lhr-solar/BPS/Docs/source/Hardware/battery-compartment.rst

Battery compartment
===================

There are 31 modules connected in series, with eight modules a row for three rows and seven modules in the fourth row.

.. note::
    Battery modules are removed if judges determine that the compartment is heavier than regulations allow.
