lhr-solar/BPS/Docs/source/index.rst

.. BPS documentation master file, created by
   sphinx-quickstart on Sat Aug 29 16:24:06 2020.
   You can adapt this file completely to your liking, but it should at least
   contain the root `toctree` directive.

****************************************
Welcome to the BeVolt BPS documentation!
****************************************

.. include:: introduction.rst

.. toctree::
   :hidden:
   :maxdepth: 2
   :caption: Overview

   Overview/useful-software
   Overview/design-requirements
   Overview/design-overview
   Overview/software-overview

.. toctree::
   :hidden:
   :maxdepth: 2
   :caption: Software

   Software/BSP
   Software/Drivers
   Software/RTOS
   Software/Apps
   Software/Tasks

.. toctree::
   :hidden:
   :maxdepth: 2
   :caption: Hardware

   Hardware/Boards
   Hardware/Components
   Hardware/battery-compartment.rst

.. toctree::
   :hidden:
   :maxdepth: 2
   :caption: Simulator

   Simulator/Overview.rst

.. toctree::
   :hidden:
   :maxdepth: 2
   :caption: How To

   How_To/Onboarding
   How_To/coding-style.rst

.. toctree::
   :hidden:
   :maxdepth: 1
   :caption: Terms and Definitions
   
   glossary
   abbreviations
