lhr-solar/BPS/Docs/source/_static/battery-box-xsection.png

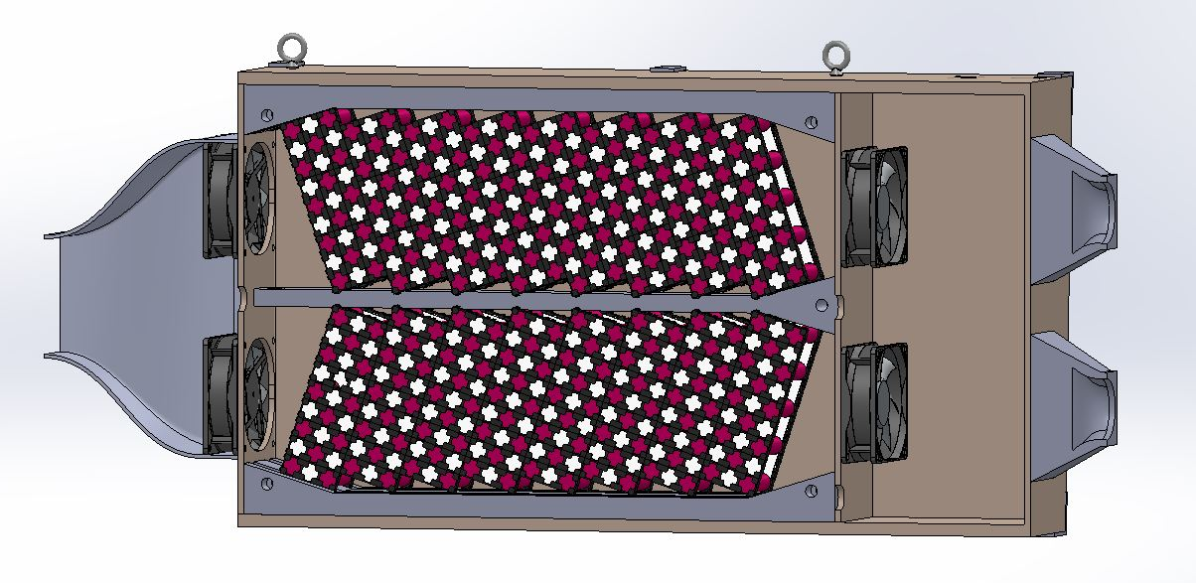
Docs/source/_static/battery-box-xsection.png
