lhr-solar/BPS/(threads)

Thread 47 (2020-05-01):

# ADC

JimothyGreene, 2020-05-01:
Create ADC data that will be read by the BPS to calculate the Current provided by the battery.

Closed 2020-05-01.

Thread 55 (2020-05-01):

SPI Simulation

JimothyGreene, 2020-05-01:
Simulate SPI communication to provide Voltage and Temperature readings that would be provided by the LTC6811s

Closed 2020-07-01.

Thread 57 (2020-05-01):

WDTimer Simulation

JimothyGreene, 2020-05-01:
Simulate the Watchdog Timer that ensures the BPS is running properly without getting stuck

Closed 2020-06-30.

Thread 74 (2020-06-05):

Voltage_GetModulesInDanger not specific in why they're in danger

SijWoo, 2020-06-05:
<del>The Voltage_GetModulesInDanger function only checks for modules whose voltages are either too high or low. There is a possibility where the voltages could be nominal but an open wire on one of the module nodes could have made the BPS trip and if we rely on this function to find the reason why the BPS tripped, then we may not be able to find it easily.

<del>TODO: Make the function check if the reason for the module in danger is an open wire.</del>

**IGNORE THIS!! DID NOT SEE OPEN WIRE CHECK!!**

SijWoo, 2020-06-05:
Also instead of returning the pointer to an array that only holds either SAFE or DANGER as the values, have it so the array holds more specific values. Specifically, if a module is in danger because of an OVERVOLTAGE, then make the index hold OVERVOLTAGE instead of just DANGER. Same goes for any UNDERVOLTAGE or OPENWIRE

Closed 2020-07-02.

Thread 75 (2020-06-05):

Voltage_UpdateMeasurements should copy voltage values instead of referencing c_codes in cell_asic struct

SijWoo, 2020-06-05:
With the way the LTC6811 handles openwire checks, the cells.c_codes[ ] array in the cell_asic will get overwritten and will hold voltage data that are not actually correct. So if we do
```
Voltage_UpdateMeasurements()
if(Voltage_OpenWire()) {
}
if(Voltage_CheckStatus()) {
}
```
The OpenWire function will have overwritten what the Voltage_UpdateMeasurements function has received from the LTC6811. The Voltage_UpdateMeasurements function stores all the voltage data into the minions[ ].cells.c_codes[ ] array. The Voltage_CheckStatus function uses the values in that array whenever checking for anything dangerous. The Voltage_OpenWire function stores Pull-Up and Pull-Down voltage values into minions[ ].cells.c_codes[ ] which may or may not be the actual voltage values of the battery module (Look in ADOW section of LTC6811 datasheet for more info). This could be a problem whenever the BPS trips and we check the voltage values.

**TODO:** In Voltage_UpdateMeasurements, copy the voltage values in a private array in Voltage.c after new values are received and have Voltage_CheckStatus and Voltage_GetModuleMilliVoltage use that private array instead of cells.c_codes[ ]

Closed 2020-07-04.

Thread 76 (2020-06-05):

Voltage OpenWire functions should reference system_open_wire field in cell_asic struct

SijWoo, 2020-06-05:
The Voltage functions that handles checking open wires are using the return value of the LTC6811_run_openwire_multi function. The return value is not scalable and could overflow thus missing certain open wired pins. There are problems when having multiple minion boards daisy chained as using the LTC6811_run_openwire_multi function. Errors arise in Voltage_GetModulesInDanger because of that ltc function. There is a system_open_wire field which uses a bitmap where each index corresponds to a pin and a 1 in that index will indicate that there is an open wire. The OpenWire functions should be modified to use the system_open_wire field in the cell_asic minions struct instead of the return value of the LTC6811 function.

**TODO:** Make the Voltage OpenWire functions reference system_open_wire field when checking for open wires.
_Note:_ Use the Voltage test if you are testing it.

SijWoo, 2020-06-09:
Start on this after simulator_spi_bsp has been merged

ClarkPoon, 2020-07-09:
@SijWoo was this fixed by the **Voltage Library cell_asic fix** pull request?

SijWoo, 2020-07-11:
This has not been fixed yet. The **Voltage Library cell_asic fix** branch was fixed a different issue.

Closed 2020-10-17.

Thread 78 (2020-06-06):

Change SoC.c/h (State of Charge) to Charge.c/h to prevent confusion.

SijWoo, 2020-06-06:
SoC has another meaning which is System on Chip which is a more common term. Changing the src file names and function names to Charge will make this less confusing.

**TODO:** Change names from SoC to Charge

chaseblock, 2020-06-09:
Thanks for making the issue. This has been bugging me for a while.

Closed 2020-07-26.

Thread 79 (2020-06-06):

Fans Simulation

ClarkPoon, 2020-06-06:
Simulate the drivers for the fans that cool the battery. Would be nice (reach goal) if this affects temperature readings as well.

Closed 2020-09-19.

Thread 83 (2020-06-09):

Simulator: Locking files during read and writes

SijWoo, 2020-06-09:
The BSP src code and the simulator python modules need to lock the file that they are accessing or else errors will occur. Make sure to add the following in your codes:

Python File Accesses:
```python
import fcntl
import os
```

```python
os.makedirs(os.path.dirname(file), exist_ok=True)
    with open(file, 'r') as csvfile:
        fcntl.flock(csvfile.fileno(), fcntl.LOCK_EX)    # Lock file before writing
        # Do stuff
        fcntl.flock(csvfile.fileno(), fcntl.LOCK_UN)    # Unlock file after writing
```

BSP C File Accesses:
```C
#include <sys/file.h>
```

```C
// Open File and get file descriptor
FILE* fp = fopen(file, "r");
if(!fp) {
    // Exit, error!
    perror("SPI.csv");
    exit(EXIT_FAILURE);
}

// Lock the file so simulator.py/SPI.py can not write it during a read op
// This is a blocking statement
int fno = fileno(fp);
flock(fno, LOCK_EX);

// File reading stuff

// Unlock the lock so the simulator can write to SPI.csv again
flock(fno, LOCK_UN);

// Close file.
fclose(fp);
```

**TODO:** Make sure all file accesses have locks

SijWoo, 2020-06-09:
BSP_ADC ne

chaseblock, 2020-06-27:
What needs to be done in order to close this issue?

SijWoo, 2020-06-27:
All python scripts and C src files that are currently finished in the simulator branch should have locks. The ADC related src files need to have locks and a couple other. Let’s close this issue whenever every BSP src files and python scripts that are currently in the simulator branch have locks then make sure every future pull request have locks.

Closed 2020-07-04.

Thread 84 (2020-06-09):

BSP_ADC GetMilliVoltage functions should exit if fopen error occurs

SijWoo, 2020-06-09:
In BSP_ADC_High_GetMilliVoltage and BSP_ADC_Low_GetMilliVoltage, the fopen function is called and the fp variable is checked to see if it is not NULL. If the fp variable is NULL, then there is a printf statement followed by a return statement. Instead of doing this, the conditional statement should exit the program with a failure status like the following:
```C
    // Open File and get file descriptor
    FILE* fp = fopen(file, "r");
    if(!fp) {
        // Exit, error!
        perror("ADC.csv");
        exit(EXIT_FAILURE);
    }
```

**TODO:** Fix the two GetMilliVoltage functions to exit whenever there is an error

Closed 2022-04-17.

Thread 106 (2020-07-03):

Stop WDTimer.csv from crashing the simulator when the WDTimer is not being used

ClarkPoon, 2020-07-03:
If the Watchdog timer .csv file does not exist (BSP_WDTimer_Init() has not been called), then the watchdog functions crash the simulator because WDTimer.csv cannot be found by the WDTimer Python scripts.

Closed 2020-07-04.

Thread 110 (2020-07-04):

CAN Messages will be dropped if not handled quickly.

chaseblock, 2020-07-04:
As it stands right now, I believe that if CAN messages are not handled promptly (meaning that the main program loop handles asks the BSP for the message), the BSP will simply drop the messages, as it only stores the most recent message at any point.

The relevant code from BSP:
```c
uint8_t BSP_CAN_Read(uint32_t *id, uint8_t *data) {
    if(RxFlag){
		for(int i = 0; i < 8; i++){
			data[i] = RxMessage.Data[i];
		}
        *id = RxMessage.StdId;
		RxFlag = false;
		return 1;
	}
    return 0;
}

void CAN1_RX0_IRQHandler(void)
{
    CAN_Receive(CAN1, CAN_FIFO0, &RxMessage);

    if ((RxMessage.StdId == 0x001)&&(RxMessage.IDE == CAN_ID_STD) && (RxMessage.DLC == 1)){
        // TODO: do stuff
        RxFlag = true;
    }
}
```

As you can see, when the mesage arrives, it is put into the `RxMessage` variable, which is only acessed when `BSP_CAN_Read` is called. This means that if multiple message arrive between calls to `BSP_CAN_Read`, the older one will be dropped, without the application knowing anything about it.

Although the BPS does not currently listen to the CAN bus for any messages, this is an issue that could affect potential future additions and/or forks of this code that are used in other code bases that the team may maintain (like Controls, Telemetry, CAN Sniffer, etc.).

chaseblock, 2020-07-04:
From the datasheet for our mcu:

> Two receive FIFOs are used by hardware to store the incoming messages. Three complete
messages can be stored in each FIFO. The FIFOs are managed completely by hardware.

If we feel certain that we can handle the incoming CAN messages before three stack up, then the interrupt here is unnecessary. Otherwise, I think that all that needs to be done is to create a software FIFO (with more capacity than the HW FIFO) and use the ISR to move the messages to that FIFO when they come in.

Closed 2020-12-12.

Thread 113 (2020-07-18):

STM32F413: Update BSP_LED GPIO pins for new leader board vX.Y

SijWoo, 2020-07-18:
To make the board look cleaner, I moved around some GPIO pins that controls the LED. (In case anyone is wondering, the low speed communication lines such as UART, I2C, SPI have not been changed). The updated pin mapping of the leader board is in the [google sheet](https://docs.google.com/spreadsheets/d/1CHXOJur96z3ZEMzSynHYqkd0Sx3a4DRUVOYeTzj7Trg/edit?usp=sharing).

The new LED pin assignments are as followed:
PC0 : Other
PC1 : CANError
PC2 : WDError
PC3 : (Open) Wire
PC4 : RUN

PA4 : OCurr
PA5 : OTemp
PA6 : OVolt
PA7 : UVolt

Do not branch off the simulator branch for this. I'll create a note whenever the leader board layout is done and merged to the Electronics repo in case you need to reference it.

chaseblock, 2020-07-18:
Can we maintain this and a separate build target for a v2 board? I imagine that we will be testing code on the old master for at least a little while.

SijWoo, 2020-07-18:
Ah that would be good, so have separate folders like BSP/STM32f413v2 and BSP/STM32F413v3 or with some type of version number naming scheme?

chaseblock, 2020-07-18:
Nah that sounds pretty ugly. I was thinking just a file that has variables/definitions that are guarded by preprocessor #ifs.

Something like:
```c
// Some .h file somewhere
#ifdef BPS_V2
// etc.
#define CANError_LED_PIN ...
#define WDError_LED_PIN ...
// etc.
#else
// etc.
#define CANError_LED_PIN PC1
#define WDError_LED_PIN PC2
// etc.
#endif
```

Then just select the build target in the Makefile by passing in `-DBPS_V2` or `-DBPS_V3` to gcc when compiling.

I'm not sure what sort of variables would need to be switched, so the feasibility of this may vary, but it sounds more maintainable than separate BSP folders (since the BSPs are likely going to be similar to each other).

SijWoo, 2020-07-18:
Okay yea that sounds better. I can edit the Makefile to have a version parameter. I'll open a separate issue ticket for the Makefile.

SijWoo, 2020-08-01:
Will put this on hold for now. Look at issue [#114](https://github.com/lhr-solar/BPS/issues/114) for more information

Closed 2020-12-12.

Thread 114 (2020-07-18):

Update Makefile to have version parameter

SijWoo, 2020-07-18:
There are multiple versions of the BPS boards with different pin connections. The Makefile needs to be updated to accept a version parameter so src files for different board versions can be compiled.

The Makefile will accept a version number as a parameter, a variable will be defined for GCC to select the preprocessor definitions for the certain board, then the code will be compiled.

Src code example:
```c
// Some .h file somewhere
#ifdef BPS_V2
// etc.
#define CANError_LED_PIN ...
#define WDError_LED_PIN ...
// etc.
#else
// etc.
#define CANError_LED_PIN PC1
#define WDError_LED_PIN PC2
// etc.
#endif
```

SijWoo, 2020-07-30:
I just realized since we're using a different current board with different I/O interfaces, how should we change the Current (Amperes) library to support different versions (ADC and AS8510)? The new current sensing board is using the AS8510 which requires the SPI protocol so the Current library will be using the AS8510 driver whenever it gets created. Should we have the current library have a bunch of #if statements to support the previous and newest leader board versions or should we just have the code updated to only support the new version and just deprecate the previous versions?

I think having a bunch of #if statements in the Current library will create clutter quickly and we need to change the Current library function definitions completely when we update the code to use the AS8510. I think we should deprecate the previous version of the bps but have it available **ONLY** for testing certain modules that remains unchanged (e.g. Voltage, Temperature, Contactor, CAN, USB, EEPROM). LEDs and Strobe Light are the only pins that have been changed on the new board. We'll have at least two boards (before making multiple copies) to test the critical functionalities.

To save the BPS code that uses the hall effects sensors + ADC, we can create a tag called v2.0 like what we did for v1.0.

Any thoughts are welcome :)
@ClarkPoon @chaseblock @sugamarora99 @manthanand @alekxoo @AleNeff @etblum12

SijWoo, 2020-08-01:
After discussing with BPS team, we decided to add the makefile version parameter after adding the AS8510 driver and editing the amperes library. The main concern that I had with the makefile version paremeter was that the amperes library will be different between the new and previous leader boards. As long as we don't test code that is meant on the new leader board i.e. the fan, amperes board, bluetooth on the previous version, then we'll be fine for now.

ClarkPoon, 2021-02-10:
To my knowledge, we no longer have any functional copies of old versions of the BPS leader board (@chaseblock took a DC-DC converter off of the board from Spring 2020 to use on the telemetry board), so I no longer see the point of adding support for legacy hardware.

Closed 2021-02-10.

Thread 117 (2020-07-23):

Possible issue with the SoC function

chaseblock, 2020-07-23:
The SoC_Calculate function is using an int16_t for its parameter, which is described in a comment to be in units of 0.0001 Amps (one ten-thousandth).

Quick math suggest that the maximum of this signed type is 2<sup>16 - 1</sup> * 0.0001 = 3.2768.

It seems that we are only able to account for a current of <3.27A.

chaseblock, 2020-07-23:
It also appears that the units being passed into the function from main.c (directly from the Current.c getter) is mA, not 0.1 mA like this SoC file suggests.

I assume mA is the intended unit here, but could I get some confirmation?

Closed 2020-07-26.

Thread 121 (2020-07-27):

Control-C not working properly on simulator

ClarkPoon, 2020-07-27:
When I run the simulator on my machine and press Control-C, then type quit, the simulator freezes instead of quitting. When Alejandro runs the simulator on his machine and he presses Control-C, the simulator immediately quits (without opening the quit menu). I was unable to replicate Alejandro's issue. Not sure if these issues are related, but they were both first noticed today after the pull requests for changing SoC to Charge and for Contactor Simulation were merged into the simulator branch.

ClarkPoon, 2020-07-27:
After looking into this further, it appears that Alejandro is no longer having this issue on his machine. The issue on my machine appears to be caused by the Timer thread not ending when the "quit" option is selected if the C code is not using the timers

chaseblock, 2020-07-27:
On my machine (Pop!_OS 20.04), I seem to get the expected results (no issue with quitting).

ClarkPoon, 2020-07-27:
> On my machine (Pop!_OS 20.04), I seem to get the expected results (no issue with quitting).

Can you try running after building with
```
make simulator TEST=BSP_I2C
```
I am not encountering this issue when I build with
```
make simulator
```

chaseblock, 2020-07-27:
Yes that seems to do it. I can confirm that issue.

Closed 2020-07-28.

Thread 122 (2020-07-27):

Simulator gives different Control-C menus, depending on "if BeVolt is not None"

ClarkPoon, 2020-07-27:
When you launch the simulator and type "start", a battery object called BeVolt is created (not set to None). If you type something else, BeVolt is set to None, and you are asked "Would you like to simulate 'charging' or 'discharging'?" and "Would you like to simulate 'low', 'normal', or 'high' values?". When you press Control-C to open the Keyboard Interrupt menu, you are given different options, depending on "if BeVolt is not None" as shown below.

```
except KeyboardInterrupt:
            curses.endwin()
            if BeVolt is not None:
                print("\n\rWould you like to change 'wires', 'quit', or 'PLL'?")
                print(">>", end="")
                choice = input()
                if choice == 'wires':
                    change_wires(BeVolt)
                    stdscr = curses.initscr()
                    curses.start_color()
                elif choice == 'quit':
                    break
                elif choice == 'PLL':
                    print("Enter the frequency you would like to change the clock to in Hz.")
                    frequency = int(input())
                    PLL.Change_Frequency(frequency)
                else:
                    print("That is not a valid option. Continuing simulation...")
                    stdscr = curses.initscr()
                    curses.start_color()
            else:
                print("\n\rWould you like to change 'config', 'quit', or send a CAN message ('CAN')?")
```

It does not make sense that having the options "'wires', 'quit', or 'PLL'" or having "'config', 'quit', or 'CAN'" depend on whether or not you are simulating using a battery object or not.

The reason that the simulator checks "if BeVolt is not None" is because the change_wires() method requires a battery object that is not none as a parameter.

```
def change_wires(battery):
    done = False
    while not done:
        print("Which module? (0 to exit)")
        print(">>", end="")
        module = int(input())
        if module:
            battery.modules[module-1].connected = not battery.modules[module-1].connected
        else:
            done = True
```

A solution to this issue will either:
* Give the user all of the options in the menu, regardless of whether or not the simulator is using a battery object or
* Give the user all of the options in the menu, except you will not have the "wires" option if you are not simulating usuing a battery object

Closed 2020-08-16.

Thread 128 (2020-07-30):

Current library to Amperes library?

SijWoo, 2020-07-30:
Even though this has been what we've been using for the past couple years, every time I say current board/library with other members I feel compelled to specify Current means amperes and not time. Current members know current means amps and not time in the context of the BPS but for future members, it may be good to change the library name to prevent any confusion.

**Proposal:** Change Current library and Current board names to Amperes library and Amperes board

SijWoo, 2020-07-30:
Any thoughts are welcome :)
@ClarkPoon @chaseblock @sugamarora99 @manthanand @alekxoo @AleNeff @etblum12

ClarkPoon, 2020-07-30:
I think this is a good idea

chaseblock, 2020-08-02:
I'm not too much of a fan of this move, but I understand the difficulty with the current "current" term, and as long as this improves clarity, I don't mind.

Closed 2020-12-14.

Thread 129 (2020-07-30):

Strobe Light Drivers

ClarkPoon, 2020-07-30:
There are currently no drivers to control the strobe light on the real board.

ClarkPoon, 2020-08-16:
The strobe light control is on the same pin as the fault light control, so the strobe light can be controlled by the lights drivers.

Closed 2020-08-16.

Thread 138 (2020-08-26):

Document Error Lights/Strobe Lights Indicator

ClarkPoon, 2020-08-26:
This section (2.2) of the BPS documentation is currently blank

Closed 2021-01-24.

Thread 141 (2020-08-26):

Create list of good manufacturers to order boards from (2.7)

ClarkPoon, 2020-08-26:

ClarkPoon, 2021-05-29:
I am closing this issue because I think this is beyond the scope of the BPS docs, since the BPS team has not been involved in ordering boards since 2019

Closed 2021-05-29.

Thread 167 (2020-08-26):

Update Amperes Library to use SPI

ClarkPoon, 2020-08-26:
The new version of the amperes board uses SPI to send information to the leader board (instead of an analog voltage)

Closed 2020-12-14.

Thread 168 (2020-08-29):

Updating standard peripheral library to low-layer API

SijWoo, 2020-08-29:
STM released a library called Low-Layer(LL) API after the standard peripheral library(SPL). They're both similar in syntax, but STM has been supporting LL and deprecated the SPL. **Would this be something that you all would want to do?** I don't know if you all can allocate more members to this or not but wanted to let you all know! If you do want to do this, I can send the library src folder to you.

Just as a note, LL is different from STM's High Abstraction Layer(HAL) library which has some overhead. There may not be a lot overhead in HAL, but there are some register level stuff we need that HAL can't provide easily.

chaseblock, 2020-08-29:
There's an overview of HAL and LL here: https://www.st.com/content/ccc/resource/technical/document/user_manual/2f/77/25/0f/5c/38/48/80/DM00122015.pdf/files/DM00122015.pdf/jcr:content/translations/en.DM0012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

From what I can tell, LL does not provide a CAN API. Since this is somewhat critical to our operation, I could see this being an issue. We could write our own drivers at the register level instead, but that seems like a non-trivial project.

SijWoo, 2020-08-29:
Yea that would be an issue. I did not see that, thanks for catching that Chase. We're able to have a hybrid of HAL's CAN API and LL on a project with no conflicts. The UART and SPI peripherals are the ones where we need to be close to the registers level (for the BPS with RTOS at least). What do you all think about this option?

JimothyGreene, 2020-08-29:
Why exactly do we need to be close to register level with those peripherals? Not sure I fully understand this. Haven't been dealing this low level recently.

SijWoo, 2020-08-29:
We need those peripherals on interrupts for the RTOS to block/unblock tasks. Peripheral data transfers are blocking functions, so the OS can schedule a different task to run if the original task is waiting on a peripheral transfer to be completed. In order to unblock a task though, we need an indicator for when a transfer is complete. The interrupt handler can be triggered whenever a transfer is complete and inside the handler we can call a semaphore to unblock the task.
E.g. for the BPS, we have one task for voltage/temperature monitoring and the other task is for amperes monitoring (volt/temp task priority higher than amperes task priority). While the LTC driver is doing an SPI data transfer in the volt/temp task, the amperes monitoring task can running. Whenever the SPI transfer is complete, the SPI interrupt handler will unblock the volt/temp task. The OS will then schedule the volt/temp task to run now.

```
OS_SEM SPI_Sem4;

void VoltTempTask(void) {
    while(1) {
        Voltage_UpdateMeasurements();   // Blocking statement because LTC driver calls SPI1_Transfer
        // Do stuff

        Temperature_UpdateMeasurements();   // Blocking statement because LTC driver calls SPI1_Transfer
        // Do more stuff
    }
}

void AmperesTask(void) {
    while(1) {
        Amperes_UpdateMeasurements();
        // Do stuff
    }
}

void SPI1_Transfer(uint8_t data[], uint32_t len) {
    for(int32_t i = 0; i < len; i++) {
        OSSemWait(&SPI_Sem4);
        SPI1_DATA_R = data[i];
    }
}

void SPI1_IRQHandler(void) {
    // Ack tx complete
    OSSemPend(&SPI_Sem4);
}
```

SijWoo, 2020-08-29:
Just to note, that code is an example and not actually in the BPS XD

JimothyGreene, 2020-08-29:
I think using the mixed HAL and LL option would be good.

ClarkPoon, 2021-02-10:
I think this would be a lot of work, and not worth the effort, since our BSP already works (for the most part)

Closed 2021-02-10.

Thread 188 (2020-08-31):

[RTOS] Add SPI Mutex to prevent any tasks from accessing the periperal at the same time

SijWoo, 2020-08-31:
Please go to google drive in BPS>Documentation/Reports>BPS RTOS for more information and pseudo code.

ClarkPoon, 2020-11-12:
@SijWoo do we need this mutex? Shouldn't SPI1 only be accessed by whoever has the LTC6811 mutex, and SPI3 should only be accessed by the amperes task?

Closed 2020-11-14.

Thread 192 (2020-08-31):

[RTOS] General: Make sure all functions are thread-safe

SijWoo, 2020-08-31:
More specific issue tickets should/will be created but as a note, we need to make sure all the functions are thread safe (at least the ones that are shared among multiple tasks).

chaseblock, 2021-03-20:
This issue has been standing for a long time, and I'm of the opinion that it needs some modification due to decisions made over the past few months. Not every function needs to be 'thread-safe'. Instead, perhaps we should take the stance that only certain functions need to be thread safe, and that each function should be marked as either `[reentrant](https://en.wikipedia.org/wiki/Reentrancy_(computing))`, `[thread-safe](https://en.wikipedia.org/wiki/Thread-safety)`, or `unsafe`. This could be specified plainly in the documenting comment for the function.

For quick description:
- A thread-safe function is something that can be called from multiple threads at the same time, and can be called at the same time as other thread-safe functions in the same module.
- A reentrant function is one that (for our purposes) would be safe to call from multiple threads, as well as from interrupts.
- An unsafe function (again, for our purposes) is neither of the above.

The hope is that going through all of the functions and labeling them as one of these categories would make it clear whether we have race-conditions, potential deadlocks, etc. We would need to go through and ensure all of our driver and BSP functions are categorized appropriately.

Looking for criticism here. Let me know what y'all think.

@ClarkPoon @JimothyGreene

ClarkPoon, 2021-03-20:
> This issue has been standing for a long time, and I'm of the opinion that it needs some modification due to decisions made over the past few months. Not every function needs to be 'thread-safe'. Instead, perhaps we should take the stance that only certain functions need to be thread safe, and that each function should be marked as either [reentrant](https://en.wikipedia.org/wiki/Reentrancy_(computing)), [thread-safe](https://en.wikipedia.org/wiki/Thread-safety), or `unsafe`. This could be specified plainly in the documenting comment for the function.

I think it makes sense that only some functions need to be reentrant or thread-safe, and I have not enforced a requirement for thread-safety if a function is only used by a single thread. I also agree that it would be a good idea to document which functions are thread-safe or reentrant, so we don't forget and accidentally call unsafe functions from different threads concurrently, etc.

> The hope is that going through all of the functions and labeling them as one of these categories would make it clear whether we have race-conditions, potential deadlocks, etc. We would need to go through and ensure all of our driver and BSP functions are categorized appropriately.

If we are using this to look through the code for race-conditions and deadlocks, do you think it would be helpful if we modified the function names to make it obvious if they are reentrant/thread-safe? Maybe add an `_r` to the end for reentrant like in `strtok_r()`?

chaseblock, 2021-03-20:
Maybe. It certainly would make it easier to determine whether a function being called be an ISR is acceptable. On the other hand, we still may want to document thread-safety aside from reentrancy, which would either require another (non-standard) suffix, or a comment anyways.

Thread 198 (2020-09-12):

[RTOS] Design startup sequence for admin/normal operation

SijWoo, 2020-09-12:
After the BPS faults due to low voltage, the next boot will automatically trip the system (opening the contactor). If we have a computer plugged in, during startup we should forcefully close the contactor so we can charge the battery to a point where it won't trip.

In the original loop during before anything is checked, there is a start up period that waits for an input from the keyboard to place the system in admin level to forcefully turn on the contactor. In this new rtos implementation, we have the ability to spawn and kill threads as we like. In the main loop instead of spawning all the necessary tasks, we should implement a state machine that spawns all threads for normal operation and spawn certain/different threads for admin operation.

ClarkPoon, 2020-09-19:
@SijWoo @alekxoo I think it would make sense to do this as part of the initialization task because that is where we do this in the non-RTOS version of the BPS. What do you think?

SijWoo, 2020-09-19:
That makes sense to me! Also I don't think I included this anywhere but we need to also check if the watchdog timer triggered previosuly

ClarkPoon, 2020-11-12:
After looking at this some more, I think it might make more sense to put this in the critical state thread than in the initialization thread because the critical state thread is what decides to turn on the contactor. I think it makes more sense for the initialization thread to only initialize the fault state sem4, critical state sem4, all of the other threads, and nothing else. What do you think @SijWoo

Closed 2020-12-19.

Thread 206 (2020-09-25):

Add Separate Voltage Cutoffs for Charging and Discharging

ClarkPoon, 2020-09-25:
Right now, we only check for undervoltage in discharging mode. I think it would be safer if we also checked for undervoltage in charging mode, but use a lower threshold (that is still above the minimum volatge specified by the manufacturer). This way, we do not end up recharging batteries that have internal copper deposits/shorts.

Closed 2020-11-16.

Thread 207 (2020-09-26):

Look into recharging rates

chaseblock, 2020-09-26:
Potentially more related to MPPT, so tagging @dimembermatt on this. I think it is certainly reliant on BPS complicity though.

As a part of our recent discussions about proper management of the battery pack, it has come up that there exists proper charging procedure for these batteries, or at least there would exist a proper charging procedure if we had a dedicated, stable charger. Since we instead have an array, it may still be beneficial to look into how we should manage the charging of the batteries based on their existing voltage, charge, temperature, etc.

This is a part of the BMS functionality, and probably doesn't need to be addressed until after basic balancing (and related functionality) has been implemented and tested.

dimembermatt, 2020-09-26:
Updates on what the requirements should be?
I see potential to add functionality to the DC-DC converter algorithm to limit output based on battery voltage to prevent overcharging. Do I also get permission to read BPS CAN messages (I assume there are) for temperature probe data on the batteries? Or do I get a separate message to tell me to throttle charging output to X value and the BPS calculates how far I need to throttle to lower the temperature?

dimembermatt, 2020-09-27:
As a placeholder, I've implemented the following interface for the MPPT to regulate input power to the battery. Let me know if this changes. Closing [#19](https://github.com/lhr-solar/MPPT/issues/19).

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

Rationale for the implementation details is presented from the excerpt from the MPPT design document:
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

I'll check with Prof hallock to see if the physics for this checks out.

dimembermatt, 2020-10-21:
bump.

ClarkPoon, 2020-11-18:
I think we discussed this in a meeting over Zoom or Discord, but I am commenting here, so we have a record.

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

My understanding is that the MPPTs know the total voltage of the battery pack, so the MPPTs should be able to handle the charge protocol without needing to receive any messages from the BPS, since the BPS will be balancing the module voltages. I think the purpose of the charging protocol is only to increase battery cycle life, so I am not sure if we would want to sacrifice power for this during the race. We might want to look into it for when we are charging before the race, but again, I don't think we care a lot about cycle life, since we are only planning on using this battery pack in one race.

> Updates on what the requirements should be?
> I see potential to add functionality to the DC-DC converter algorithm to limit output based on battery voltage to prevent overcharging. Do I also get permission to read BPS CAN messages (I assume there are) for temperature probe data on the batteries? Or do I get a separate message to tell me to throttle charging output to X value and the BPS calculates how far I need to throttle to lower the temperature?

I am guessing Array will need to know the BPS's shutoff voltage limits, current limits, and (optionally) the ideal charging protocol for the battery. I am not sure yet if you will need to know the BPS's temperature readings or temperature shutoff. I am hoping that the battery box will be designed in such a way that the BPS can keep the batteries cool enough, even when we are receiving maximum power from the array.

Right now, the relevant BPS shutoff limits are:
Total pack Voltage (charging): 83.7 V to 124 V *
Total pack Voltage (discharging): 89.8 V to 124 V *
Max charging current: 20 Amps
Max discharging current: 100 Amps
Max temperature (charging): 40 C **
Max temperature (discharging): 55 C **
* Since we are monitoring Voltage on the module level, in practice, we may shutoff up to 1.5 V before we reach these limits.
** These temperature values will almost certainly be increased

@dimembermatt @chaseblock What are your thoughts on this?

dimembermatt, 2020-11-28:
I can probably work with just the voltage and current charge/discharge limits for now:

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

I'll have to read up on charging algorithms and/or protocols, otherwise it'll be a pretty primitive "I try to pump as much power given my constraints as possible all the time' for now in the DC-DC converter firmware.

Closed 2022-04-26.

Thread 211 (2020-09-26):

Voltage library cell_asic address change in call stack

SijWoo, 2020-09-26:
Release main.c simulator has very strange and incorrect behavior but Test_Voltage.c is able to run perfectly fine. The address of the cell_asic struct changes through the function call stack when main.c runs but stays constant when Test_Voltage.c runs. The BSP_SPI and python scripts run fine.

If you add print statements starting in Voltage_UpdateMeasurements down to the parse_cells function in LTC681x.c and print out the address of the c_codes input parameter, they should all stay constant. Look at this commit id for what was printed in Voltage.c, LTC6811.c, LTC681x.c: 82613e0a2cbb3ef06c6a6a8c212749c100529387

The correct behavior is for all the address printed should be the same. main.c does not have this behavior.

Closed 2020-11-07.

Thread 213 (2020-09-26):

RTOS stack above BSP

SijWoo, 2020-09-26:
To make the Board Support Package support both bare metal and a RTOS, the team decided to make the BSP code RTOS independent. Each BSP src file that requires an OS shall take a `bsp_os_t` type input parameter in the Init function. This struct contains function pointers that are defined at an upper layer. If there is no OS, then the struct should be filled with dummy empty functions that does nothing.

Here is an example of the SPI peripheral using OS functions:
```
// BSP_OS.h
typedef struct {
    void (*pend)(void);
    void (*post)(void);
} bsp_os_t;
```

```
// LTC6811.c
bsp_os_t spi_os;
OS_SEM MinionsIO_Sem4;
void LTC6811_Pend(void) {
    CPU_TS ts;
    OS_ERR err;
    OSSemPend(&MinionsIO_Sem4,
                        0,
                        OS_OPT_PEND_BLOCKING,
                        &ts,
                        &err);
}

void LTC6811_Post(void) {
    OS_ERR err;
    OSSemPost(&MinionsIO_Sem4,
                        OS_OPT_POST_1,
                        &err);
}

void LTC6811_Init(void) {
    spi_os.pend = LTC6811_Pend;
    spi_os.post = LTC6811_Post;
    BSP_SPI_Init(&spi_os);
}
```

```
// BSP_SPI.c
static bsp_os_t *os;
void BSP_SPI_Init(bsp_os_t *spi_os) {
    os = spi_os;
}

void BSP_SPI_Write(uint8_t txBuf, uint32_t txLen) {
    for(int32_t i = 0; i < txLen; i++) {
        SPI1->DR = txBuf[i];
        os->pend();
    }
}

void SPI3_IRQHandler(void) {
    // Acknowledge transfer complete
    os->post();
}
```

SijWoo, 2020-09-26:
@JimothyGreene may be useful(?)

Closed 2021-02-10.

Thread 248 (2020-11-18):

Make sure Bluetooth meets regulations

ClarkPoon, 2020-11-18:
The regulations require that we seal the battery box during the race. This also includes a requirement that we cannot alter firmware or settings once the battery box has been sealed. However, the current BPS design plans to make the CLI accessible over Bluetooth. We need to either:
- Verify that we cannot use the CLI to modify any firmware or settings
- Limit the user interface we expose over Bluetooth, so it cannot be used to alter firmware or settings

ClarkPoon, 2020-12-19:
Per Steve's email, sealing the battery box is to prevent changing out cells during the race. Communication is fine as long as it does not affect firmware or settings

Closed 2020-12-19.

Thread 259 (2020-11-23):

Create function to call if the RTOS fails

ClarkPoon, 2020-11-23:
Right now, if an os function returns an error, we are posting the fault state semaphore to go into a fault condition. This could be an issue if whatever causes the os function to fail causes the scheduler to not properly schedule the fault state task to run. One way to fix this would be to write a fault function that does the entire shutdown sequence and call it from the `assertOSError()` function. We can also call this function whenever we enter a fault state through the fault state thread, or if we reach the hard fault handler.

Closed 2021-01-03.

Thread 264 (2020-12-12):

Sort out interrupt priorities

ClarkPoon, 2020-12-12:
Right now UART3 has the highest priority, which is not what we want. Also, some of our interrupts have not yet been assigned priorities (NVIC is not initialized for SPI or I2C)

Closed 2021-02-27.

Thread 267 (2020-12-13):

Add calls to Charge functions to the Amperes task

ClarkPoon, 2020-12-13:
The BPS is responsible for keeping track of the state of charge of the battery, so we need to add calls to the functions that do this to the code. I think the amperes task is the best place to do this because it is where we are measuring the current, which we use to keep track of the state of charge

Closed 2021-02-13.

Thread 268 (2020-12-14):

BPS in unknown state after programming

chaseblock, 2020-12-14:
After programming the BPS leader board, the peripherals on the STM32F413 are not reset upon the software reset. This means, for instance, that if the BPS had the contactor enabled and is then flashed with a program that does not interface with the contactor (a test program perhaps), then the contactor will remain enabled. This also has potential effects for when the WDOG timer resets the chip (although this has not been tested yet).

The question is this: Is there a way to guarantee that after flashing or soft-resetting the board, all the peripherals are set to known and safe states?

chaseblock, 2020-12-14:
I should note that pressing the reset button on the board completely resets all peripherals.

ClarkPoon, 2020-12-16:
Can't we just solve this by:
1. On startup, (in fault state or critical state threads) call `BSP_Contactor_Off()`
2. In our standard operating procedures, require that the BPS is always reset after flashing new code

Closed 2022-04-17.

Thread 281 (2021-01-16):

Determine Timing Requirements for Battery Balancing

sugamarora99, 2021-01-16:
We need to figure out how often we will be battery balancing the battery pack.

ClarkPoon, 2021-01-30:
We need to figure out an optimal balancing strategy and how often we should update our strategy @javierpadila2001

Some information about battery balancing:
https://www.americansolarchallenge.org/regulations/solar-car-design-reference-material/

Closed 2021-03-06.

Thread 306 (2021-01-24):

Send charging suggestion over CAN

ClarkPoon, 2021-01-24:
Whenever the highest temperature in the battery pack is between 45 Celsius and 60 Celsius, it is safe to discharge the battery but not to charge the battery. Whenever the highest temperature measured in the battery pack gets close to this range, the BPS should send a CAN message to suggest to the other systems that they should not charge the battery, or the BPS may shut down the car.

Closed 2021-02-10.

Thread 309 (2021-01-30):

Remove ADC functions

manthanand, 2021-01-30:
We do not want to remove the BSP_ADC header file since we might need that functionality later on in the BPS. However, we do not need those functions now since we are not using our old hall-effect current sensors. They should be removed anywhere they are being used.

ClarkPoon, 2021-02-13:
We are not using these anywhere on the rtos branch

Closed 2021-02-13.

Thread 312 (2021-01-30):

Check if watchdog timer was tripped on startup

ClarkPoon, 2021-01-30:
If the watchdog timer counts down to zero, it will reset the BPS. We need to check on startup if this has happened, and if so, we need to enter a fault state.

Closed 2021-02-13.

Thread 358 (2021-06-03):

Create BPS Debugging guide

ClarkPoon, 2021-06-03:
While testing the BPS during the spring semester, @chaseblock and I decided it would be nice to have a list of common debugging issues

Thread 374 (2021-06-17):

Clean up hardware docs

ClarkPoon, 2021-06-17:
I think the hardware docs (specifically the boards section) are formatted in a way that is hard to follow. I think this is because the information for each board takes up significantly more than can fit on your screen, so I find it easy to lose track of which board I am looking at the information for. There is also a lot of repetitive information (eg. explaining why we use a chip for each board it appears on, instead of just having a single explanation for each chip). Some of the section headings also seem to be unhelpful (eg. "main"). One idea I have would be to create a separate page for each board. Another idea would be to mix the pictures and text together more (right now there are some areas where several pictures have just been pasted in consecutively with short captions, like at the end of the "layout" section of the display board). I am interested to see what other people think about the hardware docs (especially if they have to use the hardware docs for learning about the hardware), so please post replies to this issue if you have additional suggestions/feedback.

Closed 2023-03-03.

Thread 375 (2021-06-19):

Determine Proper method for converting AS8510 reading to milliamps

ClarkPoon, 2021-06-19:
Right now, the `AS8510_GetCurrent()` returns an `int16_t`, which `Amps_UpdateMeasurements()` treats as a milliamp value. This is a problem because the largest number that can be represented by an `int16_t` is 32,767, which corresponds to 32.767 amps in the existing code. However, the BPS shutoff limit is 75 amps. This means that the BPS will never shut off for an over current. I am hoping that we are treating the readings from the AS8510 improperly, and there is some additional conversion we need to do to convert the 16 bits we get from the sensor into a milliamp value.

ClarkPoon, 2021-07-31:
#384 might solve this, but I am leaving this issue open until it is validated

ClarkPoon, 2021-12-04:
We aren't using the AS8510 anymore

Closed 2021-12-04.

Thread 378 (2021-06-26):

Test CAN Task

ClarkPoon, 2021-06-26:
We need to run the test in Tests/Test_CAN_Task.c to verify that the CAN task works. Any issues that we run into when testing the CAN task should have an issue ticket opened or a response posted here

chaseblock, 2021-07-19:
When running this test, the board hardfaults at `os_core.c:422` after 6 calls to CANbus_BlockAndSend.

Stack trace from the hardfault:

```
>>> backtrace
#0  HardFault_Handler () at ../../Apps/Src/Task_FaultState.c:112
#1  <signal handler called>
#2  0x3f800000 in ?? ()
#3  0x0800493c in OSSched () at ../../RTOS/uCOS-III-STM32F4/uCOS-III/Source/os_core.c:422
#4  0x40400000 in ?? ()
```

Registers at the start of HardFault_Handler:

```
r0             0x0                 0
r1             0x10000000          268435456
r2             0x2000187c          536877180
r3             0x3                 3
r4             0x0                 0
r5             0x200065a6          536896934
r6             0x5                 5
r7             0x0                 0
r8             0x8080808           134744072
r9             0x9090909           151587081
r10            0x10101010          269488144
r11            0x11111111          286331153
r12            0x0                 0
sp             0x200011e8          0x200011e8 <OSCfg_ISRStk+396>
lr             0xfffffffd          -3
pc             0x8007430           0x8007430 <HardFault_Handler>
xPSR           0x1000003           16777219
fpscr          0x0                 0
msp            0x200011e8          0x200011e8 <OSCfg_ISRStk+396>
psp            0x20006508          0x20006508 <TaskSpam_Stk+840>
primask        0x0                 0
basepri        0x0                 0
faultmask      0x0                 0
control        0x0                 0
```

My guess is that we're corrupting a stack somewhere, or failing initialization at some step. Just a guess though.

chaseblock, 2021-07-20:
I'm going insane. Changing the line below in Test_CAN_Task.c seems to have solved the hardfault issue.

```c
-            CanData.f = (float)voltage/1000; //send data in volts
+            CanMsg.payload.data.f = voltage/1000.0; //send data in volts
```

In particular, it appears to be the change from `(float)voltage/1000` to `voltage/1000.0` that solved it (regardless of the assignment, the first faults).

I don't like unexplained faults, and the fact that this was coming from the OSSched function just makes me not like it more. The only (partial) explanation I can think of is that uC/OS is fucking with the floating point registers somehow, and that the compiler does slightly different things with this computation than the other one. Still, I don't know why this in particular was causing the issue, especially since there shouldn't be a context switch across it.

If anyone has any thoughts, I'd love to hear them.

@ClarkPoon @SijWoo @JimothyGreene

chaseblock, 2021-07-20:
This is certainly an issue with floating point and how it is interacting with uC/OS. I'll open a new issue to investigate.

Closed 2021-08-29.

Thread 380 (2021-07-03):

Test Battery Balance Task

JimothyGreene, 2021-07-03:
We need to run the test in Tests/Test_BatteryBalancing_Task.c to verify that the Battery Balancing task works. Any issues that we run into when testing the Battery Balancing task should have an issue ticket opened or a response posted here

Thread 381 (2021-07-03):

Test Voltage App

ClarkPoon, 2021-07-03:
We need to run the test in Tests/Test_Voltage.c to verify that the Voltage App works. Any issues that we run into when testing the Voltage App should have an issue ticket opened or a response posted here

Closed 2021-11-20.

Thread 387 (2021-07-20):

CAN Queue Passing Incorrect

chaseblock, 2021-07-20:
Currently, the queue passing for the CAN messages is implemented incorrectly. We are making use of uC/OS III's OS-level queues for message passing. This is fine, except all these do is store pointers (not full elements). Any changes to the stack or local variables before consumption will result in incorrect behavior.

This needs to be corrected.

chaseblock, 2021-07-20:
@ClarkPoon @JimothyGreene

ClarkPoon, 2021-07-22:
Ok. I will get this fixed

Closed 2021-08-29.

Thread 388 (2021-07-20):

Floating Point Operations and uC/OS III Misbehaving

chaseblock, 2021-07-20:
Discovered while investigating #378.

Introducing floating point operations in certain places within the code seem to cause uC/OS to enter a hardfault somewhere around `OSSched()`.

For a reproduction case, see Test_Tasks.c on the RTOS branch. This executes fine. However, when Task2 is modified as below, it hardfaults as described. This behavior has also been seen in the CAN_Task test (see the linked issue). When Task1 is modified in a similar way, everything still appears to work.

The change:
```diff
diff --git a/Tests/Test_Tasks.c b/Tests/Test_Tasks.c
index 23f71b19..6864cbef 100644
--- a/Tests/Test_Tasks.c
+++ b/Tests/Test_Tasks.c
@@ -68,6 +68,10 @@ void Task2(void *p_arg) {
     OS_ERR err;

     while(1) {
+
+        volatile float f = 1.8;
+        f += 0.5;
+
         OSSemPost(&SafetyCheck_Sem4,
                     OS_OPT_POST_ALL,
                     &err);
```

For the hardfault debugging registers: see these dumps from GDB.
```gdb
>>> p/x *(uint32_t*)(0xE000ED28) # CFSR
$2 = 0x100
>>> p/x *(uint32_t*)(0xE000ED2C) # HFSR
$3 = 0x40000000
```

This puts us squarely in `IBUSERR` territory. I unfortunately haven't been able to find many reports of people experiencing these issues, and haven't been able to work around it so far.

@ClarkPoon  @JimothyGreene I'm wondering if anyone has any ideas on this. I'm going to keep experimenting.

@SijWoo have you ever seen anything like this?

chaseblock, 2021-07-20:
After consulting with some sources:

This is probably due to uC/OS not properly handling the floating point registers during a context switch, and losing track of where on the stack the PC is when it attempts to return from a context switch.

Our options as I see it are:
1. Don't use uC/OS. I think it may be a bit too late to choose this option.
2. Look into fixing up the context switch code within the RTOS to support floating point register saving. I don't know if I have the time for this right now. Maybe I'll look into it in a bit. If anyone else is willing to take a look into that though, let me know and I'll see if I can help.
3. Disable the floating point unit. I can confirm that with the floating point unit disabled, the hardfaults do not seem to be occurring. The downside to this is that we lose hardware support for floating point arithmetic, so all float math is going to be much slower (and implemented via larger amounts of library software). This is probably the easiest solution, but if we choose this, we will want to eliminate any unnecessary floating point math, probably converting most of it to fixed point (see [Q](https://en.wikipedia.org/wiki/Q_(number_format))).

@ClarkPoon @JimothyGreene I would like your opinions on these options within the next few days so that we aren't blocked by this for a long while.

@Cam0Cow @ErickCortez98 This possibly affects your system as well, although I haven't really looked yet. It might be good for y'all to take a look at any floating point math that y'all are doing and ask whether or not it needs to be floats.

ClarkPoon, 2021-07-22:
I looked through the BPS code, and it looks like we are mainly using floating point math for the following:
1. Our voltage and temperature safety thresholds are floats. I think these used to be fixed point (in millivolts/milli-Celsius), so it could be converted to fixed point.
2. Pretty much all of the measurements we are sending over CAN are floats (voltage, temperature, current). Using floats here is unavoidable unless we change our CAN requirements, which would affect array and sunlight, since they are reading these messages.
3. Converting voltages on the temperature probes to temperatures. This can probably be converted to integer math.
4. Calculating state of charge. This looks straightforward to convert to integer math.

Do you know how long it takes to execute a floating point division on the stm32f413 without the FPU? I am concerned about point 3 because we are expecting to send over 900 floating point values over CAN each second (10 x 31 voltages + 10 x 62 temperatures). This seems like it could be quite CPU intensive if each typecast + division takes a while. It might be worth it to consider a fourth option:

Remove as much floating point math as possible, but keep the FPU on and treat floating point operations as a critical section (eg. disable interrupts when we do them).

If we chose to leave the FPU enabled, we would have to make sure we have a handler set up to catch any faults caused by this issue

ClarkPoon, 2021-07-22:
From a BPS perspective, I think the best option would be to remove all floating point and change the CAN spec. What do you think @chaseblock @JimothyGreene @afnanmmir @dimembermatt

Closed 2021-08-28.

Thread 390 (2021-07-24):

Fix Charge.c

ClarkPoon, 2021-07-24:
In charge.c, we are calling EEPROM driver functions without initializing the EEPROM. This could cause a hard fault. We are also using a dummy value of 1 million for `MAX_CHARGE_AMP_HRS`. We should figure out the actual value for this if we want to have a reasonable estimate of our charge. Additionally, storing this as a percentage with resolution of 0.01% which may not give us the necessary precision, so we might want to use another unit (eg. milliamp hours) instead. We are also updating our charge by adding a `uint32_t` to it, so it is impossible for our software to show a decrease in charge

Closed 2021-12-20.

Thread 392 (2021-07-31):

Test AS8510 Driver

ClarkPoon, 2021-07-31:
We need to run the test in Tests/Test_AS8510.c to verify that the AS8510 Driver works. Any issues that we run into when testing this should have an issue ticket opened or a response posted here

ClarkPoon, 2021-10-30:
AS8510 has been removed from the design. The replacement chip and corresponding driver (ADS7042) have been added to the hardware, written, and tested

Closed 2021-10-30.

Thread 396 (2021-09-01):

Profile power consumption and implement low power modes

chaseblock, 2021-09-01:
Every Watt on this car counts. We would like to have a good idea of how much power all of our systems consume, as well as how much power we can reduce them to. Since the BPS is a (relatively speaking) mature system at this point, it would be good to know how much power it is consuming, as well as looking into lower-power modes that it could be put into.

From the STM32F413/23 datasheet:

> By default, the microcontroller is in Run mode after a system or a power-on reset. In Run mode the CPU is clocked by HCLK and the program code is executed. Several low-power modes are available to save power when the CPU does not need to be kept running, for example when waiting for an external event. It is up to the user to select the mode that gives the best compromise between low-power consumption, short startup time and available wakeup sources.
The devices feature four low-power modes:
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

In addition, it would be good to have some idea of how much power other chips in the system (the EEPROM, CAN chip, USB chip, LTC6820 chips, etc) are consuming, as well as whether we can do anything about that, either in software or with hardware modifications.

A note: I suspect that anything that takes advantage of low-power mode on the STM may need to interact with the operating system a fair bit to ensure no critical processes are being interrupted and to make sure that timing information (where needed) stays accurate.

Thread 397 (2021-09-01):

Create battery model for voltage drop when under load

ClarkPoon, 2021-09-01:
When batteries are supplying current, their voltage will drop. Since the BPS is protecting the battery from an under-voltage, it is possible that the motor could draw enough current to pull a battery with a voltage close to the under-voltage limit to below the limit without tripping for over-current. It would be nice if we had a model that could predict this voltage drop.

This would also be helpful for determining state of charge, since we could use the measured voltage, the measured current, and the model to estimate the open-circuit voltage, which can be used to estimate state of charge. I am guessing that we would have a more accurate estimate if we incorporate voltage and temperature measurements into our state of charge algorithm.

An example of a battery model to predict how current draw will affect voltage can be found here: https://www.researchgate.net/figure/2RC-circuit-battery-model_fig1_327310441

Thread 399 (2021-09-01):

Create automated testing system

ClarkPoon, 2021-09-01:
In large software projects, it is common to run automated regression tests on pull requests before they are merged into mainline. Currently, all we are doing is making sure the code builds and requiring an approving code review. It would be nice if we could run software tests on our pull request as well.

A few ideas on how we could do this are:
- Unit test any functions that can be reasonably unit tested in a Linux environment (possibly through GitHub actions)
- Create dummy test versions of the BSP and Drivers that return values from a test-case specific config file, so we can test the application layer's response in some scenarios (eg. trying to turn on the car while the battery is under-volted). This could possibly be done through GitHub actions.
- Create a hardware setup we can remote into that hooks up the the BPS and can flash it and manipulate it's inputs to run different test cases on the BPS. This would probably be quite involved and I am not sure it is a realistic option for us. For more information, see https://en.wikipedia.org/wiki/Hardware-in-the-loop_simulation

Ideally, this system should:
- Run automated tests on the BPS code whenever a pull request is opened
- Be easy to use to add new tests
- Send some sort of notification on whether or not the tests have passed or failed and/or block a pull request from merging if the tests fail

I expect that creating this system would be an extensive project, so other issue tickets for smaller parts of this project should be created when we begin development on this

Closed 2023-02-13.

Thread 402 (2021-10-02):

OS semaphore pend/post return value

manthanand, 2021-10-02:
The OS pend and post functions return the count value of the semaphore. In the case that a semaphore was pended multiple times, the post function must also post that many times in order to free the semaphore. The only way this can occur is if the pend and post functions return the value of the semaphore so we can check if they have been cleared when posting.
`typedef struct {
    void (*pend)(void);
    void (*post)(void);
} bsp_os_t;`

should be

`typedef struct {
    uint8_t (*pend)(void);
    uint8_t (*post)(void);
} bsp_os_t;`

manthanand, 2022-08-22:
This issue is covered by the RTOS wrapper issue #401

Thread 411 (2021-12-06):

Full System Test Plan

ClarkPoon, 2021-12-06:
We need a test plan for when we run full system tests on the BPS in late January before we integrate with the battery in early February. We should create these plans by the end of winter break, so we can hit the ground running once the spring semester starts.

Closed 2022-04-17.

Thread 416 (2021-12-18):

Fix up Voltage Open Wire checks

ClarkPoon, 2021-12-18:
Right now, the voltage open wire checks are commented out. This is because the checks slow the voltage and temperature task down by several seconds. This causes the watchdog to time out before the task can complete a single loop. It would be nice to have open wire checks working within our time constraints, but I don't think they are as safety critical as checking voltage and temperature because the voltage and temperature checks usually catch any open wires with a second or so (based on my experiments).

A few possible solutions are:
1. Optimize the open wire checks so they take less time.
2. Only check some wires on each iteration of the voltage and temperature task, and cycle through the wires over time. The goal of this is to reduce the time it takes for the task to run a single loop.
3. Make a new task for voltage open wire checks. I think this would be a pain because it would compete with the voltage and temperature task for control of the SPI1 bus.

One other problem with the open wire checks can be found here: https://github.com/lhr-solar/BPS/pull/407#discussion_r771759274

The issue is that the code assumes that the last minion board will measure 7 modules, which might not be true if we have to remove one of our modules during competition. There is a real possibility that the judges could require us to run on 30 modules, so **this needs to be part of any pull request that adds in the open wire checks.**

Thread 418 (2021-12-18):

OS Independent CAN support

ClarkPoon, 2021-12-18:
If we have an OS fault, the CAN Driver can become unusable. This prevents the BPS from sending CAN messages in a fault state caused by an OS fault. If we want to support sending CAN messages in an OS fault, we need an alternative "emergency" CAN implementation that does not rely on the OS. We can probably just repurpose our CAN implementation marked as `BAREMETAL`

ClarkPoon, 2021-12-18:
Opened because of this pull request comment: https://github.com/lhr-solar/BPS/pull/407#discussion_r771759995

Closed 2023-03-03.

Thread 425 (2022-01-02):

The original intent here was to have different charging cutoffs based on the highest temperature measured in the battery pack. If any cells are above `MAX_CHARGE_TEMPERATURE_LIMIT` (defined in `Config/Inc/config.h`), the BPS should not allow charging. I am realizing now that we are using this improperly, and this bug slipped by the original reviews and testing, so good catch. I will make a fix for this

ClarkPoon, 2022-01-02:
The original intent here was to have different charging cutoffs based on the highest temperature measured in the battery pack. If any cells are above `MAX_CHARGE_TEMPERATURE_LIMIT` (defined in `Config/Inc/config.h`), the BPS should not allow charging. I am realizing now that we are using this improperly, and this bug slipped by the original reviews and testing, so good catch. I will make a fix for this

_Originally posted by @ClarkPoon in https://github.com/lhr-solar/BPS/pull/271#discussion_r777265413_

Closed 2022-01-05.

Thread 430 (2022-01-06):

Review MinionsASIC_Mutex usage

ClarkPoon, 2022-01-06:
Sometimes we are posting the mutex, then immediately pending it again, which might not be the most efficient way to handle this. We are also not using it sometimes when we communicate with the minion boards. Right now, I think the mutex is being used to protect access to the minion boards' SPI bus and to the minions asic array. We may want to use two mutexes for this

See:
https://github.com/lhr-solar/BPS/pull/271/files#r776791544
and
https://github.com/lhr-solar/BPS/pull/271/files#r776792239

manthanand, 2022-01-23:
I think the MinionsIO_Sem4 is supposed to be used for SPI bus protection.

ClarkPoon, 2022-01-23:
> I think the MinionsIO_Sem4 is supposed to be used for SPI bus protection.

The MinionsIO_Sem4 is for notifying us when we receive an SPI interrupt. It does not protect the SPI bus from multiple tasks accessing it at the same time.

Thread 431 (2022-01-09):

Add Contactor Check Task

ClarkPoon, 2022-01-09:
Reg 8.6.C.2 requires the switch to illuminate the BPS Fault Dash Indicator, so we can't do this by just putting it on the high voltage line, since the BPS wouldn't be able to tell if the switch is pressed or not.

I think our plan was to put it in series with the BPS contactor power line, so it could cut off power to the car by forcing those contactors open. The BPS would have to then detect that the contactor has been forced open and enter a fault state if the BPS thinks the contactor should be closed, but it is open.

We need a task that will periodically run and check to see if the contactor state is open when the BPS is trying to close the contactor. If this is the case, the BPS should enter a fault state so it turns on the BPS fault indicators.

Closed 2022-01-16.

Thread 443 (2022-04-18):

These issues are migrated from TODO list on drive

manthanand, 2022-04-18:
*set up system to make sure dashboard doesn't turn on motor during charging
*Verify charging state setup, what is required to charge

ClarkPoon, 2022-04-26:
A temporary solution that we are using is to just tell the driver to not turn on the motor if the BPS recently tripped due to an under-voltage, but it would be nice to have the system actually notify the driver about this (eg. via the BPS display board).

We could also solve this by sending a message to controls that turning on the motor will fault the BPS, so they disable the motor, but this is not necessary (will just make it harder for the driver to accidentally/intentionally fault the BPS)

manthanand, 2023-02-13:
Closing this issue since we do not have a dashboard anymore.

Closed 2023-02-13.

Thread 449 (2022-04-30):

PID Loop for Fans

manthanand, 2022-04-30:
Create a PID Control Loop for changing the fan speeds based on the temperature of the battery pack.

Closed 2023-03-03.

Thread 450 (2022-05-01):

Change Battery Module Configurations

manthanand, 2022-05-01:
Right now, we assume that the last minion has the lowest number of modules (if any are the lowest). Because of this we do a lot of shitty math to make up for it. It would be better if we just defined how many modules each minion was connected to and changed our logic to accommodate that (in case the 3rd minion had the lowest number). The reason for this is because our connections are based on wiring distances in hardware.

Thread 454 (2022-05-05):

Create software filters App

manthanand, 2022-05-05:
While we like to assume our hardware is perfect. It sometimes isn't. It would be nice if we could have some efficient, memory cheap filter functions for all of our analog inputs and have this in the application layer. We already have an averaging filter for the Current sensing and a median filter for voltage and temperature. We should see if there is an improvement to be made or not.

manthanand, 2022-05-13:
We should also consider using the filter capabilities of the LTC6811 if they prove to be more stable than our filters.

Closed 2022-05-31.

Thread 459 (2022-05-18):

Faster Baud Rate

manthanand, 2022-05-18:
Try making USB UART capable of 921600 b/s so CLI task can run faster. This could make it easier to debug code so timing issues don't pop up when using slow printf functions.

Closed 2023-11-26.

Thread 461 (2022-05-28):

Improve Voltage Filtering

ClarkPoon, 2022-05-28:
Sometimes I can get the BPS to trip from over-voltage or under-voltage by repeatedly cycling the motor to drive full power forwards and then full regen brake repeatedly.

Closed 2022-05-31.

Thread 462 (2022-06-12):

Add support for detecting contactor welds.

ClarkPoon, 2022-06-12:
One common failure mode for a contactor is that it will weld itself shut. We can detect this in software by checking the aux lines when the contactors are supposed to be open. See https://github.com/lhr-solar/BPS-LeaderPCB/issues/6 for more info

Closed 2023-03-04.

Thread 463 (2022-06-12):

Add support for isolation detection

ClarkPoon, 2022-06-12:
Commercial BMSes will often have a system for measuring the isolation between the frame and the high voltage line. If the isolation falls below a certain threshold, this is a safety issue, and we should notify the driver and shut down the vehicle.

Thread 464 (2022-06-12):

Monitor module internal resistances

ClarkPoon, 2022-06-12:
You can compute the internal resistance of a module if you know the current passing through it and the open circuit voltage. If there is a sudden change in internal resistance, this can indicate that a spot weld has failed or a cell has gone bad (eg. internally shorted).

We should add monitoring for this

manthanand, 2023-02-13:
This can also be done by using AC impedance testing since some bad spot welds could occur while the car is moving, meaning we wouldn't be able to get open circuit voltage. However, reading AC impedance while a battery is charging/discharging has not been reliable according to many research papers. One way of doing this could be to read open circuit voltage and current at startup and see if resistance measurement changes over time.

Thread 465 (2022-06-12):

Add support for contactor power economization

ClarkPoon, 2022-06-12:
Contactors can often be held closed while powered off a PWM frequency instead of a constant voltage because it takes much less power to hold a contactor closed than to close a contactor. We should look into this as a power-saving measure.

Closed 2023-02-05.

Thread 466 (2022-06-12):

Add support for blown fuse detection

ClarkPoon, 2022-06-12:
When a fuse on a voltage tap is blown, the module with a positive terminal connected to the fuse will appear to have a lower voltage and the module with a negative terminal connected to the fuse will appear to have a higher voltage. This is because the module voltages are measured relative to each other and there will be a voltage drop across the fuse.

We should add support for automatically detecting this because a blown fuse can prevent us from reading a potentially unsafe condition.

manthanand, 2022-06-14:
Isn't that just an open wire test?

Thread 467 (2022-06-12):

Add redundant measurement systems for fault-tolerance

ClarkPoon, 2022-06-12:
If we add 2 different type of sensors for the same thing (eg. a hall effect sensor and a shunt for current or two different voltage probes per module) we can detect if there is a failure in one of our measurement systems. I have seen this in some othe BMSes that I have looked at (eg. [Prohelion BMS's](https://www.prohelion.com/wp-content/uploads/2021/08/PHLN67.011v1-BMS-Users-Manual.pdf) "trusted measurements").

Not sure if this is worth it for our use case, but it is probably worth looking into.

Thread 468 (2022-06-12):

Disable charging if state of charge is too high

ClarkPoon, 2022-06-12:
If the battery gets close to 100% SoC, the array or motor might try to charge the battery. We should update our logic for sending the charging enabled message to take this into account.

Closed 2022-10-05.

Thread 471 (2022-08-17):

Update BPS to new gdb version

manthanand, 2022-08-17:
The current BPS fails to compile with the newest version of GDB. I would like a new member to work on this so they can understand how to debug compiler issues and change the code to match the compiler without changing the logic of the code. Steps would be:
1. Try making the code and seeing what errors come up
2. If the error is not easily understandable, search it up and see how other people have circumvented it
3. When the error is fixed, try testing the code that was changed on the current hardware to make sure the logic is unchanged.

Closed 2022-10-05.

Thread 481 (2022-09-19):

New BPS Simulator

connorl309, 2022-09-19:
Since the current simulator is both broken and not well written, I propose that we create a new simulator. The BPS needs a way to be tested without having to physically assemble the boards before we know the software logic works correctly. We should be able to comprehensively dump BPS system information from the simulator if we encounter an error, and potentially offer routine info logging, i.e. which task is currently running, which mutexes/semaphores are currently in use, and timing information.

We need to be aware of a few things, namely
- the RTOS migration from Micrium to FreeRTOS
- interactions between the BPS code and the simulator
- how much information should we expose to the simulator and avoiding performance impacts while on the real boards

I think it's important that we are able to test the software besides seeing confirmation that it compiles.

Closed 2023-01-21.

Thread 504 (2022-11-05):

Charge Enable Message

manthanand, 2022-11-05:
Prevent Charge Enable message from being sent before Critical State Task is completed.

Thread 525 (2023-01-11):

Fix Watchdog in Fault State

manthanand, 2023-01-11:
If we do not pass the critical state, then the fault state breaks because it tries to reset the watchdog timer that wasn't initialized. But if we do pass the critical state and then fault, then we need to reset the watchdog timer. We should change it so that the BPS should only try and reset the watchdog timer if the timer has been initialized.

Closed 2023-01-12.

Thread 538 (2023-02-13):

Big Code Review

manthanand, 2023-02-13:
For deadlock prevention:
Bottom of page 7: https://pages.cs.wisc.edu/~remzi/OSTEP/threads-bugs.pdf
also: https://jenkov.com/tutorials/java-concurrency/deadlock-prevention.html
For not detecting when you're not using a mutex when you should:
You can read the code by hand (maybe give each shared resource a ticket and have some people read over the code and wherever it is used, make sure it is locked)
You can try implementing something like this (or find a newer approach. This paper is from 2005): https://www.cs.utexas.edu/~rossbach/cs380p/papers/yu05sosp-racetrack.pdf
You would probably implement this by adding some instrumentation to RTOS_BPS functions and by wrapping accesses to shared variables with a macro that adds some instrumentation. I can write an example if you want.
You can also try and see if you can find a framework for detecting race conditions that works with micrium (or pthreads for the simulator)

connorl309, 2023-02-18:
We might be able to use the timeout options for mutexes that Micrium allows, and in our wrappers/calls to assertOSError we can print some debugging info if we get a timeout error (i.e. there was a deadlock but the timeout prevented it from fully locking up)

Thread 540 (2023-02-15):

Makefile Print File with main function

manthanand, 2023-02-15:
When making code, we should print what file contains the main function. We have had issues with debugging where we find the wrong main function flashed onto a file. For example, if we run `make TEST=VoltTempMonitorTask`, then we would print `making Test_VoltTempMonitorTask.c`.

Closed 2023-02-18.

Thread 549 (2023-02-19):

Move delay_u and delay_m functions from LTC6811 library to PLL library.

manthanand, 2023-02-19:
It doesn't make sense for our driver library to have the delay functions within them. It makes more sense for them to be within our PLL BSP layer since that is what controls the timing of our clock.

Closed 2023-03-10.

Thread 556 (2023-02-20):

Make printf non-blocking

manthanand, 2023-02-20:
If we want to test but don't want to use printf, it would be much easier to just make it non-blcoking so the watchdog doesn't trip when the UART port is not used.

Thread 563 (2023-03-04):

Voltage Not working

manthanand, 2023-03-04:
The voltages arent updating after being read for the first time.

Closed 2023-04-16.

Thread 567 (2023-03-10):

Simulator does not error out

manthanand, 2023-03-10:
When simulator.c calls `exit(-1)`, the workflow does not recognize that as a fail because the python script that runs it does not error out. We should fix this (for example, if the wrong number of elements are in the voltage/temperature array, the code will pass all test cases even though they never ran).

manthanand, 2023-04-08:
How Issue was seen:
In Simulator.c, we used to call `exit(-1)` if the size of the Voltage/Temperature arrays did not match the number of voltage/temp sensors in `config.h`. However instead of failing the test, we would just move on to the next test.

Closed 2023-04-15.

Thread 568 (2023-03-10):

Change elements in Volt/Temp Arrays simulator

manthanand, 2023-03-10:
We shouldn't have to go through all the simulator data files and change the lengths of the voltage/temperature arrays every time we change `config.h`. We should have some functionality in simulator.c to change the length if it does not match, or have a script change all the lengths while still keeping the original fault.

ray4477, 2023-03-25:
this has already been done by Champers i think in the Simulator.c

manthanand, 2023-03-28:
This hasn't. There is a TODO in Simulator.c which explains the issue.

Thread 570 (2023-03-10):

Simulator Test Fail Behaviour

manthanand, 2023-03-10:
At the moment, when we fail a simulator test, we print out the entire file that was used. Instead we should print the file name.

Champers5000, 2023-03-25:
This is fine no?
The automated tests are randomly generated and there's no other way of seeing what the simulator failed on

Closed 2023-04-08.

Thread 573 (2023-03-12):

Get config.msgs to work better

manthanand, 2023-03-12:
If you run make, you will get this disgusting output with all the #pragmas being printed out as notes. Also some of the #defiens arent reduced to their numerical value (which is why its useful). We should make this work better.

connorl309, 2023-03-25:
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

Make will only print the macro for any defines, but any and all remaining errors are fully explained as usual. Pushing changes

connorl309, 2023-03-25:
(Separate defines are split with a /)

Closed 2023-04-10.

Thread 586 (2023-04-29):

simulator big broke 🤯🤯🤯🤯🤯💀💀💀

tiandahuang, 2023-04-29:
The simulator (c) is written in a way that requires an insane amount of memory to run -- it's slow too, and not very robust.
Currently, the simulator is experiencing some issue (on my laptop where theres limited RAM and CPU) where it stalls with no error, likely out of memory or too much file I/O.
Also, registering SIGINT makes the process very annoying to kill when it stalls.

A list of fixes that would be nice:

- Rewrite `simulator.c` to make file IO more robust (stop using syscalls, there are libraries for that!)
- Make `simulator.c` more robust to errors and stalls.
- `simulator.c` can use higher-level C FILE APIs (and other higher level standard library tools)
- Rewrite the python portion to use better python practices (e.g. `subprocess.Popen()` instead of `os.system()` and actual error handling)

dm me for questions and concerns
T's and G's

manthanand, 2023-09-25:
Are yall gonna switch to another simulator or just not use this one? You should delete it from the repo if you aren't gonna use it.
