lhr-solar/BPS/Electronics/BPS/Tester/BPSTester.kicad_pcb

## KiCad design Electronics/BPS/Tester/BPSTester.kicad_pcb (2019-02-03, last stored version)

Schematic: BPSTester.sch

Parts:
1K1, 1K2, 1K3, 1K4, 1K5, 1K6, 1K7, 1K8, 1K9, 1K10, 1K11, 1K12: POT; Potentiometer_Trimmer_Bourns_3296W
J1: Conn_01x13_Male; Molex_KK-6410-13_13x2.54mm_Straight
J2: Conn_01x02_Male; Molex_KK-6410-02_02x2.54mm_Straight
TP1, TP2, TP3, TP4, TP5, TP6, TP7, TP8, TP9, TP10, TP11, TP12, TP13: TestPoint; Test_Point_Keystone_5005-5009_Compact

Connections:
+BATT: 1K1.2, J1.12, J1.13, J2.2, TP2.1
GND: 1K12.3, J2.1, TP1.1
unnamed: 1K1.3, 1K2.2, J1.11, TP3.1
unnamed: 1K2.3, 1K3.2, J1.10, TP4.1
unnamed: 1K3.3, 1K4.2, J1.9, TP5.1
unnamed: 1K4.3, 1K5.2, J1.8, TP6.1
unnamed: 1K5.3, 1K6.2, J1.7, TP7.1
unnamed: 1K6.3, 1K7.2, J1.6, TP8.1
unnamed: 1K7.3, 1K8.2, J1.5, TP9.1
unnamed: 1K8.3, 1K9.2, J1.4, TP10.1
unnamed: 1K9.3, 1K10.2, J1.3, TP12.1
unnamed: 1K10.3, 1K11.2, J1.2, TP13.1
unnamed: 1K11.3, 1K12.2, J1.1, TP11.1

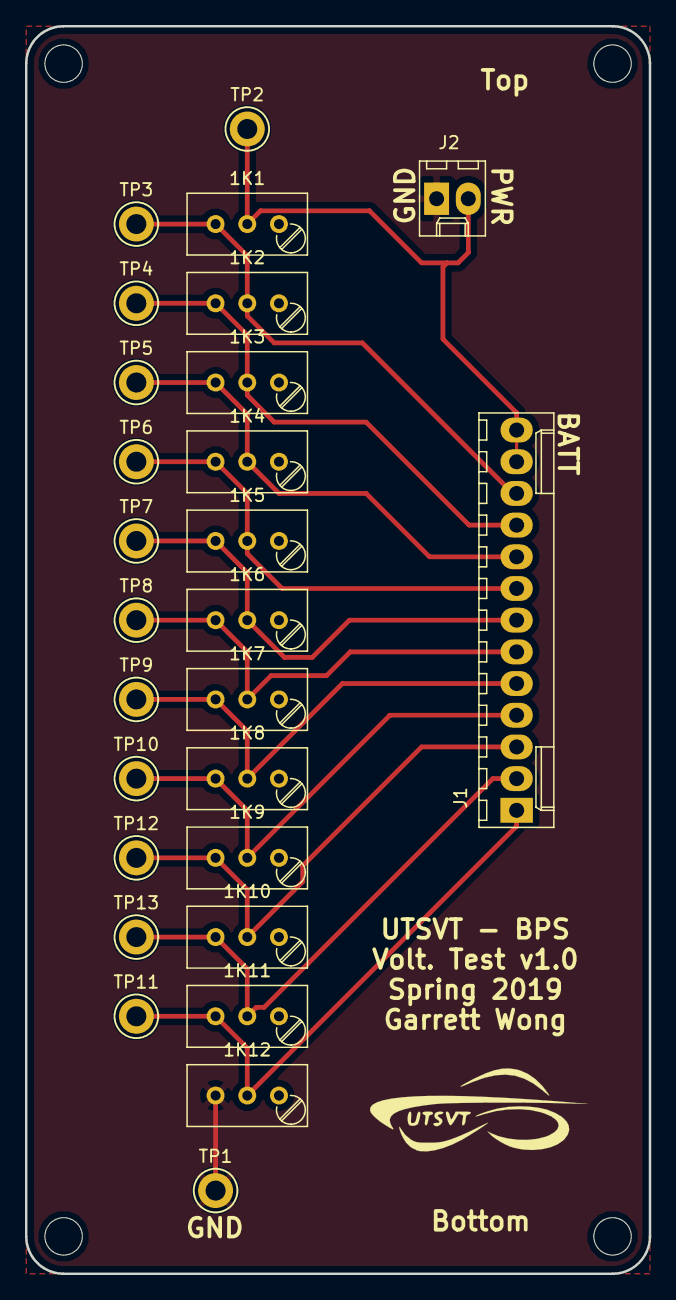
[picture p44: board BPSTester.kicad_pcb from above]

Board: 2 copper layers, 50.0 x 100.0 mm, 27 parts (0 on the bottom side), 13 nets.
