lhr-solar/BPS/Electronics/BPS/Voltage/BPSVoltage.kicad_pcb

## KiCad design Electronics/BPS/Voltage/BPSVoltage.kicad_pcb (2019-02-03, last stored version)

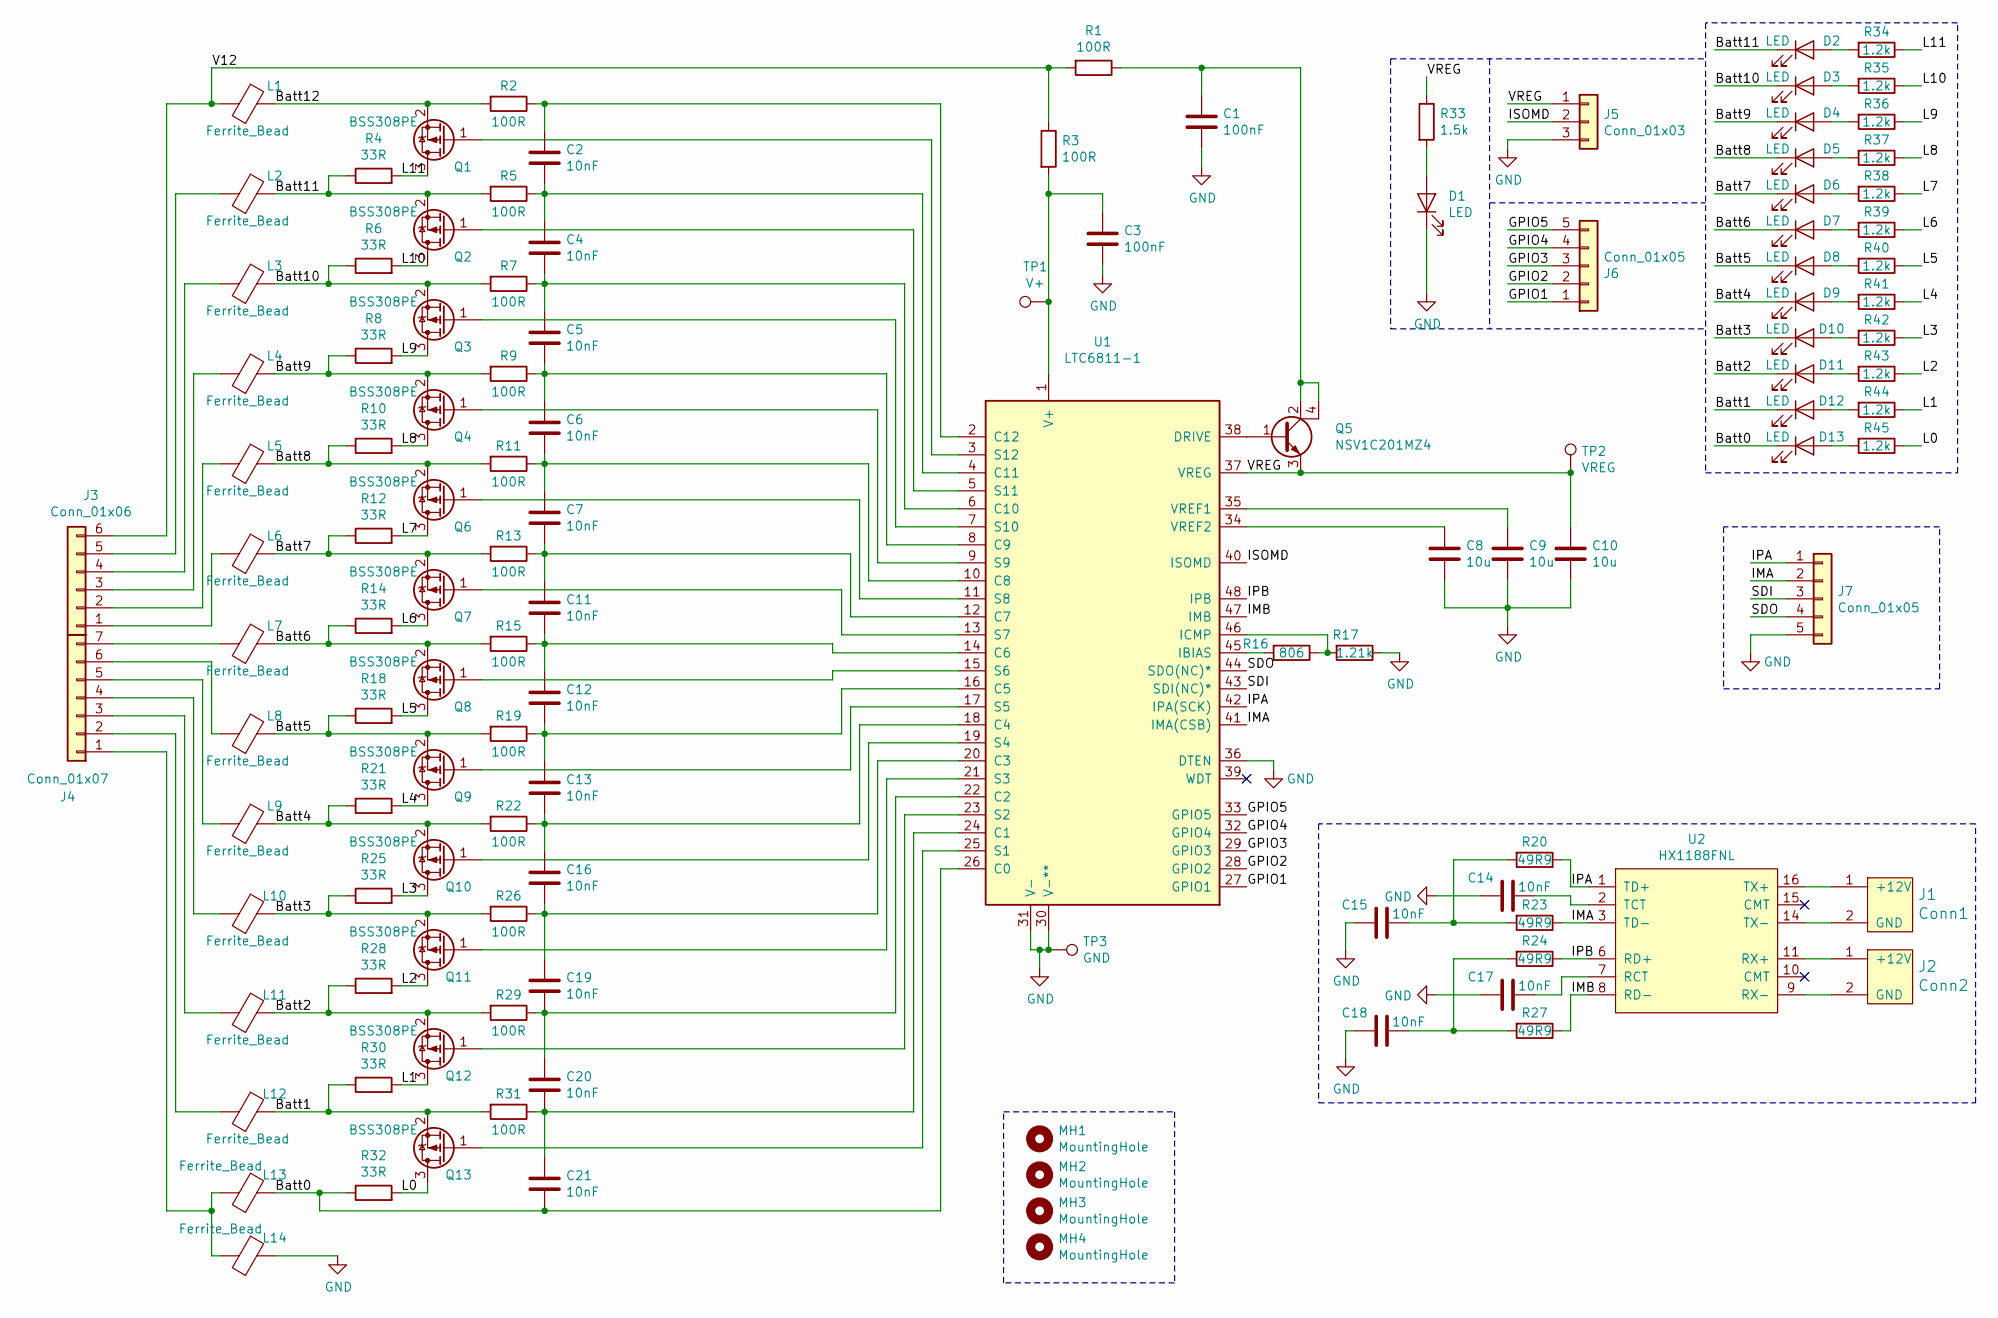
[picture p45: schematic BPSVoltage.sch]

Parts:
C1, C3: 100nF; C_0805_2012Metric
C2, C4, C5, C6, C7, C11, C12, C13, C14, C15, C16, C17, C18, C19, C20, C21: 10nF; C_0805_2012Metric
C8, C9, C10: 10u; C_0805_2012Metric
D1, D2, D3, D4, D5, D6, D7, D8, D9, D10, D11, D12, D13: LED; LED_0805_2012Metric
J1: Conn1; Molex_MicroFit3.0_1x2xP3.00mm_PolarizingPeg_Vertical
J2: Conn2; Molex_MicroFit3.0_1x2xP3.00mm_PolarizingPeg_Vertical
J3: Conn_01x06; Molex_MicroFit_01x06_Horizontal
J4: Conn_01x07; Molex_MicroFit_01x07_Horizontal
J5: Conn_01x03; PinHeader_1x03_P2.54mm_Vertical
J6, J7: Conn_01x05; PinHeader_1x05_P2.54mm_Vertical
L1, L2, L3, L4, L5, L6, L7, L8, L9, L10, L11, L12, L13, L14: Ferrite_Bead; L_0805_2012Metric
MH1, MH2, MH3, MH4: MountingHole; MountingHole_3mm
Q1, Q2, Q3, Q4, Q6, Q7, Q8, Q9, Q10, Q11, Q12, Q13: BSS308PE; SOT-23
Q5: NSV1C201MZ4; SOT-223
R1, R2, R3, R5, R7, R9, R11, R13, R15, R19, R22, R26, R29, R31: 100R; R_0805_2012Metric
R4, R6, R8, R10, R12, R14, R18, R21, R25, R28, R30, R32: 33R; R_2512_6332Metric
R16: 806; R_0805_2012Metric
R17: 1.21k; R_0805_2012Metric
R20, R23, R24, R27: 49R9; R_0805_2012Metric
R33: 1.5k; R_0805_2012Metric
R34, R35, R36, R37, R38, R39, R40, R41, R42, R43, R44, R45: 1.2k; R_0805_2012Metric
TP1: V+; TestPoint_Keystone_5005-5009_Compact
TP2: VREG; TestPoint_Keystone_5005-5009_Compact
TP3: GND; TestPoint_Keystone_5005-5009_Compact
U1: LTC6811-1; SSOP-48_7.5x15.9mm_P0.635mm
U2: HX1188FNL; HXXXX

Connections:
/Batt0: C21.1, D13.1 (K), L13.1, R32.1, U1.26 (C0)
/Batt1: D12.1 (K), L12.1, Q13.2 (S), R30.1, R31.2
/Batt2: D11.1 (K), L11.1, Q12.2 (S), R28.1, R29.2
/Batt3: D10.1 (K), L10.1, Q11.2 (S), R25.1, R26.2
/Batt4: D9.1 (K), L9.1, Q10.2 (S), R21.1, R22.2
/Batt5: D8.1 (K), L8.1, Q9.2 (S), R18.1, R19.2
/Batt6: D7.1 (K), L7.1, Q8.2 (S), R14.1, R15.2
/Batt7: D6.1 (K), L6.1, Q7.2 (S), R12.1, R13.2
/Batt8: D5.1 (K), L5.1, Q6.2 (S), R10.1, R11.2
/Batt9: D4.1 (K), L4.1, Q4.2 (S), R8.1, R9.2
/Batt10: D3.1 (K), L3.1, Q3.2 (S), R6.1, R7.2
/Batt11: D2.1 (K), L2.1, Q2.2 (S), R4.1, R5.2
/Batt12: L1.1, Q1.2 (S), R2.2
/GPIO1: J6.1, U1.27 (GPIO1)
/GPIO2: J6.2, U1.28 (GPIO2)
/GPIO3: J6.3, U1.29 (GPIO3)
/GPIO4: J6.4, U1.32 (GPIO4)
/GPIO5: J6.5, U1.33 (GPIO5)
/IMA: J7.2, R23.1, U1.41 (IMA(CSB)), U2.3 (TD-)
/IMB: R27.1, U1.47 (IMB), U2.8 (RD-)
/IPA: J7.1, R20.1, U1.42 (IPA(SCK)), U2.1 (TD+)
/IPB: R24.1, U1.48 (IPB), U2.6 (RD+)
/ISOMD: J5.2, U1.40 (ISOMD)
/L0: Q13.3 (D), R32.2, R45.1
/L1: Q12.3 (D), R30.2, R44.1
/L2: Q11.3 (D), R28.2, R43.1
/L3: Q10.3 (D), R25.2, R42.1
/L4: Q9.3 (D), R21.2, R41.1
/L5: Q8.3 (D), R18.2, R40.1
/L6: Q7.3 (D), R14.2, R39.1
/L7: Q6.3 (D), R12.2, R38.1
/L8: Q4.3 (D), R10.2, R37.1
/L9: Q3.3 (D), R8.2, R36.1
/L10: Q2.3 (D), R6.2, R35.1
/L11: Q1.3 (D), R4.2, R34.1
/SDI: J7.3, U1.43 (SDI(NC)*)
/SDO: J7.4, U1.44 (SDO(NC)*)
/V12: J3.6, L1.2, R1.2, R3.1
/VREG: C10.1, J5.1, Q5.3 (E), R33.1, TP2.1, U1.37 (VREG)
GND: C1.2, C3.2, C8.2, C9.2, C10.2, C14.2, C15.2, C17.2, C18.2, D1.1 (K), J5.3, J7.5, L14.1, R17.1, TP3.1, U1.30 (V-**), U1.31 (V-), U1.36 (DTEN)
unnamed: C1.1, Q5.2 (C), Q5.4 (C), R1.1
unnamed: C2.1, C4.2, R5.1, U1.4 (C11)
unnamed: C2.2, R2.1, U1.2 (C12)
unnamed: C3.1, R3.2, TP1.1, U1.1 (V+)
unnamed: C4.1, C5.2, R7.1, U1.6 (C10)
unnamed: C5.1, C6.2, R9.1, U1.8 (C9)
unnamed: C6.1, C7.2, R11.1, U1.10 (C8)
unnamed: C8.1, U1.34 (VREF2)
unnamed: C9.1, U1.35 (VREF1)
unnamed: C11.1, C12.2, R15.1, U1.14 (C6)
unnamed: C7.1, C11.2, R13.1, U1.12 (C7)
unnamed: C12.1, C13.2, R19.1, U1.16 (C5)
unnamed: C13.1, C16.2, R22.1, U1.18 (C4)
unnamed: C14.1, U2.2 (TCT)
unnamed: C15.1, R20.2, R23.2
unnamed: C16.1, C19.2, R26.1, U1.20 (C3)
unnamed: C17.1, U2.7 (RCT)
unnamed: C18.1, R24.2, R27.2
unnamed: C19.1, C20.2, R29.1, U1.22 (C2)
unnamed: C20.1, C21.2, R31.1, U1.24 (C1)
unnamed: D1.2 (A), R33.2
unnamed: D2.2 (A), R34.2
unnamed: D3.2 (A), R35.2
unnamed: D4.2 (A), R36.2
unnamed: D5.2 (A), R37.2
unnamed: D6.2 (A), R38.2
unnamed: D7.2 (A), R39.2
unnamed: D8.2 (A), R40.2
unnamed: D9.2 (A), R41.2
unnamed: D10.2 (A), R42.2
unnamed: D11.2 (A), R43.2
unnamed: D12.2 (A), R44.2
unnamed: D13.2 (A), R45.2
unnamed: J1.1 (+12V), U2.16 (TX+)
unnamed: J1.2 (GND), U2.14 (TX-)
unnamed: J2.1 (+12V), U2.11 (RX+)
unnamed: J2.2 (GND), U2.9 (RX-)
unnamed: J3.1, L6.2
unnamed: J3.2, L5.2
unnamed: J3.3, L4.2
unnamed: J3.4, L3.2
unnamed: J3.5, L2.2
unnamed: J4.1, L13.2, L14.2
unnamed: J4.2, L12.2
unnamed: J4.3, L11.2
unnamed: J4.4, L10.2
unnamed: J4.5, L9.2
unnamed: J4.6, L8.2
unnamed: J4.7, L7.2
unnamed: Q1.1 (G), U1.3 (S12)
unnamed: Q2.1 (G), U1.5 (S11)
unnamed: Q3.1 (G), U1.7 (S10)
unnamed: Q4.1 (G), U1.9 (S9)
unnamed: Q5.1 (B), U1.38 (DRIVE)
unnamed: Q6.1 (G), U1.11 (S8)
unnamed: Q7.1 (G), U1.13 (S7)
unnamed: Q8.1 (G), U1.15 (S6)
unnamed: Q9.1 (G), U1.17 (S5)
unnamed: Q10.1 (G), U1.19 (S4)
unnamed: Q11.1 (G), U1.21 (S3)
unnamed: Q12.1 (G), U1.23 (S2)
unnamed: Q13.1 (G), U1.25 (S1)
unnamed: R16.1, R17.2, U1.46 (ICMP)
unnamed: R16.2, U1.45 (IBIAS)

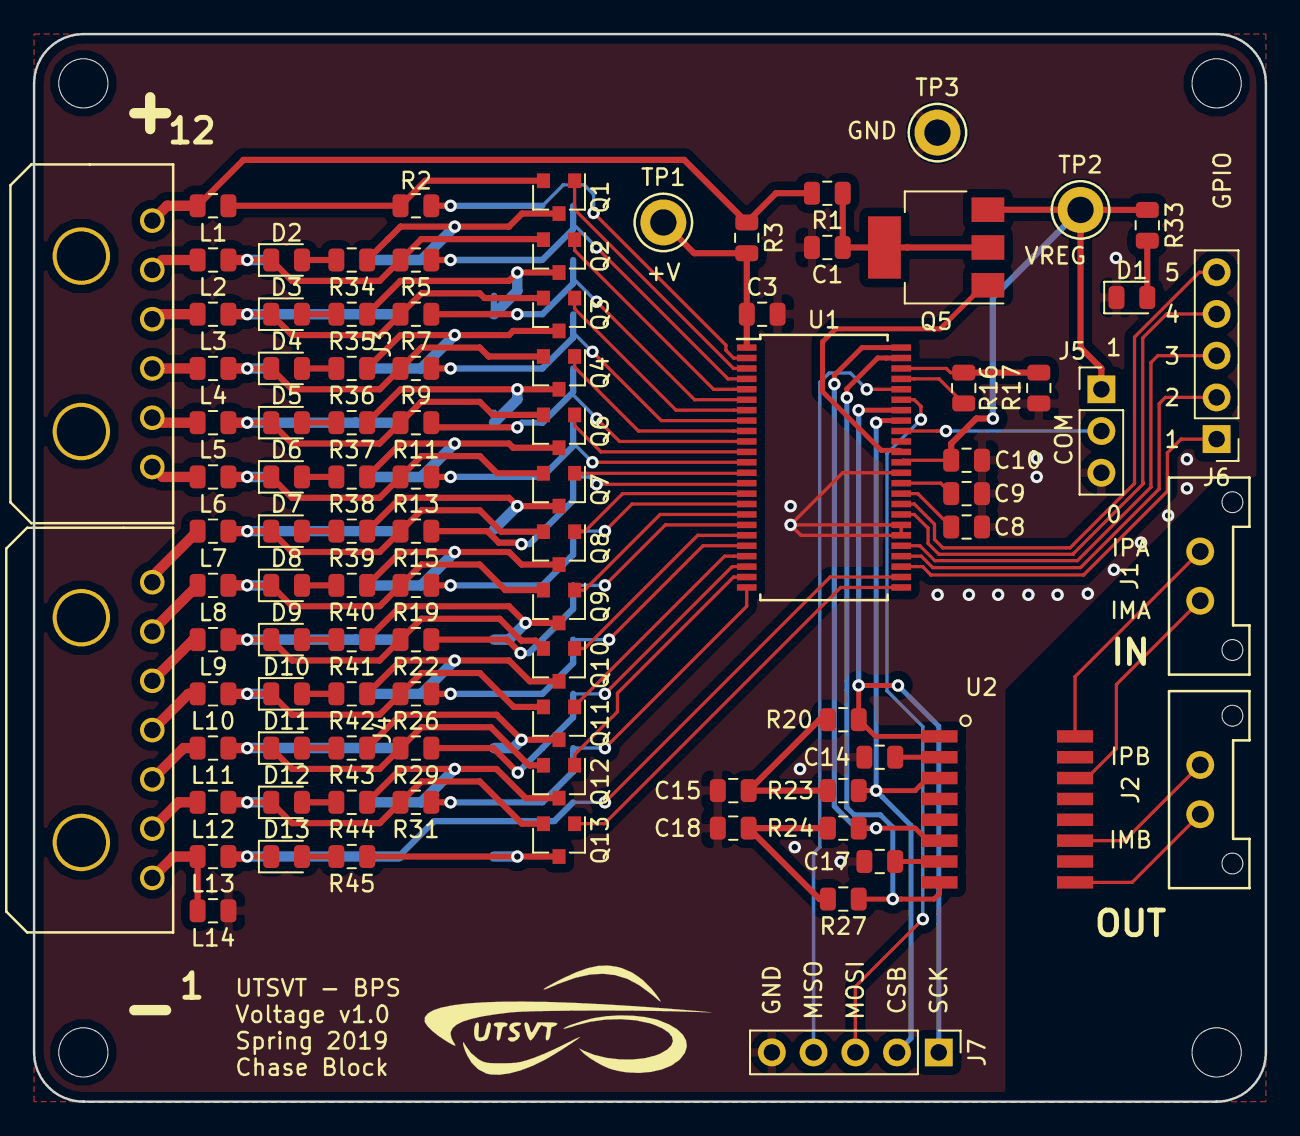
[picture p46: board BPSVoltage.kicad_pcb from above]

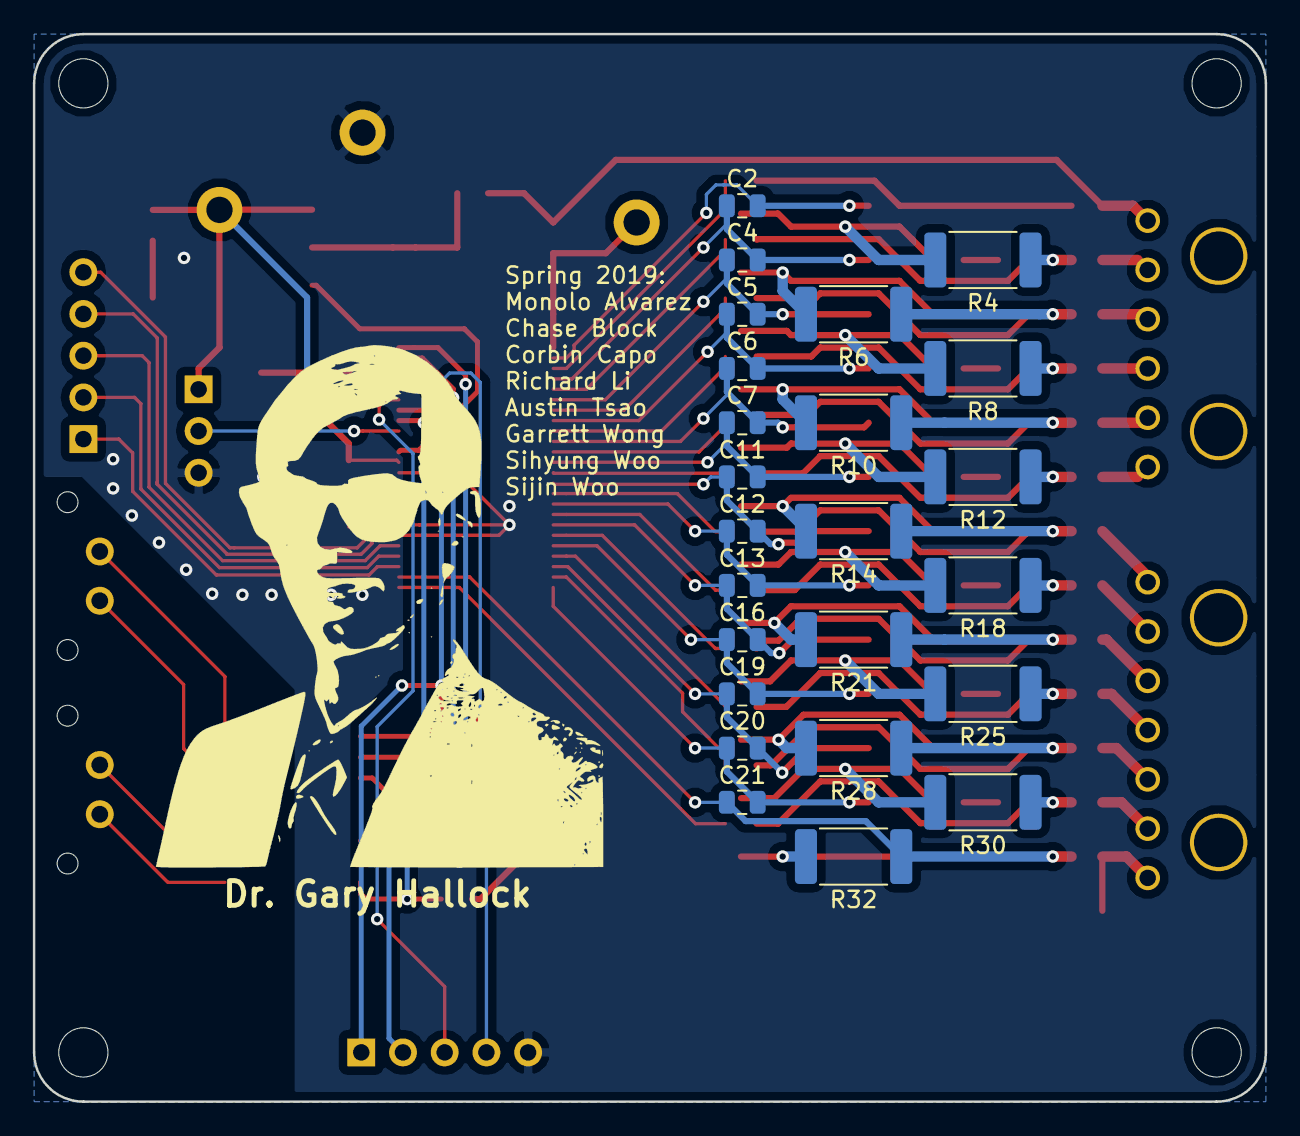
[picture p47: board BPSVoltage.kicad_pcb from below]

Board: 2 copper layers, 75.0 x 65.0 mm, 118 parts (24 on the bottom side), 104 nets.
