lhr-solar/BPS/Electronics/BPS/Master/BPSMaster.kicad_pcb

## KiCad design Electronics/BPS/Master/BPSMaster.kicad_pcb (2019-02-03, last stored version)

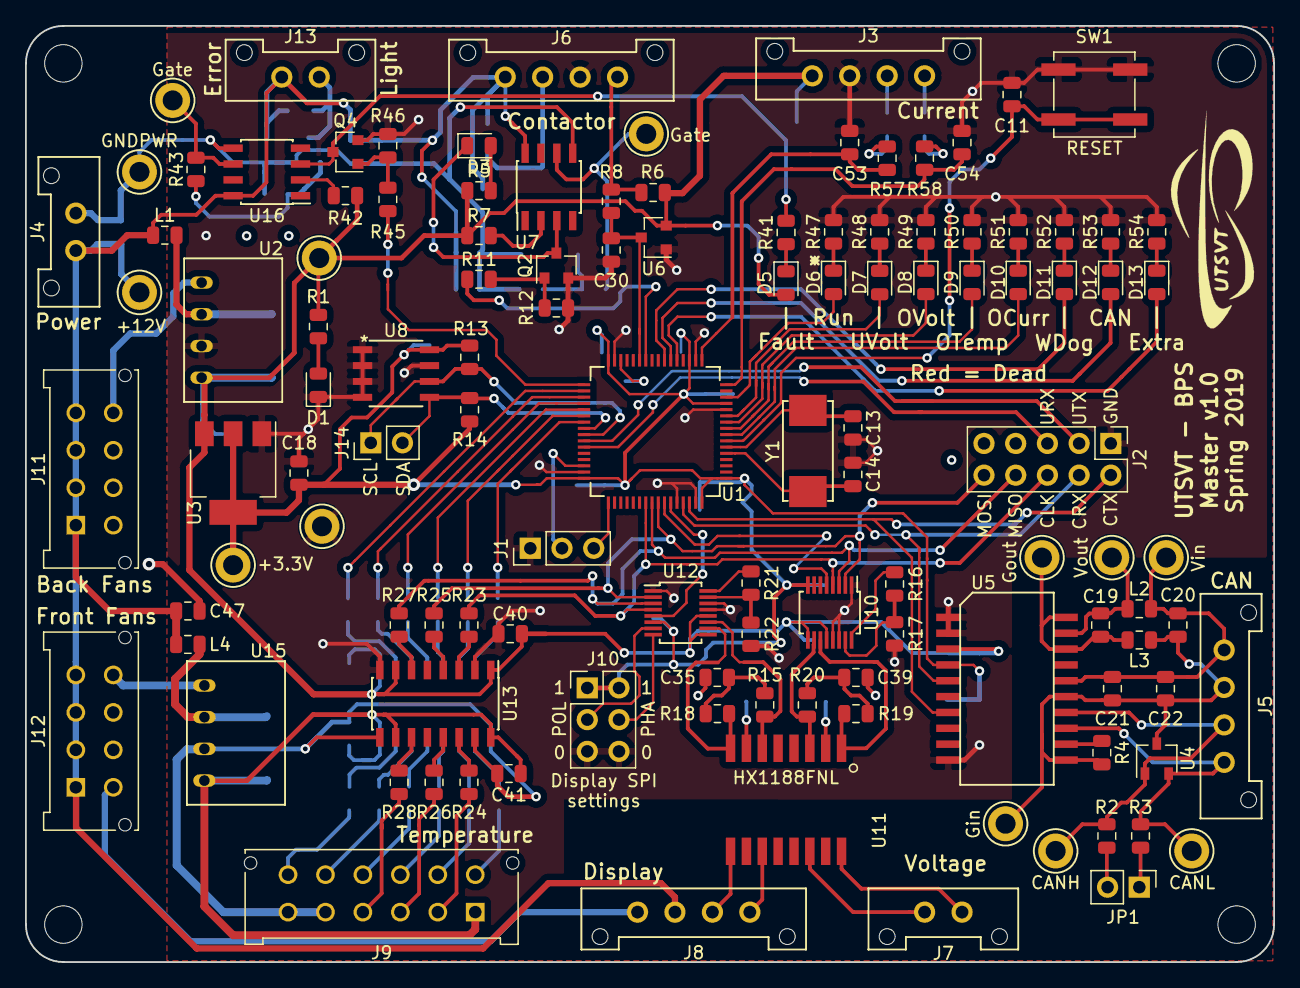
[picture p48: board BPSMaster.kicad_pcb from above]

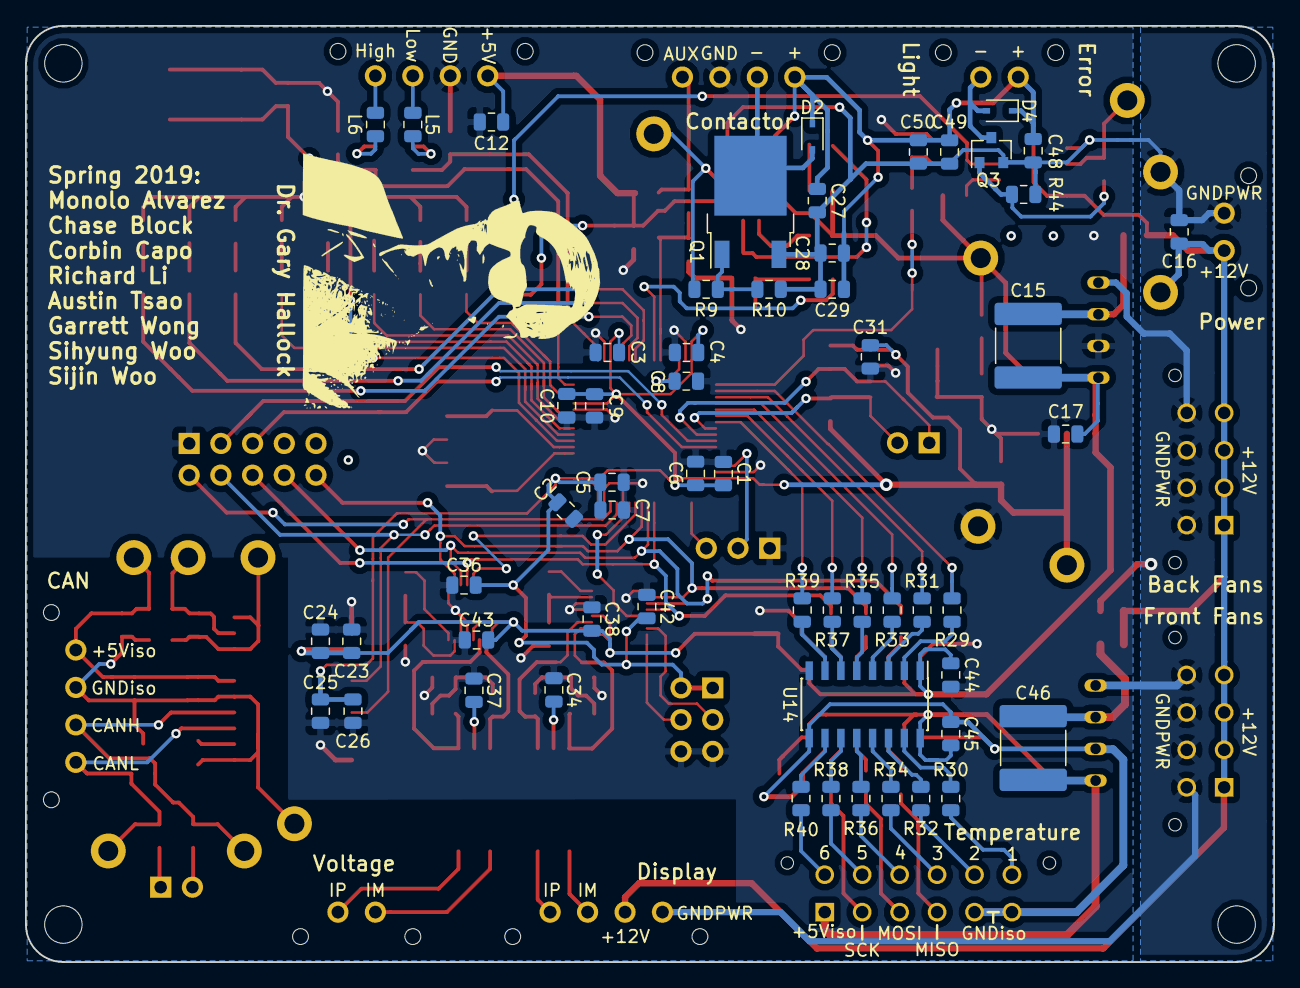
[picture p49: board BPSMaster.kicad_pcb from below]

Board: 2 copper layers, 100.0 x 75.0 mm, 178 parts (56 on the bottom side), 127 nets.

Parts:
C1, C2, C3, C4, C5, C6, C9, C11, C12, C17, C21, C24, C25, C29, C31, C36, C38, C40, C41, C42, C43, C44, C45, C50: 0.1uF; C_0805_2012Metric
C7, C16, C47: 4.7uF; C_0805_2012Metric
C8: 2.2uF; C_0805_2012Metric
C10, C27, C30, C48, C53, C54: 1uF; C_0805_2012Metric
C13, C14: 6pF; C_0805_2012Metric
C15, C46: 470pF; C_2220_5650Metric
C18, C19, C23, C28, C49: 10uF; C_0805_2012Metric
C20: 0.22uF; C_0805_2012Metric
C22, C26, C34, C35, C37, C39: 0.01uF; C_0805_2012Metric
D1: PowerOn; LED_0805_2012Metric
D2, D4: 1N4148WS; D_SOD-323
D3: ContactorEn; LED_0805_2012Metric
D5: Fault; LED_0805_2012Metric
D6: Heartbeat; LED_0805_2012Metric
D7: UVolt; LED_0805_2012Metric
D8: OVolt; LED_0805_2012Metric
D9: OTemp; LED_0805_2012Metric
D10: OCurr; LED_0805_2012Metric
D11: WDError; LED_0805_2012Metric
D12: CANError; LED_0805_2012Metric
D13: Extra; LED_0805_2012Metric
J1: SWD; PinHeader_1x03_P2.54mm_Vertical
J2: Logic Analyzer; PinHeader_2x05_P2.54mm_Vertical
J3: CurrentSlaveConnector; Molex_MicroFit3.0_1x4xP3.00mm_PolarizingPeg_Vertical
J4: CarPowerConnector; Molex_MicroFit3.0_1x2xP3.00mm_PolarizingPeg_Vertical
J5: CAN_Out; Molex_MicroFit3.0_1x4xP3.00mm_PolarizingPeg_Vertical
J6: ContactorConnector; Molex_MicroFit3.0_1x4xP3.00mm_PolarizingPeg_Vertical
J7: VoltageSlaveConnector; Molex_MicroFit3.0_1x2xP3.00mm_PolarizingPeg_Vertical
J8: DisplayConnector; Molex_MicroFit3.0_1x4xP3.00mm_PolarizingPeg_Vertical
J9: TempSlaveConnector; Molex_MicroFit3.0_2x6xP3.00mm_PolarizingPeg_Vertical
J10: DisplayJumper; PinHeader_2x03_P2.54mm_Vertical
J11: FrontFans; Molex_MicroFit3.0_2x4xP3.00mm_PolarizingPeg_Vertical
J12: BackFans; Molex_MicroFit3.0_2x4xP3.00mm_PolarizingPeg_Vertical
J13: ErrorLightConnector; Molex_MicroFit3.0_1x2xP3.00mm_PolarizingPeg_Vertical
J14: Conn_01x03; PinHeader_1x02_P2.54mm_Vertical
JP1: Termination Resistors; PinHeader_1x02_P2.54mm_Vertical
L1, L4: 10uH; L_0805_2012Metric
L2, L3: 2kH; L_0805_2012Metric
L5, L6: 600; L_0805_2012Metric
MH1, MH2, MH3, MH4: MountingHole; MountingHole_3mm
Q1: VND5N07-E; TO-252-2
Q2, Q3, Q4: NVR4003NT3G; SOT-23
R1, R5: 1.5k; R_0805_2012Metric
R2, R3: 60; R_0805_2012Metric
R4, R9, R11, R43, R45: 0; R_0805_2012Metric
R6, R13, R14: 4.7k; R_0805_2012Metric
R7, R42: 470; R_0805_2012Metric
R8: 1k; R_0805_2012Metric
R10, R12, R44, R46: 100k; R_0805_2012Metric
R15, R18, R19, R20: 49.9; R_0805_2012Metric
R16, R21: 806; R_0805_2012Metric
R17, R22: 1.21k; R_0805_2012Metric
R23, R24, R25, R26, R27, R28, R29, R30, R31, R32, R33, R34, R35, R36, R37, R38, R39, R40: 50; R_0805_2012Metric
R41: 1.6k; R_0805_2012Metric
R47: 680; R_0805_2012Metric
R48, R49, R50, R51, R52, R53, R54: 750; R_0805_2012Metric
R57, R58: 220k; R_0805_2012Metric
SW1: B3SL-1002P; SW_SPST_B3SL-1002P
TP1: +12V_TP; TestPoint_Keystone_5005-5009_Compact
TP2: +5V_TP; TestPoint_Keystone_5005-5009_Compact
TP3: GND_TP; TestPoint_Keystone_5005-5009_Compact
TP4: +3.3V_TP; TestPoint_Keystone_5005-5009_Compact
TP5: CAN_ISO_Vout; TestPoint_Keystone_5005-5009_Compact
TP6: CAN_ISO_Vin; TestPoint_Keystone_5005-5009_Compact
TP7: CAN_ISO_GndIn; TestPoint_Keystone_5005-5009_Compact
TP8: CAN_ISO_GndOut; TestPoint_Keystone_5005-5009_Compact
TP9: CAN_H; TestPoint_Keystone_5005-5009_Compact
TP12: CAN_L; TestPoint_Keystone_5005-5009_Compact
TP13: ContactorGate_TP; TestPoint_Keystone_5005-5009_Compact
TP14: StrobeLightGate_TP; TestPoint_Keystone_5005-5009_Compact
TP15: GNDPWR_TP; TestPoint_Keystone_5005-5009_Compact
U1: STM32F413RHTx; LQFP-64_10x10mm_P0.5mm
U2, U15: RI3-1205S; RI3_DC_Converter
U3: NCP1117-3.3_SOT223; SOT-223-3_TabPin2
U4: CDSOT23-T24CAN; SOT-23W
U5: ADM3055E; SOIC-20W_7.5x15.4mm_Pitch1.27mm
U6: BAS70-04; SOT-23
U7, U16: SI8261ABC-IS; SOIC-8_3.9x4.9mm_P1.27mm
U8: M24128; M24128-BRMN6P
U10, U12: LTC6820; MSOP-16_3x4mm_P0.5mm
U11: HX1188FNL; HXXXX
U13: Si8641EC-B-IS1; SOIC-16_3.9x9.9mm_P1.27mm
U14: SI8660EC-B-IS1; SOIC-16_3.9x9.9mm_P1.27mm
Y1: NX8045GB-8.000M-STD-CSJ-1

Connections:
+3V3: C1.1, C2.1, C3.1, C4.1, C5.1, C6.1, C7.1, C9.1, C10.1, C18.1, C25.1, C26.1, C31.1, C36.1, C42.1, J10.1, J10.2, R13.1, R14.1, TP4.1, U1.1, U1.13, U1.19, U1.32, U1.48, U1.64, U3.2, U5.4, U8.8, U10.6, U10.7, U10.8, U12.6
+5V: C12.2, C15.2, C17.1, C23.1, C24.1, C38.1, C40.1, C43.1, C44.1, D5.2, J3.1, R1.1, R5.1, R6.2, R7.2, R42.2, TP2.1, U2.4, U3.3, U5.3, U6.2, U10.9, U10.12, U12.9, U12.12, U13.1, U13.7, U14.1
+5VL: C41.1, C45.1, C46.2, J9.1, U13.10, U13.16, U14.16, U15.4
+12V: C16.1, C27.2, C28.1, C29.1, C47.1, C48.2, C49.1, C50.1, D2.1, D4.1, J4.1, J6.1, J8.3, J11.1, J11.2, J11.3, J11.4, J12.1, J12.2, J12.3, J12.4, J13.1, L1.1, L4.1, TP1.1, U7.8, U16.8
/ADC1_CH2: C54.1, R58.2, U1.16
/ADC1_CH3: C53.1, R57.2, U1.17
/CAN1_RX: J2.4, U1.61, U5.5
/CAN1_TX: J2.2, U1.62, U5.7
/CAN/CAN_H: J5.3, R2.2, TP9.1, U4.1, U5.14
/CAN/CAN_L: J5.4, R3.2, TP12.1, U4.2, U5.13
/CAN/RSlope: R4.1, U5.12
/CAN/TERM_H: JP1.2, R2.1
/CAN/TERM_L: JP1.1, R3.1
/Contactor Driver/CONTACTOR_V-: D2.2, J6.2, Q1.2
/DISPLAY_CS: U1.59, U12.5
/FAULT: R45.2, U1.33
/I2C3_SCL: J14.1, R13.2, U1.41, U8.6
/I2C3_SDA: J14.2, R14.2, U1.40, U8.5
/LTC6811_CS: U1.58, U10.5
/NRST: C11.1, SW1.1, U1.7
/OSC_IN: C14.1, U1.5, Y1.2
/OSC_OUT: C13.1, U1.6, Y1.1
/PA5: D13.2, U1.21
/PA6: D12.2, U1.22
/PA7: D11.2, U1.23
/PB0: R11.2, U1.26
/PB1: C30.1, R8.1, U1.27, U6.3
/PC0: D10.2, U1.8
/PC1: D9.2, U1.9
/PC2: D8.2, U1.10
/PC3: D7.2, U1.11
/RUN: D6.2, U1.14
/SPI1_CLK: J2.6, R23.2, U1.55, U10.4, U12.4
/SPI1_MISO: J2.8, R27.2, U1.56, U10.3, U12.3
/SPI1_MOSI: J2.10, R25.2, U1.57, U10.2, U12.2
/SPI/CS1: J9.12, R30.1
/SPI/CS2: J9.11, R32.1
/SPI/CS3: J9.10, R34.1
/SPI/CS4: J9.9, R36.1
/SPI/CS5: J9.8, R38.1
/SPI/CS6: J9.7, R40.1
/SPI/DISP_IM: R18.1, U11.8, U12.10
/SPI/DISP_IP: R15.1, U11.6, U12.11
/SPI/DISP_PHA: J10.4, U12.8
/SPI/DISP_POL: J10.3, U12.7
/SPI/VOLT_IM: R20.1, U10.10, U11.3
/SPI/VOLT_IP: R19.1, U10.11, U11.1
/SWCLK: J1.3, U1.49
/SWDIO: J1.2, U1.46
/TEMP_CS1: R29.1, U1.34
/TEMP_CS2: R31.1, U1.35
/TEMP_CS3: R33.1, U1.36
/TEMP_CS4: R35.1, U1.37
/TEMP_CS5: R37.1, U1.38
/TEMP_CS6: R39.1, U1.39
/UART1_RX: J2.5, U1.43
/UART1_TX: J2.3, U1.42
GND: C1.2, C2.2, C3.2, C4.2, C5.2, C6.2, C7.2, C8.2, C9.2, C10.2, C11.2, C12.1, C13.2, C14.2, C17.2, C18.2, C23.2, C24.2, C25.2, C26.2, C30.2, C31.2, C34.2, C35.2, C36.2, C37.2, C38.2, C39.2, C40.2, C42.2, C43.2, C44.2, C53.2, C54.2, D1.1, J1.1, J2.1, J3.2, J6.3, J10.5, J10.6, Q2.2, Q4.2, R12.2, R17.1, R22.1, R46.2, R47.2, R48.2, R49.2, R50.2, R51.2, R52.2, R53.2, R54.2, SW1.2, TP3.1, U1.12, U1.18, U1.31, U1.47, U1.60, U1.63, U2.3, U3.1, U5.1, U5.2, U5.10, U6.1, U8.1, U8.2, U8.3, U8.4, U8.7, U10.1, U10.13, U10.14, U12.1, U12.13, U12.14, U13.2, U13.8, U14.8
GNDPWR: C16.2, C27.1, C28.2, C29.2, C47.2, C48.1, C49.2, C50.2, J4.2, J8.4, J11.5, J11.6, J11.7, J11.8, J12.5, J12.6, J12.7, J12.8, Q1.3, Q3.2, R10.2, R44.2, TP15.1, U2.1, U7.5, U15.1, U16.5
GND_A: C41.2, C45.2, J9.5, J9.6, U13.9, U13.15, U14.9, U15.3
unnamed: C8.1, U1.30
unnamed: C15.1, L1.2, U2.2
unnamed: C19.1, L2.2, TP5.1, U5.19
unnamed: C19.2, L3.2, TP8.1, U5.18, U5.20
unnamed: C20.1, C21.1, C22.1, J5.1, L2.1, TP6.1, U5.16
unnamed: C20.2, C21.2, C22.2, J5.2, L3.1, R4.2, TP7.1, U4.3, U5.11, U5.15
unnamed: C34.1, U11.7
unnamed: C35.1, R15.2, R18.2
unnamed: C37.1, U11.2
unnamed: C39.1, R19.2, R20.2
unnamed: C46.1, L4.2, U15.2
unnamed: D1.2, R1.2
unnamed: D3.1, Q2.3, U7.3
unnamed: D3.2, R5.2
unnamed: D4.2, J13.2, Q3.3
unnamed: D5.1, R41.1
unnamed: D6.1, R47.1
unnamed: D7.1, R48.1
unnamed: D8.1, R49.1
unnamed: D9.1, R50.1
unnamed: D10.1, R51.1
unnamed: D11.1, R52.1
unnamed: D12.1, R53.1
unnamed: D13.1, R54.1
unnamed: J3.3, L5.1
unnamed: J3.4, L6.1
unnamed: J6.4, R6.1, R8.2
unnamed: J7.1, U11.16
unnamed: J7.2, U11.14
unnamed: J8.1, U11.11
unnamed: J8.2, U11.9
unnamed: J9.2, R24.2
unnamed: J9.3, R26.2
unnamed: J9.4, R28.2
unnamed: L5.2, R57.1
unnamed: L6.2, R58.1
unnamed: Q1.1, R9.1, R10.1
unnamed: Q2.1, R11.1, R12.1
unnamed: Q3.1, R43.1, R44.1
unnamed: Q4.1, R45.1, R46.1
unnamed: Q4.3, R41.2, U16.3
unnamed: R7.1, U7.2
unnamed: R9.2, TP13.1, U7.6
unnamed: R16.1, R17.2, U10.15
unnamed: R16.2, U10.16
unnamed: R21.1, R22.2, U12.15
unnamed: R21.2, U12.16
unnamed: R23.1, U13.3
unnamed: R24.1, U13.14
unnamed: R25.1, U13.4
unnamed: R26.1, U13.13
unnamed: R27.1, U13.6
unnamed: R28.1, U13.11
unnamed: R29.2, U14.2
unnamed: R30.2, U14.15
unnamed: R31.2, U14.3
unnamed: R32.2, U14.14
unnamed: R33.2, U14.4
unnamed: R34.2, U14.13
unnamed: R35.2, U14.5
unnamed: R36.2, U14.12
unnamed: R37.2, U14.6
unnamed: R38.2, U14.11
unnamed: R39.2, U14.7
unnamed: R40.2, U14.10
unnamed: R42.1, U16.2
unnamed: R43.2, TP14.1, U16.6
