lhr-solar/BPS/Electronics/BPS/Temperature/BPSTemperature.kicad_pcb

## KiCad design Electronics/BPS/Temperature/BPSTemperature.kicad_pcb (2019-02-03, last stored version)

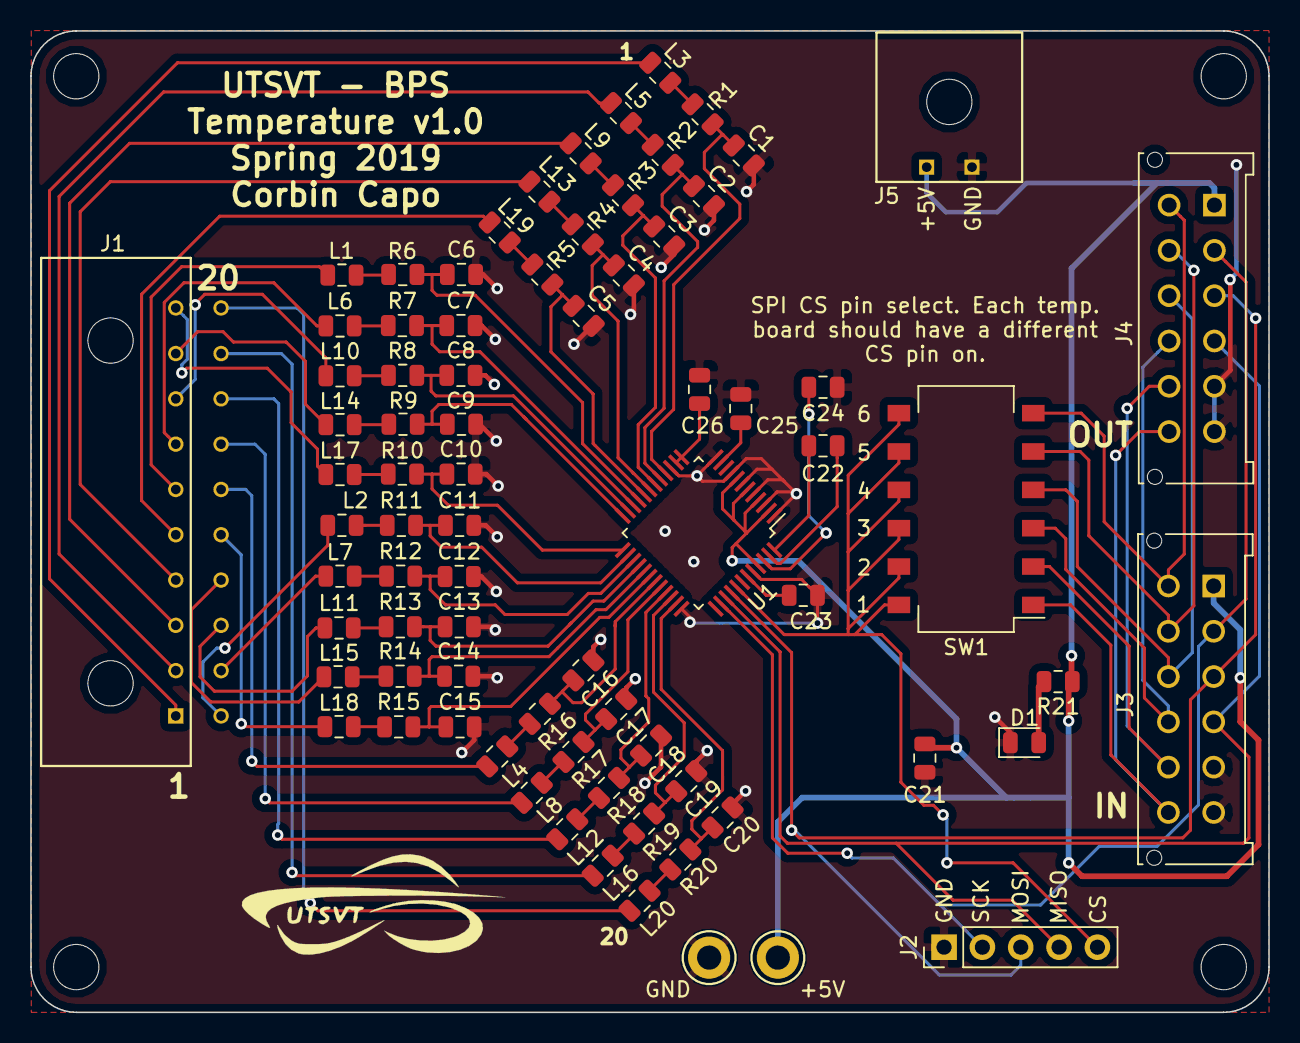
[picture p50: board BPSTemperature.kicad_pcb from above]

Board: 2 copper layers, 82.0 x 65.0 mm, 81 parts (0 on the bottom side), 79 nets.

Parts:
+5V: TestPoint; TestPoint_Keystone_5005-5009_Compact
C1, C2, C3, C4, C5, C6, C7, C8, C9, C10, C11, C12, C13, C14, C15, C16, C17, C18, C19, C20, C25, C26: 1uF; C_0805_2012Metric
C21: 0.1uF; C_0805_2012Metric
C22, C23, C24: 10uF; C_0805_2012Metric
D1: LED; LED_0805_2012Metric
GND: TestPoint; TestPoint_Keystone_5005-5009_Compact
J1: Conn_02x10_Counter_Clockwise; 02x10_Microfit_3.0_horizontal
J2: Logic Analyzer; PinHeader_1x05_P2.54mm_Vertical
J3, J4: Conn_02x06_Counter_Clockwise; Molex_MicroFit3.0_2x6xP3.00mm_PolarizingPeg_Vertical
J5: Conn_01x02; 43650-0202_01x02_Microfit 3.0_horizontal
L1, L2, L3, L4, L5, L6, L7, L8, L9, L10, L11, L12, L13, L14, L15, L16, L17, L18, L19, L20: Ferrite_Bead; L_0805_2012Metric
MH1, MH2, MH3, MH4: MountingHole; MountingHole_3mm
R1, R2, R3, R4, R5, R6, R7, R8, R9, R10, R11, R12, R13, R14, R15, R16, R17, R18, R19, R20: 1k; R_0805_2012Metric
R21: 1.55k; R_0805_2012Metric
SW1: SW_DIP_x06; SW_DIP_SPSTx06_Slide_Omron_A6S-610x_W8.9mm_P2.54mm
U1: LTC2983; LQFP-48_7x7mm_P0.5mm

Connections:
+5V: +5V.1, C21.2, J3.1, J4.1, J5.1, R21.1, U1.2, U1.4, U1.6, U1.8, U1.45
/CH1_LPF: J1.1, L3.2
/CH2_LPF: J1.2, L5.2
/CH3_LPF: J1.3, L9.2
/CH4_LPF: J1.4, L13.2
/CH5_LPF: J1.5, L19.2
/CH6_LPF: J1.6, L1.1
/CH7_LPF: J1.7, L6.1
/CH8_LPF: J1.8, L10.1
/CH9_LPF: J1.9, L14.1
/CH10_LPF: J1.10, L17.2
/CH11_LPF: J1.11, L2.1
/CH12_LPF: J1.12, L7.1
/CH13_LPF: J1.13, L11.1
/CH14_LPF: J1.14, L15.1
/CH15_LPF: J1.15, L18.1
/CH16_LPF: J1.16, L4.1
/CH17_LPF: J1.17, L8.1
/CH18_LPF: J1.18, L12.1
/CH19_LPF: J1.19, L16.1
/CH20_LPF: J1.20, L20.1
/CS1: J3.12, J4.12, SW1.1
/CS1_OUT: J2.5, SW1.7, SW1.8, SW1.9, SW1.10, SW1.11, SW1.12, U1.41
/CS2: J3.11, J4.11, SW1.2
/CS3: J3.10, J4.10, SW1.3
/CS4: J3.9, J4.9, SW1.4
/CS5: J3.8, J4.8, SW1.5
/CS6: J3.7, J4.7, SW1.6
/MISO: J2.4, J3.4, J4.4, U1.39
/MOSI: J2.3, J3.3, J4.3, U1.40
/SCK: J2.2, J3.2, J4.2, U1.38
GND: C1.2, C2.2, C3.2, C4.2, C5.2, C6.2, C7.2, C8.2, C9.2, C10.2, C11.2, C12.2, C13.2, C14.2, C15.2, C16.2, C17.2, C18.2, C19.2, C20.2, C21.1, C23.2, C24.2, C25.2, C26.2, D1.1, GND.1, J2.1, J3.5, J3.6, J4.5, J4.6, J5.2, U1.1, U1.3, U1.5, U1.7, U1.9, U1.12, U1.15, U1.36, U1.44
unnamed: C1.1, R1.2, U1.16
unnamed: C2.1, R2.2, U1.17
unnamed: C3.1, R3.2, U1.18
unnamed: C4.1, R4.2, U1.19
unnamed: C5.1, R5.2, U1.20
unnamed: C6.1, R6.2, U1.21
unnamed: C7.1, R7.2, U1.22
unnamed: C8.1, R8.2, U1.23
unnamed: C9.1, R9.2, U1.24
unnamed: C10.1, R10.2, U1.25
unnamed: C11.1, R11.2, U1.26
unnamed: C12.1, R12.2, U1.27
unnamed: C13.1, R13.2, U1.28
unnamed: C14.1, R14.2, U1.29
unnamed: C15.1, R15.2, U1.30
unnamed: C16.1, R16.2, U1.31
unnamed: C17.1, R17.2, U1.32
unnamed: C18.1, R18.2, U1.33
unnamed: C19.1, R19.2, U1.34
unnamed: C20.1, R20.2, U1.35
unnamed: C22.1, U1.48
unnamed: C22.2, U1.47
unnamed: C23.1, U1.43
unnamed: C24.1, U1.46
unnamed: C25.1, U1.11
unnamed: C26.1, U1.13, U1.14
unnamed: D1.2, R21.2
unnamed: L1.2, R6.1
unnamed: L2.2, R11.1
unnamed: L3.1, R1.1
unnamed: L4.2, R16.1
unnamed: L5.1, R2.1
unnamed: L6.2, R7.1
unnamed: L7.2, R12.1
unnamed: L8.2, R17.1
unnamed: L9.1, R3.1
unnamed: L10.2, R8.1
unnamed: L11.2, R13.1
unnamed: L12.2, R18.1
unnamed: L13.1, R4.1
unnamed: L14.2, R9.1
unnamed: L15.2, R14.1
unnamed: L16.2, R19.1
unnamed: L17.1, R10.1
unnamed: L18.2, R15.1
unnamed: L19.1, R5.1
unnamed: L20.2, R20.1
