lhr-solar/BPS/Electronics/MPPT/MPPT.kicad_pcb

## KiCad design Electronics/MPPT/MPPT.kicad_pcb (2018-12-08, last stored version)

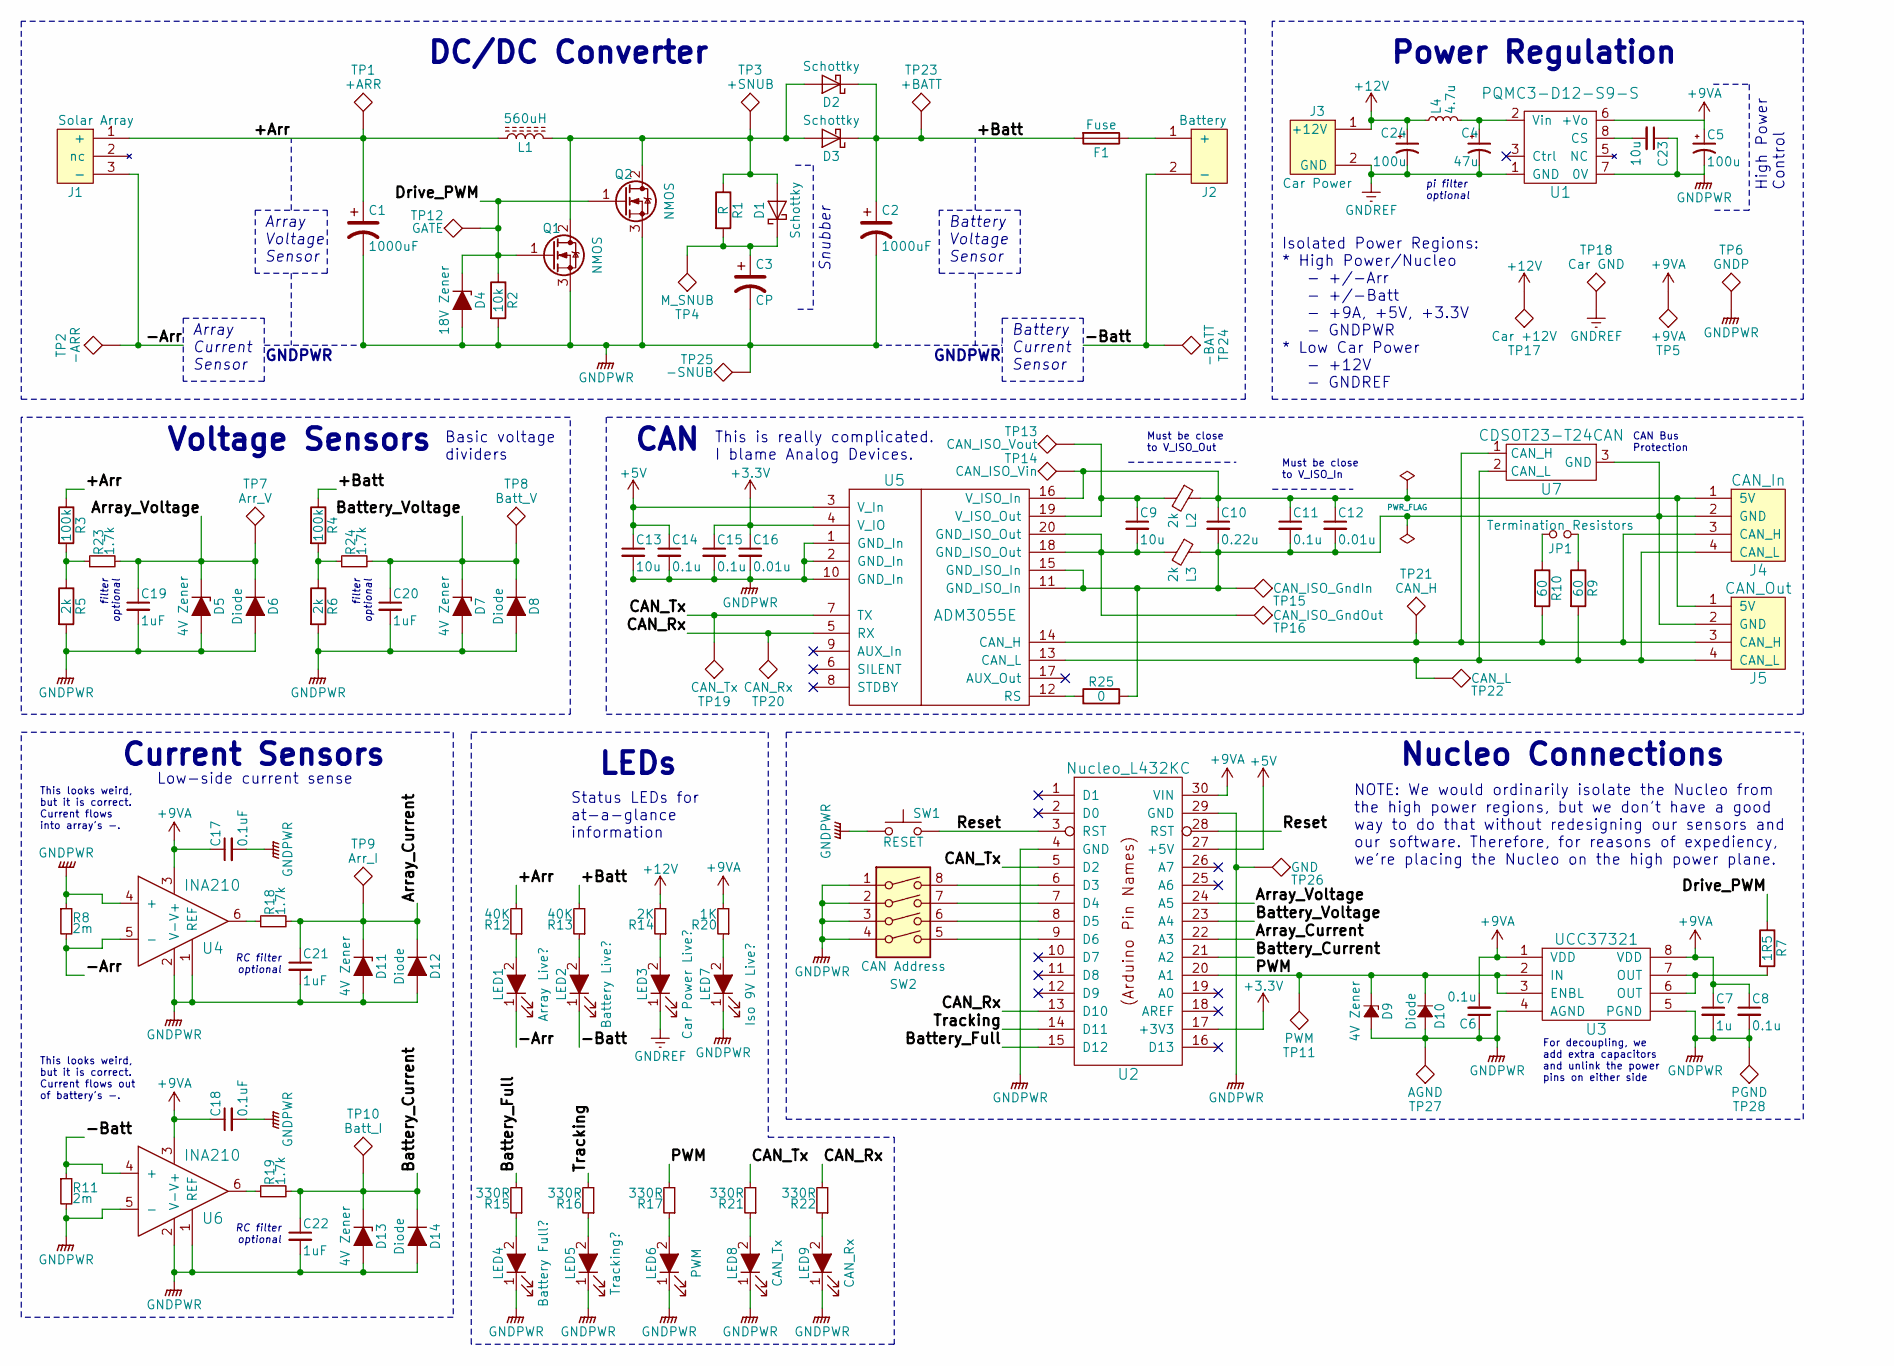
[picture p51: schematic MPPT.sch, UT SVT MPPT 2018]

Parts:
C1, C2: 1000uF; CP_Radial_D31mm_P9mm
C3: CP; C_Rect_L26.5mm_W17.0mm_P22.50mm_MKS4
C4: 47u; CP_Elec_6.3x5.3
C5, C24: 100u; CP_Elec_6.3x7.7
C6, C8, C11: 0.1u; C_0805_HandSoldering
C7: 1u; CP_Radial_D10.0mm_P5.00mm
C9, C23: 10u; C_0805_HandSoldering
C10: 0.22u; C_0805_HandSoldering
C12: 0.01u; C_0805_HandSoldering
C13: 10u; C_0805
C14, C15: 0.1u; C_0805
C16: 0.01u; C_0805
C17, C18: 0.1uF; C_0805_HandSoldering
C19, C20, C21, C22: 1uF; C_0805_HandSoldering
D1, D2, D3: Schottky; TO-220-2_Vertical
D4: 18V Zener; D_SMA_Handsoldering
D5, D7, D9, D11, D13: 4V Zener; D_SOD-123F
D6, D8, D10, D12, D14: Diode; D_SOD-123
F1: Fuse; LittelFuse_OMNIBLOK_520Series_PCB
J1: Solar Array; PhoenixContact_PowerCombicon5_GF_3x7.62mm
J2: Battery; PhoenixContact_PowerCombicon5_GF_2x7.62mm
J3: Car Power; Molex_MicroFit3.0_1x2xP3.00mm_PolarizingPeg_Vertical
J4: CAN_In; Molex_MicroFit3.0_1x4xP3.00mm_PolarizingPeg_Vertical
J5: CAN_Out; Molex_MicroFit3.0_1x4xP3.00mm_PolarizingPeg_Vertical
JP1: Termination Resistors; Pin_Header_Straight_1x02_Pitch2.54mm
L1: 560uH; L_Toroid_Vertical_L46.0mm_W19.1mm_P21.80mm_Bourns_5700
L2, L3: 2k; L_0805_HandSoldering
L4: 4.7u; L_0805_HandSoldering
LED1: Array Live?; LED_0805_HandSoldering
LED2: Battery Live?; LED_0805_HandSoldering
LED3: Car Power Live?; LED_0805_HandSoldering
LED4: Battery Full?; LED_0805_HandSoldering
LED5: Tracking?; LED_0805_HandSoldering
LED6: PWM; LED_0805_HandSoldering
LED7: Iso 9V Live?; LED_0805_HandSoldering
LED8: CAN_Tx; LED_0805_HandSoldering
LED9: CAN_Rx; LED_0805_HandSoldering
Q1, Q2: NMOS; TO-247_TO-3P_Vertical
R1: R; R_Axial_Power_L20.0mm_W6.4mm_P22.40mm
R2: 10k; R_1206_HandSoldering
R3, R4: 100k; R_1206_HandSoldering
R5, R6: 2k; R_1206_HandSoldering
R7: 1R5; R_1206_HandSoldering
R8, R11: 2m; R_2512_HandSoldering
R9, R10: 60; R_0805_HandSoldering
R12, R13: 40K; R_1206_HandSoldering
R14: 2K; R_0805_HandSoldering
R15, R16, R17, R21, R22: 330R; R_0805_HandSoldering
R18, R19, R23, R24: 1.7k; R_0805_HandSoldering
R20: 1K; R_0805_HandSoldering
R25: 0; R_0805_HandSoldering
SW1: RESET; SW_PUSH_6mm
SW2: CAN Address; SW_DIP_x4_W7.62mm_Slide_LowProfile
TP1: +ARR; Test_Point_Keystone_5005-5009_Compact
TP2: -ARR; Test_Point_Keystone_5005-5009_Compact
TP3: +SNUB; Test_Point_Keystone_5005-5009_Compact
TP4: M_SNUB; Test_Point_Keystone_5005-5009_Compact
TP5: +9VA; Test_Point_Keystone_5005-5009_Compact
TP6: GNDP; Test_Point_Keystone_5005-5009_Compact
TP7: Arr_V; Test_Point_Keystone_5005-5009_Compact
TP8: Batt_V; Test_Point_Keystone_5005-5009_Compact
TP9: Arr_I; Test_Point_Keystone_5005-5009_Compact
TP10: Batt_I; Test_Point_Keystone_5005-5009_Compact
TP11: PWM; Test_Point_Keystone_5005-5009_Compact
TP12: GATE; Test_Point_Keystone_5005-5009_Compact
TP13: CAN_ISO_Vout; Test_Point_Keystone_5005-5009_Compact
TP14: CAN_ISO_Vin; Test_Point_Keystone_5005-5009_Compact
TP15: CAN_ISO_GndIn; Test_Point_Keystone_5005-5009_Compact
TP16: CAN_ISO_GndOut; Test_Point_Keystone_5005-5009_Compact
TP17: Car +12V; Test_Point_Keystone_5005-5009_Compact
TP18: Car GND; Test_Point_Keystone_5005-5009_Compact
TP19: CAN_Tx; Test_Point_Keystone_5005-5009_Compact
TP20: CAN_Rx; Test_Point_Keystone_5005-5009_Compact
TP21: CAN_H; Test_Point_Keystone_5005-5009_Compact
TP22: CAN_L; Test_Point_Keystone_5005-5009_Compact
TP23: +BATT; Test_Point_Keystone_5005-5009_Compact
TP24: -BATT; Test_Point_Keystone_5005-5009_Compact
TP25: -SNUB; Test_Point_Keystone_5005-5009_Compact
TP26: GND; Test_Point_Keystone_5005-5009_Compact
TP27: AGND; Test_Point_Keystone_5005-5009_Compact
TP28: PGND; Test_Point_Keystone_5005-5009_Compact
U1: PQMC3-D12-S9-S; CUI_PQMC3-S
U2: Nucleo_L432KC; NucleoL432KC
U3: UCC37321; SOIC-8_4.00x5.00mm_Pitch1.27mm
U4, U6: INA210; SOIC-6_1.40x2.15mm_Pitch0.65mm
U5: ADM3055E; SOIC-20W_7.5x15.4mm_Pitch1.27mm
U7: CDSOT23-T24CAN; SOT-23W_Handsoldering

Connections:
+3V3: C15.1, C16.1, U2.17 (+3V3), U5.4 (V_IO)
+5V: C13.1, C14.1, U2.27 (+5V), U5.3 (V_In)
+9VA: C5.1, C6.2, C7.1, C8.1, C17.1, C18.1, R20.2, TP5.1, U1.6 (+Vo), U2.30 (VIN), U3.1 (VDD), U3.8 (VDD), U4.3 (V+), U6.3 (V+)
+12V: C24.1, J3.1 (+12V), L4.1, R14.2, TP17.1
/+Arr: C1.1, J1.1 (+), L1.1, R3.1, R12.2, TP1.1
/+Batt: C2.1, D2.1 (K), D3.1 (K), F1.2, R4.1, R13.2, TP23.1
/-Arr: J1.3 (-), LED1.1 (K), R8.2, TP2.1, U4.5 (-)
/-Batt: J2.2 (-), LED2.1 (K), R11.1, TP24.1, U6.4 (+)
/Array_Current: C21.1, D11.1 (K), D12.1 (K), R18.2, TP9.1, U2.22 (A3)
/Array_Voltage: C19.1, D5.1 (K), D6.1 (K), R23.2, TP7.1, U2.24 (A5)
/Battery_Current: C22.1, D13.1 (K), D14.1 (K), R19.2, TP10.1, U2.21 (A2)
/Battery_Full: R15.2, U2.15 (D12)
/Battery_Voltage: C20.1, D7.1 (K), D8.1 (K), R24.2, TP8.1, U2.23 (A4)
/CAN_Rx: R22.2, TP20.1, U2.13 (D10), U5.5 (RX)
/CAN_Tx: R21.2, TP19.1, U2.5 (D2), U5.7 (TX)
/Drive_PWM: D4.1 (K), Q1.1 (G), Q2.1 (G), R2.1, R7.1, TP12.1
/PWM: D9.1 (K), D10.1 (K), R17.2, TP11.1, U2.20 (A1), U3.2 (IN), U3.3 (ENBL)
/Reset: SW1.2, U2.3 (RST), U2.28 (RST)
/Tracking: R16.2, U2.14 (D11)
GNDPWR: C1.2, C2.2, C3.2, C5.2, C6.1, C7.2, C8.2, C13.2, C14.2, C15.2, C16.2, C17.2, C18.2, C19.2, C20.2, C21.2, C22.2, C23.1, D4.2 (A), D5.2 (A), D6.2 (A), D7.2 (A), D8.2 (A), D9.2 (A), D10.2 (A), D11.2 (A), D12.2 (A), D13.2 (A), D14.2 (A), LED4.1 (K), LED5.1 (K), LED6.1 (K), LED7.1 (K), LED8.1 (K), LED9.1 (K), Q1.3 (S), Q2.3 (S), R2.2, R5.2, R6.2, R8.1, R11.2, SW1.1, SW2.1, SW2.2, SW2.3, SW2.4, TP6.1, TP25.1, TP26.1, TP27.1, TP28.1, U1.7 (0V), U2.4 (GND), U2.29 (GND), U3.4 (AGND), U3.5 (PGND), U4.1 (REF), U4.2 (V-), U4.4 (+), U5.1 (GND_In), U5.2 (GND_In), U5.10 (GND_In), U6.1 (REF), U6.2 (V-), U6.5 (-)
GNDREF: C4.2, C24.2, J3.2 (GND), LED3.1 (K), TP18.1, U1.1 (GND)
unnamed: C3.1, D1.1 (K), R1.2, TP4.1
unnamed: C4.1, L4.2, U1.2 (Vin)
unnamed: C9.1, L2.2, TP13.1, U5.19 (V_ISO_Out)
unnamed: C9.2, L3.2, TP16.1, U5.18 (GND_ISO_Out), U5.20 (GND_ISO_Out)
unnamed: C10.1, C11.1, C12.1, J4.1 (5V), J5.1 (5V), L2.1, TP14.1, U5.16 (V_ISO_In)
unnamed: C10.2, C11.2, C12.2, J4.2 (GND), J5.2 (GND), L3.1, R25.2, TP15.1, U5.11 (GND_ISO_In), U5.15 (GND_ISO_In), U7.3 (GND)
unnamed: C23.2, U1.8 (CS)
unnamed: D1.2 (A), D2.2 (A), D3.2 (A), L1.2, Q1.2 (D), Q2.2 (D), R1.1, TP3.1
unnamed: F1.1, J2.1 (+)
unnamed: J4.3 (CAN_H), J5.3 (CAN_H), R10.2, TP21.1, U5.14 (CAN_H), U7.1 (CAN_H)
unnamed: J4.4 (CAN_L), J5.4 (CAN_L), R9.2, TP22.1, U5.13 (CAN_L), U7.2 (CAN_L)
unnamed: JP1.1, R9.1
unnamed: JP1.2, R10.1
unnamed: LED1.2 (A), R12.1
unnamed: LED2.2 (A), R13.1
unnamed: LED3.2 (A), R14.1
unnamed: LED4.2 (A), R15.1
unnamed: LED5.2 (A), R16.1
unnamed: LED6.2 (A), R17.1
unnamed: LED7.2 (A), R20.1
unnamed: LED8.2 (A), R21.1
unnamed: LED9.2 (A), R22.1
unnamed: R7.2, U3.6 (OUT), U3.7 (OUT)
unnamed: R18.1, U4.6
unnamed: R19.1, U6.6
unnamed: R3.2, R5.1, R23.1
unnamed: R4.2, R6.1, R24.1
unnamed: R25.1, U5.12 (RS)
unnamed: SW2.5, U2.9 (D6)
unnamed: SW2.6, U2.8 (D5)
unnamed: SW2.7, U2.7 (D4)
unnamed: SW2.8, U2.6 (D3)

Notes on the sheet:
DC/DC Converter
Current Sensors
Voltage Sensors
Power Regulation
Nucleo Connections
Array Current Sensor
Array Voltage Sensor
Snubber
Battery Current Sensor
Battery Voltage Sensor
Isolated Power Regions: * High Power/Nucleo - +/-Arr - +/-Batt - +9A, +5V, +3.3V - GNDPWR * Low Car Power - +12V - GNDREF
High Power Control
GNDPWR
This looks weird, but it is correct. Current flows into array's -.
This looks weird, but it is correct. Current flows out of battery's -.
Basic voltage dividers
Low-side current sense
NOTE: We would ordinarily isolate the Nucleo from the high power regions, but we don't have a good way to do that without redesigning our sensors and our software. Therefore, for reasons of expediency, we're placing the Nucleo on the high power plane.
CAN
This is really complicated. I blame Analog Devices.
Must be close to V_ISO_Out
Must be close to V_ISO_In
For decoupling, we add extra capacitors and unlink the power pins on either side
LEDs
Status LEDs for at-a-glance information
RC filter optional
CAN Bus Protection
filter optional
pi filter optional

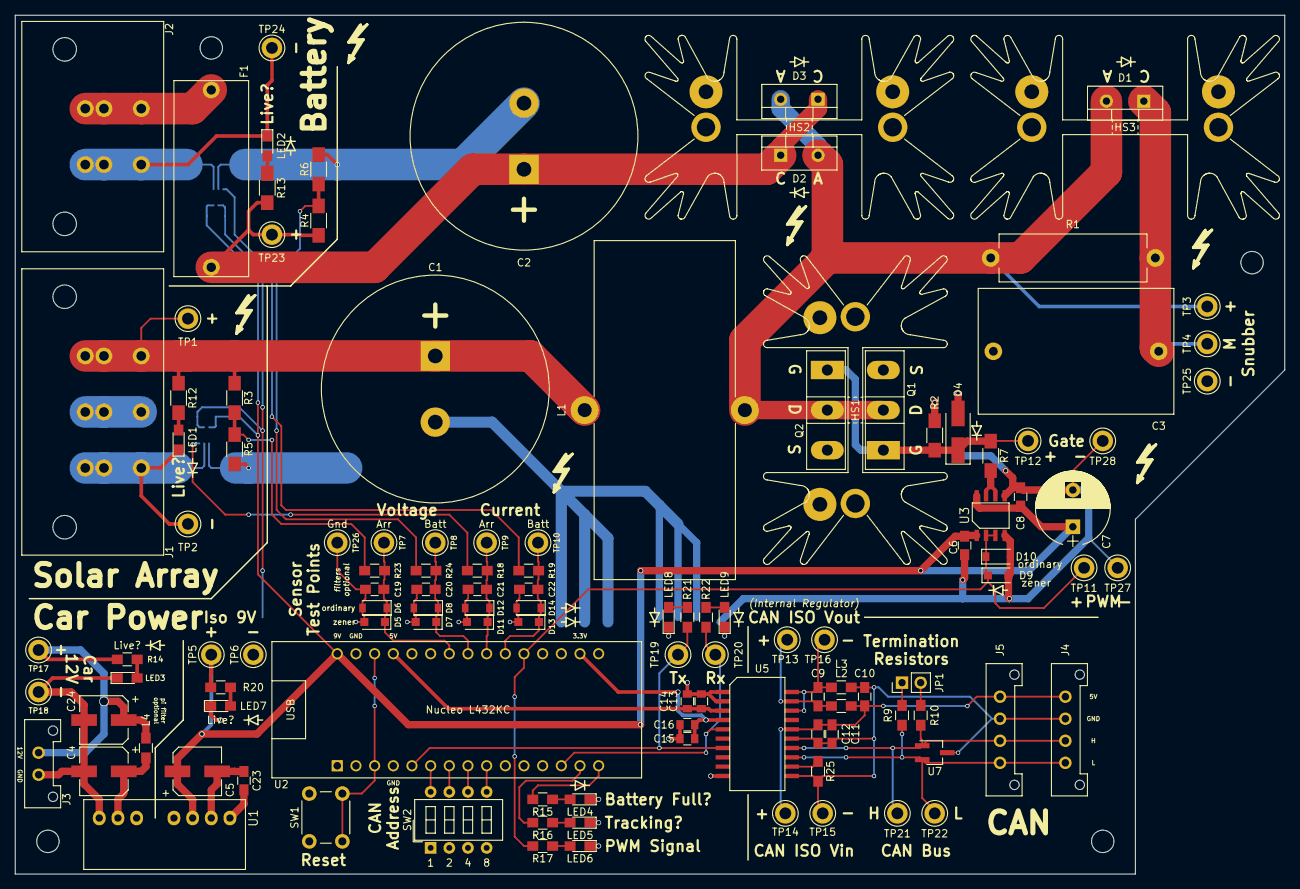
[picture p52: board MPPT.kicad_pcb from above]

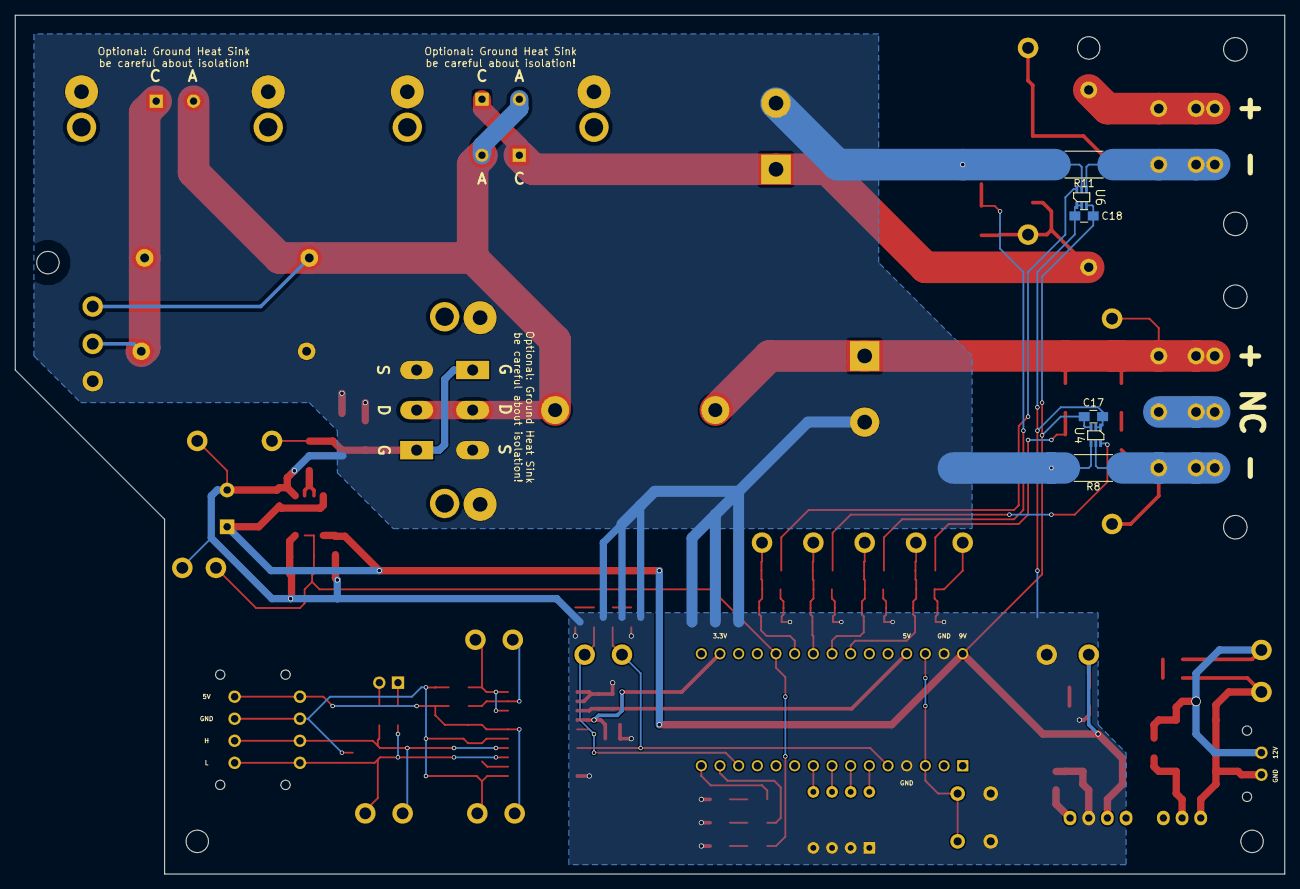
[picture p53: board MPPT.kicad_pcb from below]

Board: 2 copper layers, 172.7 x 116.8 mm, 125 parts (6 on the bottom side), 53 nets.

Other parts of the board:
HS1, HS2, HS3: Heatsink_Fischer_SK129-STS_42x25mm_2xDrill2.5mm
