lhr-solar/BPS/Electronics/CAN Snooper/Nucleo_CAN.kicad_pcb

## KiCad design Electronics/Nucleo CAN/Nucleo_CAN.kicad_pcb (2018-04-24, last stored version)

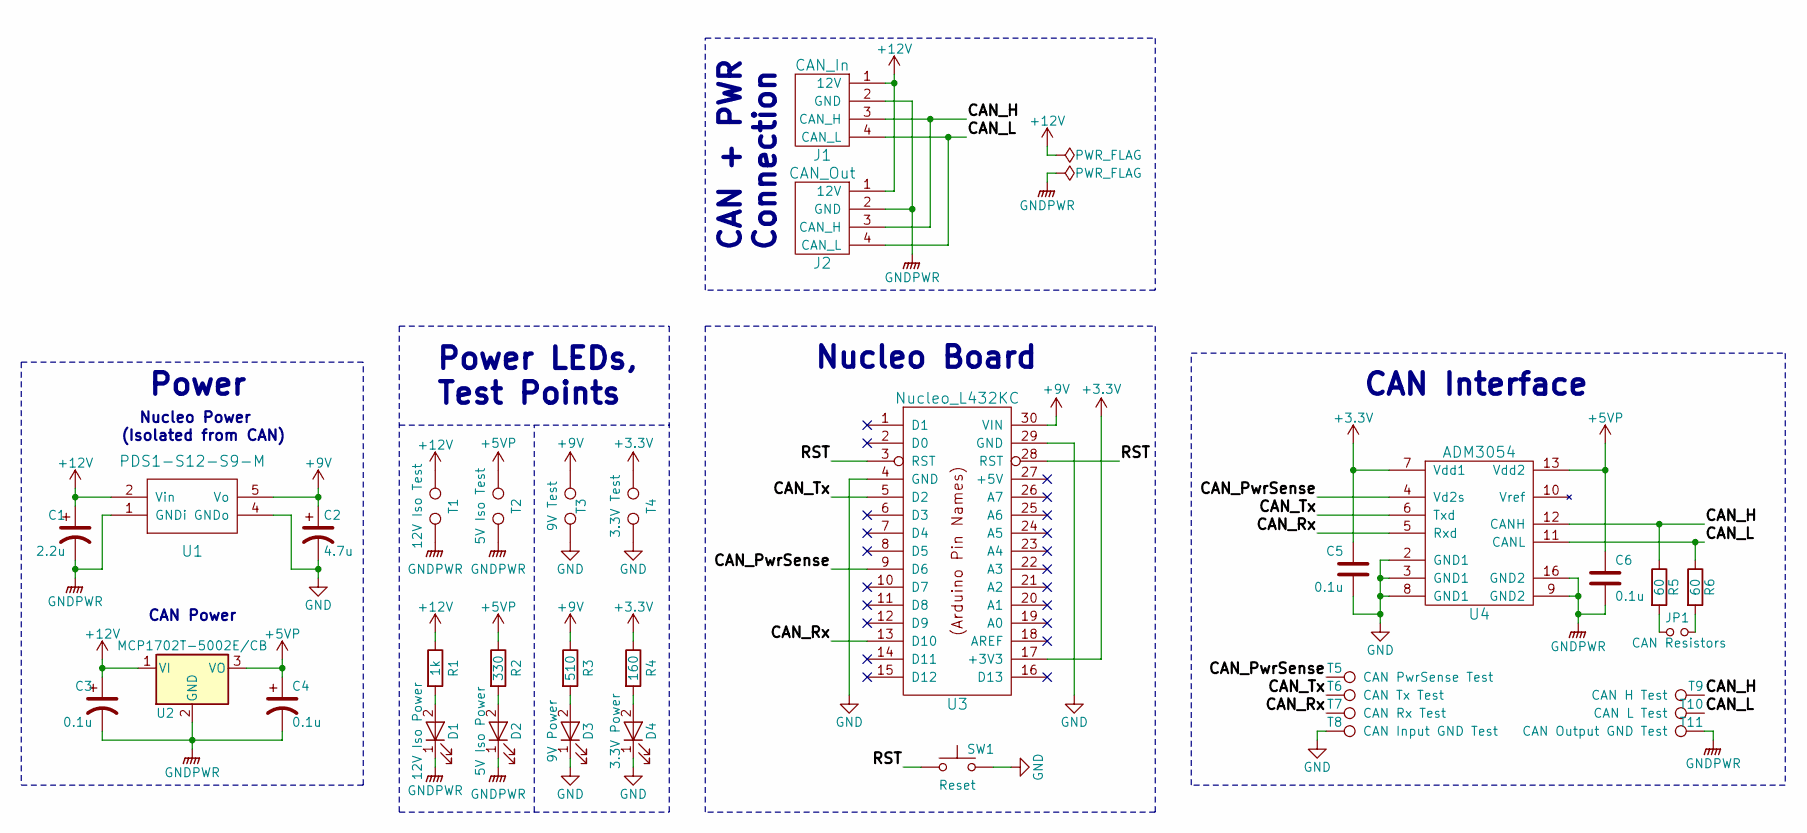
[picture p54: schematic Nucleo_CAN.sch, Nucleo-CAN Interface]

Parts:
C1: 2.2u; C_0805_HandSoldering
C2: 4.7u; C_0805_HandSoldering
C3, C4, C5, C6: 0.1u; C_0805_HandSoldering
D1: 12V Iso Power; LED_0805_HandSoldering
D2: 5V Iso Power; LED_0805_HandSoldering
D3: 9V Power; LED_0805_HandSoldering
D4: 3.3V Power; LED_0805_HandSoldering
J1: CAN_In; Molex-MiniFitJr-4-peg
J2: CAN_Out; Molex-MiniFitJr-4-peg
JP1: CAN Resistors; SL-102-X-XX_1x02
R1: 1k; R_0805_HandSoldering
R2: 330; R_0805_HandSoldering
R3: 510; R_0805_HandSoldering
R4: 160; R_0805_HandSoldering
R5, R6: 60; R_0805_HandSoldering
SW1: Reset; SW_PUSH_6mm
T1: 12V Iso Test; Measurement_Point_2_Round-SMD-Pad_Small
T2: 5V Iso Test; Measurement_Point_2_Round-SMD-Pad_Small
T3: 9V Test; Measurement_Point_2_Round-SMD-Pad_Small
T4: 3.3V Test; Measurement_Point_2_Round-SMD-Pad_Small
T5: CAN PwrSense Test; Measurement_Point_Round-SMD-Pad_Small
T6: CAN Tx Test; Measurement_Point_Round-SMD-Pad_Small
T7: CAN Rx Test; Measurement_Point_Round-SMD-Pad_Small
T8: CAN Input GND Test; Measurement_Point_Round-SMD-Pad_Small
T9: CAN H Test; Measurement_Point_Round-SMD-Pad_Small
T10: CAN L Test; Measurement_Point_Round-SMD-Pad_Small
T11: CAN Output GND Test; Measurement_Point_Round-SMD-Pad_Small
U1: PDS1-S12-S9-M; PDS1-M
U2: MCP1702T-5002E/CB; SOT-23W
U3: Nucleo_L432KC; NucleoL432KC
U4: ADM3054; SOIC-16W_7.5x10.3mm_Pitch1.27mm

Connections:
+3V3: C5.1, R4.1, T4.1, U3.17 (+3V3), U4.7 (Vdd1)
+5VP: C4.1, C6.1, R2.1, T2.1, U2.3 (VO), U4.13 (Vdd2)
+9V: C2.1, R3.1, T3.1, U1.5 (Vo), U3.30 (VIN)
+12V: C1.1, C3.1, J1.1 (12V), J2.1 (12V), R1.1, T1.1, U1.2 (Vin), U2.1 (VI)
/CAN_H: J1.3 (CAN_H), J2.3 (CAN_H), R5.1, T9.1, U4.12 (CANH)
/CAN_L: J1.4 (CAN_L), J2.4 (CAN_L), R6.1, T10.1, U4.11 (CANL)
/CAN_PwrSense: T5.1, U3.9 (D6), U4.4 (Vd2s)
/CAN_Rx: T7.1, U3.13 (D10), U4.5 (Rxd)
/CAN_Tx: T6.1, U3.5 (D2), U4.6 (Txd)
/RST: SW1.1, U3.3 (RST), U3.28 (RST)
GND: C2.2, C5.2, D3.1 (K), D4.1 (K), SW1.2, T3.2, T4.2, T8.1, U1.4 (GNDo), U3.4 (GND), U3.29 (GND), U4.2 (GND1), U4.3 (GND1), U4.8 (GND1)
GNDPWR: C1.2, C3.2, C4.2, C6.2, D1.1 (K), D2.1 (K), J1.2 (GND), J2.2 (GND), T1.2, T2.2, T11.1, U1.1 (GNDi), U2.2 (GND), U4.9 (GND2), U4.16 (GND2)
unnamed: D1.2 (A), R1.2
unnamed: D2.2 (A), R2.2
unnamed: D3.2 (A), R3.2
unnamed: D4.2 (A), R4.2
unnamed: JP1.1, R5.2
unnamed: JP1.2, R6.2

Notes on the sheet:
Power LEDs, Test Points
Power
Nucleo Power
CAN Power
(Isolated from CAN)
CAN Interface
Nucleo Board
CAN + PWR Connection

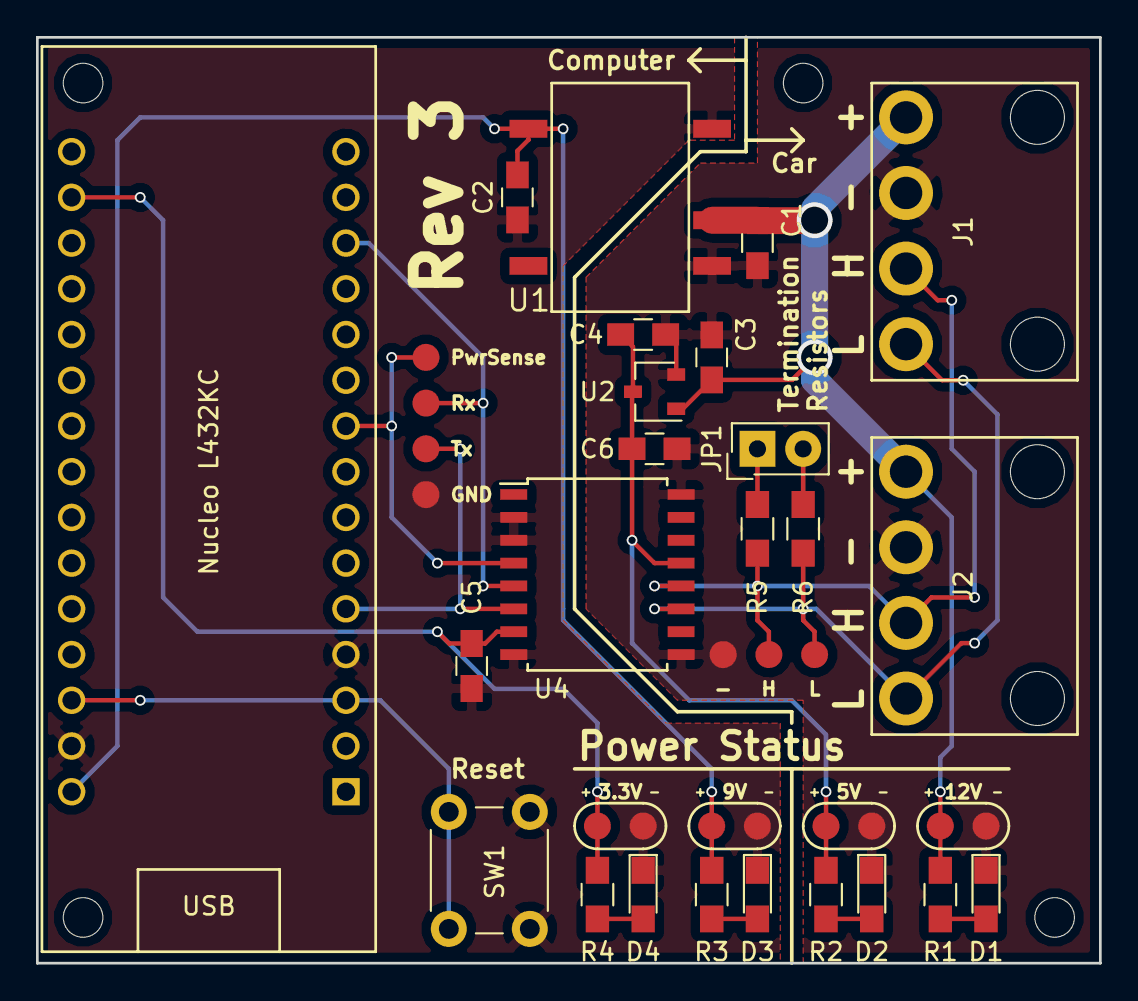
[picture p55: board Nucleo_CAN.kicad_pcb from above]

Board: 2 copper layers, 59.1 x 51.4 mm, 35 parts (0 on the bottom side), 18 nets.
