lhr-solar/BPS/Apps/Src/FaultState.c

/* Copyright (c) 2018-2022 UT Longhorn Racing Solar */
#include "Tasks.h"
#include "Contactor.h"
#include "BSP_Lights.h"
#include "Voltage.h"
#include "Fans.h"
#include "Temperature.h"
#include "Amps.h"
// #include "EEPROM.h"
#include "BSP_WDTimer.h"
#include "CLI.h"
#include "CANbus.h"
#include "BSP_UART.h"
#include "config.h"
#include "BSP_PLL.h"
#ifdef SIMULATION
#include "Simulator.h"
extern uint8_t stateCount;
#endif

struct FaultToOut_t {
    Light light; 
    char* string;
};

static const struct FaultToOut_t FaultDict[FAULT_MAX] = {
    [Fault_UVOLT]       = {.light = UVOLT, .string = "UVOLT"}, //do not have enough led's so some are reused
    [Fault_OVOLT]       = {.light = OVOLT, .string = "OVOLT"},
    [Fault_OTEMP]       = {.light = OTEMP, .string = "OTEMP"},
    [Fault_OCURR]       = {.light = OCURR, .string = "OCURR"},
    [Fault_OW]          = {.light = WIRE, .string = "OW"},
    [Fault_HANDLER]     = {.light = EXTRA, .string = "HANDLER"},
    [Fault_OS]          = {.light = EXTRA, .string = "OS"},
    [Fault_WDOG]        = {.light = WDOG, .string = "WDOG"},
    [Fault_CRC]         = {.light = CAN, .string = "CRC"},
    [Fault_ESTOP]       = {.light = WIRE, .string = "ESTOP"}
};

typedef enum {
    CAN_FAULT_NONE = 0,
    CAN_Fault_UVOLT = 1,
    CAN_Fault_OVOLT = 2,
    CAN_Fault_OTEMP = 3,
    CAN_Fault_OCURR = 4,
    CAN_Fault_OW = 5,
    CAN_Fault_HANDLER = 6,
    CAN_Fault_OS = 7,
    CAN_Fault_WDOG = 8,
    CAN_Fault_CRC = 9,
    CAN_Fault_ESTOP = 10,
    CAN_Fault_CONTACTOR_FAULT = 11,
    CAN_Fault_MPPT_FAULT = 12
}Fault_CAN_message_t;

/**
 * @brief Assembly to create ms delay 
 */
static inline void delay_ms(uint32_t ms) {
    // Adjusted loop count per ms based on empirical timing
    // Originally: 20,000 per ms (80,000 cycles / 4 cycles/iter)
    // Observed: ~3.77× slower → need ~5300 iterations per ms
    uint32_t count = ms * 5300;

    __asm__ volatile (
        "1: \n"
        "subs %[cnt], %[cnt], #1 \n"
        "bne 1b \n"
        : [cnt] "+r" (count)
        :
        : "cc"
    );
}

/*
 * Note: do not call this directly if it can be helped.
 * Instead, call an RTOS function to unblock the mutex
 * that the Fault Task is pending on.
 */
void EnterFaultState() {

#ifndef SIMULATION
    __disable_irq();
#else
    OS_ERR oserr;
    OSSchedLock(&oserr);
    assertOSError(oserr);
#endif

    if (Fault_Flag) { //if we are re-entering this function
        Fault_BitMap |= Fault_OS;
    }
    else {
        Fault_Flag = 1; //set fault flag to 1 so data can be accessed without OS functions
    }

    // Turn Contactor Off
    Contactor_Init();
    Contactor_Off(HVHIGH_CONTACTOR);
    Contactor_Off(ARRAY_CONTACTOR);
    Contactor_Off(HVLOW_CONTACTOR);
    //Set Fans to full speed
    Fans_Init();
    Fans_SetAll(TOPSPEED);
    // Turn Strobe Light On
    // Turn LEDs On
    BSP_Lights_Init();
    BSP_Light_Off(RUN); //turn off run light
    BSP_Light_On(FAULT);

    if (BSP_WDTimer_DidSystemReset()) {
        Fault_BitMap = Fault_WDOG;
    }

    #ifdef SIMULATION
    char err[100] = {0};
    #endif
    for (uint16_t i = 1; i < FAULT_MAX; i <<= 1){
        if (Fault_BitMap & i) {
            #ifdef SIMULATION
                sprintf(err, "$$$ Entered fault in state {%d} - %s\n", stateCount - 1, FaultDict[i].string);
                Simulator_Log_Location(LOG_INFO, err);
            #endif
            BSP_Light_On(FaultDict[i].light); //allow multiple lights to be turned on
        }
    }

    //Deinitialize CAN registers
    CANbus_DeInit();
    //Reinit CAN in fault state
    CANbus_Init(BPS_CAN_LOOPBACK, true, NULL, 0);

#ifdef DEBUGMODE
    char command[COMMAND_SIZE];
#endif
    BSP_WDTimer_Init(true); //re-initialize for fault state
    BSP_WDTimer_Start();
    uint32_t i = 0;
    while(1) {
        //toggle run led when in fault state -- divide by 10 makes the blink speed ok
        if (i % 10 == 0) BSP_Light_Toggle(RUN);
        i++;
        //Send Trip Readings
        CANPayload_t payload;
        payload.data.w = 1;
        CANbus_SendMsg_FaultState(BPS_TRIP, payload);

        //Send MPPT to disable boosting
        payload.data.b = 0;
        CANbus_SendMsg_FaultState(MPPT_A_BOOST_ENABLE, payload);

        payload.data.b = 0;
        CANbus_SendMsg_FaultState(MPPT_B_BOOST_ENABLE, payload);

        //Send Contactor Readings
        payload.data.b = 0;
        CANbus_SendMsg_FaultState(BPS_CONTACTOR_STATE, payload);

        //Send All Clear False
        payload.data.b = 0;
        CANbus_SendMsg_FaultState(BPS_ALL_CLEAR, payload);
        
        //Send Current Readings
        payload.data.w = Amps_GetReading(false);
        CANbus_SendMsg_FaultState(CURRENT_DATA, payload);
        
        //Send Voltage Readings
        for (uint8_t i = 0; i < NUM_BATTERY_MODULES; i++){ //send all battery module voltage data
            payload.idx = i;
            payload.data.w = Voltage_GetModuleMillivoltage(i);
            CANbus_SendMsg_FaultState(VOLTAGE_DATA_ARRAY, payload);
        }

        //Send Temperature Readings
        for (uint8_t i = 0; i < NUM_BATTERY_MODULES; i++){ //send all battery module temperature data
            payload.idx = i;
            payload.data.w = Temperature_GetModuleTemperature(i);
            CANbus_SendMsg_FaultState(TEMPERATURE_DATA_ARRAY, payload);
        }

        // Send FAULT ID
        switch(Fault_BitMap){
            case Fault_UVOLT:
                payload.data.b = CAN_Fault_UVOLT;
                break;
            case Fault_OVOLT:
                payload.data.b = CAN_Fault_OVOLT;
                break;
            case Fault_OTEMP:
                payload.data.b = CAN_Fault_OTEMP;
                break;
            case Fault_OCURR:
                payload.data.b = CAN_Fault_OCURR;
                break;
            case Fault_OW:
                payload.data.b = CAN_Fault_OW;
                break;
            case Fault_HANDLER:
                payload.data.b = CAN_Fault_HANDLER;
                break;
            case Fault_OS:
                payload.data.b = CAN_Fault_OS;
                break;
            case Fault_WDOG:
                payload.data.b = CAN_Fault_WDOG;
                break;
            case Fault_CRC:
                payload.data.b = CAN_Fault_CRC;
                break;
            case Fault_ESTOP:
                payload.data.b = CAN_Fault_ESTOP;
                break;
            default:
                payload.data.b = CAN_FAULT_NONE;
                break;
        }
        CANbus_SendMsg_FaultState(BPS_FAULT_STATE, payload);


        BSP_WDTimer_Reset(); // WDOG Reset
#ifdef SIMULATION
        Simulator_Log(LOG_INFO, "Completed fault state\n");
        Simulator_Shutdown(0);
#endif
        // Wait for 1000ms
        delay_ms(100);
    }
}

// Rebind all the possible fault handlers to the fault state
void NMI_Handler()        { Fault_BitMap = Fault_HANDLER; EnterFaultState(); }
void HardFault_Handler()  { Fault_BitMap = Fault_HANDLER; EnterFaultState(); }
void MemManage_Handler()  { Fault_BitMap = Fault_HANDLER; EnterFaultState(); }
void BusFault_Handler()   { Fault_BitMap = Fault_HANDLER; EnterFaultState(); }
void UsageFault_Handler() { Fault_BitMap = Fault_HANDLER; EnterFaultState(); }
