lhr-solar/BPS/BPS/V3 - term(BeVolt)/config.TXT

   Address    Value   Field                    Category                                           Setting                       

   F80000     C302  FOSFPR  Oscillator                                    HS                                                    
                    FCKSMEN Clock Switching and Monitor                   Sw Disabled, Mon Disabled                             
   F80002     003F  FWPSB   WDT Prescaler B                               1:16                                                  
                    FWPSA   WDT Prescaler A                               1:512                                                 
                    WDT     Watchdog Timer                                Disabled                                              
   F80004     87B3  FPWRT   POR Timer Value                               64ms                                                  
                    BODENV  Brown Out Voltage                             Reserved                                              
                    BOREN   PBOR Enable                                   Enabled                                               
                    MCLRE   Master Clear Enable                           Enabled                                               
   F80006     310F  BWRP    Boot Segment Program Memory Write Protect     Boot Segment Program Memory may be written            
                    BSS     Boot Segment Program Flash Memory Code ProtectionNo Boot Segment                                       
                    EBS     Boot Segment Data EEPROM Protection           No Boot EEPROM                                        
                    RBS     Boot Segment Data RAM Protection              No Boot RAM                                           
   F80008     330F  SWRP    Secure Segment Program Write Protect          Disabled                                              
                    SSS     Secure Segment Program Flash Memory Code ProtectionNo Secure Segment                                     
                    ESS     Secure Segment Data EEPROM Protection         No Segment Data EEPROM                                
                    RSS     Secure Segment Data RAM Protection            No Secure RAM                                         
   F8000A     0007  GWRP    General Code Segment Write Protect            Disabled                                              
                    GCP     General Segment Code Protection               Disabled                                              
   F8000C     4003  ICS     Comm Channel Select                           Use PGC/EMUC and PGD/EMUD                             
