lhr-solar/BPS/BPS/V3 - term(BeVolt)/buildFiles/p30F6012A.h

/*-------------------------------------------------------------------------
 * MPLAB-Cxx  dsPIC30F6012A processor header
 *
 * (c) Copyright 1999-2011 Microchip Technology, All rights reserved
 *-------------------------------------------------------------------------*/

#ifndef __dsPIC30F6012A__
#error "Include file does not match processor setting"
#endif

#ifndef __30F6012A_H
#define __30F6012A_H

extern volatile unsigned int  WREG0 __attribute__((__sfr__,__deprecated__,__unsafe__));
extern volatile unsigned int  WREG1 __attribute__((__sfr__,__deprecated__,__unsafe__));
extern volatile unsigned int  WREG2 __attribute__((__sfr__,__deprecated__,__unsafe__));
extern volatile unsigned int  WREG3 __attribute__((__sfr__,__deprecated__,__unsafe__));
extern volatile unsigned int  WREG4 __attribute__((__sfr__,__deprecated__,__unsafe__));
extern volatile unsigned int  WREG5 __attribute__((__sfr__,__deprecated__,__unsafe__));
extern volatile unsigned int  WREG6 __attribute__((__sfr__,__deprecated__,__unsafe__));
extern volatile unsigned int  WREG7 __attribute__((__sfr__,__deprecated__,__unsafe__));
extern volatile unsigned int  WREG8 __attribute__((__sfr__,__deprecated__,__unsafe__));
extern volatile unsigned int  WREG9 __attribute__((__sfr__,__deprecated__,__unsafe__));
extern volatile unsigned int  WREG10 __attribute__((__sfr__,__deprecated__,__unsafe__));
extern volatile unsigned int  WREG11 __attribute__((__sfr__,__deprecated__,__unsafe__));
extern volatile unsigned int  WREG12 __attribute__((__sfr__,__deprecated__,__unsafe__));
extern volatile unsigned int  WREG13 __attribute__((__sfr__,__deprecated__,__unsafe__));
extern volatile unsigned int  WREG14 __attribute__((__sfr__,__deprecated__,__unsafe__));
extern volatile unsigned int  WREG15 __attribute__((__sfr__,__deprecated__,__unsafe__));
extern volatile unsigned int  SPLIM __attribute__((__sfr__));
typedef struct tagACC {
    unsigned int L;
    unsigned int H;
    unsigned char U;
} ACC;

/* SFR blocks for each ACC module */
extern volatile ACC ACCA __attribute__((__sfr__));

extern volatile unsigned int  ACCAL __attribute__((__sfr__));
extern volatile unsigned int  ACCAH __attribute__((__sfr__));
extern volatile unsigned char ACCAU __attribute__((__sfr__));

/* SFR blocks for each ACC module */
extern volatile ACC ACCB __attribute__((__sfr__));

extern volatile unsigned int  ACCBL __attribute__((__sfr__));
extern volatile unsigned int  ACCBH __attribute__((__sfr__));
extern volatile unsigned char ACCBU __attribute__((__sfr__));
extern volatile unsigned int  PCL __attribute__((__sfr__));
extern volatile unsigned char PCH __attribute__((__sfr__));
extern volatile unsigned char TBLPAG __attribute__((__sfr__));
extern volatile unsigned char PSVPAG __attribute__((__sfr__));
extern volatile unsigned int  RCOUNT __attribute__((__sfr__));
extern volatile unsigned int  DCOUNT __attribute__((__sfr__));
extern volatile unsigned int  DOSTARTL __attribute__((__sfr__));
extern volatile unsigned int  DOSTARTH __attribute__((__sfr__));
extern volatile unsigned int  DOENDL __attribute__((__sfr__));
extern volatile unsigned int  DOENDH __attribute__((__sfr__));
extern volatile unsigned int  SR __attribute__((__sfr__));
__extension__ typedef struct tagSRBITS {
  union {
    struct {
      unsigned C:1;
      unsigned Z:1;
      unsigned OV:1;
      unsigned N:1;
      unsigned RA:1;
      unsigned IPL:3;
      unsigned DC:1;
      unsigned DA:1;
      unsigned SAB:1;
      unsigned OAB:1;
      unsigned SB:1;
      unsigned SA:1;
      unsigned OB:1;
      unsigned OA:1;
    };
    struct {
      unsigned :5;
      unsigned IPL0:1;
      unsigned IPL1:1;
      unsigned IPL2:1;
    };
  };
} SRBITS;
extern volatile SRBITS SRbits __attribute__((__sfr__));

extern volatile unsigned int  CORCON __attribute__((__sfr__));
__extension__ typedef struct tagCORCONBITS {
  union {
    struct {
      unsigned IF:1;
      unsigned RND:1;
      unsigned PSV:1;
      unsigned IPL3:1;
      unsigned ACCSAT:1;
      unsigned SATDW:1;
      unsigned SATB:1;
      unsigned SATA:1;
      unsigned DL:3;
      unsigned EDT:1;
      unsigned US:1;
    };
    struct {
      unsigned :8;
      unsigned DL0:1;
      unsigned DL1:1;
      unsigned DL2:1;
    };
  };
} CORCONBITS;
extern volatile CORCONBITS CORCONbits __attribute__((__sfr__));

extern volatile unsigned int  MODCON __attribute__((__sfr__));
__extension__ typedef struct tagMODCONBITS {
  union {
    struct {
      unsigned XWM:4;
      unsigned YWM:4;
      unsigned BWM:4;
      unsigned :2;
      unsigned YMODEN:1;
      unsigned XMODEN:1;
    };
    struct {
      unsigned XWM0:1;
      unsigned XWM1:1;
      unsigned XWM2:1;
      unsigned XWM3:1;
      unsigned YWM0:1;
      unsigned YWM1:1;
      unsigned YWM2:1;
      unsigned YWM3:1;
      unsigned BWM0:1;
      unsigned BWM1:1;
      unsigned BWM2:1;
      unsigned BWM3:1;
    };
  };
} MODCONBITS;
extern volatile MODCONBITS MODCONbits __attribute__((__sfr__));

extern volatile unsigned int  XMODSRT __attribute__((__sfr__));
extern volatile unsigned int  XMODEND __attribute__((__sfr__));
extern volatile unsigned int  YMODSRT __attribute__((__sfr__));
extern volatile unsigned int  YMODEND __attribute__((__sfr__));
extern volatile unsigned int  XBREV __attribute__((__sfr__));
__extension__ typedef struct tagXBREVBITS {
  union {
    struct {
      unsigned XB:15;
      unsigned BREN:1;
    };
    struct {
      unsigned XB0:1;
      unsigned XB1:1;
      unsigned XB2:1;
      unsigned XB3:1;
      unsigned XB4:1;
      unsigned XB5:1;
      unsigned XB6:1;
      unsigned XB7:1;
      unsigned XB8:1;
      unsigned XB9:1;
      unsigned XB10:1;
      unsigned XB11:1;
      unsigned XB12:1;
      unsigned XB13:1;
      unsigned XB14:1;
    };
  };
} XBREVBITS;
extern volatile XBREVBITS XBREVbits __attribute__((__sfr__));

extern volatile unsigned int  DISICNT __attribute__((__sfr__));
typedef struct tagDISICNTBITS {
  unsigned DISICNT:14;
} DISICNTBITS;
extern volatile DISICNTBITS DISICNTbits __attribute__((__sfr__));

extern volatile unsigned int  INTCON1 __attribute__((__sfr__));
typedef struct tagINTCON1BITS {
  unsigned :1;
  unsigned OSCFAIL:1;
  unsigned STKERR:1;
  unsigned ADDRERR:1;
  unsigned MATHERR:1;
  unsigned :3;
  unsigned COVTE:1;
  unsigned OVBTE:1;
  unsigned OVATE:1;
  unsigned :4;
  unsigned NSTDIS:1;
} INTCON1BITS;
extern volatile INTCON1BITS INTCON1bits __attribute__((__sfr__));

extern volatile unsigned int  INTCON2 __attribute__((__sfr__));
typedef struct tagINTCON2BITS {
  unsigned INT0EP:1;
  unsigned INT1EP:1;
  unsigned INT2EP:1;
  unsigned INT3EP:1;
  unsigned INT4EP:1;
  unsigned :9;
  unsigned DISI:1;
  unsigned ALTIVT:1;
} INTCON2BITS;
extern volatile INTCON2BITS INTCON2bits __attribute__((__sfr__));

extern volatile unsigned int  IFS0 __attribute__((__sfr__));
typedef struct tagIFS0BITS {
  unsigned INT0IF:1;
  unsigned IC1IF:1;
  unsigned OC1IF:1;
  unsigned T1IF:1;
  unsigned IC2IF:1;
  unsigned OC2IF:1;
  unsigned T2IF:1;
  unsigned T3IF:1;
  unsigned SPI1IF:1;
  unsigned U1RXIF:1;
  unsigned U1TXIF:1;
  unsigned ADIF:1;
  unsigned NVMIF:1;
  unsigned SI2CIF:1;
  unsigned MI2CIF:1;
  unsigned CNIF:1;
} IFS0BITS;
extern volatile IFS0BITS IFS0bits __attribute__((__sfr__));

extern volatile unsigned int  IFS1 __attribute__((__sfr__));
typedef struct tagIFS1BITS {
  unsigned INT1IF:1;
  unsigned IC7IF:1;
  unsigned IC8IF:1;
  unsigned OC3IF:1;
  unsigned OC4IF:1;
  unsigned T4IF:1;
  unsigned T5IF:1;
  unsigned INT2IF:1;
  unsigned U2RXIF:1;
  unsigned U2TXIF:1;
  unsigned SPI2IF:1;
  unsigned C1IF:1;
  unsigned IC3IF:1;
  unsigned IC4IF:1;
  unsigned IC5IF:1;
  unsigned IC6IF:1;
} IFS1BITS;
extern volatile IFS1BITS IFS1bits __attribute__((__sfr__));

extern volatile unsigned int  IFS2 __attribute__((__sfr__));
typedef struct tagIFS2BITS {
  unsigned OC5IF:1;
  unsigned OC6IF:1;
  unsigned OC7IF:1;
  unsigned OC8IF:1;
  unsigned INT3IF:1;
  unsigned INT4IF:1;
  unsigned C2IF:1;
  unsigned :2;
  unsigned DCIIF:1;
  unsigned LVDIF:1;
} IFS2BITS;
extern volatile IFS2BITS IFS2bits __attribute__((__sfr__));

extern volatile unsigned int  IEC0 __attribute__((__sfr__));
typedef struct tagIEC0BITS {
  unsigned INT0IE:1;
  unsigned IC1IE:1;
  unsigned OC1IE:1;
  unsigned T1IE:1;
  unsigned IC2IE:1;
  unsigned OC2IE:1;
  unsigned T2IE:1;
  unsigned T3IE:1;
  unsigned SPI1IE:1;
  unsigned U1RXIE:1;
  unsigned U1TXIE:1;
  unsigned ADIE:1;
  unsigned NVMIE:1;
  unsigned SI2CIE:1;
  unsigned MI2CIE:1;
  unsigned CNIE:1;
} IEC0BITS;
extern volatile IEC0BITS IEC0bits __attribute__((__sfr__));

extern volatile unsigned int  IEC1 __attribute__((__sfr__));
typedef struct tagIEC1BITS {
  unsigned INT1IE:1;
  unsigned IC7IE:1;
  unsigned IC8IE:1;
  unsigned OC3IE:1;
  unsigned OC4IE:1;
  unsigned T4IE:1;
  unsigned T5IE:1;
  unsigned INT2IE:1;
  unsigned U2RXIE:1;
  unsigned U2TXIE:1;
  unsigned SPI2IE:1;
  unsigned C1IE:1;
  unsigned IC3IE:1;
  unsigned IC4IE:1;
  unsigned IC5IE:1;
  unsigned IC6IE:1;
} IEC1BITS;
extern volatile IEC1BITS IEC1bits __attribute__((__sfr__));

extern volatile unsigned int  IEC2 __attribute__((__sfr__));
typedef struct tagIEC2BITS {
  unsigned OC5IE:1;
  unsigned OC6IE:1;
  unsigned OC7IE:1;
  unsigned OC8IE:1;
  unsigned INT3IE:1;
  unsigned INT4IE:1;
  unsigned C2IE:1;
  unsigned :2;
  unsigned DCIIE:1;
  unsigned LVDIE:1;
} IEC2BITS;
extern volatile IEC2BITS IEC2bits __attribute__((__sfr__));

extern volatile unsigned int  IPC0 __attribute__((__sfr__));
__extension__ typedef struct tagIPC0BITS {
  union {
    struct {
      unsigned INT0IP:3;
      unsigned :1;
      unsigned IC1IP:3;
      unsigned :1;
      unsigned OC1IP:3;
      unsigned :1;
      unsigned T1IP:3;
    };
    struct {
      unsigned INT0IP0:1;
      unsigned INT0IP1:1;
      unsigned INT0IP2:1;
      unsigned :1;
      unsigned IC1IP0:1;
      unsigned IC1IP1:1;
      unsigned IC1IP2:1;
      unsigned :1;
      unsigned OC1IP0:1;
      unsigned OC1IP1:1;
      unsigned OC1IP2:1;
      unsigned :1;
      unsigned T1IP0:1;
      unsigned T1IP1:1;
      unsigned T1IP2:1;
    };
  };
} IPC0BITS;
extern volatile IPC0BITS IPC0bits __attribute__((__sfr__));

extern volatile unsigned int  IPC1 __attribute__((__sfr__));
__extension__ typedef struct tagIPC1BITS {
  union {
    struct {
      unsigned IC2IP:3;
      unsigned :1;
      unsigned OC2IP:3;
      unsigned :1;
      unsigned T2IP:3;
      unsigned :1;
      unsigned T3IP:3;
    };
    struct {
      unsigned IC2IP0:1;
      unsigned IC2IP1:1;
      unsigned IC2IP2:1;
      unsigned :1;
      unsigned OC2IP0:1;
      unsigned OC2IP1:1;
      unsigned OC2IP2:1;
      unsigned :1;
      unsigned T2IP0:1;
      unsigned T2IP1:1;
      unsigned T2IP2:1;
      unsigned :1;
      unsigned T3IP0:1;
      unsigned T3IP1:1;
      unsigned T3IP2:1;
    };
  };
} IPC1BITS;
extern volatile IPC1BITS IPC1bits __attribute__((__sfr__));

extern volatile unsigned int  IPC2 __attribute__((__sfr__));
__extension__ typedef struct tagIPC2BITS {
  union {
    struct {
      unsigned SPI1IP:3;
      unsigned :1;
      unsigned U1RXIP:3;
      unsigned :1;
      unsigned U1TXIP:3;
      unsigned :1;
      unsigned ADIP:3;
    };
    struct {
      unsigned SPI1IP0:1;
      unsigned SPI1IP1:1;
      unsigned SPI1IP2:1;
      unsigned :1;
      unsigned U1RXIP0:1;
      unsigned U1RXIP1:1;
      unsigned U1RXIP2:1;
      unsigned :1;
      unsigned U1TXIP0:1;
      unsigned U1TXIP1:1;
      unsigned U1TXIP2:1;
      unsigned :1;
      unsigned ADIP0:1;
      unsigned ADIP1:1;
      unsigned ADIP2:1;
    };
  };
} IPC2BITS;
extern volatile IPC2BITS IPC2bits __attribute__((__sfr__));

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
      unsigned OC6IP2:1;
      unsigned :1;
      unsigned OC7IP0:1;
      unsigned OC7IP1:1;
      unsigned OC7IP2:1;
      unsigned :1;
      unsigned OC8IP0:1;
      unsigned OC8IP1:1;
      unsigned OC8IP2:1;
    };
  };
} IPC8BITS;
extern volatile IPC8BITS IPC8bits __attribute__((__sfr__));

extern volatile unsigned int  IPC9 __attribute__((__sfr__));
__extension__ typedef struct tagIPC9BITS {
  union {
    struct {
      unsigned INT3IP:3;
      unsigned :1;
      unsigned INT4IP:3;
      unsigned :1;
      unsigned C2IP:3;
    };
    struct {
      unsigned INT3IP0:1;
      unsigned INT3IP1:1;
      unsigned INT3IP2:1;
      unsigned :1;
      unsigned INT4IP0:1;
      unsigned INT4IP1:1;
      unsigned INT4IP2:1;
      unsigned :1;
      unsigned C2IP0:1;
      unsigned C2IP1:1;
      unsigned C2IP2:1;
    };
  };
} IPC9BITS;
extern volatile IPC9BITS IPC9bits __attribute__((__sfr__));

extern volatile unsigned int  IPC10 __attribute__((__sfr__));
__extension__ typedef struct tagIPC10BITS {
  union {
    struct {
      unsigned :4;
      unsigned DCIIP:3;
      unsigned :1;
      unsigned LVDIP:3;
    };
    struct {
      unsigned :4;
      unsigned DCIIP0:1;
      unsigned DCIIP1:1;
      unsigned DCIIP2:1;
      unsigned :1;
      unsigned LVDIP0:1;
      unsigned LVDIP1:1;
      unsigned LVDIP2:1;
    };
  };
} IPC10BITS;
extern volatile IPC10BITS IPC10bits __attribute__((__sfr__));

extern volatile unsigned int  INTTREG __attribute__((__sfr__));
__extension__ typedef struct tagINTTREGBITS {
  union {
    struct {
      unsigned VECNUM:6;
      unsigned :2;
      unsigned ILR:4;
      unsigned :1;
      unsigned VHOLD:1;
      unsigned TMODE:1;
      unsigned IRQTOCPU:1;
    };
    struct {
      unsigned VECNUM0:1;
      unsigned VECNUM1:1;
      unsigned VECNUM2:1;
      unsigned VECNUM3:1;
      unsigned VECNUM4:1;
      unsigned VECNUM5:1;
      unsigned :2;
      unsigned ILR0:1;
      unsigned ILR1:1;
      unsigned ILR2:1;
      unsigned ILR3:1;
    };
  };
} INTTREGBITS;
extern volatile INTTREGBITS INTTREGbits __attribute__((__sfr__));

extern volatile unsigned int  CNEN1 __attribute__((__sfr__));
typedef struct tagCNEN1BITS {
  unsigned CN0IE:1;
  unsigned CN1IE:1;
  unsigned CN2IE:1;
  unsigned CN3IE:1;
  unsigned CN4IE:1;
  unsigned CN5IE:1;
  unsigned CN6IE:1;
  unsigned CN7IE:1;
  unsigned CN8IE:1;
  unsigned CN9IE:1;
  unsigned CN10IE:1;
  unsigned CN11IE:1;
  unsigned CN12IE:1;
  unsigned CN13IE:1;
  unsigned CN14IE:1;
  unsigned CN15IE:1;
} CNEN1BITS;
extern volatile CNEN1BITS CNEN1bits __attribute__((__sfr__));

extern volatile unsigned int  CNEN2 __attribute__((__sfr__));
typedef struct tagCNEN2BITS {
  unsigned CN16IE:1;
  unsigned CN17IE:1;
  unsigned CN18IE:1;
} CNEN2BITS;
extern volatile CNEN2BITS CNEN2bits __attribute__((__sfr__));

extern volatile unsigned int  CNPU1 __attribute__((__sfr__));
typedef struct tagCNPU1BITS {
  unsigned CN0PUE:1;
  unsigned CN1PUE:1;
  unsigned CN2PUE:1;
  unsigned CN3PUE:1;
  unsigned CN4PUE:1;
  unsigned CN5PUE:1;
  unsigned CN6PUE:1;
  unsigned CN7PUE:1;
  unsigned CN8PUE:1;
  unsigned CN9PUE:1;
  unsigned CN10PUE:1;
  unsigned CN11PUE:1;
  unsigned CN12PUE:1;
  unsigned CN13PUE:1;
  unsigned CN14PUE:1;
  unsigned CN15PUE:1;
} CNPU1BITS;
extern volatile CNPU1BITS CNPU1bits __attribute__((__sfr__));

extern volatile unsigned int  CNPU2 __attribute__((__sfr__));
typedef struct tagCNPU2BITS {
  unsigned CN16PUE:1;
  unsigned CN17PUE:1;
  unsigned CN18PUE:1;
} CNPU2BITS;
extern volatile CNPU2BITS CNPU2bits __attribute__((__sfr__));

extern volatile unsigned int  TMR1 __attribute__((__sfr__));
extern volatile unsigned int  PR1 __attribute__((__sfr__));
extern volatile unsigned int  T1CON __attribute__((__sfr__));
__extension__ typedef struct tagT1CONBITS {
  union {
    struct {
      unsigned :1;
      unsigned TCS:1;
      unsigned TSYNC:1;
      unsigned :1;
      unsigned TCKPS:2;
      unsigned TGATE:1;
      unsigned :6;
      unsigned TSIDL:1;
      unsigned :1;
      unsigned TON:1;
    };
    struct {
      unsigned :4;
      unsigned TCKPS0:1;
      unsigned TCKPS1:1;
    };
  };
} T1CONBITS;
extern volatile T1CONBITS T1CONbits __attribute__((__sfr__));

extern volatile unsigned int  TMR2 __attribute__((__sfr__));
extern volatile unsigned int  TMR3HLD __attribute__((__sfr__));
extern volatile unsigned int  TMR3 __attribute__((__sfr__));
extern volatile unsigned int  PR2 __attribute__((__sfr__));
extern volatile unsigned int  PR3 __attribute__((__sfr__));
extern volatile unsigned int  T2CON __attribute__((__sfr__));
__extension__ typedef struct tagT2CONBITS {
  union {
    struct {
      unsigned :1;
      unsigned TCS:1;
      unsigned :1;
      unsigned T32:1;
      unsigned TCKPS:2;
      unsigned TGATE:1;
      unsigned :6;
      unsigned TSIDL:1;
      unsigned :1;
      unsigned TON:1;
    };
    struct {
      unsigned :4;
      unsigned TCKPS0:1;
      unsigned TCKPS1:1;
    };
  };
} T2CONBITS;
extern volatile T2CONBITS T2CONbits __attribute__((__sfr__));

extern volatile unsigned int  T3CON __attribute__((__sfr__));
__extension__ typedef struct tagT3CONBITS {
  union {
    struct {
      unsigned :1;
      unsigned TCS:1;
      unsigned :2;
      unsigned TCKPS:2;
      unsigned TGATE:1;
      unsigned :6;
      unsigned TSIDL:1;
      unsigned :1;
      unsigned TON:1;
    };
    struct {
      unsigned :4;
      unsigned TCKPS0:1;
      unsigned TCKPS1:1;
    };
  };
} T3CONBITS;
extern volatile T3CONBITS T3CONbits __attribute__((__sfr__));

extern volatile unsigned int  TMR4 __attribute__((__sfr__));
extern volatile unsigned int  TMR5HLD __attribute__((__sfr__));
extern volatile unsigned int  TMR5 __attribute__((__sfr__));
extern volatile unsigned int  PR4 __attribute__((__sfr__));
extern volatile unsigned int  PR5 __attribute__((__sfr__));
extern volatile unsigned int  T4CON __attribute__((__sfr__));
__extension__ typedef struct tagT4CONBITS {
  union {
    struct {
      unsigned :1;
      unsigned TCS:1;
      unsigned :1;
      unsigned T32:1;
      unsigned TCKPS:2;
      unsigned TGATE:1;
      unsigned :6;
      unsigned TSIDL:1;
      unsigned :1;
      unsigned TON:1;
    };
    struct {
      unsigned :4;
      unsigned TCKPS0:1;
      unsigned TCKPS1:1;
    };
  };
} T4CONBITS;
extern volatile T4CONBITS T4CONbits __attribute__((__sfr__));

extern volatile unsigned int  T5CON __attribute__((__sfr__));
__extension__ typedef struct tagT5CONBITS {
  union {
    struct {
      unsigned :1;
      unsigned TCS:1;
      unsigned :2;
      unsigned TCKPS:2;
      unsigned TGATE:1;
      unsigned :6;
      unsigned TSIDL:1;
      unsigned :1;
      unsigned TON:1;
    };
    struct {
      unsigned :4;
      unsigned TCKPS0:1;
      unsigned TCKPS1:1;
    };
  };
} T5CONBITS;
extern volatile T5CONBITS T5CONbits __attribute__((__sfr__));


/* Generic structure of entire SFR area for Input Capture modules */
typedef struct tagIC {
        unsigned int icxbuf;
        unsigned int icxcon;
} IC, *PIC;


/* SFR blocks for Input Capture modules */
extern volatile IC IC1 __attribute__((__sfr__));

extern volatile unsigned int  IC1BUF __attribute__((__sfr__));
extern volatile unsigned int  IC1CON __attribute__((__sfr__));
typedef struct tagIC1CONBITS {
  unsigned ICM:3;
  unsigned ICBNE:1;
  unsigned ICOV:1;
  unsigned ICI:2;
  unsigned ICTMR:1;
  unsigned :5;
  unsigned ICSIDL:1;
} IC1CONBITS;
extern volatile IC1CONBITS IC1CONbits __attribute__((__sfr__));


/* SFR blocks for Input Capture modules */
extern volatile IC IC2 __attribute__((__sfr__));

extern volatile unsigned int  IC2BUF __attribute__((__sfr__));
extern volatile unsigned int  IC2CON __attribute__((__sfr__));
__extension__ typedef struct tagIC2CONBITS {
  union {
    struct {
      unsigned ICM:3;
      unsigned ICBNE:1;
      unsigned ICOV:1;
      unsigned ICI:2;
      unsigned ICTMR:1;
      unsigned :5;
      unsigned ICSIDL:1;
    };
    struct {
      unsigned ICM0:1;
      unsigned ICM1:1;
      unsigned ICM2:1;
      unsigned :2;
      unsigned ICI0:1;
      unsigned ICI1:1;
    };
  };
} IC2CONBITS;
extern volatile IC2CONBITS IC2CONbits __attribute__((__sfr__));


/* SFR blocks for Input Capture modules */
extern volatile IC IC3 __attribute__((__sfr__));

extern volatile unsigned int  IC3BUF __attribute__((__sfr__));
extern volatile unsigned int  IC3CON __attribute__((__sfr__));
__extension__ typedef struct tagIC3CONBITS {
  union {
    struct {
      unsigned ICM:3;
      unsigned ICBNE:1;
      unsigned ICOV:1;
      unsigned ICI:2;
      unsigned ICTMR:1;
      unsigned :5;
      unsigned ICSIDL:1;
    };
    struct {
      unsigned ICM0:1;
      unsigned ICM1:1;
      unsigned ICM2:1;
      unsigned :2;
      unsigned ICI0:1;
      unsigned ICI1:1;
    };
  };
} IC3CONBITS;
extern volatile IC3CONBITS IC3CONbits __attribute__((__sfr__));


/* SFR blocks for Input Capture modules */
extern volatile IC IC4 __attribute__((__sfr__));

extern volatile unsigned int  IC4BUF __attribute__((__sfr__));
extern volatile unsigned int  IC4CON __attribute__((__sfr__));
__extension__ typedef struct tagIC4CONBITS {
  union {
    struct {
      unsigned ICM:3;
      unsigned ICBNE:1;
      unsigned ICOV:1;
      unsigned ICI:2;
      unsigned ICTMR:1;
      unsigned :5;
      unsigned ICSIDL:1;
    };
    struct {
      unsigned ICM0:1;
      unsigned ICM1:1;
      unsigned ICM2:1;
      unsigned :2;
      unsigned ICI0:1;
      unsigned ICI1:1;
    };
  };
} IC4CONBITS;
extern volatile IC4CONBITS IC4CONbits __attribute__((__sfr__));


/* SFR blocks for Input Capture modules */
extern volatile IC IC5 __attribute__((__sfr__));

extern volatile unsigned int  IC5BUF __attribute__((__sfr__));
extern volatile unsigned int  IC5CON __attribute__((__sfr__));
__extension__ typedef struct tagIC5CONBITS {
  union {
    struct {
      unsigned ICM:3;
      unsigned ICBNE:1;
      unsigned ICOV:1;
      unsigned ICI:2;
      unsigned ICTMR:1;
      unsigned :5;
      unsigned ICSIDL:1;
    };
    struct {
      unsigned ICM0:1;
      unsigned ICM1:1;
      unsigned ICM2:1;
      unsigned :2;
      unsigned ICI0:1;
      unsigned ICI1:1;
    };
  };
} IC5CONBITS;
extern volatile IC5CONBITS IC5CONbits __attribute__((__sfr__));


/* SFR blocks for Input Capture modules */
extern volatile IC IC6 __attribute__((__sfr__));

extern volatile unsigned int  IC6BUF __attribute__((__sfr__));
extern volatile unsigned int  IC6CON __attribute__((__sfr__));
__extension__ typedef struct tagIC6CONBITS {
  union {
    struct {
      unsigned ICM:3;
      unsigned ICBNE:1;
      unsigned ICOV:1;
      unsigned ICI:2;
      unsigned ICTMR:1;
      unsigned :5;
      unsigned ICSIDL:1;
    };
    struct {
      unsigned ICM0:1;
      unsigned ICM1:1;
      unsigned ICM2:1;
      unsigned :2;
      unsigned ICI0:1;
      unsigned ICI1:1;
    };
  };
} IC6CONBITS;
extern volatile IC6CONBITS IC6CONbits __attribute__((__sfr__));


/* SFR blocks for Input Capture modules */
extern volatile IC IC7 __attribute__((__sfr__));

extern volatile unsigned int  IC7BUF __attribute__((__sfr__));
extern volatile unsigned int  IC7CON __attribute__((__sfr__));
__extension__ typedef struct tagIC7CONBITS {
  union {
    struct {
      unsigned ICM:3;
      unsigned ICBNE:1;
      unsigned ICOV:1;
      unsigned ICI:2;
      unsigned ICTMR:1;
      unsigned :5;
      unsigned ICSIDL:1;
    };
    struct {
      unsigned ICM0:1;
      unsigned ICM1:1;
      unsigned ICM2:1;
      unsigned :2;
      unsigned ICI0:1;
      unsigned ICI1:1;
    };
  };
} IC7CONBITS;
extern volatile IC7CONBITS IC7CONbits __attribute__((__sfr__));


/* SFR blocks for Input Capture modules */
extern volatile IC IC8 __attribute__((__sfr__));

extern volatile unsigned int  IC8BUF __attribute__((__sfr__));
extern volatile unsigned int  IC8CON __attribute__((__sfr__));
__extension__ typedef struct tagIC8CONBITS {
  union {
    struct {
      unsigned ICM:3;
      unsigned ICBNE:1;
      unsigned ICOV:1;
      unsigned ICI:2;
      unsigned ICTMR:1;
      unsigned :5;
      unsigned ICSIDL:1;
    };
    struct {
      unsigned ICM0:1;
      unsigned ICM1:1;
      unsigned ICM2:1;
      unsigned :2;
      unsigned ICI0:1;
      unsigned ICI1:1;
    };
  };
} IC8CONBITS;
extern volatile IC8CONBITS IC8CONbits __attribute__((__sfr__));


/* Generic structure of entire SFR area for Output Compare modules */
typedef struct tagOC {
        unsigned int ocxrs;
        unsigned int ocxr;
        unsigned int ocxcon;
} OC, *POC;


/* SFR blocks for Output Compare modules */
extern volatile OC OC1 __attribute__((__sfr__));

extern volatile unsigned int  OC1RS __attribute__((__sfr__));
extern volatile unsigned int  OC1R __attribute__((__sfr__));
extern volatile unsigned int  OC1CON __attribute__((__sfr__));
__extension__ typedef struct tagOC1CONBITS {
  union {
    struct {
      unsigned OCM:3;
      unsigned OCTSEL:1;
      unsigned OCFLT:1;
      unsigned :8;
      unsigned OCSIDL:1;
    };
    struct {
      unsigned OCM0:1;
      unsigned OCM1:1;
      unsigned OCM2:1;
    };
  };
} OC1CONBITS;
extern volatile OC1CONBITS OC1CONbits __attribute__((__sfr__));


/* SFR blocks for Output Compare modules */
extern volatile OC OC2 __attribute__((__sfr__));

extern volatile unsigned int  OC2RS __attribute__((__sfr__));
extern volatile unsigned int  OC2R __attribute__((__sfr__));
extern volatile unsigned int  OC2CON __attribute__((__sfr__));
__extension__ typedef struct tagOC2CONBITS {
  union {
    struct {
      unsigned OCM:3;
      unsigned OCTSEL:1;
      unsigned OCFLT:1;
      unsigned :8;
      unsigned OCSIDL:1;
    };
    struct {
      unsigned OCM0:1;
      unsigned OCM1:1;
      unsigned OCM2:1;
    };
  };
} OC2CONBITS;
extern volatile OC2CONBITS OC2CONbits __attribute__((__sfr__));


/* SFR blocks for Output Compare modules */
extern volatile OC OC3 __attribute__((__sfr__));

extern volatile unsigned int  OC3RS __attribute__((__sfr__));
extern volatile unsigned int  OC3R __attribute__((__sfr__));
extern volatile unsigned int  OC3CON __attribute__((__sfr__));
__extension__ typedef struct tagOC3CONBITS {
  union {
    struct {
      unsigned OCM:3;
      unsigned OCTSEL:1;
      unsigned OCFLT:1;
      unsigned :8;
      unsigned OCSIDL:1;
    };
    struct {
      unsigned OCM0:1;
      unsigned OCM1:1;
      unsigned OCM2:1;
    };
  };
} OC3CONBITS;
extern volatile OC3CONBITS OC3CONbits __attribute__((__sfr__));


/* SFR blocks for Output Compare modules */
extern volatile OC OC4 __attribute__((__sfr__));

extern volatile unsigned int  OC4RS __attribute__((__sfr__));
extern volatile unsigned int  OC4R __attribute__((__sfr__));
extern volatile unsigned int  OC4CON __attribute__((__sfr__));
__extension__ typedef struct tagOC4CONBITS {
  union {
    struct {
      unsigned OCM:3;
      unsigned OCTSEL:1;
      unsigned OCFLT:1;
      unsigned :8;
      unsigned OCSIDL:1;
    };
    struct {
      unsigned OCM0:1;
      unsigned OCM1:1;
      unsigned OCM2:1;
    };
  };
} OC4CONBITS;
extern volatile OC4CONBITS OC4CONbits __attribute__((__sfr__));


/* SFR blocks for Output Compare modules */
extern volatile OC OC5 __attribute__((__sfr__));

extern volatile unsigned int  OC5RS __attribute__((__sfr__));
extern volatile unsigned int  OC5R __attribute__((__sfr__));
extern volatile unsigned int  OC5CON __attribute__((__sfr__));
__extension__ typedef struct tagOC5CONBITS {
  union {
    struct {
      unsigned OCM:3;
      unsigned OCTSEL:1;
      unsigned OCFLT:1;
      unsigned :8;
      unsigned OCSIDL:1;
    };
    struct {
      unsigned OCM0:1;
      unsigned OCM1:1;
      unsigned OCM2:1;
    };
  };
} OC5CONBITS;
extern volatile OC5CONBITS OC5CONbits __attribute__((__sfr__));


/* SFR blocks for Output Compare modules */
extern volatile OC OC6 __attribute__((__sfr__));

extern volatile unsigned int  OC6RS __attribute__((__sfr__));
extern volatile unsigned int  OC6R __attribute__((__sfr__));
extern volatile unsigned int  OC6CON __attribute__((__sfr__));
__extension__ typedef struct tagOC6CONBITS {
  union {
    struct {
      unsigned OCM:3;
      unsigned OCTSEL:1;
      unsigned OCFLT:1;
      unsigned :8;
      unsigned OCSIDL:1;
    };
    struct {
      unsigned OCM0:1;
      unsigned OCM1:1;
      unsigned OCM2:1;
    };
  };
} OC6CONBITS;
extern volatile OC6CONBITS OC6CONbits __attribute__((__sfr__));


/* SFR blocks for Output Compare modules */
extern volatile OC OC7 __attribute__((__sfr__));

extern volatile unsigned int  OC7RS __attribute__((__sfr__));
extern volatile unsigned int  OC7R __attribute__((__sfr__));
extern volatile unsigned int  OC7CON __attribute__((__sfr__));
__extension__ typedef struct tagOC7CONBITS {
  union {
    struct {
      unsigned OCM:3;
      unsigned OCTSEL:1;
      unsigned OCFLT:1;
      unsigned :8;
      unsigned OCSIDL:1;
    };
    struct {
      unsigned OCM0:1;
      unsigned OCM1:1;
      unsigned OCM2:1;
    };
  };
} OC7CONBITS;
extern volatile OC7CONBITS OC7CONbits __attribute__((__sfr__));


/* SFR blocks for Output Compare modules */
extern volatile OC OC8 __attribute__((__sfr__));

extern volatile unsigned int  OC8RS __attribute__((__sfr__));
extern volatile unsigned int  OC8R __attribute__((__sfr__));
extern volatile unsigned int  OC8CON __attribute__((__sfr__));
__extension__ typedef struct tagOC8CONBITS {
  union {
    struct {
      unsigned OCM:3;
      unsigned OCTSEL:1;
      unsigned OCFLT:1;
      unsigned :8;
      unsigned OCSIDL:1;
    };
    struct {
      unsigned OCM0:1;
      unsigned OCM1:1;
      unsigned OCM2:1;
    };
  };
} OC8CONBITS;
extern volatile OC8CONBITS OC8CONbits __attribute__((__sfr__));

extern volatile unsigned int  I2CRCV __attribute__((__sfr__));
__extension__ typedef struct tagI2CRCVBITS {
  union {
    struct {
      unsigned I2CRCV:8;
    };
    struct {
      unsigned I2CRCV0:1;
      unsigned I2CRCV1:1;
      unsigned I2CRCV2:1;
      unsigned I2CRCV3:1;
      unsigned I2CRCV4:1;
      unsigned I2CRCV5:1;
      unsigned I2CRCV6:1;
      unsigned I2CRCV7:1;
    };
  };
} I2CRCVBITS;
extern volatile I2CRCVBITS I2CRCVbits __attribute__((__sfr__));

extern volatile unsigned int  I2CTRN __attribute__((__sfr__));
__extension__ typedef struct tagI2CTRNBITS {
  union {
    struct {
      unsigned I2CTRN:8;
    };
    struct {
      unsigned I2CTRN0:1;
      unsigned I2CTRN1:1;
      unsigned I2CTRN2:1;
      unsigned I2CTRN3:1;
      unsigned I2CTRN4:1;
      unsigned I2CTRN5:1;
      unsigned I2CTRN6:1;
      unsigned I2CTRN7:1;
    };
  };
} I2CTRNBITS;
extern volatile I2CTRNBITS I2CTRNbits __attribute__((__sfr__));

extern volatile unsigned int  I2CBRG __attribute__((__sfr__));
typedef struct tagI2CBRGBITS {
  unsigned I2CBRG:9;
} I2CBRGBITS;
extern volatile I2CBRGBITS I2CBRGbits __attribute__((__sfr__));

extern volatile unsigned int  I2CCON __attribute__((__sfr__));
typedef struct tagI2CCONBITS {
  unsigned SEN:1;
  unsigned RSEN:1;
  unsigned PEN:1;
  unsigned RCEN:1;
  unsigned ACKEN:1;
  unsigned ACKDT:1;
  unsigned STREN:1;
  unsigned GCEN:1;
  unsigned SMEN:1;
  unsigned DISSLW:1;
  unsigned A10M:1;
  unsigned IPMIEN:1;
  unsigned SCLREL:1;
  unsigned I2CSIDL:1;
  unsigned :1;
  unsigned I2CEN:1;
} I2CCONBITS;
extern volatile I2CCONBITS I2CCONbits __attribute__((__sfr__));

extern volatile unsigned int  I2CSTAT __attribute__((__sfr__));
__extension__ typedef struct tagI2CSTATBITS {
  union {
    struct {
      unsigned TBF:1;
      unsigned RBF:1;
      unsigned R_NOT_W:1;
      unsigned S:1;
      unsigned P:1;
      unsigned D_NOT_A:1;
      unsigned I2COV:1;
      unsigned IWCOL:1;
      unsigned ADD10:1;
      unsigned GCSTAT:1;
      unsigned BCL:1;
      unsigned :3;
      unsigned TRSTAT:1;
      unsigned ACKSTAT:1;
    };
    struct {
      unsigned :2;
      unsigned R_W:1;
      unsigned :2;
      unsigned D_A:1;
    };
  };
} I2CSTATBITS;
extern volatile I2CSTATBITS I2CSTATbits __attribute__((__sfr__));

extern volatile unsigned int  I2CADD __attribute__((__sfr__));
typedef struct tagI2CADDBITS {
  unsigned I2CADD:10;
} I2CADDBITS;
extern volatile I2CADDBITS I2CADDbits __attribute__((__sfr__));


/* Generic structure of entire SFR area for each UART module */
typedef struct tagUART {
        unsigned int uxmode;
        unsigned int uxsta;
        unsigned int uxtxreg;
        unsigned int uxrxreg;
        unsigned int uxbrg;
} UART, *PUART;

#define UxMODEBITS U1MODEBITS
#define UxSTABITS U1STABITS
#define UxTXREGBITS U1TXREGBITS
#define UxRXREGBITS U1RXREGBITS
#define UxBRGBITS U1BRGBITS


/* SFR blocks for each UART module */
extern volatile UART UART1 __attribute__((__sfr__));

extern volatile unsigned int  U1MODE __attribute__((__sfr__));
__extension__ typedef struct tagU1MODEBITS {
  union {
    struct {
      unsigned STSEL:1;
      unsigned PDSEL:2;
      unsigned :2;
      unsigned ABAUD:1;
      unsigned LPBACK:1;
      unsigned WAKE:1;
      unsigned :2;
      unsigned ALTIO:1;
      unsigned :2;
      unsigned USIDL:1;
      unsigned :1;
      unsigned UARTEN:1;
    };
    struct {
      unsigned :1;
      unsigned PDSEL0:1;
      unsigned PDSEL1:1;
    };
  };
} U1MODEBITS;
extern volatile U1MODEBITS U1MODEbits __attribute__((__sfr__));

extern volatile unsigned int  U1STA __attribute__((__sfr__));
__extension__ typedef struct tagU1STABITS {
  union {
    struct {
      unsigned URXDA:1;
      unsigned OERR:1;
      unsigned FERR:1;
      unsigned PERR:1;
      unsigned RIDLE:1;
      unsigned ADDEN:1;
      unsigned URXISEL:2;
      unsigned TRMT:1;
      unsigned UTXBF:1;
      unsigned UTXEN:1;
      unsigned UTXBRK:1;
      unsigned :3;
      unsigned UTXISEL:1;
    };
    struct {
      unsigned :6;
      unsigned URXISEL0:1;
      unsigned URXISEL1:1;
    };
  };
} U1STABITS;
extern volatile U1STABITS U1STAbits __attribute__((__sfr__));

extern volatile unsigned int  U1TXREG __attribute__((__sfr__));
__extension__ typedef struct tagU1TXREGBITS {
  union {
    struct {
      unsigned UTXREG0:1;
      unsigned UTXREG1:1;
      unsigned UTXREG2:1;
      unsigned UTXREG3:1;
      unsigned UTXREG4:1;
      unsigned UTXREG5:1;
      unsigned UTXREG6:1;
      unsigned UTXREG7:1;
      unsigned UTXREG8:1;
    };
    struct {
      unsigned :8;
      unsigned UTX8:1;
    };
  };
} U1TXREGBITS;
extern volatile U1TXREGBITS U1TXREGbits __attribute__((__sfr__));

extern volatile unsigned int  U1RXREG __attribute__((__sfr__));
__extension__ typedef struct tagU1RXREGBITS {
  union {
    struct {
      unsigned URXREG0:1;
      unsigned URXREG1:1;
      unsigned URXREG2:1;
      unsigned URXREG3:1;
      unsigned URXREG4:1;
      unsigned URXREG5:1;
      unsigned URXREG6:1;
      unsigned URXREG7:1;
      unsigned URXREG8:1;
    };
    struct {
      unsigned :8;
      unsigned URX8:1;
    };
  };
} U1RXREGBITS;
extern volatile U1RXREGBITS U1RXREGbits __attribute__((__sfr__));

extern volatile unsigned int  U1BRG __attribute__((__sfr__));

/* SFR blocks for each UART module */
extern volatile UART UART2 __attribute__((__sfr__));

extern volatile unsigned int  U2MODE __attribute__((__sfr__));
__extension__ typedef struct tagU2MODEBITS {
  union {
    struct {
      unsigned STSEL:1;
      unsigned PDSEL:2;
      unsigned :2;
      unsigned ABAUD:1;
      unsigned LPBACK:1;
      unsigned WAKE:1;
      unsigned :5;
      unsigned USIDL:1;
      unsigned :1;
      unsigned UARTEN:1;
    };
    struct {
      unsigned :1;
      unsigned PDSEL0:1;
      unsigned PDSEL1:1;
    };
  };
} U2MODEBITS;
extern volatile U2MODEBITS U2MODEbits __attribute__((__sfr__));

extern volatile unsigned int  U2STA __attribute__((__sfr__));
__extension__ typedef struct tagU2STABITS {
  union {
    struct {
      unsigned URXDA:1;
      unsigned OERR:1;
      unsigned FERR:1;
      unsigned PERR:1;
      unsigned RIDLE:1;
      unsigned ADDEN:1;
      unsigned URXISEL:2;
      unsigned TRMT:1;
      unsigned UTXBF:1;
      unsigned UTXEN:1;
      unsigned UTXBRK:1;
      unsigned :3;
      unsigned UTXISEL:1;
    };
    struct {
      unsigned :6;
      unsigned URXISEL0:1;
      unsigned URXISEL1:1;
    };
  };
} U2STABITS;
extern volatile U2STABITS U2STAbits __attribute__((__sfr__));

extern volatile unsigned int  U2TXREG __attribute__((__sfr__));
__extension__ typedef struct tagU2TXREGBITS {
  union {
    struct {
      unsigned UTXREG0:1;
      unsigned UTXREG1:1;
      unsigned UTXREG2:1;
      unsigned UTXREG3:1;
      unsigned UTXREG4:1;
      unsigned UTXREG5:1;
      unsigned UTXREG6:1;
      unsigned UTXREG7:1;
      unsigned UTXREG8:1;
    };
    struct {
      unsigned :8;
      unsigned UTX8:1;
    };
  };
} U2TXREGBITS;
extern volatile U2TXREGBITS U2TXREGbits __attribute__((__sfr__));

extern volatile unsigned int  U2RXREG __attribute__((__sfr__));
__extension__ typedef struct tagU2RXREGBITS {
  union {
    struct {
      unsigned URXREG0:1;
      unsigned URXREG1:1;
      unsigned URXREG2:1;
      unsigned URXREG3:1;
      unsigned URXREG4:1;
      unsigned URXREG5:1;
      unsigned URXREG6:1;
      unsigned URXREG7:1;
      unsigned URXREG8:1;
    };
    struct {
      unsigned :8;
      unsigned URX8:1;
    };
  };
} U2RXREGBITS;
extern volatile U2RXREGBITS U2RXREGbits __attribute__((__sfr__));

extern volatile unsigned int  U2BRG __attribute__((__sfr__));

/* Generic structure of entire SFR area for each SPI module */
typedef struct tagSPI {
        unsigned int spixstat;
        unsigned int spixcon1;
        unsigned int spixcon2;
        unsigned int unused;
        unsigned int spixbuf;
} SPI, *PSPI;

#define SPIxSTATBITS SPI1STATBITS
#define SPIxCONBITS SPI1CONBITS


/* SFR blocks for each SPI module */
extern volatile SPI SPI1 __attribute__((__sfr__));

extern volatile unsigned int  SPI1STAT __attribute__((__sfr__));
typedef struct tagSPI1STATBITS {
  unsigned SPIRBF:1;
  unsigned SPITBF:1;
  unsigned :4;
  unsigned SPIROV:1;
  unsigned :6;
  unsigned SPISIDL:1;
  unsigned :1;
  unsigned SPIEN:1;
} SPI1STATBITS;
extern volatile SPI1STATBITS SPI1STATbits __attribute__((__sfr__));

extern volatile unsigned int  SPI1CON __attribute__((__sfr__));
__extension__ typedef struct tagSPI1CONBITS {
  union {
    struct {
      unsigned PPRE0:1;
      unsigned PPRE1:1;
      unsigned SPRE0:1;
      unsigned SPRE1:1;
      unsigned SPRE2:1;
      unsigned MSTEN:1;
      unsigned CKP:1;
      unsigned SSEN:1;
      unsigned CKE:1;
      unsigned SMP:1;
      unsigned MODE16:1;
      unsigned DISSDO:1;
      unsigned :1;
      unsigned SPIFSD:1;
      unsigned FRMEN:1;
    };
    struct {
      unsigned PPRE:2;
      unsigned SPRE:3;
    };
  };
} SPI1CONBITS;
extern volatile SPI1CONBITS SPI1CONbits __attribute__((__sfr__));

extern volatile unsigned int  SPI1BUF __attribute__((__sfr__));

/* SFR blocks for each SPI module */
extern volatile SPI SPI2 __attribute__((__sfr__));

extern volatile unsigned int  SPI2STAT __attribute__((__sfr__));
typedef struct tagSPI2STATBITS {
  unsigned SPIRBF:1;
  unsigned SPITBF:1;
  unsigned :4;
  unsigned SPIROV:1;
  unsigned :6;
  unsigned SPISIDL:1;
  unsigned :1;
  unsigned SPIEN:1;
} SPI2STATBITS;
extern volatile SPI2STATBITS SPI2STATbits __attribute__((__sfr__));

extern volatile unsigned int  SPI2CON __attribute__((__sfr__));
__extension__ typedef struct tagSPI2CONBITS {
  union {
    struct {
      unsigned PPRE0:1;
      unsigned PPRE1:1;
      unsigned SPRE0:1;
      unsigned SPRE1:1;
      unsigned SPRE2:1;
      unsigned MSTEN:1;
      unsigned CKP:1;
      unsigned SSEN:1;
      unsigned CKE:1;
      unsigned SMP:1;
      unsigned MODE16:1;
      unsigned DISSDO:1;
      unsigned :1;
      unsigned SPIFSD:1;
      unsigned FRMEN:1;
    };
    struct {
      unsigned PPRE:2;
      unsigned SPRE:3;
    };
  };
} SPI2CONBITS;
extern volatile SPI2CONBITS SPI2CONbits __attribute__((__sfr__));

extern volatile unsigned int  SPI2BUF __attribute__((__sfr__));
extern volatile unsigned int  DCICON1 __attribute__((__sfr__));
__extension__ typedef struct tagDCICON1BITS {
  union {
    struct {
      unsigned COFSM:2;
      unsigned :3;
      unsigned DJST:1;
      unsigned CSDOM:1;
      unsigned UNFM:1;
      unsigned COFSD:1;
      unsigned CSCKE:1;
      unsigned CSCKD:1;
      unsigned DLOOP:1;
      unsigned :1;
      unsigned DCISIDL:1;
      unsigned :1;
      unsigned DCIEN:1;
    };
    struct {
      unsigned COFSM0:1;
      unsigned COFSM1:1;
    };
  };
} DCICON1BITS;
extern volatile DCICON1BITS DCICON1bits __attribute__((__sfr__));

extern volatile unsigned int  DCICON2 __attribute__((__sfr__));
__extension__ typedef struct tagDCICON2BITS {
  union {
    struct {
      unsigned WS:4;
      unsigned :1;
      unsigned COFSG:4;
      unsigned :1;
      unsigned BLEN:2;
    };
    struct {
      unsigned WS0:1;
      unsigned WS1:1;
      unsigned WS2:1;
      unsigned WS3:1;
      unsigned :1;
      unsigned COFSG0:1;
      unsigned COFSG1:1;
      unsigned COFSG2:1;
      unsigned COFSG3:1;
      unsigned :1;
      unsigned BLEN0:1;
      unsigned BLEN1:1;
    };
  };
} DCICON2BITS;
extern volatile DCICON2BITS DCICON2bits __attribute__((__sfr__));

extern volatile unsigned int  DCICON3 __attribute__((__sfr__));
__extension__ typedef struct tagDCICON3BITS {
  union {
    struct {
      unsigned BCG:12;
    };
    struct {
      unsigned BCG0:1;
      unsigned BCG1:1;
      unsigned BCG2:1;
      unsigned BCG3:1;
      unsigned BCG4:1;
      unsigned BCG5:1;
      unsigned BCG6:1;
      unsigned BCG7:1;
      unsigned BCG8:1;
      unsigned BCG9:1;
      unsigned BCG10:1;
      unsigned BCG11:1;
    };
  };
} DCICON3BITS;
extern volatile DCICON3BITS DCICON3bits __attribute__((__sfr__));

extern volatile unsigned int  DCISTAT __attribute__((__sfr__));
__extension__ typedef struct tagDCISTATBITS {
  union {
    struct {
      unsigned TMPTY:1;
      unsigned TUNF:1;
      unsigned RFUL:1;
      unsigned ROV:1;
      unsigned :4;
      unsigned SLOT:4;
    };
    struct {
      unsigned :8;
      unsigned SLOT0:1;
      unsigned SLOT1:1;
      unsigned SLOT2:1;
      unsigned SLOT3:1;
    };
  };
} DCISTATBITS;
extern volatile DCISTATBITS DCISTATbits __attribute__((__sfr__));

extern volatile unsigned int  TSCON __attribute__((__sfr__));
typedef struct tagTSCONBITS {
  unsigned TSE0:1;
  unsigned TSE1:1;
  unsigned TSE2:1;
  unsigned TSE3:1;
  unsigned TSE4:1;
  unsigned TSE5:1;
  unsigned TSE6:1;
  unsigned TSE7:1;
  unsigned TSE8:1;
  unsigned TSE9:1;
  unsigned TSE10:1;
  unsigned TSE11:1;
  unsigned TSE12:1;
  unsigned TSE13:1;
  unsigned TSE14:1;
  unsigned TSE15:1;
} TSCONBITS;
extern volatile TSCONBITS TSCONbits __attribute__((__sfr__));

extern volatile unsigned int  RSCON __attribute__((__sfr__));
typedef struct tagRSCONBITS {
  unsigned RSE0:1;
  unsigned RSE1:1;
  unsigned RSE2:1;
  unsigned RSE3:1;
  unsigned RSE4:1;
  unsigned RSE5:1;
  unsigned RSE6:1;
  unsigned RSE7:1;
  unsigned RSE8:1;
  unsigned RSE9:1;
  unsigned RSE10:1;
  unsigned RSE11:1;
  unsigned RSE12:1;
  unsigned RSE13:1;
  unsigned RSE14:1;
  unsigned RSE15:1;
} RSCONBITS;
extern volatile RSCONBITS RSCONbits __attribute__((__sfr__));

extern volatile unsigned int  RXBUF0 __attribute__((__sfr__));
extern volatile unsigned int  RXBUF1 __attribute__((__sfr__));
extern volatile unsigned int  RXBUF2 __attribute__((__sfr__));
extern volatile unsigned int  RXBUF3 __attribute__((__sfr__));
extern volatile unsigned int  TXBUF0 __attribute__((__sfr__));
extern volatile unsigned int  TXBUF1 __attribute__((__sfr__));
extern volatile unsigned int  TXBUF2 __attribute__((__sfr__));
extern volatile unsigned int  TXBUF3 __attribute__((__sfr__));
extern volatile unsigned int  ADCBUF0 __attribute__((__sfr__));
extern volatile unsigned int  ADCBUF1 __attribute__((__sfr__));
extern volatile unsigned int  ADCBUF2 __attribute__((__sfr__));
extern volatile unsigned int  ADCBUF3 __attribute__((__sfr__));
extern volatile unsigned int  ADCBUF4 __attribute__((__sfr__));
extern volatile unsigned int  ADCBUF5 __attribute__((__sfr__));
extern volatile unsigned int  ADCBUF6 __attribute__((__sfr__));
extern volatile unsigned int  ADCBUF7 __attribute__((__sfr__));
extern volatile unsigned int  ADCBUF8 __attribute__((__sfr__));
extern volatile unsigned int  ADCBUF9 __attribute__((__sfr__));
extern volatile unsigned int  ADCBUFA __attribute__((__sfr__));
extern volatile unsigned int  ADCBUFB __attribute__((__sfr__));
extern volatile unsigned int  ADCBUFC __attribute__((__sfr__));
extern volatile unsigned int  ADCBUFD __attribute__((__sfr__));
extern volatile unsigned int  ADCBUFE __attribute__((__sfr__));
extern volatile unsigned int  ADCBUFF __attribute__((__sfr__));
extern volatile unsigned int  ADCON1 __attribute__((__sfr__));
__extension__ typedef struct tagADCON1BITS {
  union {
    struct {
      unsigned DONE:1;
      unsigned SAMP:1;
      unsigned ASAM:1;
      unsigned :2;
      unsigned SSRC:3;
      unsigned FORM:2;
      unsigned :3;
      unsigned ADSIDL:1;
      unsigned :1;
      unsigned ADON:1;
    };
    struct {
      unsigned :5;
      unsigned SSRC0:1;
      unsigned SSRC1:1;
      unsigned SSRC2:1;
      unsigned FORM0:1;
      unsigned FORM1:1;
    };
  };
} ADCON1BITS;
extern volatile ADCON1BITS ADCON1bits __attribute__((__sfr__));

extern volatile unsigned int  ADCON2 __attribute__((__sfr__));
__extension__ typedef struct tagADCON2BITS {
  union {
    struct {
      unsigned ALTS:1;
      unsigned BUFM:1;
      unsigned SMPI:4;
      unsigned :1;
      unsigned BUFS:1;
      unsigned :2;
      unsigned CSCNA:1;
      unsigned :2;
      unsigned VCFG:3;
    };
    struct {
      unsigned :2;
      unsigned SMPI0:1;
      unsigned SMPI1:1;
      unsigned SMPI2:1;
      unsigned SMPI3:1;
      unsigned :7;
      unsigned VCFG0:1;
      unsigned VCFG1:1;
      unsigned VCFG2:1;
    };
  };
} ADCON2BITS;
extern volatile ADCON2BITS ADCON2bits __attribute__((__sfr__));

extern volatile unsigned int  ADCON3 __attribute__((__sfr__));
__extension__ typedef struct tagADCON3BITS {
  union {
    struct {
      unsigned ADCS:6;
      unsigned :1;
      unsigned ADRC:1;
      unsigned SAMC:5;
    };
    struct {
      unsigned ADCS0:1;
      unsigned ADCS1:1;
      unsigned ADCS2:1;
      unsigned ADCS3:1;
      unsigned ADCS4:1;
      unsigned ADCS5:1;
      unsigned :2;
      unsigned SAMC0:1;
      unsigned SAMC1:1;
      unsigned SAMC2:1;
      unsigned SAMC3:1;
      unsigned SAMC4:1;
    };
  };
} ADCON3BITS;
extern volatile ADCON3BITS ADCON3bits __attribute__((__sfr__));

extern volatile unsigned int  ADCHS __attribute__((__sfr__));
__extension__ typedef struct tagADCHSBITS {
  union {
    struct {
      unsigned CH0SA:4;
      unsigned CH0NA:1;
      unsigned :3;
      unsigned CH0SB:4;
      unsigned CH0NB:1;
    };
    struct {
      unsigned CH0SA0:1;
      unsigned CH0SA1:1;
      unsigned CH0SA2:1;
      unsigned CH0SA3:1;
      unsigned :4;
      unsigned CH0SB0:1;
      unsigned CH0SB1:1;
      unsigned CH0SB2:1;
      unsigned CH0SB3:1;
    };
  };
} ADCHSBITS;
extern volatile ADCHSBITS ADCHSbits __attribute__((__sfr__));

extern volatile unsigned int  ADPCFG __attribute__((__sfr__));
typedef struct tagADPCFGBITS {
  unsigned PCFG0:1;
  unsigned PCFG1:1;
  unsigned PCFG2:1;
  unsigned PCFG3:1;
  unsigned PCFG4:1;
  unsigned PCFG5:1;
  unsigned PCFG6:1;
  unsigned PCFG7:1;
  unsigned PCFG8:1;
  unsigned PCFG9:1;
  unsigned PCFG10:1;
  unsigned PCFG11:1;
  unsigned PCFG12:1;
  unsigned PCFG13:1;
  unsigned PCFG14:1;
  unsigned PCFG15:1;
} ADPCFGBITS;
extern volatile ADPCFGBITS ADPCFGbits __attribute__((__sfr__));

extern volatile unsigned int  ADCSSL __attribute__((__sfr__));
typedef struct tagADCSSLBITS {
  unsigned CSSL0:1;
  unsigned CSSL1:1;
  unsigned CSSL2:1;
  unsigned CSSL3:1;
  unsigned CSSL4:1;
  unsigned CSSL5:1;
  unsigned CSSL6:1;
  unsigned CSSL7:1;
  unsigned CSSL8:1;
  unsigned CSSL9:1;
  unsigned CSSL10:1;
  unsigned CSSL11:1;
  unsigned CSSL12:1;
  unsigned CSSL13:1;
  unsigned CSSL14:1;
  unsigned CSSL15:1;
} ADCSSLBITS;
extern volatile ADCSSLBITS ADCSSLbits __attribute__((__sfr__));

extern volatile unsigned int  TRISB __attribute__((__sfr__));
typedef struct tagTRISBBITS {
  unsigned TRISB0:1;
  unsigned TRISB1:1;
  unsigned TRISB2:1;
  unsigned TRISB3:1;
  unsigned TRISB4:1;
  unsigned TRISB5:1;
  unsigned TRISB6:1;
  unsigned TRISB7:1;
  unsigned TRISB8:1;
  unsigned TRISB9:1;
  unsigned TRISB10:1;
  unsigned TRISB11:1;
  unsigned TRISB12:1;
  unsigned TRISB13:1;
  unsigned TRISB14:1;
  unsigned TRISB15:1;
} TRISBBITS;
extern volatile TRISBBITS TRISBbits __attribute__((__sfr__));

extern volatile unsigned int  PORTB __attribute__((__sfr__));
typedef struct tagPORTBBITS {
  unsigned RB0:1;
  unsigned RB1:1;
  unsigned RB2:1;
  unsigned RB3:1;
  unsigned RB4:1;
  unsigned RB5:1;
  unsigned RB6:1;
  unsigned RB7:1;
  unsigned RB8:1;
  unsigned RB9:1;
  unsigned RB10:1;
  unsigned RB11:1;
  unsigned RB12:1;
  unsigned RB13:1;
  unsigned RB14:1;
  unsigned RB15:1;
} PORTBBITS;
extern volatile PORTBBITS PORTBbits __attribute__((__sfr__));

extern volatile unsigned int  LATB __attribute__((__sfr__));
typedef struct tagLATBBITS {
  unsigned LATB0:1;
  unsigned LATB1:1;
  unsigned LATB2:1;
  unsigned LATB3:1;
  unsigned LATB4:1;
  unsigned LATB5:1;
  unsigned LATB6:1;
  unsigned LATB7:1;
  unsigned LATB8:1;
  unsigned LATB9:1;
  unsigned LATB10:1;
  unsigned LATB11:1;
  unsigned LATB12:1;
  unsigned LATB13:1;
  unsigned LATB14:1;
  unsigned LATB15:1;
} LATBBITS;
extern volatile LATBBITS LATBbits __attribute__((__sfr__));

extern volatile unsigned int  TRISC __attribute__((__sfr__));
typedef struct tagTRISCBITS {
  unsigned :1;
  unsigned TRISC1:1;
  unsigned TRISC2:1;
  unsigned :10;
  unsigned TRISC13:1;
  unsigned TRISC14:1;
  unsigned TRISC15:1;
} TRISCBITS;
extern volatile TRISCBITS TRISCbits __attribute__((__sfr__));

extern volatile unsigned int  PORTC __attribute__((__sfr__));
typedef struct tagPORTCBITS {
  unsigned :1;
  unsigned RC1:1;
  unsigned RC2:1;
  unsigned :10;
  unsigned RC13:1;
  unsigned RC14:1;
  unsigned RC15:1;
} PORTCBITS;
extern volatile PORTCBITS PORTCbits __attribute__((__sfr__));

extern volatile unsigned int  LATC __attribute__((__sfr__));
typedef struct tagLATCBITS {
  unsigned :1;
  unsigned LATC1:1;
  unsigned LATC2:1;
  unsigned :10;
  unsigned LATC13:1;
  unsigned LATC14:1;
  unsigned LATC15:1;
} LATCBITS;
extern volatile LATCBITS LATCbits __attribute__((__sfr__));

extern volatile unsigned int  TRISD __attribute__((__sfr__));
typedef struct tagTRISDBITS {
  unsigned TRISD0:1;
  unsigned TRISD1:1;
  unsigned TRISD2:1;
  unsigned TRISD3:1;
  unsigned TRISD4:1;
  unsigned TRISD5:1;
  unsigned TRISD6:1;
  unsigned TRISD7:1;
  unsigned TRISD8:1;
  unsigned TRISD9:1;
  unsigned TRISD10:1;
  unsigned TRISD11:1;
} TRISDBITS;
extern volatile TRISDBITS TRISDbits __attribute__((__sfr__));

extern volatile unsigned int  PORTD __attribute__((__sfr__));
typedef struct tagPORTDBITS {
  unsigned RD0:1;
  unsigned RD1:1;
  unsigned RD2:1;
  unsigned RD3:1;
  unsigned RD4:1;
  unsigned RD5:1;
  unsigned RD6:1;
  unsigned RD7:1;
  unsigned RD8:1;
  unsigned RD9:1;
  unsigned RD10:1;
  unsigned RD11:1;
} PORTDBITS;
extern volatile PORTDBITS PORTDbits __attribute__((__sfr__));

extern volatile unsigned int  LATD __attribute__((__sfr__));
typedef struct tagLATDBITS {
  unsigned LATD0:1;
  unsigned LATD1:1;
  unsigned LATD2:1;
  unsigned LATD3:1;
  unsigned LATD4:1;
  unsigned LATD5:1;
  unsigned LATD6:1;
  unsigned LATD7:1;
  unsigned LATD8:1;
  unsigned LATD9:1;
  unsigned LATD10:1;
  unsigned LATD11:1;
} LATDBITS;
extern volatile LATDBITS LATDbits __attribute__((__sfr__));

extern volatile unsigned int  TRISF __attribute__((__sfr__));
typedef struct tagTRISFBITS {
  unsigned TRISF0:1;
  unsigned TRISF1:1;
  unsigned TRISF2:1;
  unsigned TRISF3:1;
  unsigned TRISF4:1;
  unsigned TRISF5:1;
  unsigned TRISF6:1;
} TRISFBITS;
extern volatile TRISFBITS TRISFbits __attribute__((__sfr__));

extern volatile unsigned int  PORTF __attribute__((__sfr__));
typedef struct tagPORTFBITS {
  unsigned RF0:1;
  unsigned RF1:1;
  unsigned RF2:1;
  unsigned RF3:1;
  unsigned RF4:1;
  unsigned RF5:1;
  unsigned RF6:1;
} PORTFBITS;
extern volatile PORTFBITS PORTFbits __attribute__((__sfr__));

extern volatile unsigned int  LATF __attribute__((__sfr__));
typedef struct tagLATFBITS {
  unsigned LATF0:1;
  unsigned LATF1:1;
  unsigned LATF2:1;
  unsigned LATF3:1;
  unsigned LATF4:1;
  unsigned LATF5:1;
  unsigned LATF6:1;
} LATFBITS;
extern volatile LATFBITS LATFbits __attribute__((__sfr__));

extern volatile unsigned int  TRISG __attribute__((__sfr__));
typedef struct tagTRISGBITS {
  unsigned TRISG0:1;
  unsigned TRISG1:1;
  unsigned TRISG2:1;
  unsigned TRISG3:1;
  unsigned :2;
  unsigned TRISG6:1;
  unsigned TRISG7:1;
  unsigned TRISG8:1;
  unsigned TRISG9:1;
  unsigned :2;
  unsigned TRISG12:1;
  unsigned TRISG13:1;
  unsigned TRISG14:1;
  unsigned TRISG15:1;
} TRISGBITS;
extern volatile TRISGBITS TRISGbits __attribute__((__sfr__));

extern volatile unsigned int  PORTG __attribute__((__sfr__));
typedef struct tagPORTGBITS {
  unsigned RG0:1;
  unsigned RG1:1;
  unsigned RG2:1;
  unsigned RG3:1;
  unsigned :2;
  unsigned RG6:1;
  unsigned RG7:1;
  unsigned RG8:1;
  unsigned RG9:1;
  unsigned :2;
  unsigned RG12:1;
  unsigned RG13:1;
  unsigned RG14:1;
  unsigned RG15:1;
} PORTGBITS;
extern volatile PORTGBITS PORTGbits __attribute__((__sfr__));

extern volatile unsigned int  LATG __attribute__((__sfr__));
typedef struct tagLATGBITS {
  unsigned LATG0:1;
  unsigned LATG1:1;
  unsigned LATG2:1;
  unsigned LATG3:1;
  unsigned :2;
  unsigned LATG6:1;
  unsigned LATG7:1;
  unsigned LATG8:1;
  unsigned LATG9:1;
  unsigned :2;
  unsigned LATG12:1;
  unsigned LATG13:1;
  unsigned LATG14:1;
  unsigned LATG15:1;
} LATGBITS;
extern volatile LATGBITS LATGbits __attribute__((__sfr__));


/* Generic structure of entire SFR area for each CAN module */
typedef struct tagCAN {
        unsigned int cxrxf0sid;
        unsigned int cxrxf0eidh;
        unsigned int cxrxf0eidl;
        unsigned int reserved0;
        unsigned int cxrxf1sid;
        unsigned int cxrxf1eidh;
        unsigned int cxrxf1eidl;
        unsigned int reserved1;
        unsigned int cxrxf2sid;
        unsigned int cxrxf2eidh;
        unsigned int cxrxf2eidl;
        unsigned int reserved2;
        unsigned int cxrxf3sid;
        unsigned int cxrxf3eidh;
        unsigned int cxrxf3eidl;
        unsigned int reserved3;
        unsigned int cxrxf4sid;
        unsigned int cxrxf4eidh;
        unsigned int cxrxf4eidl;
        unsigned int reserved4;
        unsigned int cxrxf5sid;
        unsigned int cxrxf5eidh;
        unsigned int cxrxf5eidl;
        unsigned int reserved5;
        unsigned int cxrxm0sid;
        unsigned int cxrxm0eidh;
        unsigned int cxrxm0eidl;
        unsigned int reserved6;
        unsigned int cxrxm1sid;
        unsigned int cxrxm1eidh;
        unsigned int cxrxm1eidl;
        unsigned int reserved7;
        unsigned int cxtx2sid;
        unsigned int cxtx2eid;
        unsigned int cxtx2dlc;
        unsigned int cxtx2b1;
        unsigned int cxtx2b2;
        unsigned int cxtx2b3;
        unsigned int cxtx2b4;
        unsigned int cxtx2con;
        unsigned int cxtx1sid;
        unsigned int cxtx1eid;
        unsigned int cxtx1dlc;
        unsigned int cxtx1b1;
        unsigned int cxtx1b2;
        unsigned int cxtx1b3;
        unsigned int cxtx1b4;
        unsigned int cxtx1con;
        unsigned int cxtx0sid;
        unsigned int cxtx0eid;
        unsigned int cxtx0dlc;
        unsigned int cxtx0b1;
        unsigned int cxtx0b2;
        unsigned int cxtx0b3;
        unsigned int cxtx0b4;
        unsigned int cxtx0con;
        unsigned int cxrx1sid;
        unsigned int cxrx1eid;
        unsigned int cxrx1dlc;
        unsigned int cxrx1b1;
        unsigned int cxrx1b2;
        unsigned int cxrx1b3;
        unsigned int cxrx1b4;
        unsigned int cxrx1con;
        unsigned int cxrx0sid;
        unsigned int cxrx0eid;
        unsigned int cxrx0dlc;
        unsigned int cxrx0b1;
        unsigned int cxrx0b2;
        unsigned int cxrx0b3;
        unsigned int cxrx0b4;
        unsigned int cxrx0con;
        unsigned int cxctrl;
        unsigned int cxcfg1;
        unsigned int cxcfg2;
        unsigned int cxintf;
        unsigned int cxinte;
        unsigned int cxec;
        unsigned int reserved8[50];
} CAN, *PCAN;

/* SFR blocks for each CAN module */
extern volatile CAN CAN1 __attribute__((__sfr__));

extern volatile unsigned int  C1RXF0SID __attribute__((__sfr__));
__extension__ typedef struct tagC1RXF0SIDBITS {
  union {
    struct {
      unsigned EXIDE:1;
      unsigned :1;
      unsigned SID0:1;
      unsigned SID1:1;
      unsigned SID2:1;
      unsigned SID3:1;
      unsigned SID4:1;
      unsigned SID5:1;
      unsigned SID6:1;
      unsigned SID7:1;
      unsigned SID8:1;
      unsigned SID9:1;
      unsigned SID10:1;
    };
    struct {
      unsigned :2;
      unsigned SID:11;
    };
  };
} C1RXF0SIDBITS;
extern volatile C1RXF0SIDBITS C1RXF0SIDbits __attribute__((__sfr__));

extern volatile unsigned int  C1RXF0EIDH __attribute__((__sfr__));
typedef struct tagC1RXF0EIDHBITS {
  unsigned EID6:1;
  unsigned EID7:1;
  unsigned EID8:1;
  unsigned EID9:1;
  unsigned EID10:1;
  unsigned EID11:1;
  unsigned EID12:1;
  unsigned EID13:1;
  unsigned EID14:1;
  unsigned EID15:1;
  unsigned EID16:1;
  unsigned EID17:1;
} C1RXF0EIDHBITS;
extern volatile C1RXF0EIDHBITS C1RXF0EIDHbits __attribute__((__sfr__));

extern volatile unsigned int  C1RXF0EIDL __attribute__((__sfr__));
__extension__ typedef struct tagC1RXF0EIDLBITS {
  union {
    struct {
      unsigned :10;
      unsigned EID0:1;
      unsigned EID1:1;
      unsigned EID2:1;
      unsigned EID3:1;
      unsigned EID4:1;
      unsigned EID5:1;
    };
    struct {
      unsigned :10;
      unsigned EID5_0:6;
    };
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
  unsigned TXB1D47:1;
  unsigned TXB1D50:1;
  unsigned TXB1D51:1;
  unsigned TXB1D52:1;
  unsigned TXB1D53:1;
  unsigned TXB1D54:1;
  unsigned TXB1D55:1;
  unsigned TXB1D56:1;
  unsigned TXB1D57:1;
} C1TX1B3BITS;
extern volatile C1TX1B3BITS C1TX1B3bits __attribute__((__sfr__));

extern volatile unsigned int  C1TX1B4 __attribute__((__sfr__));
typedef struct tagC1TX1B4BITS {
  unsigned TXB1D60:1;
  unsigned TXB1D61:1;
  unsigned TXB1D62:1;
  unsigned TXB1D63:1;
  unsigned TXB1D64:1;
  unsigned TXB1D65:1;
  unsigned TXB1D66:1;
  unsigned TXB1D67:1;
  unsigned TXB1D70:1;
  unsigned TXB1D71:1;
  unsigned TXB1D72:1;
  unsigned TXB1D73:1;
  unsigned TXB1D74:1;
  unsigned TXB1D75:1;
  unsigned TXB1D76:1;
  unsigned TXB1D77:1;
} C1TX1B4BITS;
extern volatile C1TX1B4BITS C1TX1B4bits __attribute__((__sfr__));

extern volatile unsigned int  C1TX1CON __attribute__((__sfr__));
__extension__ typedef struct tagC1TX1CONBITS {
  union {
    struct {
      unsigned TXPRI:2;
      unsigned :1;
      unsigned TXREQ:1;
      unsigned TXERR:1;
      unsigned TXLARB:1;
      unsigned TXABT:1;
    };
    struct {
      unsigned TXPRI0:1;
      unsigned TXPRI1:1;
    };
  };
} C1TX1CONBITS;
extern volatile C1TX1CONBITS C1TX1CONbits __attribute__((__sfr__));

extern volatile unsigned int  C1TX0SID __attribute__((__sfr__));
__extension__ typedef struct tagC1TX0SIDBITS {
  union {
    struct {
      unsigned TXIDE:1;
      unsigned SRR:1;
      unsigned SID0:1;
      unsigned SID1:1;
      unsigned SID2:1;
      unsigned SID3:1;
      unsigned SID4:1;
      unsigned SID5:1;
      unsigned :3;
      unsigned SID6:1;
      unsigned SID7:1;
      unsigned SID8:1;
      unsigned SID9:1;
      unsigned SID10:1;
    };
    struct {
      unsigned :2;
      unsigned SID5_0:6;
      unsigned :3;
      unsigned SID10_6:5;
    };
  };
} C1TX0SIDBITS;
extern volatile C1TX0SIDBITS C1TX0SIDbits __attribute__((__sfr__));

extern volatile unsigned int  C1TX0EID __attribute__((__sfr__));
__extension__ typedef struct tagC1TX0EIDBITS {
  union {
    struct {
      unsigned EID6:1;
      unsigned EID7:1;
      unsigned EID8:1;
      unsigned EID9:1;
      unsigned EID10:1;
      unsigned EID11:1;
      unsigned EID12:1;
      unsigned EID13:1;
      unsigned :4;
      unsigned EID14:1;
      unsigned EID15:1;
      unsigned EID16:1;
      unsigned EID17:1;
    };
    struct {
      unsigned EID13_6:8;
      unsigned :4;
      unsigned EID17_14:4;
    };
  };
} C1TX0EIDBITS;
extern volatile C1TX0EIDBITS C1TX0EIDbits __attribute__((__sfr__));

extern volatile unsigned int  C1TX0DLC __attribute__((__sfr__));
__extension__ typedef struct tagC1TX0DLCBITS {
  union {
    struct {
      unsigned :3;
      unsigned DLC:4;
      unsigned TXRB0:1;
      unsigned TXRB1:1;
      unsigned TXRTR:1;
      unsigned EID0:1;
      unsigned EID1:1;
      unsigned EID2:1;
      unsigned EID3:1;
      unsigned EID4:1;
      unsigned EID5:1;
    };
    struct {
      unsigned :10;
      unsigned EID5_0:6;
    };
    struct {
      unsigned :3;
      unsigned DLC0:1;
      unsigned DLC1:1;
      unsigned DLC2:1;
      unsigned DLC3:1;
    };
  };
} C1TX0DLCBITS;
extern volatile C1TX0DLCBITS C1TX0DLCbits __attribute__((__sfr__));

extern volatile unsigned int  C1TX0B1 __attribute__((__sfr__));
typedef struct tagC1TX0B1BITS {
  unsigned TXB0D00:1;
  unsigned TXB0D01:1;
  unsigned TXB0D02:1;
  unsigned TXB0D03:1;
  unsigned TXB0D04:1;
  unsigned TXB0D05:1;
  unsigned TXB0D06:1;
  unsigned TXB0D07:1;
  unsigned TXB0D10:1;
  unsigned TXB0D11:1;
  unsigned TXB0D12:1;
  unsigned TXB0D13:1;
  unsigned TXB0D14:1;
  unsigned TXB0D15:1;
  unsigned TXB0D16:1;
  unsigned TXB0D17:1;
} C1TX0B1BITS;
extern volatile C1TX0B1BITS C1TX0B1bits __attribute__((__sfr__));

extern volatile unsigned int  C1TX0B2 __attribute__((__sfr__));
typedef struct tagC1TX0B2BITS {
  unsigned TXB0D20:1;
  unsigned TXB0D21:1;
  unsigned TXB0D22:1;
  unsigned TXB0D23:1;
  unsigned TXB0D24:1;
  unsigned TXB0D25:1;
  unsigned TXB0D26:1;
  unsigned TXB0D27:1;
  unsigned TXB0D30:1;
  unsigned TXB0D31:1;
  unsigned TXB0D32:1;
  unsigned TXB0D33:1;
  unsigned TXB0D34:1;
  unsigned TXB0D35:1;
  unsigned TXB0D36:1;
  unsigned TXB0D37:1;
} C1TX0B2BITS;
extern volatile C1TX0B2BITS C1TX0B2bits __attribute__((__sfr__));

extern volatile unsigned int  C1TX0B3 __attribute__((__sfr__));
typedef struct tagC1TX0B3BITS {
  unsigned TXB0D40:1;
  unsigned TXB0D41:1;
  unsigned TXB0D42:1;
  unsigned TXB0D43:1;
  unsigned TXB0D44:1;
  unsigned TXB0D45:1;
  unsigned TXB0D46:1;
  unsigned TXB0D47:1;
  unsigned TXB0D50:1;
  unsigned TXB0D51:1;
  unsigned TXB0D52:1;
  unsigned TXB0D53:1;
  unsigned TXB0D54:1;
  unsigned TXB0D55:1;
  unsigned TXB0D56:1;
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
  unsigned TXB1D27:1;
  unsigned TXB1D30:1;
  unsigned TXB1D31:1;
  unsigned TXB1D32:1;
  unsigned TXB1D33:1;
  unsigned TXB1D34:1;
  unsigned TXB1D35:1;
  unsigned TXB1D36:1;
  unsigned TXB1D37:1;
} C1RX1B2BITS;
extern volatile C1RX1B2BITS C1RX1B2bits __attribute__((__sfr__));

extern volatile unsigned int  C1RX1B3 __attribute__((__sfr__));
typedef struct tagC1RX1B3BITS {
  unsigned TXB1D40:1;
  unsigned TXB1D41:1;
  unsigned TXB1D42:1;
  unsigned TXB1D43:1;
  unsigned TXB1D44:1;
  unsigned TXB1D45:1;
  unsigned TXB1D46:1;
  unsigned TXB1D47:1;
  unsigned TXB1D50:1;
  unsigned TXB1D51:1;
  unsigned TXB1D52:1;
  unsigned TXB1D53:1;
  unsigned TXB1D54:1;
  unsigned TXB1D55:1;
  unsigned TXB1D56:1;
  unsigned TXB1D57:1;
} C1RX1B3BITS;
extern volatile C1RX1B3BITS C1RX1B3bits __attribute__((__sfr__));

extern volatile unsigned int  C1RX1B4 __attribute__((__sfr__));
typedef struct tagC1RX1B4BITS {
  unsigned TXB1D60:1;
  unsigned TXB1D61:1;
  unsigned TXB1D62:1;
  unsigned TXB1D63:1;
  unsigned TXB1D64:1;
  unsigned TXB1D65:1;
  unsigned TXB1D66:1;
  unsigned TXB1D67:1;
  unsigned TXB1D70:1;
  unsigned TXB1D71:1;
  unsigned TXB1D72:1;
  unsigned TXB1D73:1;
  unsigned TXB1D74:1;
  unsigned TXB1D75:1;
  unsigned TXB1D76:1;
  unsigned TXB1D77:1;
} C1RX1B4BITS;
extern volatile C1RX1B4BITS C1RX1B4bits __attribute__((__sfr__));

extern volatile unsigned int  C1RX1CON __attribute__((__sfr__));
__extension__ typedef struct tagC1RX1CONBITS {
  union {
    struct {
      unsigned FILHIT:3;
      unsigned RXRTRRO:1;
      unsigned :3;
      unsigned RXFUL:1;
    };
    struct {
      unsigned FILHIT0:1;
      unsigned FILHIT1:1;
      unsigned FILHIT2:1;
    };
  };
} C1RX1CONBITS;
extern volatile C1RX1CONBITS C1RX1CONbits __attribute__((__sfr__));

extern volatile unsigned int  C1RX0SID __attribute__((__sfr__));
__extension__ typedef struct tagC1RX0SIDBITS {
  union {
    struct {
      unsigned RXIDE:1;
      unsigned SRR:1;
      unsigned SID0:1;
      unsigned SID1:1;
      unsigned SID2:1;
      unsigned SID3:1;
      unsigned SID4:1;
      unsigned SID5:1;
      unsigned SID6:1;
      unsigned SID7:1;
      unsigned SID8:1;
      unsigned SID9:1;
      unsigned SID10:1;
    };
    struct {
      unsigned :2;
      unsigned SID:11;
    };
  };
} C1RX0SIDBITS;
extern volatile C1RX0SIDBITS C1RX0SIDbits __attribute__((__sfr__));

extern volatile unsigned int  C1RX0EID __attribute__((__sfr__));
typedef struct tagC1RX0EIDBITS {
  unsigned EID6:1;
  unsigned EID7:1;
  unsigned EID8:1;
  unsigned EID9:1;
  unsigned EID10:1;
  unsigned EID11:1;
  unsigned EID12:1;
  unsigned EID13:1;
  unsigned EID14:1;
  unsigned EID15:1;
  unsigned EID16:1;
  unsigned EID17:1;
} C1RX0EIDBITS;
extern volatile C1RX0EIDBITS C1RX0EIDbits __attribute__((__sfr__));

extern volatile unsigned int  C1RX0DLC __attribute__((__sfr__));
__extension__ typedef struct tagC1RX0DLCBITS {
  union {
    struct {
      unsigned DLC:4;
      unsigned RXRB0:1;
      unsigned :3;
      unsigned RXRB1:1;
      unsigned RXRTR:1;
      unsigned EID0:1;
      unsigned EID1:1;
      unsigned EID2:1;
      unsigned EID3:1;
      unsigned EID4:1;
      unsigned EID5:1;
    };
    struct {
      unsigned :10;
      unsigned EID5_0:6;
    };
    struct {
      unsigned DLC0:1;
      unsigned DLC1:1;
      unsigned DLC2:1;
      unsigned DLC3:1;
    };
  };
} C1RX0DLCBITS;
extern volatile C1RX0DLCBITS C1RX0DLCbits __attribute__((__sfr__));

extern volatile unsigned int  C1RX0B1 __attribute__((__sfr__));
typedef struct tagC1RX0B1BITS {
  unsigned TXB0D00:1;
  unsigned TXB0D01:1;
  unsigned TXB0D02:1;
  unsigned TXB0D03:1;
  unsigned TXB0D04:1;
  unsigned TXB0D05:1;
  unsigned TXB0D06:1;
  unsigned TXB0D07:1;
  unsigned TXB0D10:1;
  unsigned TXB0D11:1;
  unsigned TXB0D12:1;
  unsigned TXB0D13:1;
  unsigned TXB0D14:1;
  unsigned TXB0D15:1;
  unsigned TXB0D16:1;
  unsigned TXB0D17:1;
} C1RX0B1BITS;
extern volatile C1RX0B1BITS C1RX0B1bits __attribute__((__sfr__));

extern volatile unsigned int  C1RX0B2 __attribute__((__sfr__));
typedef struct tagC1RX0B2BITS {
  unsigned TXB0D20:1;
  unsigned TXB0D21:1;
  unsigned TXB0D22:1;
  unsigned TXB0D23:1;
  unsigned TXB0D24:1;
  unsigned TXB0D25:1;
  unsigned TXB0D26:1;
  unsigned TXB0D27:1;
  unsigned TXB0D30:1;
  unsigned TXB0D31:1;
  unsigned TXB0D32:1;
  unsigned TXB0D33:1;
  unsigned TXB0D34:1;
  unsigned TXB0D35:1;
  unsigned TXB0D36:1;
  unsigned TXB0D37:1;
} C1RX0B2BITS;
extern volatile C1RX0B2BITS C1RX0B2bits __attribute__((__sfr__));

extern volatile unsigned int  C1RX0B3 __attribute__((__sfr__));
typedef struct tagC1RX0B3BITS {
  unsigned TXB0D40:1;
  unsigned TXB0D41:1;
  unsigned TXB0D42:1;
  unsigned TXB0D43:1;
  unsigned TXB0D44:1;
  unsigned TXB0D45:1;
  unsigned TXB0D46:1;
  unsigned TXB0D47:1;
  unsigned TXB0D50:1;
  unsigned TXB0D51:1;
  unsigned TXB0D52:1;
  unsigned TXB0D53:1;
  unsigned TXB0D54:1;
  unsigned TXB0D55:1;
  unsigned TXB0D56:1;
  unsigned TXB0D57:1;
} C1RX0B3BITS;
extern volatile C1RX0B3BITS C1RX0B3bits __attribute__((__sfr__));

extern volatile unsigned int  C1RX0B4 __attribute__((__sfr__));
typedef struct tagC1RX0B4BITS {
  unsigned TXB0D60:1;
  unsigned TXB0D61:1;
  unsigned TXB0D62:1;
  unsigned TXB0D63:1;
  unsigned TXB0D64:1;
  unsigned TXB0D65:1;
  unsigned TXB0D66:1;
  unsigned TXB0D67:1;
  unsigned TXB0D70:1;
  unsigned TXB0D71:1;
  unsigned TXB0D72:1;
  unsigned TXB0D73:1;
  unsigned TXB0D74:1;
  unsigned TXB0D75:1;
  unsigned TXB0D76:1;
  unsigned TXB0D77:1;
} C1RX0B4BITS;
extern volatile C1RX0B4BITS C1RX0B4bits __attribute__((__sfr__));

extern volatile unsigned int  C1RX0CON __attribute__((__sfr__));
__extension__ typedef struct tagC1RX0CONBITS {
  union {
    struct {
      unsigned FILHIT0:1;
      unsigned JTOFF:1;
      unsigned DBEN:1;
      unsigned RXRTRRO:1;
      unsigned :3;
      unsigned RXFUL:1;
    };
    struct {
      unsigned FILHIT:1;
      unsigned :1;
      unsigned RXB0DBEN:1;
    };
  };
} C1RX0CONBITS;
extern volatile C1RX0CONBITS C1RX0CONbits __attribute__((__sfr__));

extern volatile unsigned int  C1CTRL __attribute__((__sfr__));
__extension__ typedef struct tagC1CTRLBITS {
  union {
    struct {
      unsigned :1;
      unsigned ICODE:3;
      unsigned :1;
      unsigned OPMODE:3;
      unsigned REQOP:3;
      unsigned CANCKS:1;
      unsigned ABAT:1;
      unsigned CANSIDL:1;
      unsigned CANFRZ:1;
      unsigned CANCAP:1;
    };
    struct {
      unsigned :1;
      unsigned ICODE0:1;
      unsigned ICODE1:1;
      unsigned ICODE2:1;
      unsigned :1;
      unsigned OPMODE0:1;
      unsigned OPMODE1:1;
      unsigned OPMODE2:1;
      unsigned REQOP0:1;
      unsigned REQOP1:1;
      unsigned REQOP2:1;
      unsigned :2;
      unsigned CSIDL:1;
    };
  };
} C1CTRLBITS;
extern volatile C1CTRLBITS C1CTRLbits __attribute__((__sfr__));

extern volatile unsigned int  C1CFG1 __attribute__((__sfr__));
__extension__ typedef struct tagC1CFG1BITS {
  union {
    struct {
      unsigned BRP:6;
      unsigned SJW:2;
    };
    struct {
      unsigned BRP0:1;
      unsigned BRP1:1;
      unsigned BRP2:1;
      unsigned BRP3:1;
      unsigned BRP4:1;
      unsigned BRP5:1;
      unsigned SJW0:1;
      unsigned SJW1:1;
    };
  };
} C1CFG1BITS;
extern volatile C1CFG1BITS C1CFG1bits __attribute__((__sfr__));

extern volatile unsigned int  C1CFG2 __attribute__((__sfr__));
__extension__ typedef struct tagC1CFG2BITS {
  union {
    struct {
      unsigned PRSEG:3;
      unsigned SEG1PH:3;
      unsigned SAM:1;
      unsigned SEG2PHTS:1;
      unsigned SEG2PH:3;
      unsigned :3;
      unsigned WAKFIL:1;
    };
    struct {
      unsigned PRSEG0:1;
      unsigned PRSEG1:1;
      unsigned PRSEG2:1;
      unsigned SEG1PH0:1;
      unsigned SEG1PH1:1;
      unsigned SEG1PH2:1;
      unsigned :2;
      unsigned SEG2PH0:1;
      unsigned SEG2PH1:1;
      unsigned SEG2PH2:1;
    };
  };
} C1CFG2BITS;
extern volatile C1CFG2BITS C1CFG2bits __attribute__((__sfr__));

extern volatile unsigned int  C1INTF __attribute__((__sfr__));
__extension__ typedef struct tagC1INTFBITS {
  union {
    struct {
      unsigned RXB0IF:1;
      unsigned RXB1IF:1;
      unsigned TXB0IF:1;
      unsigned TXB1IF:1;
      unsigned TXB2IF:1;
      unsigned ERRIF:1;
      unsigned WAKIF:1;
      unsigned IRXIF:1;
      unsigned EWARN:1;
      unsigned RXWARN:1;
      unsigned TXWARN:1;
      unsigned RXBP:1;
      unsigned TXBP:1;
      unsigned TXBO:1;
      unsigned RXB1OVFL:1;
      unsigned RXB0OVFL:1;
    };
    struct {
      unsigned RX0IF:1;
      unsigned RX1IF:1;
      unsigned TX0IF:1;
      unsigned TX1IF:1;
      unsigned TX2IF:1;
      unsigned :2;
      unsigned IVRIF:1;
      unsigned :1;
      unsigned RXWAR:1;
      unsigned TXWAR:1;
      unsigned RXEP:1;
      unsigned TXEP:1;
      unsigned :1;
      unsigned RX1OVR:1;
      unsigned RX0OVR:1;
    };
  };
} C1INTFBITS;
extern volatile C1INTFBITS C1INTFbits __attribute__((__sfr__));

extern volatile unsigned int  C1INTE __attribute__((__sfr__));
__extension__ typedef struct tagC1INTEBITS {
  union {
    struct {
      unsigned RXB0IE:1;
      unsigned RXB1IE:1;
      unsigned TXB0IE:1;
      unsigned TXB1IE:1;
      unsigned TXB2IE:1;
      unsigned ERRIE:1;
      unsigned WAKIE:1;
      unsigned IRXIE:1;
    };
    struct {
      unsigned RX0IE:1;
      unsigned RX1IE:1;
      unsigned TX0IE:1;
      unsigned TX1IE:1;
      unsigned TX2IE:1;
      unsigned :2;
      unsigned IVRIE:1;
    };
  };
} C1INTEBITS;
extern volatile C1INTEBITS C1INTEbits __attribute__((__sfr__));

extern volatile unsigned int  C1EC __attribute__((__sfr__));
typedef struct tagC1ECBITS {
  unsigned REC0:1;
  unsigned REC1:1;
  unsigned REC2:1;
  unsigned REC3:1;
  unsigned REC4:1;
  unsigned REC5:1;
  unsigned REC6:1;
  unsigned REC7:1;
  unsigned TEC0:1;
  unsigned TEC1:1;
  unsigned TEC2:1;
  unsigned TEC3:1;
  unsigned TEC4:1;
  unsigned TEC5:1;
  unsigned TEC6:1;
  unsigned TEC7:1;
} C1ECBITS;
extern volatile C1ECBITS C1ECbits __attribute__((__sfr__));

extern volatile unsigned char C1RERRCNT __attribute__((__sfr__));
extern volatile unsigned char C1TERRCNT __attribute__((__sfr__));

/* SFR blocks for each CAN module */
extern volatile CAN CAN2 __attribute__((__sfr__));

extern volatile unsigned int  C2RXF0SID __attribute__((__sfr__));
__extension__ typedef struct tagC2RXF0SIDBITS {
  union {
    struct {
      unsigned EXIDE:1;
      unsigned :1;
      unsigned SID0:1;
      unsigned SID1:1;
      unsigned SID2:1;
      unsigned SID3:1;
      unsigned SID4:1;
      unsigned SID5:1;
      unsigned SID6:1;
      unsigned SID7:1;
      unsigned SID8:1;
      unsigned SID9:1;
      unsigned SID10:1;
    };
    struct {
      unsigned :2;
      unsigned SID:11;
    };
  };
} C2RXF0SIDBITS;
extern volatile C2RXF0SIDBITS C2RXF0SIDbits __attribute__((__sfr__));

extern volatile unsigned int  C2RXF0EIDH __attribute__((__sfr__));
typedef struct tagC2RXF0EIDHBITS {
  unsigned EID6:1;
  unsigned EID7:1;
  unsigned EID8:1;
  unsigned EID9:1;
  unsigned EID10:1;
  unsigned EID11:1;
  unsigned EID12:1;
  unsigned EID13:1;
  unsigned EID14:1;
  unsigned EID15:1;
  unsigned EID16:1;
  unsigned EID17:1;
} C2RXF0EIDHBITS;
extern volatile C2RXF0EIDHBITS C2RXF0EIDHbits __attribute__((__sfr__));

extern volatile unsigned int  C2RXF0EIDL __attribute__((__sfr__));
__extension__ typedef struct tagC2RXF0EIDLBITS {
  union {
    struct {
      unsigned :10;
      unsigned EID0:1;
      unsigned EID1:1;
      unsigned EID2:1;
      unsigned EID3:1;
      unsigned EID4:1;
      unsigned EID5:1;
    };
    struct {
      unsigned :10;
      unsigned EID5_0:6;
    };
  };
} C2RXF0EIDLBITS;
extern volatile C2RXF0EIDLBITS C2RXF0EIDLbits __attribute__((__sfr__));

extern volatile unsigned int  C2RXF1SID __attribute__((__sfr__));
__extension__ typedef struct tagC2RXF1SIDBITS {
  union {
    struct {
      unsigned EXIDE:1;
      unsigned :1;
      unsigned SID0:1;
      unsigned SID1:1;
      unsigned SID2:1;
      unsigned SID3:1;
      unsigned SID4:1;
      unsigned SID5:1;
      unsigned SID6:1;
      unsigned SID7:1;
      unsigned SID8:1;
      unsigned SID9:1;
      unsigned SID10:1;
    };
    struct {
      unsigned :2;
      unsigned SID:11;
    };
  };
} C2RXF1SIDBITS;
extern volatile C2RXF1SIDBITS C2RXF1SIDbits __attribute__((__sfr__));

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
  unsigned TXB1D47:1;
  unsigned TXB1D50:1;
  unsigned TXB1D51:1;
  unsigned TXB1D52:1;
  unsigned TXB1D53:1;
  unsigned TXB1D54:1;
  unsigned TXB1D55:1;
  unsigned TXB1D56:1;
  unsigned TXB1D57:1;
} C2TX1B3BITS;
extern volatile C2TX1B3BITS C2TX1B3bits __attribute__((__sfr__));

extern volatile unsigned int  C2TX1B4 __attribute__((__sfr__));
typedef struct tagC2TX1B4BITS {
  unsigned TXB1D60:1;
  unsigned TXB1D61:1;
  unsigned TXB1D62:1;
  unsigned TXB1D63:1;
  unsigned TXB1D64:1;
  unsigned TXB1D65:1;
  unsigned TXB1D66:1;
  unsigned TXB1D67:1;
  unsigned TXB1D70:1;
  unsigned TXB1D71:1;
  unsigned TXB1D72:1;
  unsigned TXB1D73:1;
  unsigned TXB1D74:1;
  unsigned TXB1D75:1;
  unsigned TXB1D76:1;
  unsigned TXB1D77:1;
} C2TX1B4BITS;
extern volatile C2TX1B4BITS C2TX1B4bits __attribute__((__sfr__));

extern volatile unsigned int  C2TX1CON __attribute__((__sfr__));
__extension__ typedef struct tagC2TX1CONBITS {
  union {
    struct {
      unsigned TXPRI:2;
      unsigned :1;
      unsigned TXREQ:1;
      unsigned TXERR:1;
      unsigned TXLARB:1;
      unsigned TXABT:1;
    };
    struct {
      unsigned TXPRI0:1;
      unsigned TXPRI1:1;
    };
  };
} C2TX1CONBITS;
extern volatile C2TX1CONBITS C2TX1CONbits __attribute__((__sfr__));
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
