lhr-solar/BPS/BSP/STM32F413/Src/BSP_CAN.c

/* Copyright (c) 2018-2022 UT Longhorn Racing Solar */

#include "BSP_CAN.h"
#include "CANMetaData.h"
#include "Interrupt_Priorities.h"
#include "stm32f4xx.h"
#include "os.h"
#include "Tasks.h"

// The message information that we care to receive
typedef struct _msg {
    uint32_t id;
    uint8_t data[8];
} msg_t;

// Set up a fifo for receiving
#define FIFO_TYPE msg_t
#define FIFO_SIZE 10
#define FIFO_NAME msg_queue
#include "fifo.h"

#define BSP_CAN_IDS_PER_FILTER  4
#define BSP_CAN_NUM_FILTERS     28

static msg_queue_t gRxQueue;

// Required for receiving CAN messages
static CanTxMsg gTxMessage;
static CanRxMsg gRxMessage;

// User parameters for CAN events
static void (*gRxEvent)(void);
static void (*gTxEnd)(void);

/**
 * @brief   Initializes the CAN module that communicates with the rest of the electrical system.
 * @param   rxEvent       : the function to execute when recieving a message. NULL for no action.
 * @param   txEnd         : the function to execute after transmitting a message. NULL for no action.
 * @param   faultState    : if we should initialize CAN interrupts
 * @param   loopback      : if we should use loopback mode (for testing)
 * @param   txIDFilter    : array of IDs to accept messages from. Pass NULL for no filtering.
 * @param   txIDFilterLen : length of txIDFilter array. Max 28 * 4 (28 filter banks * 4 IDs per bank)
 * @return  None
 */
void BSP_CAN_Init(callback_t rxEvent, 
                  callback_t txEnd, 
                  bool faultState, 
                  bool loopback,
                  uint16_t *txIDFilter,
                  uint8_t txIDFilterLen) {
    GPIO_InitTypeDef GPIO_InitStructure;
    CAN_InitTypeDef CAN_InitStructure;
    NVIC_InitTypeDef NVIC_InitStructure;
    CAN_FilterInitTypeDef CAN_FilterInitStructure;

    // Configure event handles
    gRxEvent  = rxEvent;
    gTxEnd    = txEnd;

    // Initialize the queue
    gRxQueue = msg_queue_new();

    /* CAN GPIOs configuration **************************************************/

    /* Enable GPIO clock */
    RCC_AHB1PeriphClockCmd(RCC_AHB1Periph_GPIOB, ENABLE);

    /* Connect CAN pins to AF9 */
    GPIO_PinAFConfig(GPIOB, GPIO_PinSource8, GPIO_AF8_CAN1);
    GPIO_PinAFConfig(GPIOB, GPIO_PinSource9, GPIO_AF8_CAN1); 

    /* Configure CAN RX and TX pins */
    GPIO_InitStructure.GPIO_Pin = GPIO_Pin_8 | GPIO_Pin_9;
    GPIO_InitStructure.GPIO_Mode = GPIO_Mode_AF;
    GPIO_InitStructure.GPIO_Speed = GPIO_Speed_50MHz;
    GPIO_InitStructure.GPIO_OType = GPIO_OType_PP;
    GPIO_InitStructure.GPIO_PuPd  = GPIO_PuPd_UP;
    GPIO_Init(GPIOB, &GPIO_InitStructure);

    /* CAN configuration ********************************************************/  
    /* Enable CAN clock */
    RCC_APB1PeriphClockCmd(RCC_APB1Periph_CAN1, ENABLE);

    /* CAN register init */

    /* CAN cell init */
    CAN_InitStructure.CAN_TTCM = DISABLE;
    CAN_InitStructure.CAN_ABOM = DISABLE;
    CAN_InitStructure.CAN_AWUM = DISABLE;
    CAN_InitStructure.CAN_NART = DISABLE;
    CAN_InitStructure.CAN_RFLM = DISABLE;
    CAN_InitStructure.CAN_TXFP = ENABLE;    // I don't think we picked BPS CAN IDs in order of importance anyway, so I'll just make this a FIFO
    CAN_InitStructure.CAN_Mode = (loopback ? CAN_Mode_LoopBack: CAN_Mode_Normal);
    CAN_InitStructure.CAN_SJW  = CAN_SJW_1tq;

    /* CAN Baudrate = 125 KBps
    * 1/(prescalar + (prescalar*BS1) + (prescalar*BS2)) * Clk = CAN Baudrate
    * The CAN clk is currently set to 20MHz (APB1 clock set to 20MHz in BSP_PLL_Init())
    */
    CAN_InitStructure.CAN_BS1 = CAN_BS1_3tq;
    CAN_InitStructure.CAN_BS2 = CAN_BS2_4tq; 
    CAN_InitStructure.CAN_Prescaler = 20;
    CAN_Init(CAN1, &CAN_InitStructure);

    /* CAN filter init
    *  Do nothing if we want to filter too many IDs
    */
    if (txIDFilter && (txIDFilterLen <= BSP_CAN_IDS_PER_FILTER * BSP_CAN_NUM_FILTERS)) {
        CAN_FilterInitStructure.CAN_FilterNumber = 0;
        CAN_FilterInitStructure.CAN_FilterMode = CAN_FilterMode_IdList;
        CAN_FilterInitStructure.CAN_FilterScale = CAN_FilterScale_16bit;
        CAN_FilterInitStructure.CAN_FilterFIFOAssignment = 0;
        CAN_FilterInitStructure.CAN_FilterActivation = ENABLE;

        uint16_t *filter_fields[BSP_CAN_IDS_PER_FILTER] = {
            &CAN_FilterInitStructure.CAN_FilterIdHigh,
            &CAN_FilterInitStructure.CAN_FilterIdLow,
            &CAN_FilterInitStructure.CAN_FilterMaskIdHigh,
            &CAN_FilterInitStructure.CAN_FilterMaskIdLow
        };

        uint8_t num_ids_rounded = ((txIDFilterLen + BSP_CAN_IDS_PER_FILTER - 1)
                                      / BSP_CAN_IDS_PER_FILTER)
                                  * BSP_CAN_IDS_PER_FILTER; // round up
        for (uint8_t i = 0; i < num_ids_rounded; i++) {
            // loop through a rounded-up number of IDs, that way we can fill in the empty 
            // filter banks with 0s.
            *filter_fields[i % BSP_CAN_IDS_PER_FILTER] = (i < txIDFilterLen) ? (txIDFilter[i] << 5) : 0x0000;
            if (i % BSP_CAN_IDS_PER_FILTER == 3) {
                CAN_FilterInit(CAN1, &CAN_FilterInitStructure);
                CAN_FilterInitStructure.CAN_FilterNumber++;
            }
        }
    }
    else {
        // no filter
        CAN_FilterInitStructure.CAN_FilterNumber = 0;
        CAN_FilterInitStructure.CAN_FilterMode = CAN_FilterMode_IdMask;
        CAN_FilterInitStructure.CAN_FilterScale = CAN_FilterScale_32bit;
        CAN_FilterInitStructure.CAN_FilterIdHigh = 0x0000;
        CAN_FilterInitStructure.CAN_FilterIdLow = 0x0000;
        CAN_FilterInitStructure.CAN_FilterMaskIdHigh = 0x0000;
        CAN_FilterInitStructure.CAN_FilterMaskIdLow = 0x0000;
        CAN_FilterInitStructure.CAN_FilterFIFOAssignment = 0;
        CAN_FilterInitStructure.CAN_FilterActivation = ENABLE;
        CAN_FilterInit(CAN1, &CAN_FilterInitStructure);
    }

    /* Transmit Structure preparation */
    gTxMessage.ExtId = 0x1;
    gTxMessage.RTR = CAN_RTR_DATA;
    gTxMessage.IDE = CAN_ID_STD;
    gTxMessage.DLC = 1;

    /* Receive Structure preparation */
    gRxMessage.StdId = 0x00;
    gRxMessage.ExtId = 0x00;
    gRxMessage.IDE = CAN_ID_STD;
    gRxMessage.DLC = 0;
    gRxMessage.FMI = 0;

    /* Enable interrupts if in normal state */
    if(!faultState){
        /* Enable FIFO 0 message pending Interrupt */
        CAN_ITConfig(CAN1, CAN_IT_FMP0, ENABLE);

        // Enable Rx interrupts
        NVIC_InitStructure.NVIC_IRQChannel = CAN1_RX0_IRQn;
        NVIC_InitStructure.NVIC_IRQChannelPreemptionPriority = CAN1_RX0_PREEMPT_PRIO;
        NVIC_InitStructure.NVIC_IRQChannelSubPriority = CAN1_RX0_SUB_PRIO;
        NVIC_InitStructure.NVIC_IRQChannelCmd = ENABLE;
        NVIC_Init(&NVIC_InitStructure);	

        if(NULL != txEnd) {
            // set up CAN Tx interrupts
            CAN_ITConfig(CAN1, CAN_IT_TME, ENABLE);

            // Enable Tx Interrupts
            NVIC_InitStructure.NVIC_IRQChannel = CAN1_TX_IRQn;
            NVIC_InitStructure.NVIC_IRQChannelPreemptionPriority = CAN1_TX_PREEMPT_PRIO; // TODO: assess both of these priority settings
            NVIC_InitStructure.NVIC_IRQChannelSubPriority = CAN1_TX_SUB_PRIO;
            NVIC_InitStructure.NVIC_IRQChannelCmd = ENABLE;
            NVIC_Init(&NVIC_InitStructure);
        }
    }
}

/**
 * @brief   Calls stm-level CAN_DeInit
 * @return  None
 */
void BSP_CAN_DeInit() {
    CAN_DeInit(CAN1);
}

/**
 * @brief   Transmits the data onto the CAN bus with the specified id
 * @param   id : Message of ID. Also indicates the priority of message. The lower the value, the higher the priority.
 * @param   data : data to be transmitted. The max is 8 bytes.
 * @param   length : num of bytes of data to be transmitted. This must be <= 8 bytes or else the rest of the message is dropped.
 * @return  ERROR if module was unable to transmit the data onto the CAN bus. SUCCESS indicates data was transmitted.
 */
ErrorStatus BSP_CAN_Write(uint32_t id, uint8_t data[], uint8_t length) {
    ErrorStatus retVal = SUCCESS;
    
    if (length > 8) {
        return ERROR;
    }

    gTxMessage.StdId = id;
    gTxMessage.DLC = length;

	for(int i = 0; i < length; i++){
        gTxMessage.Data[i] = data[i];
    }

    uint8_t mailbox = CAN_Transmit(CAN1, &gTxMessage);
    
    if (mailbox == CAN_TxStatus_NoMailBox) {
        retVal = ERROR;
    }

    return retVal;
}

/**
 * @brief   Gets the data that was received from the CAN bus.
 * @note    Non-blocking statement
 * @pre     The data parameter must be at least 8 bytes or hardfault may occur.
 * @param   id : pointer to store id of the message that was received.
 * @param   data : pointer to store data that was received. Must be 8bytes or bigger.
 * @return  ERROR if nothing was received so ignore id and data that was received. SUCCESS indicates data was received and stored.
 */
ErrorStatus BSP_CAN_Read(uint32_t *id, uint8_t *data) {
    // If the queue is empty, return err
    if(msg_queue_is_empty(&gRxQueue)) {
        return ERROR;
    }
    
    // Get the message
    msg_t msg;
    msg_queue_get(&gRxQueue, &msg);

    // Transfer the message to the provided pointers
    for(int i = 0; i < 8; i++){
        data[i] = msg.data[i];
    }
    *id = msg.id;

    return SUCCESS;
}

// This probably doesn't work because it's missing the equivalent fixes to the Tx Handler,
// but it isn't part of the BPS requirements, so I'm not going to mess with it until I need it 
void CAN1_RX0_IRQHandler(void) {
    #ifdef RTOS //TODO: Replace with RTOS independent code (i.e replae with wrappers)
    CPU_SR_ALLOC();
    CPU_CRITICAL_ENTER();
    OSIntEnter();
    CPU_CRITICAL_EXIT();
    #endif

    // Take any pending messages into a queue
    while(CAN_MessagePending(CAN1, CAN_FIFO0)) {
        CAN_Receive(CAN1, CAN_FIFO0, &gRxMessage);

        msg_t rxMsg;
        rxMsg.id = gRxMessage.StdId;
        memcpy(&rxMsg.data[0], gRxMessage.Data, 8);

        // Place the message in the queue
        if(msg_queue_put(&gRxQueue, rxMsg)) {
            // If the queue was not already full...
            // Call the driver-provided function, if it is not null
            if(gRxEvent != NULL) {
                gRxEvent();
            }
        } else {
            // If the queue is already full, then we can't really do anything else
            break;
        }
    }

    #ifdef RTOS
    OSIntExit();      // Signal to uC/OS
    #endif
}

void CAN1_TX_IRQHandler(void) {
    #ifdef RTOS
    CPU_SR_ALLOC();
    CPU_CRITICAL_ENTER();
    OSIntEnter();
    CPU_CRITICAL_EXIT();
    #endif

    // Acknowledge 
    CAN_ClearFlag(CAN1, CAN_FLAG_RQCP0 | CAN_FLAG_RQCP1 | CAN_FLAG_RQCP2);

    // Call the function provided
    gTxEnd();

    #ifdef RTOS
    OSIntExit();      // Signal to uC/OS
    #endif
}
