lhr-solar/BPS/BSP/STM32F413/Src/BSP_PWM.c

/* Copyright (c) 2018-2022 UT Longhorn Racing Solar */

#include "BSP_PWM.h"

GPIO_InitTypeDef GPIO_INIT_STRUCT; //struct used to initialize pins
TIM_OCInitTypeDef TIMER_OC_STRUCT; //struct used to configure output compare for timers
TIM_TimeBaseInitTypeDef TIMER_INIT_STRUCT; //struct used to initialize PWM timers


/**
 * @brief   Sets up contactor and fan pin timers for outputting PWM signals
 * @note    GPIO_B0 = contactor
 * @note    GPIO_C6, GPIO_C7, GPIO_B14, GPIO_B15 are for fans
 */
void BSP_PWM_Init(void){
    //initialize all pins pertaining to fans and contactors for PWM here

    //Enable TIM 3,8,12
    RCC_APB1PeriphClockCmd(RCC_APB1Periph_TIM3, ENABLE);
    RCC_APB2PeriphClockCmd(RCC_APB2Periph_TIM8, ENABLE);
    RCC_APB1PeriphClockCmd(RCC_APB1Periph_TIM12, ENABLE);

    //Enable Port Clocks
	RCC_AHB1PeriphClockCmd(RCC_AHB1Periph_GPIOA, ENABLE);
	RCC_AHB1PeriphClockCmd(RCC_AHB1Periph_GPIOB, ENABLE); //HV Contactor
	RCC_AHB1PeriphClockCmd(RCC_AHB1Periph_GPIOC, ENABLE);

    //Configure TIM pins by configuring corresponding GPIO pins
    GPIO_PinAFConfig(GPIOB, GPIO_PinSource0, GPIO_AF_TIM3); //this one will always be contactor
    GPIO_PinAFConfig(GPIOC, GPIO_PinSource6, GPIO_AF_TIM8);
    GPIO_PinAFConfig(GPIOC, GPIO_PinSource7, GPIO_AF_TIM8);
    GPIO_PinAFConfig(GPIOB, GPIO_PinSource14, GPIO_AF_TIM12);
    GPIO_PinAFConfig(GPIOB, GPIO_PinSource15, GPIO_AF_TIM12);

    //All pins will be initialized for alternate function
    GPIO_INIT_STRUCT.GPIO_Mode = GPIO_Mode_AF;
    GPIO_INIT_STRUCT.GPIO_Speed = GPIO_Speed_2MHz;
    GPIO_INIT_STRUCT.GPIO_PuPd = GPIO_PuPd_DOWN;
    GPIO_INIT_STRUCT.GPIO_OType = GPIO_OType_PP;
    //Initialize Pin PC6, PC7
    GPIO_INIT_STRUCT.GPIO_Pin = GPIO_Pin_6 | GPIO_Pin_7;
    GPIO_Init(GPIOC, &GPIO_INIT_STRUCT);
    //Initialize Pin PB14, PB15
    GPIO_INIT_STRUCT.GPIO_Pin = GPIO_Pin_14 | GPIO_Pin_15 | GPIO_Pin_0;
    GPIO_Init(GPIOB, &GPIO_INIT_STRUCT);

    //Configure Time base unit
	TIMER_INIT_STRUCT.TIM_Period = PWM_PERIOD;
  	TIMER_INIT_STRUCT.TIM_Prescaler = 0x0000;
	TIMER_INIT_STRUCT.TIM_ClockDivision = TIM_CKD_DIV1;
	TIMER_INIT_STRUCT.TIM_CounterMode = TIM_CounterMode_Up;
	TIMER_INIT_STRUCT.TIM_RepetitionCounter = 0x0000;
    TIM_TimeBaseInit(TIM3, &TIMER_INIT_STRUCT);
    TIM_TimeBaseInit(TIM8, &TIMER_INIT_STRUCT);
    TIM_TimeBaseInit(TIM12, &TIMER_INIT_STRUCT);

    //Fill in TIM_OCInitStruct with desired parameters
	TIMER_OC_STRUCT.TIM_OCMode = TIM_OCMode_PWM1;
	TIMER_OC_STRUCT.TIM_OutputState = TIM_OutputState_Enable;
	TIMER_OC_STRUCT.TIM_OutputNState = TIM_OutputNState_Disable;
	TIMER_OC_STRUCT.TIM_Pulse = 0; //start with everything off
	TIMER_OC_STRUCT.TIM_OCPolarity = TIM_OCPolarity_High;
	TIMER_OC_STRUCT.TIM_OCNPolarity = TIM_OCPolarity_High;
	TIMER_OC_STRUCT.TIM_OCIdleState = TIM_OCIdleState_Reset;
	TIMER_OC_STRUCT.TIM_OCNIdleState = TIM_OCNIdleState_Reset;
	//Configure all channels with the output compare
    TIM_OC3Init(TIM3, &TIMER_OC_STRUCT);
    TIM_OC1Init(TIM8, &TIMER_OC_STRUCT);
    TIM_OC2Init(TIM8, &TIMER_OC_STRUCT);
    TIM_OC1Init(TIM12, &TIMER_OC_STRUCT);
    TIM_OC2Init(TIM12, &TIMER_OC_STRUCT);

    //Enable the output compare preload on all channels
    TIM_OC3PreloadConfig(TIM3, TIM_OCPreload_Enable);
    TIM_OC1PreloadConfig(TIM8, TIM_OCPreload_Enable);
    TIM_OC2PreloadConfig(TIM8, TIM_OCPreload_Enable);
    TIM_OC1PreloadConfig(TIM12, TIM_OCPreload_Enable);
    TIM_OC2PreloadConfig(TIM12, TIM_OCPreload_Enable);

    TIM_ARRPreloadConfig(TIM12, ENABLE);

    TIM_CtrlPWMOutputs(TIM8, ENABLE);

    //Enable the TIM8 counter
    TIM_Cmd(TIM3, ENABLE);
    TIM_Cmd(TIM8, ENABLE);
    TIM_Cmd(TIM12, ENABLE);
    //END OF PWM Init method

    //This deals with setting up the input pin for the contactor
    //setup the input pin
    GPIO_InitTypeDef GPIO_B1Init;
    GPIO_B1Init.GPIO_Pin = GPIO_Pin_1; //input pin is gpio B1
    GPIO_B1Init.GPIO_Mode = GPIO_Mode_IN;
    GPIO_B1Init.GPIO_Speed = GPIO_Speed_2MHz;
    GPIO_B1Init.GPIO_PuPd = GPIO_PuPd_UP;
    GPIO_B1Init.GPIO_OType = GPIO_OType_PP;
    GPIO_Init(GPIOB, &GPIO_B1Init);
}

/**
 * @brief   Sets the PWM duty cycle of a specific pin
 * @note
 * @param   pin Which pin to set the speed. Pins 0-3 are defined to be on the fan board, and pin 4 is the contactor output
 * @param   speed The value to write to the output compare register. The timer counts up from 0 to 4000, so speed must be between 0-4000
 * @return  ErrorStatus will return 1 if successful, 0 if there were problems
 */
ErrorStatus BSP_PWM_Set(uint8_t pin, uint32_t speed){
    //Range of pulse is 0-4000
    //First check to make sure that change is within range of values
    //Load new value into Compare and Capture Register
    if (speed > 4000) speed = 4000;

    switch (pin)
    {
    case 0:
        TIM_SetCompare1(TIM8, speed);
        return SUCCESS;
        break;
    case 1:
        TIM_SetCompare2(TIM8, speed);
        return SUCCESS;
        break;
    case 2:
        TIM_SetCompare1(TIM12, speed);
        return SUCCESS;
        break;
    case 3:
        TIM_SetCompare2(TIM12, speed);
        return SUCCESS;
        break;
    case 4:
        TIM_SetCompare3(TIM3, speed);
        return SUCCESS;
        break;
    default:
        return ERROR; //invalid fan value
        break;
    }
}

/**
 * @brief   Gets the PWM duty cycle of a pin.
 * @param   pin The pin to get the duty cycle from
 * @return  The value inside the output compare register. You will need to math to convert this to an actual duty cycle. Returns -1 if input pin is invalid
 */
int BSP_PWM_Get(uint8_t pin){
    switch (pin)
    {
    case 0:
        return TIM_GetCapture1(TIM8);
        break;
    case 1:
        return TIM_GetCapture2(TIM8);
        break;
    case 2:
        return TIM_GetCapture1(TIM12);
        break;
    case 3:
        return TIM_GetCapture2(TIM12);
        break;
    case 4:
        return TIM_GetCapture3(TIM3);
        break;
    default:
        return -1;
    }
}

/**
 * @brief   Gets the state of the Contactor switch from one of its AUX pins.
 * @note	THIS IS ALSO CODE THAT HAS NO HOME. You cannot get the state of ALL_CONTACTORS. As such, if that param is passed, it will return the state of the array contactor.
 * @param   Contactor to get state of, contactorChoice should be only 3 or 4
 * @return  0 if contactor is off/open, 1 if on/closed
 */
bool BSP_Contactor_Get(uint8_t contactorChoice) {

  bool contactorReturnValue = false;

  if(contactorChoice == 4) {
	  contactorReturnValue = ((GPIOB->IDR & GPIO_Pin_1) >> 1) ? 0 : 1; //read the one and only input pin
  }
  else if(contactorChoice == 3) {
    contactorReturnValue = (TIM_GetCapture2(TIM12)) ? 1 : 0;
  }

  /* this is future support for multiple contactors, but we only have one pin right now
	bool contactorReturnValue = false;
	if (contactorChoice == ARRAY_CONTACTOR) {
		contactorReturnValue = ((C1_PORT->IDR & GPIO_Pin_1) >> 1) ? 0 : 1;
	}
	else if (contactorChoice == HVHIGH_CONTACTOR) {
		contactorReturnValue = ((C2_PORT->IDR & GPIO_Pin_5) >> 5) ? 0 : 1;
	}
	else if (contactorChoice == HVLOW_CONTACTOR) {
		contactorReturnValue = ((C3_PORT->IDR & GPIO_Pin_1) >> 1) ? 0 : 1;
	}
	else if (contactorChoice == ALL_CONTACTORS) {
		// return if ANY of the contactors are off.
		contactorReturnValue = (((C1_PORT->IDR & GPIO_Pin_1) >> 1) ? 0 : 1)
			&& (((C2_PORT->IDR & GPIO_Pin_5) >> 5) ? 0 : 1)
			&& (((C3_PORT->IDR & GPIO_Pin_1) >> 1) ? 0 : 1);
	}
	*/
	return contactorReturnValue;
}
