lhr-solar/BPS/(commit log)

2016-06-20 Two sockets now used, one for receiving one for transmiting
    One socket for designated file transfers and data transfers in the back
    ground so the other socket can still interact with the client and append
    the transfer queues when needed.
2016-06-20 File Locking
    Added in file locking from an outside library to prevent multiple
    threads of accessing a file at once
2017-01-17 merged with dbServer
    added in data log of server flow ability
2017-01-18 Been playing with different ways to optimize
    not sure if anything has changed as a lot of the potential optimizations failed due to a TCP packet tendency to come in out of order in the socket buffer so im just resubmitting for safe checking
2017-09-13 added a couple more parsing features
2017-09-13 added threading and writing support
2017-10-21 D102117 - Autosend digits 0-9 for range test, LED color buttons
2018-01-28 Known working BPS code by Fred. Check BPS report on google drive before uploading code to the boards.
    [config.TXT]
2018-01-28 CAN library with test code. Have not tested on Nucleo boards yet.
2018-01-30 Corrected checking if CAN stack is full.
    [CAN_lib.cpp]
2018-02-10 CAN bus operational
2018-02-10 Motor Driver Code
2018-03-29 CAN Snooper: Added KiCad project with schematic and PCB design.
    [BOM.csv, Nucleo_CAN.kicad_pcb, Nucleo_CAN.sch]
2018-04-17 CAN Snooper: Schematic: Merge PWR and CAN connectors; bump rev.
    In order to facilitate easy power and CAN connection, I've combined
    the two into a single connector rather than two separate screw
    terminals. Additionally, I've added a duplicate connector to make
    chaining CAN connections simple, removing the need for splitters or
    radial bus layouts.
    I created a schematic symbol for our connector to make sure that we
    use a consistent pinout across our designs.
    Regenerated Schematic Preview for team members without KiCad.
    [Nucleo_CAN.sch]
2018-04-17 CAN Snooper: Added MiniFitJr-4-peg footprint; regenerated netlist.
    The connector we plan to use for power and CAN is a Molex Mini-Fit Jr
    with 4 pins (Molex calls them "circuits"). The most compact of those
    designs uses "pegs" to secure itself to the board.
    I designed a footprint for this connector and assigned it to the two
    connector footprints we have on the schematic, then regenerated the
    netlist.
    [Nucleo_CAN.sch]
2018-04-17 CAN Snooper: PCB: Rerouted for new connectors; bumped PCB rev.
    I reimported the netlist into the PCB and rerouted the car side of the
    board to accommodate the new connectors. I also added a ground plane
    to the computer side of the board and rerouted its traces to
    accommodate said plane.
    [Nucleo_CAN.kicad_pcb]
2018-04-20 CAN Snooper: PCB: Use nonplated M2 screw mounting holes
    The previous mounting holes were a nonstandard size as far as I could
    tell, so I replaced them with properly sized holes for M2 screws. I
    also added circles in the Dwgs.User layer to indicate estimated screw
    head size.
    The components on the PCB may need to be moved around to make sure the
    screw heads fit completely onto the PCB unobstructed.
    Added three new footprints for mounting holes for metric screw sizes
    M1.6, M1.8, and M2. Removed the old mounting hole footprint.
    [Nucleo_CAN.kicad_pcb]
2018-04-20 CAN Snooper: PCB: Draw F.CrtYd of Nucleo Headers
    The electrical connections for the Nucleo were layed out, but there
    wasn't a front courtyard for the body of the headers. I've drawn some
    now based on the dimensions of the Samtec SSW series of headers.
    [Nucleo_CAN.kicad_pcb]
2018-04-20 CAN Snooper: PCB: Rearranged screw holes and stretched board
    In order to give the mounting screws proper clearance and to fully
    contain the screw heads on top of the board, I moved the screw holes
    around and stretched the board size by approximately 0.16 sq.in.
    [Nucleo_CAN.kicad_pcb]
2018-04-20 CAN Snooper: PCB: Fix thermal relief settings on computer GND plane
    The thermal relief settings on the computer side GND plane weren't the
    same as the settings on the car side GND plane. I have now reduced the
    thermal relief clearance and spoke widths on the computer side to
    match those on the car side.
    Additionally, in order to fix some plane routing issues on the
    computer side, I had overriden the relief clearance on two
    computer-side GND pins on the CAN chip. With the new plane settings,
    these overrides aren't necessary anymore, so I returned those pads to
    their default clearance.
    [Nucleo_CAN.kicad_pcb]
2018-04-20 CAN Snooper: PCB: Added printing instructions; regenerated previews
    [Nucleo_CAN.kicad_pcb]
2018-04-21 Current Slave library
2018-04-23 CAN_Snooper: PCB: Increase CAN power trace width to 1.5mm
    In order to allow proper power transfer between the two CAN connectors
    (that is, along the CAN bus), I increased the trace width of the 12V
    line between the connectors and the spoke width on the ground pins of
    the connectors. This should allow at least 4A of current without
    heating the trace more than 10degC.
    [Nucleo_CAN.kicad_pcb]
2018-04-23 CAN_Snooper: Add mounting hole dimensions; page size is US Letter
    [Nucleo_CAN.kicad_pcb]
2018-04-24 CAN Snooper: Retitled schematic and pcb design "Nucleo-CAN Interface".
    [Nucleo_CAN.kicad_pcb, Nucleo_CAN.sch]
2018-04-24 CAN Snooper: Schematic: Page size is US Letter; rearranged blocks.
    [Nucleo_CAN.sch]
2018-04-24 CAN Snooper: PCB: Bumped rev; added identifying labels to silkscreen.
    The front silkscreen now contains the revision number in a visible
    location, and the back silkscreen now contains in a large font our
    organization's name and the board's title.
    [Nucleo_CAN.kicad_pcb]
2018-04-24 CAN Snooper: Regenerated PDF previews of schematic and PCB.
2018-04-24 Nucleo CAN: Rename project directory from "CAN Snooper"
    To better fit the more generic role of this board, I've renamed the
    project directory to "Nucleo CAN" rather than "CAN Snooper". I believe
    this name will be clearer.
    [BOM.csv, Nucleo_CAN.kicad_pcb, Nucleo_CAN.sch]
2018-09-04 Organized the BPS code into Legacy (Fred's) and BeVolt's new system. Better documented CAN library that all system can use. Created skeleton code for new BPS.
    [config.TXT]
2018-09-04 Deleted unnecessary file (CurrentTestMain.cpp)
2018-09-15 Skeleton code for the watch dog timer for the BPS has been added
2018-09-15 Created Keil environment. Note, if debugger doesn't work, add file manually. Ask Sijin.
    [Contactor.h, EEPROM.h, Temperature.h, Voltage.h]
2018-09-15 Clean up, add Def.h, avoid errors.
    [Temperature.h, Voltage.h]
2018-09-15 Added device selection pins for EEPROM. Uses PA10-PA12.
2018-09-29 Switching over to C language. WIll have a lot of errors in IDE.
    [EEPROM.c, LTC6811.c, LTC6811.h, Temperature.c, Voltage.c, main.c]
2018-09-29 More driver sort of things (mostly 6811)
2018-10-03 Added the files for the gyro that's still on order
2018-10-06 Added low-level drivers (SPI.c). Added debugging code for everyone to use in PuTTy.
2018-10-11 MPPT: First stab at recreating the original schematic.
    In order to improve upon the previous design which seems to have gone missing, I'm recreating it and reorganizing the components to make the schematic more clear.
    The CAN circuitry has been split into a separate breakout board, so it doesn't need to be included in this schematic.
    Current progress:
    * DC/DC Converter recreated
    * Voltage Sensors recreated
    Still to do:
    * Power Regulation and Isolation
    * Current Sensors
    * FET driver
    * Nucleo connections
    * Snubber values and diode direction.
    [MPPT.kicad_pcb, MPPT.sch]
2018-10-11 Electronics: Extracted common schematic components from Nucleo_CAN project into libraries in Electronics/Common/.
2018-10-11 MPPT: Add power lines and regulators
    There are three primary power regions on the board: the high power regions around the DC/DC Converter, the car's "low" power regions (+12V), and the low power regions around the Nucleo.
    The high power regions include current sensors and FET drivers which require power from the car's low power line rather than the high power lines from the solar array and the battery. We use a 12V-12V DC isolator to provide this safely.
    We also isolate power to the Nucleo for safety when attaching a computer to the board. Finally, the CAN lines have an isolated power region, but this is managed by the CAN chip.
    [MPPT.sch]
2018-10-11 Electronics: Add FET Driver chip and datasheet
2018-10-11 MPPT: Add FET driver and its Nucleo connection
    The FET driver doesn't provide any isolation, and it needs to be on the High Power plane, so we will need to add isolation on its PWM input to protect the Nucleo.
    We should also figure out whether tying the chip's Enable pin to the PWM input is appropriate or not. According to the datasheet, the enable pin is internally pulled up to Vdd by a 100Kohm resistor, so it may draw unexpected current from the PWM line.
    [MPPT.sch]
2018-10-11 MPPT: Add current sensors and current/voltage sensor connections to Nucleo
    I moved the current sensors from the high-side to the low-side for safety reasons - namely, the common-mode voltage has now dropped from >60V to ~0V. I also renamed the sensors from In/Out to Array/Battery for clarity's sake.
    I still need to add isolation between the Nucleo and the sensors and FET driver, since these are in two very different power regimes. I also need to add CAN hardware, since we have changed the design enough that the old CAN breakout I designed is no longer useful.
    [MPPT.sch]
2018-10-11 MPPT: Combine Nucleo and High Power planes; add test points.
    Unfortunately, there's not a good way to isolate the Nucleo from the high power plane without redesigning our sensors entirely, and it's too late for that. This means we need to combine their power planes together.
    [MPPT.sch]
2018-10-11 Electronics: Add CAN chip and datasheet to utsvt-chips. Add MOSFET datasheet.
2018-10-11 MPPT: Add CAN electronics. Change high power control to 9V from 12V.
    [MPPT.sch]
2018-10-13 Minor update to cmd function of gyro
2018-10-13 Electronics: Rename INA213 to INA21x; UCC27321 to UCC37321. Add several datasheets.
    To better represent that the INA213 is one of a family of chips, differing only in their gain, I've changed the INA213 schematic component to INA21x. The schematic can change the component's "value" field to specify which INA21x they're using.
    The change from UCC27321 to UCC37321 was to correct a typo carried over from an old schematic.
    Addding datasheets for:
    * Keystone testpoints
    * PDS1-M-series isolating regulators
    * the STM32L432 Nucleo-32 board
2018-10-13 Electronics: Create several footprints for various components.
2018-10-13 MPPT: Selected footprints for all components*.
    Some footprints are approximate placeholders until I can be sure what their footprints really are. Specifically, the following components have placeholder footprints:
    * Snubber components
    * All connectors
    * Current Sense shunt resistors
    * Filtering and bypass capacitors surrounding CAN transceiver
    Also added datasheet for the inductor we're planning to use.
    [MPPT.sch]
2018-10-13 Electronics: Add battery connector from Phoenix Contact
2018-10-13 Add the files for the new gyro model
2018-10-13 Electronics: Add Molex Power and CAN connector footprints; PC Array Power connector footprint
    For low-power systems, we're using Molex Micro-fit 3.0 connectors. We have a 3-pin variant for power (+12,+5,GND) and a 4-pin variant for CAN (+5,GND,CANH,CANL).
    For the solar array and battery, we're using Phoenix Contact Power Combicon 5 connectors. To ensure the battery and array can't be swapped, we're using a 3-pin connector for the array and a 2-pin connector for the battery.
2018-10-13 SPI updates, along with test changes, etc.
2018-10-13 Electronics: Add connector components for Battery, Array, and Car Power.
2018-10-13 MPPT: Update connector components and footprints.
    I've made custom schematic symbols for our connectors, since they're supposed to be standardized across the vehicle. The battery and the array both use right-angle variants of the Phoenix Connectors Power Combicon 5 connector, while the low power bus and CAN bus both use vertical variants of the Molex MicroFit 3.0 connector.
    [MPPT.sch]
2018-10-14 Electronics: Add CDSOT23-T24CAN [Can Bus Protector] to libraries.
2018-10-14 MPPT: Insert CAN bus protector into CAN circuit.
    [MPPT.sch]
2018-10-14 MPPT: Add CAN Address DIP switches
    [MPPT.sch]
2018-10-14 MPPT: Add status LEDs and CAN Address DIP switches
    [MPPT.sch]
2018-10-14 MPPT: Add pads for RC filter on voltage and current sensors.
    [MPPT.sch]
2018-10-14 Electronics: Add the PQMC3-S single-output series of isolating regulators to our libraries
2018-10-14 MPPT: Replaced power regulator with a 3W-output isolator.
    [MPPT.sch]
2018-10-14 MPPT: Clean up and rearrange schematic
    * Compacted and cleaned up the CAN and Power Regulation blocks.
    * Spread blocks out a little more
    * Swapped locations of CAN and Nucleo Connections blocks to allow more space for the LEDs block to expand.
    [MPPT.sch]
2018-10-14 MPPT: Add CAN_Tx/Rx LEDs and TPs; move power LEDs to LEDs block
    Also nudged some blocks and circuitry around.
    [MPPT.sch]
2018-10-14 MPPT: Bumped schematic version
    [MPPT.sch]
2018-10-15 Revamped driver code.
2018-10-15 MPPT: Add diodes to FET driver input signal.
    Also moved FET gate test point to DC/DC convert block in schematic.
    [MPPT.sch]
2018-10-15 MPPT: Add test points to CAN_H and CAN_L lines.
    [MPPT.sch]
2018-10-15 MPPT: Fix broken PWM output line from Nucleo
    I accidentally broke it while moving around the FET driver in a previous commit.
    [MPPT.sch]
2018-10-15 MPPT: Reduce size of CAN termination resistors from 1206 to 0805.
    [MPPT.sch]
2018-10-15 MPPT: Fix ground test points for Car Power and Iso. 9V
    I had the test points for the grounds of these two voltage levels swapped by mistake. This fixes that error.
    [MPPT.sch]
2018-10-15 MPPT: Fix Array/Battery Live LED circuits; add -Arr and -Batt test points
    In the circuits for the Array and Battery Live LEDs, I accidentally had the current flowing through the resistors from - to -, rather than + to -! That was a rather embarrassing mistake.
    [MPPT.sch]
2018-10-15 MPPT: Initial footprint placement
    [MPPT.kicad_pcb]
2018-10-16 MPPT: Laid out and wired much of the board. Could use much work still.
    Still need to wire up CAN block and sensors; kicad is being funny about clearances around the INA chips. Also need to move filters closer to the Nucleo rather than centered around the sensors. Whole board could be compacted further.
    [MPPT.kicad_pcb]
2018-10-16 MPPT: Several changes to sensors on schematic
    Updated current sensor chip and shunt values: INA210 with 2mOhm resistor.
    Correct shunt footprint: Was a 2512, not a 2816.
    Add resistor to filter on voltage sensors. Filled our RC filter parameters: 1uF cap and 1.7kOhm res.
    [MPPT.sch]
2018-10-16 MPPT: Add Rslope to CAN chip on schematic.
    [MPPT.sch]
2018-10-20 Fixed some errors, beginning of terminal
    [LTC6811.c, main.c]
2018-10-20 Fixing driver errors
2018-10-22 MPPT: Import changes from schematic; move sensor filters to Nucleo; compact power electronics further.
    [MPPT.kicad_pcb]
2018-10-22 Electronics: Add Diode symbol footprint I forgot to add earlier.
    This footprint adds a simple silkscreen symbol to indicate diode polarity, to help avoid installing diodes backwards.
2018-10-22 MPPT: Shift Nucleo into more compact location; move sensor test points into position.
    [MPPT.kicad_pcb]
2018-10-22 MPPT: Moved CAN block to more compact location; shrunk board size.
    [MPPT.kicad_pcb]
2018-10-22 MPPT: Move Car Power and Solar Array blocks to more compact locations; resize board.
    Board is now 4.7x6.0in, and that's likely final.
    [MPPT.kicad_pcb]
2018-10-22 MPPT: Wire up CAN block; Change some CAN footprints to handsoldering variants.
    [MPPT.kicad_pcb, MPPT.sch]
2018-10-22 MPPT: Finish wiring sensors
    [MPPT.kicad_pcb]
2018-10-22 MPPT: Set GND plane parameters; fix some wires so KiCad shuts up.
    [MPPT.kicad_pcb]
2018-10-22 MPPT: Fill GND planes
    [MPPT.kicad_pcb]
2018-10-22 MPPT: Further compact board
    Saved ~.6 sq in
    [MPPT.kicad_pcb]
2018-10-22 MPPT: Add ground TPs for sensors, snubber, and FET driver.
    [MPPT.kicad_pcb, MPPT.sch]
2018-10-29 MPPT: Use more appropriate footprints for snubber components; rearrange that portion of board.
    [MPPT.kicad_pcb, MPPT.sch]
2018-10-29 Electronics: Add footprint and datasheets for our fuse and fuse block.
    Specifically, the fuse is the Schurter 0001.2512 (5x20 250V 6.3A cartridge fuse) and the fuse block is the Littelfuse 520 Series OMNI-BLOK (PCB-mount fuse block for 5x20 fuses).
2018-10-29 MPPT: Correct fuse footprint.
    We had been using a placeholder for a while, but I've now verified the correct footprint.
    [MPPT.kicad_pcb, MPPT.sch]
2018-10-29 Electronics: Add #4-40 screw hole footprints for mounting
2018-10-29 MPPT: Add mounting holes in approximate four corners of board.
    I needed to nudge and reroute a few things to accomplish this, but nothing vital has changed.
    [MPPT.kicad_pcb]
2018-10-29 MPPT: Bump PCB and Schematic revisions to Rev1 and Rev3, respectively.
    Also add some dimensions for the mounting hole locations, and correct page size to US Letter.
    [MPPT.kicad_pcb, MPPT.sch]
2018-10-31 MPPT: Fix pinout and footprint of MOSFETs.
    As it turns out, our MOSFETS have been Gate-Drain-Source this entire time, and I used the wrong pinout. We've also selected larger MOSFETs, so I swapped the footprint for a larger one.
    [MPPT.kicad_pcb, MPPT.sch]
2018-10-31 Electronics: Add High Voltage symbol to our libraries.
2018-10-31 MPPT: Add optional grounding pads for heat sinks, high voltage symbols.
    Grounding the heat sinks can help with emissions, but has to be done carefully because the tabs on our components may not be attached to ground - particularly the diodes, which have no connection to ground at all.
    [MPPT.kicad_pcb]
2018-10-31 MPPT: Bump minor revision number on schematic and PCB.
    [MPPT.kicad_pcb, MPPT.sch]
2018-10-31 MPPT: Add Gate-Drain-Source and polarity labels to MOSFETs and diodes.
    Also minor nudges to some of these components to better line them up.
    [MPPT.kicad_pcb]
2018-10-31 Electronics: Correct orientation of SOIC6 and SOIC8 silkscreen
    The silkscreens initially had their polarity markings on the last pin rather than the first (as is the de facto standard).
2018-10-31 Electronics: Set default pad clearance on SOIC-6_Pitch0.65mm to 0.08mm
    Normally we would leave the default clearance to 0 (i.e. "use global"), but because the pads are so close to each other, the global clearance tends to be far too large. A 0.08mm clearance takes up approximately one third of the distance between the outsides of the pads, so that's a good default.
2018-10-31 MPPT: Add labels to connector pins; fix polarity markings on U3,4,6; clarify polarity markings on power diodes
    The polarity markings on U3,4,6 were flipped along the long-axis, marking the last pin rather than the first. I've corrected that, importing the changes to the footprints from previous commits.
    I changed the polarity markings on the power diodes from +,- to A,C to indicate anode/diode more clearly, especially since the + side may not necessarily be at a higher voltage than the - side.
    [MPPT.kicad_pcb]
2018-10-31 MPPT: Bump PCB minor version number
    [MPPT.kicad_pcb]
2018-10-31 MPPT: [minor] Modifying gerber plot settings
    [MPPT.kicad_pcb]
2018-10-31 MPPT: Add ordering instructions for the board.
2018-11-03 First Upload of Watchdog Timer, haven't debugged
2018-11-04 SPI working. Added SPI cs toggle function for more modularity. Changed names of some of the files for easier code readability. Added LTC library from LTC website.
2018-11-04 Fixed SPI and main.c errors.
    [SPI.c, main.c]
2018-11-10 ADC driver for hall effect sensor board
2018-11-10 MPPT: Add errata; add schematic version to PCB document in comment.
    [MPPT.kicad_pcb]
2018-11-10 MPPT: Add Improvements document
    This contains a list of improvements to make to the board with some information on how to do it.
2018-11-10 Updates to gyro and terminal drivers; switching gyro ic.
2018-11-17 Edited SPI code.
2018-11-17 Temperatur and main
2018-11-17 Fixing up some errors + terminal + LED
    [main.c]
2018-11-17 Fixed compile errors in BPS code.
    [main.c]
2018-11-18 Correction to last commit (wrong file), WWDG implemented, need IWDG
    [LTC6811.c]
2018-11-22 Contactor complete, fixed minor bugs on Watchdog timer
    [Contactor.c, Contactor.h]
2018-12-06 MPPT: Add assembly and test instructions (first-draft)
2018-12-06 MPPT: Completed Assembly and Test Instructions.
2018-12-06 MPPT: Add mechanical hole misalignment problem to errata.
2018-12-06 MPPT: Start next revisions (mark version numbers as "in progress")
    [MPPT.kicad_pcb, MPPT.sch]
2018-12-06 Electronics: Fix mechanical hole alignment; removed plating on mechanical holes
2018-12-06 Electronics: Add 2-pin Molex Micro-Fit 3.0 connector; remove pads from mechanical holes.
2018-12-06 Electronics: Change Car Power connector from 3-pin to 2-pin
    We decided not to provide +5V from the battery regulator, instead letting each individual board handle that. From now on, the battery regulator will only provide +12V and GND.
2018-12-06 Electronics: Prettify INA21x schematic component
    The INA21x component now has a symbol that looks like an amplifier, rather than a box. The REF pin (pin 1) is also now closer to GND, which is where it is ordinarily tied.
2018-12-06 MPPT: Sensor schematic improvements; small schematic rearrangements
    * Import new schematic components for INA21x and Car Power Connector
    * Add protection diodes to Current Sensors after filter
    * Move voltage sensor protection diodes to after filter
    [MPPT.sch]
2018-12-06 MPPT: Import revised connector footprints.
    [MPPT.kicad_pcb]
2018-12-06 MPPT: Correct footprints on sensor filter capacitors
    The voltage sensors' RC filter capacitors are now 0805 as they should be, rather than 1206 as they were before.
    [MPPT.kicad_pcb, MPPT.sch]
2018-12-06 MPPT: Implement sensor and car power changes on PCB.
    [MPPT.kicad_pcb]
2018-12-06 MPPT: Correct footprints for car power regulator capacitors
    This involved rearranging much of the car power regulation block of the PCB, as the new footprints were rather large.
    [MPPT.kicad_pcb, MPPT.sch]
2018-12-06 MPPT: Add extra labels to back side of PCB for MOSFETs and Schottkys.
    [MPPT.kicad_pcb]
2018-12-06 MPPT: Compact sensor blocks on PCB.
    By flipping the current sensor onto the back side of the board (makes sense, since that's where the ground plane is), I was able to compact the sensor layout significantly. This will save board space and even make access to the current sensors much easier.
    [MPPT.kicad_pcb]
2018-12-08 Fixed all error codes in build output. Added supplemental source code needed to build project.
    [Contactor.c]
2019-01-08 Added BPS master hardware sch/pcb. Added over-current limit checks for charging and discharging conditions in code.
    [BPSMaster.kicad_pcb, BPSMaster.sch, CAN.sch, Contactor.sch, EEPROM.sch, IsoSPI.sch, Misc.sch, PowerDist.sch]
2019-01-09 Added LTC6811 symbol for BPS voltage schematics.
    [BPSVoltage.kicad_pcb, BPSVoltage.sch, Misc.sch, _saved_BPSVoltage.sch]
2019-01-10 Finalized schematics for BPS master.
    [BPSMaster.sch, BPSVoltage.sch, CAN.sch, Contactor.sch, EEPROM.sch, I2C.sch, Misc.sch, PowerDist.sch]
2019-01-11 Added SoC skeleton code.
    [BPSMaster.sch, CAN.sch, Contactor.sch, I2C.sch, Misc.sch, PowerDist.sch, SPI.sch, USB.sch]
2019-01-11 added newline to end of ADC.c and test to merge conflectis in SoC.c
2019-01-11 Added my name (Garrett) to author list for ADC, SoC, and main
2019-01-11 added current Conversion to ADC.c
2019-01-12 Assigned footprints to each symbol in BPS schematics.
    [BPSMaster.sch, CAN.sch, Contactor.sch, I2C.sch, Misc.sch, PowerDist.sch, SPI.sch, USB.sch]
2019-01-12 Initialized necessary 32 bit timer and values to begin state of charge calculation. Still needs to be tested
2019-01-16 made a rough draft of SOC calibration. When you call SoC calculate, it recalculates the SoC. Also made rough edits to SoC_GetPercent.
2019-01-16 Added function ADC_CHooseHiLo that chooses between the high current or low current Tamura sensors for the most precise value of current. Note when changing the ADC.h files when saving got the error ~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
    [ADC.c]
2019-01-17 added the adc.h file to match adc.c
2019-01-20 Master board PCB layout organized.
    [BPSMaster.kicad_pcb, BPSMaster.sch, CAN.sch, I2C.sch, Misc.sch, PowerDist.sch, SPI.sch]
2019-01-26 Organized all components in BPS master to where they should be.
    [BPSMaster.kicad_pcb, BPSMaster.sch, CAN.sch, I2C.sch, Misc.sch, SPI.sch, USB.sch]
2019-01-26 Add starter kicad files for BPS
    [BPSTemperature.kicad_pcb, BPSTemperature.sch, BPSTester.kicad_pcb, BPSTester.sch]
2019-01-26 Fixed kicad files
    [Temper Board.kicad_pcb, Temper Board.sch]
2019-01-26 Started temperature board schematics for BPS
    [BPSTemperature.sch]
2019-01-27 Added labels to temperature board for BPS
    [BPSTemperature.sch]
2019-01-27 Added DIP switch to temperature board for BPS
    [BPSTemperature.sch]
2019-01-27 Cleaned up schematic of temperature board for BPS
    [BPSTemperature.sch]
2019-01-27 Finished up the voltage board. Revise later.
    [BPSVoltage.kicad_pcb, BPSVoltage.sch]
2019-01-27 Got bored and restructured somewhat.
    [BPSVoltage-B.Cu.gbr, BPSVoltage-B.Mask.gbr, BPSVoltage-B.Paste.gbr, BPSVoltage-B.SilkS.gbr, BPSVoltage-Edge.Cuts.gbr, BPSVoltage-F.Cu.gbr, BPSVoltage-F.Mask.gbr, BPSVoltage-F.Paste.gbr]
2019-01-27 changes to the schematics to the Battery Tester PCB
    [BPSTester.sch]
2019-01-27 Final schematic of Temperature board for BPS
    [BPSTemperature.kicad_pcb, BPSTemperature.sch]
2019-01-28 Created PCB of Temperture Board for BPS
    [BPSTemperature.kicad_pcb, BPSTemperature.sch]
2019-01-28 Finished up revision 2 of the board.
    [BPSVoltage.kicad_pcb, BPSVoltage.sch]
2019-01-28 changed power from potentiometers, upgraded to KiCad 5.0
    [BPSTester-2019-01-27-21-50-54.sch, BPSTester.sch]
2019-01-28 Finished pcb layout of Temperature Board for BPS
    [BPSTemperature.kicad_pcb]
2019-01-28 Edited pcb for Temperature Board, some issues remain
    [BPSTemperature.kicad_pcb]
2019-01-28 Fixed the via sizes on the voltage board.
    [BPSVoltage.kicad_pcb]
2019-01-28 Moved some components around and deleted dimension
    [BPSVoltage-B.Cu.gbr, BPSVoltage-B.Mask.gbr, BPSVoltage-B.Paste.gbr, BPSVoltage-B.SilkS.gbr, BPSVoltage-Edge.Cuts.gbr, BPSVoltage-F.Cu.gbr, BPSVoltage-F.Mask.gbr, BPSVoltage-F.Paste.gbr]
2019-01-28 Completed PCB of Temperature Board for BPS
    [BPSTemperature.kicad_pcb]
2019-01-28 Updated Design Rules for Temperature Board for BPS
    [BPSTemperature.kicad_pcb]
2019-01-29 Traced regular GPIO pins on master board.
    [BPSMaster.kicad_pcb, BPSMaster.sch, Misc.sch]
2019-01-29 Added some Silk Screen Decals
    [BPSTemperature.kicad_pcb]
2019-01-29 Added references to PCB of Temperture Board for BPS
    [BPSTemperature.kicad_pcb]
2019-01-31 2nd Version of Temperature Board for BPS
    [BPSTemperature2.kicad_pcb, BPSTemperature2.sch]
2019-01-31 Added more traces to master BPS.
    [BPSMaster.kicad_pcb, SPI.sch]
2019-01-31 Changed trace sizes to IC
    [BPSTemperature2.kicad_pcb]
2019-01-31 Rotated components of Temperature Board for BPS
    [BPSTemperature2.kicad_pcb]
2019-01-31 Unrotated components of Temperature Board for BPS
    [BPSTemperature3.kicad_pcb]
2019-01-31 Routed CAN bus.
    [BPSMaster.kicad_pcb]
2019-01-31 updated footprints, net, and organized footprints on pcb. Have not routed
    [BPSTester.kicad_pcb, BPSTester.sch]
2019-01-31 routed the tracks, still need to follow design guidelines
    [BPSTester.kicad_pcb]
2019-01-31 Restructured, spaced out, reduced # of vias
    [BPSVoltage.kicad_pcb]
2019-01-31 Remodelled the board
    [BPSVoltage.kicad_pcb]
2019-01-31 Modified rotated board for BPS
    [BPSTemperature2.kicad_pcb, BPSTemperature2.sch]
2019-02-02 Added CAN bus traces on BPS.
    [BPSMaster.kicad_pcb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]
2019-02-02 Changed the track with to 15 mil
    [BPSTester.kicad_pcb]
2019-02-02 Placed a ground plane and labeled Testing board
    [BPSTester.kicad_pcb, BPSTester.sch]
2019-02-02 ade BOM for testing board
    [BOMtesterboard.xlsx]
2019-02-02 Added connector to temerature board for BPS
    [BPSTemperature2.kicad_pcb, BPSTemperature2.sch]
2019-02-02 Redid pin layout for connector to filters
    [BPSTemperature2.kicad_pcb, BPSTemperature2.sch]
2019-02-02 Added names to temperature board for BPS
    [BPSTemperature2.kicad_pcb]
2019-02-02 Completed master board PCB
    [BPSMaster.kicad_pcb, BPSMaster.sch, CAN.sch, Contactor.sch, I2C.sch, Misc.sch, PowerDist.sch, _saved_SPI.sch]
2019-02-02 Footprints, BOM, and final board edits.
    [BOM.xlsx, BPSVoltage.kicad_pcb, BPSVoltage.sch]
2019-02-02 Modified footprint for connector
    [BPSTemperature2.kicad_pcb, BPSTemperature2.sch]
2019-02-02 Edited keepout aread on master BPS.
    [BPSMaster.kicad_pcb]
2019-02-02 Logos etc.
    [BPSVoltage.kicad_pcb]
2019-02-03 Replaced connector footprint
    [BPSTemperature2.kicad_pcb]
2019-02-03 Made edits to temperature board. Finalized boards.
    [BPSMaster.kicad_pcb, BPSTemperature.kicad_pcb, BPSTemperature.sch, BPSTemperature2.kicad_pcb, BPSTemperature2.sch, BPSTemperature3.kicad_pcb]
2019-02-03 Finalized all boards. Created gerber files.
    [BPSMaster-B.Cu.gbr, BPSMaster-B.Mask.gbr, BPSMaster-B.Paste.gbr, BPSMaster-B.SilkS.gbr, BPSMaster-Edge.Cuts.gbr, BPSMaster-F.Cu.gbr, BPSMaster-F.Mask.gbr, BPSMaster-F.Paste.gbr]
2019-02-07 Organized repo.
    [BOM.csv, BOM.xlsx, BOMtesterboard.xlsx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]
2019-03-21 Added I2C driver. Finished up a voltage library.
2019-04-13 Updated test cases with LEDs.
2019-04-13 Fixed that one LED
2019-04-13 updated ADC code for testing
2019-04-20 testing timer for SOC
2019-05-03 Updated LTC2983 Libraries. SPI doesn't work
    [Temperature.c, main.c]
2019-05-03 Updated for Temperature
2019-05-04 SPI Works
2019-05-04 Added UART support for printf
2019-06-15 Fixed compilation erros and added LTC6811 working code.
    [LTC6811.c, LTC681x.c, LTC681x.h, SPI.c, SPI.h, main.c]
2019-07-20 Updated Temp Board. Not functioning, but compiles.
2019-07-20 Voltage Board Test
2019-07-20 Completed Voltage Library and Finished Voltage Test Program.
2019-07-27 Fixed safety function parameters
    [Voltage.c]
2019-08-31 Created CAN driver.
2019-09-07 LTC2983.h driver library reorganized. Require more testing.
2019-09-21 Deletes Watchdog functions to prevent reset.
    [Voltage.c, main.c]
2019-09-21 worked on system to store errors to EEPROM
    [EEPROM.c, EEPROM.h]
2019-09-29 Created methods to check for disconnected wires and return array of connects and disconnects
2019-09-29 Fixed Index Out of Bounds potential error
    [Voltage.c]
2019-10-05 Makes error return checks consistent.
    [Temperature.c, Temperature.h, Voltage.c, Voltage.h, config.h]
2019-10-05 Need to test software vs hardware issue
    [Voltage.c, Voltage.h, config.h, main.c]
2019-10-05 Updated Temperature Code 10.5.19
2019-10-05 Updated Voltage_OpenWire() to use ErrorStatus struct as return type
    [Voltage.c, Voltage.h]
2019-10-05 Final LTC2983 driver code
2019-10-05 EEPROM_Save function tested and works. EEPROM function to read errors written but not tested
    [EEPROM.c, EEPROM.h, main.c]
2019-10-08 Edits config.h for more granular specs of bps and battery box.
2019-10-08 Fixes compile errors in LTC2983 driver
    [main.c]
2019-10-08 Adds temperature.c function to choose which temperature limit to choose from depending on if the battery is charging or discharging.
2019-10-12 Fixes basic LED test and config.h
    [config.h, main.c]
2019-10-12 Adds SPI peripherals but was not implemented into drivers.
2019-10-12 1st implementation of Temperature.c
2019-10-12 Implement Current functions and ADC conversion
2019-10-12 Adds correct SPI peripherals accodringly to each LTC driver.
    [LTC6811.c, LTC681x.c, LTC681x.h, SPI.c, Temperature.c]
2019-10-12 Update Temperature_isSafe; More comments
2019-10-12 Fix the I2C driver and have EEPROM read/write.
    [EEPROM.c, EEPROM.h, I2C.c, main.c]
2019-10-12 Voltage library measuring voltage correctly.
    [config.h, main.c]
2019-10-12 Added Temperature tests
2019-10-12 small error fix in temperature.c
    [Temperature.c]
2019-10-13 Implement Current functions and conversion
2019-10-13 Finish the ADC using DMA to maintain updated vals.
    This now uses DMA2 to access the ADCs at every update,
    and continuously updates the values being read. This
    means that when needed, the most up to date value
    from the ADC can be accessed without having to poll
    that pin.
2019-10-13 Fix a merge mistake.
    [ADC.c]
2019-10-13 Replaced SPI Multi functions to individual read/writes
    [main.c]
2019-10-18 Adds voltage test similar to what BPS program will be running excluding current and temperature.
2019-10-19 Update Temperature Tests
2019-10-19 testing with board
2019-10-19 changed wakeup_sleep delay to make voltage readings more accurate
2019-10-19 Sleep delay seems to be fixed. Not idle delay yet
    [LTC681x.c]
2019-10-19 Update Current tester
2019-10-19 Fix UART
2019-10-19 delay now only an issue on initial programming
    [LTC681x.c, Voltage.c, main.c]
2019-10-19 Revert "Sleep delay seems to be fixed. Not idle delay yet"
    This reverts commit 7d3011513fc002e1f56550a452789a263f6baa5f.
    [LTC681x.c]
2019-10-21 potential bug fix: initialize register sizes
    [LTC681x.c]
2019-10-21 Adds comments to Voltage library.
2019-10-21 Fixes printing modules in test main.
    [config.h, main.c]
2019-10-21 Adds Working watchdog timer.
2019-10-23 Add files via upload
    Errorlight updates: I changed the comments and enabled the clock for the GPIO port. I also updated the test.
    [main.c]
2019-10-26 Edits config.h to align with actual battery pack. Deletes erraneous types.
2019-10-26 ADC Driver fixed
2019-10-26 Latest Updated drivers. LTC2983 not communicating
2019-10-26 updated tests in main and UART drivers
2019-10-26 Repair the current and ADC drivers.
    Problem
    =======
    The current driver does not work.
    Solution
    ========
    The main issue appeared to be with the order of the ADC readings.
    Apparently, a priority of 1 is read after a priority of 2 when using
    DMA, meaning that the sensors we're brought in in the worng order.
    Since each sensor was being scaled differently, this means that
    one was ending up as twice the proper current and the other was
    approximately half. To fix this, the priorities were swapped.
    Notes
    =====
    The ADC driver should now work as expected. Be careful when changing
    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
    [ADC.c, main.c]
2019-10-26 updated Voltage.C openwire methods
2019-10-26 Voltage.C methods to check all aspects of open wire
2019-10-26 Update Voltage_GetOpenWire()
2019-10-26 Minor fix to Current.
    [ADC.c]
2019-11-02 Update EEPROM driver
    TODO
    ====
    Flash the EEPROM stuff where it is needed.
2019-11-02 Finish EEPROM and I2C
    The EEPROM and I2C libraries were not reading and writing well.
    This was partially due to an I2C error that was not accounting
    for NAKs on address writes to the EEPROM when the previous
    write-cycles was still ongoing. The other part were high-level
    EEPROM driver issues that needed to be corrected to ensure
    persistence of memory.
    The I2C driver was fixed by including a check for NAK when waiting
    for the transmission-mode flag to be set after sending a device
    address.
    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
    [EEPROM.c, EEPROM.h, I2C.c, main.c]
2019-11-02 Fixing compilation issues present in the master.
    We need to verify compilation before pushing things
    to the master branch.
    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
    [Temperature.c, Temperature.h]
2019-11-02 Testing Voltage Board Auxillary GPIO Pin
2019-11-04 ADC Measurement works on GPIO1
2019-11-05 More Housekeeping; Added to config.h; restored Voltage test
2019-11-05 Fixed compile warnings/errors; Removed LTC2983
    [Temperature.h, main.c]
2019-11-06 Edits Voltage library to record cell_asic pointer in Init function.
2019-11-06 Updated Temperature.c to account for even number of sensors for a specific module
2019-11-08 I2C sending correct data; Modified some tests; LTC6811 error fix
    [LTC6811.c, Temperature.c, Temperature.h, main.c]
2019-11-16 Get CAN in a working state.
    CAN was not working correctly. This had to do with an error in the
    testcase, a mismatch between the standard peripheral libray and
    actual functionality, a timing issue, and mode configuration for
    testing.
    The following changes we made:
    * Fixed the malloc in the testcase
    * Reconfigured the timing to match with the other systems
    * Added mode configuration in the driver initialization function
    * Created a new `const` in the driver to use with AF configuration.
    Testing
    These changes have __not__ been tested with the other systems yet.
    Note
    This is another system that we should eventually move to an
    interrupt-driven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
    [CAN.c, main.c]
2019-11-16 Added a timeout of 3 seconds to the I2C read multiple method
2019-11-16 Added timeouts to all the waits in the I2C read multiple method
2019-11-16 Added timeouts to the rest of the I2C waits
2019-11-16 updating danger voltage
2019-11-16 Updated the voltage values to millivolt relative
2019-11-16 Fixes millivolt scalling factor to 1000 (3 decimal places)
    [config.h]
2019-11-16 Daisy Chain works + i2c; Celsius Conversion works; Update mainmain; Cleaned Temperature Tests
2019-11-16 Altered the Voltage_GetModulesInDanger() method to account for open wires as well. Returns a list of type SafetyStatus now
2019-11-16 Updated timeout threshold to 15 ms and made it a #define in I2C.h
2019-11-16 Changed scale of voltage values. Tested: methods working as needed
2019-11-23 Added conditino for contactor override in case of UNDERVOLTAGE
2019-11-23 example code from online and test for UART interrupts. Please enter the commit message for your changes. Lines starting
2019-11-23 interrupts working for UART and fifo implemented in fifo.c. Interface in fifo.h
2019-11-23 added functions for getting commands from uart fifo
2019-11-24 Adds working CAN driver.
2019-12-07 implemented a fifo and uart with interrupts. Also added support for storing and getting commands and Chase could not break it
2019-12-07 Winter Cleaning of Temperature Code
2019-12-07 Fixed Systick Compile Error/Warnings; Added Systick to project file
    [main.c]
2019-12-07 Voltage commands
2019-12-07 Update main switch statement
2019-12-07 Added functions to Current commands
2019-12-07 Temperature commands
2019-12-07 Contactor startup function created; need to implement UART input
2019-12-07 Updated current commands
2019-12-07 Added Temperature_GetSingleTempSensor
2019-12-07 LED function halfway done
2020-01-25 Renamed UART functions and deleted UART3
2020-01-25 Changed names of UART functions
2020-01-25 Changed UART1_Config to UART1_Init
2020-01-25 Tested Voltage, Current, LED. All functions work properly within those. Need to complete the rest of the functions and test. FYI: SysTick functionality doesn't update the ticks properly -- need to lo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
    [CLI.c, CLI.h, main.c]
2020-01-26 tested EEPROM (I2C) with new PLL. It works!
2020-02-01 fixed syntax error in current.h caused by "<<<<<<<<<"
2020-02-01 Temperature CLI functionality works properly
2020-02-01 CAN and SPI work with new PLL (80MHz)
2020-02-01 Contactor, SoC, Watchdog, EEPROM, ADC, and Abort functions written; need to test all still
2020-02-08 Switch, SoC, Watchdog, EEPROM, ADC, and Abort functions work as intended
2020-02-08 CLI works in real time with UART and Fifo echo
2020-02-08 fixed UART interrupts and updated UART_INTERRUPT test
    [main.c]
2020-02-08 Delay function was being stuck in an infinite loop. Fixed delay function by disabling sytick clock interrupt rather than disable_irq. Decreased number of functions used in Delay function. Added Systi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
    [main.c]
2020-02-08 Changed EEPROM test UART initializations to correct baud rate. Also tested with delay function to make sure it works
    [main.c]
2020-02-08 Added reset function to EEProm test and changed delay in EEProm to 5 Ms instead of 100.
    [EEPROM.c, main.c]
2020-02-08 Complete the BPS CAN messages as specified.
    The BPS CAN messages would not be read correctly by the telemetry
    system. This was because the BPS CAN messages were being formatted
    improperly.
    The solution code was implemented from observing the way the telemetry
    code parses the data. Importantly, this means that *THE CAN MESSAGES
    AS SPECIFIED ON THE SHARED DOCUMENT ARE OUT OF DATE.* These should be
    updated at the time this commit is merged into the master to avoid
    future confusion.
    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
    [CAN.c, main.c]
2020-02-08 Remove braces on switch statement cases.
2020-02-12 Fix a minor error with CAN and clean guards.
    [CAN.c, main.c]
2020-02-15 Created LTC6811 function to display register information of Minion boards. Need to test that information is printed correctly
    [CLI.c, CLI.h, main.c]
2020-02-15 Added Voltage_Init() and Temperature_init() to CLI_Test
2020-02-17 switched from checking first letter to using the hashed strings
2020-02-17 fixed duplicate macro/enummacro/enum names
    [CLI.c, CLI.h]
2020-02-18 add functionality to check if batteries need to be charged on restart; Checks during initialize() and waits for 1 million iterations (can be changed)
2020-02-20 Adds profile config to flash/debug the STM32F413 with vscode
2020-02-22 fixed NUM_MINIONS, NUM_BATTERY_MODULES, and NUM_TEMPERATURE_SENSORS
    changed back to 4, 31, and 62
    [config.h]
2020-02-22 Added comment to CLI_InputParse CAN special case
2020-02-22 update backward logic on CLI_Current is charging
2020-02-22 Added documentation to temperature function
    differentiated between getting module temperature and getting temp of individual sensor
2020-02-22 update LED function to reflect deprecated tokens method
2020-02-25 Update implementation of hashTokens from a global array to local array passed to functions individually; should test to make sure no mistakes were made in the transfer
    [CLI.c, CLI.h]
2020-02-27 Make the party parrot a separate target.
    The party parrot now requires a definition
    to be in place in order to be included in
    the build.
    When the definition is in place, the binary
    is approximately 47 KiB. when the definition
    is not in place (so no party parrot), the
    binary is approximately 37 KiB. this is about
    a 10KiB saving by removing the parrot.
    I also fixed up a weird function defintion
    that had an extra parameter.
    [CLI.c, CLI.h, EEPROM.c, Images.c]
2020-02-29 Add new CLI_Pow function to make the exponentiation faster; update hashes to work with the new power function
2020-02-29 Current_CheckStatus works with the override command(#41)
    Current_CheckStatus checks that LowPrecisionCurrent is within safe limits based on whether or not override is set - now takes boolean override as input -- test added to main.c to print output of SAFE or DANGER based on LowPrecisionCurrent value & override parameter
2020-03-02 Adds checks if moduleIdx is valid in the Voltage_GetModuleMillivoltage function. Previously, there could be a chance that the function will access memory that was not allocated in the main.c Minions[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
2020-03-02 Fixes compile error due to CLI. Current_CheckStatus() was changed but CLI was not updated. Added paramter to Current_CheckStatus(false) in CLI.
    [CLI.c]
2020-04-19 Adds Contactor, I2C, LED, and PLL documentation and templates.
2020-04-19 Documents BSP SPI
2020-04-19 Adds BSP for STM32F413
2020-04-19 Adds BSP ADC from original working version.
2020-04-19 Adds LED and contactor code to BSP from working version of bps code.
2020-04-19 Finishes BSP SPI
2020-04-19 Adds BSP watchdog timer.
2020-04-19 Finishes BSP I2C
2020-04-19 Adds CANbus library to abstract away hardware.
2020-04-19 Updates CLI with updated BSP libraries except for UART.
2020-04-26 Adds STM32F4 new UART bsp.
2020-04-26 Updates entire project with new BSP format. Fixes all errors. Finally compiles x.X
    [BSP_I2C.h, BSP_Lights.c, BSP_Lights.h, BSP_SPI.c, BSP_Timer.c, BSP_UART.c, BSP_UART.h, CANbus.c]
2020-04-26 Fixes some chip dependency issues in hardware independent code. Adds some what working makefile for simulator.
    [BSP_PLL.c, BSP_PLL.h, LTC6811.c, LTC681x.c]
2020-04-26 makefile for stm32 and simulator both works
2020-04-27 Fix small formatting issues; move all tests to a separate file pending new method for running tests
    [BSP_ADC.c, BSP_Lights.c, BSP_Lights.h, CLI.c]
2020-04-28 Change Current library to interpret LowPrecisionCurrent and HighPrecisionCurrent as mA. Prior to this, some functions interpreted both in mA and others interpreted them in A, causing inconsistent mea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
2020-04-28 Update Current constants to use mA instead of A
2020-04-30 Renames handler to generic name in BSP Template (#46)
    * Renames handler to generic name in BSP Template
    * Fixes comment grammar issues in Template
    [BSP_UART.c]
2020-05-01 Simulator uart (#58)
    Creates UART functionality for the BPS Simulator
    Authored By: Sijin Woo
2020-05-01 Simulator ADC (#60)
    * Convert Amps to raw ADC data. Will be used to generate simulated ADC data
    * Generates semi-randomized ADC values within provided range. State and Mode will be specified by the calling python simulator script
    * Writes to CSV file that transmits ADC data to the BSP code
    * BSP_ADC reads ADC.csv file and returns the appropriate millivoltage values
    * Create script to generate and display new data every second. Tested with BPS code for ADC (high/low precision current readings)
    * Convert Amps to raw ADC data. Will be used to generate simulated ADC data
    * Generates semi-randomized ADC values within provided range. State and Mode will be specified by the callin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
2020-05-05 Fixes incorrect return results for BSP_UART.c
    [BSP_UART.c]
2020-05-06 Created file where state of contactor is stored as 0 or 1. Didn't implement anything for an input and output pin
    [Contactor.py]
2020-05-07 Fixes bsp_uart return results. (#64)
    [BSP_UART.c]
2020-05-09 Lights simulator (#62)
    Creates LED segment for the simulator. Updates the status of each LED into a CSV file to be read by the simulator python scripts.
2020-05-09 Display LED status in the simulator
2020-05-09 Fix terminal badness.
    When running the program improperly, the terminal is FUBAR. This
    requires a restart.
    Add a linked file in the root of the BeVolt folder that can be used
    to run the program, add a general case for error handling to avoid
    the terminal formatting issue caused by a failure to end ncurses.
    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
    [ADC.py, Lights.py, simulate.py]
2020-05-30 Fixed all compiler warnings except for in LTC681x.c. Also moved DelayMs function from CLI.c to EEPROM.c
    [BSP_ADC.c, BSP_ADC.h, BSP_UART.c, CLI.c, CLI.h, EEPROM.c, EEPROM.h]
2020-05-30 Add interrupt management functions and a simulation flag
    Commented code bugs me. It should be deleted or used.
    I uncommented the __enable_irq() and __disable_irq() functions
    in main.c. This only works in the ARM assembly syntax. In order
    to determine whether we are targetting ARM or x86 at compile-time,
    and additional flag (SIMULATION) has been added, such that it being
    defined implies that we are targetting an x86 (or at the very least,
    a non-ARM) architecture.
    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
    [main.c]
2020-06-02 Added PLL simulation mode to simulate.py. Also added Get_Frequency() and Print_Frequency() functions to PLL.py
2020-06-02 Removed Print_Frequency because it was pretty useless.
2020-06-02 Made sure to close all files after opening them. Changed way to check if file is created. For some reason if file is already created and the initialization function is run, the next line will always 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
    [Contactor.py]
2020-06-02 All functions work. Tested them by just changing the value in printf and seeing if python function could read it correctly.
2020-06-03 Moved CAN simulation option to Keyboard Interrupt.
2020-06-03 Changed python file to return value. Debugged by changing value in csv file and running python code independently. Returned correct values
    [Contactor.py]
2020-06-04 Added flag system for read and write. Fixed issue with CAN read command in CLI - no longer infinitely prints message read
    [BSP_CAN.c]
2020-06-09 Fix the Makefile's flash and clean functionalities.
    This has been bugging me. Clean should not spit out
    error messages unless something has actually gone wrong.
    A file not being there when it needs to be removed is
    a non-problem.
    This was also missing the ability to flash to the board.
    It's pretty simple changes. Take a look yourself.
    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
2020-06-09 Fixed stack smashing issue in Test_BSP_CAN.c.
    [Test_BSP_CAN.c]
2020-06-09 Fix CLI Temperature commands to accurately get the temperature sensor-specific data (#85)
    [CLI.c, config.h]
2020-06-09 Simulator spi bsp (#77)
    * Makefile deletes *.out files when make clean is called
    * Adds file reads in BSP_SPI read
    * Adds skeleton to find the command.
    * Adds PEC calculations and half of the command ltc6811 command codes
    * Adds file reads in BSP_SPI read
    * Adds skeleton to find the command.
    * Adds PEC calculations and half of the command ltc6811 command codes
    * Adds Test files for SPI and LTC6811 and finishes the command codes for the LTC6811
    * Adds function to format the packets the LTC6811 would usually transmit inside BSP_SPI.c
    * Adds LTC6811 command handler into BSP_SPI to simulate the BSP. Adds helper functions to easily copy and extract data. Formats the doc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
2020-06-09 Fixes all compiler warnings! (#87)
    [BSP_SPI.c, CLI.c]
2020-06-10 Fixed undefined variable issue. Moved PLL to Keyboard Interrupt. Added Lock and unlocks to file accesses in the C file and the Python file.
    [BSP_PLL.c, PLL.py, simulate.py]
2020-06-10 Add a way to launch both the Python and C programs.
    Summary
    It's annoying to have to do [two things](https://youtu.be/3KWACw3May0?t=21).
    With this change, we only have to do one thing (run `./simulate`). It
    can even be done from other folders! (Just do something like `BPS/BeVolt/simulate`)
    Also I fixed a few bugs along the way.
    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
    [BSP_I2C.c, simulate.py]
2020-06-10 Fixed configure() from last commit since I accidentally messed up the indentation
    [simulate.py]
2020-06-10 Added file locking.
    [CAN.csv]
2020-06-10 Fixed the locking stuff in BSP_PLL.c
    [BSP_PLL.c]
2020-06-10 Fixed compiler warning for BSP_CAN_Read().
    [BSP_CAN.c]
2020-06-10 Moves #include <unistd.h> out of common.h and into BSP_SPI.c since stm32 doesn't use posix functions
    [BSP_SPI.c, common.h]
2020-06-10 Fixes compiling errors when I edited the #defines and moved the #include <unistd.h> statement
    [BSP_ADC.c, BSP_SPI.c]
2020-06-21 WDTimer.py no longer crashes. Moved PID to second row of the .csv
    [BSP_WDTimer.c, WDTimer.py]
2020-06-24 No longer have to send all 8 bytes of data in python script. Removed flag global because it did not allow for reading messages written from simulation script.
    [BSP_CAN.c, CAN.py, simulate.py]
2020-06-24 attempted to address some of the pull request issues - still a bit to be done though
    [BSP_Strobelight.c, Strobelight.py]
2020-06-25 Removed flag system because it blocked interaction between simulating sending/recieving CAN messages through the .py files and the C code. Simulate.py no longer needs all 8 bytes of the message. Chan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
    [BSP_CAN.c, CAN.py, Test_BSP_CAN.c, simulate.py]
2020-06-25 Script no longer requires all 8 bytes of the CAN message.
    [simulate.py]
2020-06-25 Added enum in BSP_WDTimer.c for "start" and "reset" states. Changed file path to use GET_CSV_PATH().
    [BSP_WDTimer.c, Test_BSP_WDTimer.c, WDTimer.py, simulate.py]
2020-06-27 Changed BSP_WDTimer_Init() - it now creates the .csv file if it doesn't already exist. If the .csv file already exists, this function does nothing. Added this Init() function to the test int main()
    [BSP_WDTimer.c, Test_BSP_WDTimer.c]
2020-06-27 Remove lagacy code.
    This removes legacy code from the working head of the master branch
    and moves the BeVolt code into the root of the repo. The legacy code
    has a new home at the texsun_legacy branch.
    [config.TXT]
2020-06-27 Voltage Library cell_asic fix (#93)
    * Created private array. Need to test with simulator.
    * Made private array static type variable
    * Fixes OpenWire bug to correctly test if copying of voltages works
    * Replaces include to LTC6811.h
    [LTC681x.c, Voltage.c, simulate.py]
2020-06-28 Fixed whitespace
    For some reason an extra tab was added where it wasn't needed
    [simulate.py]
2020-06-28 Voltage danger now specified, including new openwire
2020-07-01 Put CAN message and ID in its own box under the LED display to prevent clipping when changing the window size.
    [CAN.py, simulate.py]
2020-07-02 Updates all python scripts currently in simulator branch to use config.py
2020-07-02 Adds locks to all files currently in simulator
2020-07-03 Fix CAN file access error and improve CAN test case.
    This fixes the issue present in CAN.py that was causing intermittent
    crashes of the simulator. The test case has also been changed to one
    that exposed this issue on the previous version of the simulator.
    On the old version of the code, crashes were observed anywhere from
    a few seconds after simulator launch to about one minute after launch.
    After the change, I have successfully run the simulator for over 2 hours
    without a crash occurring.
    [CAN.csv]
2020-07-04 Adds variables to battery capacity in simulate.py
2020-07-04 Adds variable for current draw in simulate.py
2020-07-21 Created a background thread to constantly tick a 24 bit timer. Ticks are not shown in python simulation screen.
2020-07-21 Added comments and removed enum because I didn't end up needing it. Added variables to make code more clear
    [BSP_Timer.c, Timer.py]
2020-07-22 attempted to fix errors, heartbeat no longer works?
    [config.h, main.c]
2020-07-23 Fixed bug where Timer thread never ended. Test module now prints Run Freq along with elapsed ticks.
    [Test_BSP_Timer.c, Timer.py, simulate.py]
2020-07-24 Change the 'SoC' to 'Charge' and make implementation nicer.
    SoC commonly refers to System on a Chip, but we have been using it
    to mean State of Charge for a while. This is somewhat confusing
    terminology.
    Renamed (almost) everything from SoC to Charge. This includes everything
    in the SoC.h and SoC.c files (which have been renamed Charge.h and Charge.c).
    This does not include definitions provided in the EEPROM and CAN files.
    I excluded the CAN file because I did not want to rename CAN IDs
    without input from everyone.
    While addressing this problem, I also came across some things in the
    (formerly) SoC file that made me a bit nervous, so I went ahead and
    made c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
    [CLI.c, Charge.c, Charge.h, battery.py, main.c]
2020-07-28 Fixed the edge case where the timer would not die if it had not been started. This was causing the simulator to freeze after the "quit" command was given before the timer had been started
    [Timer.py]
2020-08-02 Made it so that the Python part of the simulator will freeze and show the error message instead of crashing if there is an error
    [simulate.py]
2020-09-02 Adds Task prototypes into tasks.h
2020-09-02 Renames MotorNotify to DashboardNotify
2020-09-05 Updates the README to not include BeVolt folder
    The README references the old BPS code structure (having BeVolt and Legacy folders). Fixed that to follow current code structure.
2020-09-06 Fixes compile errors in main
    [Tasks.c, Tasks.h, main.c]
2020-09-19 Limited the scope of MinionsASIC_Mutex to the LTC6811 driver
2020-09-19 Fix linking error in LTC6811.c
    [LTC6811.c]
2020-09-19 Fixed typo in #include
    [LTC6811.c]
2020-10-03 Voltage Mutex Initialization (#215)
    * Initial commit
    * Fixed function calls for pending/posting the mutex.
    * Changed location of pend/post functions in GetModuleMiliVoltage() and UpdateMeasurements() functions.
    * Removed global VoltageBuffer_Mutex variable in Tasks.c because the Voltage module is the only one that will access it. It has been moved to the Voltage module.
    [Voltage.c, Voltage.h]
2020-10-04 Rtos temperaturebuff mutex (#218)
    * Adds temperature buffer mutex initialization in Temperature_Init
    * Adds temperature buffer mutex initialization in Temperature_Init
    * Adds temperature mutexes
    * Deadlock issue fixed because Temperature_CheckStatus would return before posting
    [Temperature.c, Test_TemperatureBuffMutex.c]
2020-10-10 Implemented MinionsASIC_Mutex (#202)
    * Implemented MinionsASIC_Mutex
    * changed some of the LTC6811 functions so that if they access the minions array, they will hold the mutex for the entire array access instead of just for each element access
    * Places LTC6811_Deadlocks test in a thread so semaphores can work properly. Test was happening outside of OS context in main
    * added more arguments to makefile for simulator and added a second task to Test_LTC6811_Deadlocks.c
    * added counters to keep track of how many times each task runs its loop
    * added semaphore to test so that both threads can run
    * updated Test_LTC6811_Deadlocks.c
    * Added mutex to Voltage.c and Temperature.c.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
2020-10-10 Faulttask (#208)
    * Direct copy paste from main
    * Direct copy paste from main
    * Finished FaultState Task
    * Added comments
    * Fixed compiler errors
    * Released semaphore after using it
    * fixed typo
    * Reverted changes made to tasks.c file
    * Update Tasks.c
    [Task_FaultState.c, Tasks.c]
2020-10-10 Faulttask (#223)
    * Added ifdef for debugging
    * Update Task_FaultState.c
    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
    [Task_FaultState.c]
2020-10-10 Watchdog mutex (#221)
    * Added Watchdog Mutex
    * fixed compielr errors
    * Added Watchdog Mutex
    * fixed compielr errors
    * Added assertions to catch os errors when interacting with the watchdog mutex
    * Added assertion to Task_Init.c
    * Included <stdlib.h> in files that use NULL to fix linking errors when building for the stm32f413
    [Task_BatteryBalance.c, Task_Init.c, Task_PetWDog.c, Task_VoltTempMonitor.c, Tasks.c, Tasks.h]
2020-10-17 Reseting timer if all tasks are set (#229)
    * Reseting timer if all tasks are set
    * Resets WDogTimer when all tasks are set
    * removed .vs directory
    [Task_PetWDog.c]
2020-10-21 Rtos safetycheck and fault sem4s (#227)
    * Adds safety sema4 operations to amperes and volttemp tasks
    * Adds safety check semaphore test
    * Testing on nucleo. Not running due to registers not being read...
    * Safety Semaphores working as they should be
    * Updates hasbeenchecked names and make CriticalState semaphore check more streamlined'
    * Adds safety sema4 operations to amperes and volttemp tasks
    * Adds safety check semaphore test
    * Testing on nucleo. Not running due to registers not being read...
    * Safety Semaphores working as they should be
    * Updates hasbeenchecked names and make CriticalState semaphore check more streamlined'
    * Adds assert functions
    * Adds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
2020-11-07 I2C Sem4 (#219)
    * Created ISR functions
    * Removed some while loops
    * Finished I2C transmission
    * Added some things for the receiving function of I2C
    * Everything is implemented as an interrupt instead of a while loop that checks for a flag. In my opinion, this decreased the readability of the code and might lead to some bugs because one flag can mean multiple things for an event. I had to make lots of global variables in order to determine which event was occuring given the flag that was set. I did not make mutexes for them because interrupts will be disabled when they are changed so another thread cannot read/write to them.
    * Created FIFO for bare metal version of BPS and add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
    [BSP_I2C.c, BSP_I2C.h]
2020-11-07 Decreases max temperature limit to INR's datasheets recommended release temperatures (#241)
2020-11-07 Finished fan drivers with 8 speed settings. (#132)
    * Finished fan drivers with 8 speed settings.
    * Added some comments
    * Changed function to be given speed. Fixed many bugs. Should consider returning value if function fails to change speed for some reason.
    * Changed file locations
    * Fixed bugs. Made everything follow coding style
    * Return value if function exits without changing speed of fan
    * Changed return value of function and variable names
    * Added defines to make things easy to change. Added function to return speed of fan
    * Changed what is included in c file
    * Making header files look the same
    * Fixed header file
    [BSP_Fans.h]
2020-11-07 Adding UART2 for CLI/BLE (#203)
    * Created new branch to add new UART for bluetooth module
    * Created new branch to add new UART for bluetooth module
    * Changed init function to also initialize UART 2
    * Changed functions so they can deal with usart 2 and 3. Just used same functions as before but added parameter of which usart to deal with and an if else statement inside the function. Created another fifo for usart2. Left fifo tx and rx sizes the same throughout but they can be changed with #defines.
    * Changed function calls in other files so it builds
    * Changed the variables to have enums. Started changing the code for the simulator
    * Added second uart to simulation
    * Added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
2020-11-07 Simulator (#235)
    * first I2C commit, just started .py file
    * Made 'PLL' and 'CAN' valid menu options regardless of if the simulator is using a battery object or by specifying a configuration
    * Layout of EEPROM option created - I2C functions need to be written now
    * simulator will start in its current state, unsure why some of the code makes it crash at start
    * started EEPROM_Dump, for some reason if I don't comment out the function the simulator crashes immediately. not really sure why.
    * Added Chase's suggestions:
    1. created menu with option to use numbers to select options
    2. Rearranged code in menu so that redundant code was removed
    * fixed typo in I2C.EEPROM_Dump()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
    [BSP_Fans.h, BSP_SPI.c, BSP_UART.c, Fans.py, I2C.py, LTC681x.c, LTC681x.h, SPI.py]
2020-11-10 Added fans to Voltage and Temperature task (#243)
    * Added fans to Voltage and Temperature task
    * Fixed build errors
    * Added fans to Voltage and Temperature task
    * Fixed build errors
    [BSP_Fans.h, Task_VoltTempMonitor.c]
2020-11-11 Faulttask (#240)
    * Set fans to full speed when in fault state
    * Set fans to full speed when in fault state
    * fixing git errors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
    [Task_FaultState.c]
2020-11-11 Added SPI1 and SPI3 Interrupt handlers. SPI1 pend/post functions are in the LTC6811 module and the SPI3 pend/post functions are in the Current module. (#242)
2020-11-16 threadInTaskInit (#233)
    * Create Thread in Task
    * Create Thread in Task
    * threadTaskInit
    * Create Thread in Task
    * threadTaskInit
    * nothing
    * added initialization
    * accepted changes for threads
    * added stack for ini
    * added extern in task.h
    * added void TaskInit
    * Initialized individual tasks
    * Fixed undefined references to Dashboard Notify variables
    * Makes tick frequency the same for all rtos bsps and enables ostaskdel for stm32
    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
    [Task_Init.c, Tasks.c, Tasks.h]
2020-11-16 Added undervoltage cutoff detection for charging (#246)
    * Added undervoltage cutoff detection for charging
    * Fixed bugs
    [Voltage.c, config.h]
2020-11-16 Changed GetModulesInDanger Function in Voltage.c (#244)
    * Changed GetModulesInDanger() to return a struct that returns SafetyStatus arrays for the wires and modules in our system.
    * Changed typedef struct name to "Voltage_Info".
    * Removed Test_CLI.c from pull request.
    * Return different error messages for under and over voltage
    [Voltage.c, Voltage.h]
2020-11-16 Log info edits (#247)
    * Sends the percentage of charge left in the battery pack to the EEPROM every 3 seconds
    * updated submodules and removed .vs/ directory from tracking
    * undo accidental changes to watchdog task
    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
    [Task_LogInfo.c]
2020-11-18 CLI Task (RTOS) (#245)
    * Added "openwire" command to CLI. CLI now pends/posts MinionsASIC Mutex, and Voltage_GetModuleMilliVoltage() now uses assertOS function.
    * Commented initialize() and __enable_irq() to avoid build fails with simulator.
    * Fixed typo in help menu, the command is "openwire", not "Openwire"
    * Added assertOSError() calls after OSMutexPend() calls in CLI.c and in Voltage.c (on lines specified in the pull request).
    [CLI.c, CLI.h, Voltage.c]
2020-11-21 Added CANBus_MsQ initialization to Tasks_Init(). (#251)
    * Added CANBus_MsQ initialization to Tasks_Init().
    * Added a macro for the CAN bus Queue length.
2020-11-21 CAN Interrupts and OS Integration (#226)
    * Restructure CAN BSP and driver to interrupt/OS.
    The CAN driver and BSP code was previously using polling-like
    techniques to send and receive messages. This will not integrate
    well with the move to uC/OS.
    The CAN drivers are being moved to an interrupt-driven system,
    whereby the receiving messages come via interrupt for later collection,
    and the transmitted messages utilize interrupts and locks to ensure
    thread safety.
    There are now two methods for transmitting messages. These are:
    * CANbus_Send, which preserves closely its old functionality for backwards compatibility.
    * CANbus_BlockAndSend, whic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
    [BSP_CAN.c, BSP_CAN.h, CANbus.c, CANbus.h]
2020-11-21 Fixed some compile warnings (#253)
    * Fixed the trivial compile errors
    * Deletes stdlib include in Task_PetWDog.c
    * Fixed more issues that Sijin and I found:
    1. Added while(1) loops to LogInfo and PetWDog
    2. removed unnecessasry includes
    3. got rid of weird question marks
    * added missing curly brace
    [BSP_SPI.c, CLI.c, Task_FaultState.c, Task_LogInfo.c, Task_PetWDog.c]
2020-11-21 CAN Bus Consumer Task (#255)
    * Changed the task to now use the CANMSG_t type and the CANbus_BlockAndSend() function instead of things from stm library.
    * Added CAN initialization to the task.
2020-11-27 Rtos admin startup (#256)
    * Adds startup code to allow admin privledges when charging
    * Adds AdminOverride parameter to Amperes Task to Current_CheckStatus
    * Adds startup code to allow admin privledges when charging
    * Adds AdminOverride parameter to Amperes Task to Current_CheckStatus
    * Adds startup code to allow admin privledges when charging
    * Adds AdminOverride parameter to Amperes Task to Current_CheckStatus
    * Adds startup code to allow admin privledges when charging
    * Adds AdminOverride parameter to Amperes Task to Current_CheckStatus
    * Adds startup code to allow admin privledges when charging
    * Adds AdminOverride parameter to Amperes Task to Current_CheckStat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
2020-12-12 Battery Balancing API (#134)
    * Created BatteryBalancing.c and .h files that have almost the same code from the "BatteryBalancing" branch. Changed the total_ic parameter from 0 to 4 in the LTC6811_set_discharge() call in setDischarge() because passing a 0 results in the function doing nothing. Changed the | to a ^ in ClearDischargeBit because 1^1 = 0.
    * Added comments for functions in header file. Delet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
2020-12-12 Battery Balancing Task (#265)
    * Filled in Battery Balancing Task.
    * Added MinionsASIC_Mutex pends and posts to appropriate balancing functions.
2020-12-12 Digitized amps (#204)
    * Add a preliminary driver for the Ampere minion.
    Important
    =========
    This is __not__ compatible with the simulator in its present state.
    This would require adding a SPI3 simulator, which I am not including
    in this commit.
    We're replacing the existing analog minion board with a digital one.
    This requires new drivers.
    This is my best guess at what an interface to the Ampere minion would
    look like, without actually having access to the hardware to test. It
    uses SPI3 to communicate to the minion, and includes what I think is
    necessary initialization.
    This also renames the Current.c/Current.h files and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
    [Amps.c, Amps.h, BSP_SPI.c, BSP_SPI.h, BatteryBalancing.c, CLI.c, LTC6811.c, LTC681x.c]
2020-12-12 changed the gpio pins for the leds (#200)
    * changed the gpio pins for the leds
    * ran dos2unix on the entire repo
    * changed lower case to caps
    * Complete the Lights drivers for new board.
    Code has been tested and confirmed to function on hardware.
2020-12-13 Can consumer (#258)
    * Added code to send telemetry data, it will not work until digitized amps branch is also merged into rtos.
    * Removed current.c because Amps.c exists
    * Typecasted all the variables
    * Fixed warnings
    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
    [Amps.c, Task_VoltTempMonitor.c]
2020-12-14 Testing (#269)
    * Make the lights test more fanciful
    * Get the contactor test working
    * Test LEDs and CAN BSPs
2020-12-19 Cdr changes (#270)
    * Added semicolon to BSP_SPI to fix build error with bare metal, added missing include in Balancing.c, removed dashboard notify task
    * Updated voltage and temperature cutoffs
    * Added calls to initialization functions and moved send telemetry data to CAN to be after determining if the car is safe, to increase responsiveness.
    Also some minor code cleanup and changes to shutoff limits
    * changed balancing tolerance to 50mV
    [Amps.c, BSP_SPI.c, BatteryBalancing.c, Task_BatteryBalance.c, Task_Init.c, Task_VoltTempMonitor.c, Tasks.c, Tasks.h]
2020-12-19 Add handling of a fault state. Also fix some simulator compile errors. (#262)
    * Add handling of a fault state. Also fix some simulator compile errors.
    * Added back CAN queue
    [Task_FaultState.c, Tasks.c, Tasks.h, main.c]
2020-12-19 Warnings (#263)
    * Remove warnings in the code. Add -Werror flag.
    There's a lot of warnings here, and we want to remove them. To make
    sure that we never have to do a commit like this again, this also
    adds the -Werror flag to both Makefiles.
    As a note, there were also some logic errors in the code as well.
    Fixing the warnings also brought some attention to fixing these.
    * Remove warnings in the code. Add -Werror flag.
    There's a lot of warnings here, and we want to remove them. To make
    sure that we never have to do a commit like this again, this also
    adds the -Werror flag to both Makefiles.
    As a note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
    [BSP_CAN.c, BSP_UART.c, CLI.c]
2020-12-22 Added Pending and Posting for Minions ASIC Mutex in Voltage Library. (#273)
    * Adds mutex for Voltage_OpenWire function
    * Adds mutex for Voltage_OpenWire function
    * Added Pend and posts for the Minions_ASIC mutex in the Voltage_GetModulesInDanger() function.
2020-12-23 Rtos issues (#274)
    * Fixed issues pointed out by chase
    * Added copyrights to all files missing them
    * Fixed build issues, RTOS/STM submodule was not updated
    * Used standard for defining structs
    * Removed adminOverride flag
    * Fixed issues
    * Changed battery balancing parameters
    [Amps.c, BSP_Fans.h, BSP_I2C.c, BSP_UART.c, BatteryBalancing.c, Task_BatteryBalance.c]
2020-12-25 Apply suggestions from Chase's code review
    Added curly brackets after if statements in Voltage .c
2021-01-16 Sugam's Documentation (#272)
    * Added myself as an author. Added documentation for CLI, Battery Balancing Task, and the CANBus Consumer Task.
    * Removed incomplete sentence.
    * Added additional info to meet the documentation standards established in the One Drive. Also added example CLI commands.
    * Updated Documentation according to Clark's pull request.
    * Changes in progress.
    * Finished "Yields" section for Battery Balancing.
    * Added documentation for the CLI task and addressed Clark's comments from the PR.
    * Removed high/low precision data information since we no longer use that in the BPS.
    * Added info for battery balancing
    * BB info
    * Update Docs/source/Softwar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
2021-01-19 Manthan's Documentation (#279)
    * Added Critical State and Fault State documentation
    * Organized Documentation
    * Added BSP documentation
    * Make it so it doesn't push build files
    * Hopefully this works
    * Removed files in build folder
    * Updated to Clark's Documentation Guidelines
    * Fixed warnings and created Hardware folder
    * Added documentation for fan board and strobe light
    * Fixed file names
    * Added formatting
    * Added regulation numbers
    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
2021-01-23 Added Timer documentation (#291)
    * Added Timer documentation
    * Added clarifications
2021-01-23 EEPROM Drivers docs (#294)
2021-01-23 Finished Watchdog timer documentation (#292)
    * Finished Watchdog timer documentation
    * Update BSP.rst
    Fixed Sugam's issues
    * Update BSP.rst
    Remove unnecessary lines
    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
2021-01-23 BSP SPI Documentation (#293)
    * SPI documentation
    * Added info regarding what each SPI bus was for
    * Added info about SPI_Wait function since it requires either BAREMETAL and RTOS to be #defined
    * Addressing Manthan's comments
    * More stuff that Manthan suggested
    * spi_port_t is an enum, not a struct
2021-01-23 Added Charge documentation (#298)
2021-01-23 Finished documentation (#299)
    * Finished documentation
    * Update Drivers.rst
2021-01-23 Finished documentation for CAN drivers (#296)
    * Finished documentation for CAN drivers
    * Fixed formatting
    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
2021-01-30 Finished Voltage Documentation (#301)
    * Finished Voltage Documentation
    * Added things Clark mentioned
    * Fixed more issues
2021-01-30 Temperature App Documentation (#302)
    * first edition
    * Finished
    * Changed "make" to "create" for clarity
    * Added info about Temperature_UpdateAllMeasurements()
2021-01-30 Sending Charging Suggestions (#308)
    * VoltTempMonitor Task now suggests not charging battery if temperatures are unsafe. Added CHARGE_ENABLE id to CANbus.h
    * Added loop to check if all modules are in the temperature range Clark mentioned. Moved this block to after temperature safety checks
2021-01-30 VoltTempMonitor Task Documentation (#310)
    * Added VoltTempMonitor Task documentation
    * Added more info about functionality.
    * Addressed the comments that Clark left on the PR
2021-01-30 RTOS header commments (#311)
    * Made all header file defines the same format. Added @param and @return wherever they were missing. Added extra information where needed. Fixed incorrect information that was from old version of BPS. Fixed tabs issues in #defines.
    * Update Apps/Inc/Charge.h
    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
    [Amps.h, BSP_ADC.h, BSP_CAN.h, BSP_Contactor.h, BSP_Fans.h, BSP_I2C.h, BSP_Lights.h]
2021-02-13 Checks if BPS was previously reset. If it has, enters fault state. (#320)
    * Checks if BPS was previously reset. If it has, enters fault state.
    * Checks if BPS was previously reset. If it has, enters fault state.
    [main.c]
2021-02-13 Reverted BSP_I2C to use polling instead of interrupts. (#319)
    [BSP_I2C.c]
2021-02-13 Added extra error codes to EEPROM (#321)
    * Added extra error codes to EEPROM
    * Added error code for os error
    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
    [EEPROM.c, EEPROM.h]
2021-02-13 Added Charge library calls to the Amperes task. Also updated comment for Charge_Calculate() (#324)
2021-02-13 PEC Error Code Fix (#323)
    * Added wrapper classes that check for consecutive PEC failures for the 6 LTC6811 library functions that return PEC error values. Added MAX_PEC_ERRORS macro. Removed "ErrorStatus" type from Voltage_Init(), Voltage_UpdateMeasurements(), Temperature_Init() because the error status wasn't being used. Updated Battery Balancing, Voltage, and Temperature files to use wrappers.
    * Changed wrapper function names to end with "_safe" instead of "_wrap". Also corrected the while loop condition in each while loop
    * Added assertOSError() calls after every fault sem post.
    [BatteryBalancing.c, LTC6811.c, LTC6811.h, Temperature.c, Temperature.h, Voltage.c, Voltage.h, config.h]
2021-02-13 PEC code checking documentation and charge library calls in Amperes task documentation. (#326)
2021-02-14 Fault State issue (#317)
    * Fixed issue where fault state calls other tasks functions that could lead to yielding
    * Added enum for fault reason. Not sure why .vscode was changed but that can be removed if needed
    * Added multiple error codes to fault state task
    * Fixed issue where fault state calls other tasks functions that could lead to yielding
    * Added enum for fault reason. Not sure why .vscode was changed but that can be removed if needed
    * Added multiple error codes to fault state task
    * Added flag that replaces semaphore in case os crashes. Used to bypass pend and post functions whenever data is needed to log to the EEPROM.
    * Fixe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
    [Amps.c, BSP_I2C.c, Task_FaultState.c, Task_VoltTempMonitor.c, Tasks.c, Tasks.h, Temperature.c, Voltage.c]
2021-02-14 Rtos issues (#328)
    * Fixed comment
    * Separated Amps task and app.
    * Made BSP CAN compatible with RTOS, fixed CAN and SPI IRQ handlers. Also added MinionsASIC_Mutex to tasks.c instead of in its own file
    * Fixed interrupt handlers
    * Reverted files with unnecessary changes
    * Added Fault_BitMap to Task_Amperes.c
    Required to finish merging rtos into rtos_issues2
    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
    [Amps.c, BSP_CAN.c, BSP_UART.c, BatteryBalancing.c, CLI.c, LTC6811.c, Task_Amperes.c, Tasks.c]
2021-02-20 Rtos uart (#327)
    * Update UART BPS, do fancy generic programming
    * Fix order of Systick initialization
    [stlink-v2.cfg, stm32f4x.cfg]
2021-02-20 Overview docs (#332)
    * Add acronyms to Glossary
    * Add Getting Started section
    - Add Getting Started to index
    - Remove rogue glossary definition in introduction
    * Add hardware overview section
    - Started adding content to this section. More to come.
    - Add battery box cross section image
    * Add hardware overview to Index
    * Content changes to overview and getting started
    - For overview, changed Current board to Amperes board
    - For getting started, add F413 to STM32 controller name
    * Move abbreviations into separate page
    * Add MOSFET to abbreviations
    * Minor content changes based on reviews
    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
2021-02-21 Rtos uart (#335)
    * Fix issue with UART dropping bytes and clean a bit.
    * UART tested and working
    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
    [BSP_UART.c, BSP_UART.h, Test_BSP_UART2.c]
2021-02-21 Rtos can (#330)
    * Fix up the CAN BSP layer and fifo.h
    * CAN works for real this time, I swear!
    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
    [BSP_CAN.c, BSP_UART.c, Test_BSP_CAN.c, Test_BSP_UART.c, Test_RTOS_CAN.c, fifo.h]
2021-02-27 SPI now has higher priority than both UARTs. UART3 is a higher priority than UART2. (#336)
2021-02-27 Added UART and SPI Priority Info to Documentation (#337)
    * Added UART and SPI interrupt priority info to each of their respective sections in BSP.rst
    * Added prio level info in BSP.rst and created "Interrupts" section in design-overview.rst
2021-03-03 Display board documentation (#340)
    * Adding Dislay Board Documentation
    * Added Display Board Documentation
    * fixed issue
    * Fix issues
    * Everything should be standardized by now
    * Apparently, the lines between the bullet points makes the header for those bullet points bold. This fixed it on my machine and I also fixed the warnings. Hopefully this works on all machines.
    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
2021-03-03 Added fan board documentation (#339)
    * Added fan board documentation
    * Extra stuff
    * Made things pretty
    * Update Docs/source/Hardware/Boards.rst
    * Fixed issues. PWM will be listed as a term that does not exist but it is included in the prettydocs pull request
    * Fixed warnings and made website wider so more content can fit
    * Changed term name to correct term
    * Added pwm to glossary
    * Update Docs/source/glossary.rst
    * Update Docs/source/Hardware/Boards.rst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
2021-03-06 Adding a 100ms delay to Amperes, Battery Balancing, and VoltTempMonitor tasks (#342)
2021-03-06 Resetting contactor in main (#345)
    * Resetting contactor in main
    * Resetting contactor in main
    [main.c]
2021-03-06 Added documentation of fuse (#344)
    * Added documentation of fuse
    * fixed issues
2021-05-15 Default handler (#354)
    * Set the default interrupt behavior of the system.
    This sets the default behavior of the system upon entering an
    unknown interrupt to jump to the hardfault handler, which has
    been previously aliased to a call to the fault condition
    function. This is more proper behavior than looping continuously.
    * Fixed some issues with the Fault State and made the fault handlers not inlined
    [Task_FaultState.c, Test_DefaultHandler.c]
2021-06-03 verified FaultState task and added some fixes with LEDs. Also copy and pasted Chase's BSP_LED implementation from master branch (#357)
    [BSP_Lights.c, BSP_Lights.h, Task_FaultState.c, Test_FaultState.c]
2021-06-16 Working SPI and also some fixes for SPI3 (#355)
    * work in progress
    * work in progress
    * got BAREMETAL working
    * work in progress
    * I'm pretty sure it's working, but interrupts don't seem to help performance
    * Modify the fifo and spi to do interrupts better.
    We weren't really taking advantage of them with the older
    code
    * Get SPI working.
    This commit encompasses quite a bit:
    - Modifies the SPI interrupt method to take better advantage
    of the time that interrupts give us.
    - Modifies some test cases to appropriately test SPI and the LTC6811.
    - Fixes a bug in the LTC6811 driver (not initializing a semaphore).
    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
    [BSP_SPI.c, LTC6811.c, Test_BSP_SPI3.c, Test_BSP_SPI_RTOS.c, Test_LTC6811.c, config.h, fifo.h]
2021-06-17 adds the documentation for the minion board to the website (#348)
    * adds the documentation for the minion board to the website
    * fixes the problems with Minion Board and adds the Doc. for Amperes, Shield, Shunt, Test, and Scrutineering
    * fixes the documentation with what Manthan's comments
    * Minor typo fixes and add restructedText.conf to .vscode
    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
2021-07-03 Adds test for battery balancing task (#376)
    * Adds test for battery balancing task
    * Makes changes from review
    * Adds voltage initialization
2021-07-03 Voltage Test Plan (#379)
    * fixed build errors in original Test_Voltage.c
    * create test plan for Apps/Src/Voltage.c
    Also make some minor changes I saw would be nice when making the test
    (changed some variable types to make more sense, removed an unused enum)
    * added while loop at end of test
    [Amps.c, Amps.h, config.h]
2021-07-17 Critical State Test (#377)
    * Added 2 test files for Critical State task
    * Added test plan comments to both files
    * Added Light toggle statements for heartbeat
    * Added additional details to test plan.
    * removed steps that used test board and UART
    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
    [Test_CriticalState_1.c, Test_CriticalState_2.c]
2021-07-31 Test as8510 (#384)
    The interrupt have been modified to buffer data being written/read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
2021-07-31 Test amperes task (#385)
    * created test plan for Amperes task
    * fixed compile error
    [Test_Amperes_Task.c]
2021-08-28 remove most floating point math and disable floating point unit (#391)
    * remove most floating point math and disable floating point unit
    * respond to Chase's comments
    * changed lookup table to const
    * remove floats in test case
2021-08-29 CAN bug fixes (#395)
    * make a CAN queue that can actually store CAN messages
    * Got CAN Task working.
    I fixed the following bugs:
    - Fixed initialization of CAN Tx interrupts in BSP
    - Allowed BSP_CAN and CANBus to be initialized in loopback mode
    - Updated list of valid CAN messages and associated switch statement
    - Fixed CANBus error handling that was causing resource leak
    - Changed some defines in config.h to the correct values
    * respond to Manthan's comments
    [BSP_CAN.c, BSP_CAN.h, BSP_UART.c, CAN_Queue.c, CAN_Queue.h, CANbus.c, CANbus.h, Task_Amperes.c]
2021-10-16 Voltage task bugs (#406)
    * Voltage.c line 150: Max voltage limit was multiplied by 1000 for previous voltage values
    * Added safe function to LTC6811 test file and removed test UART functions from Voltage
    * Removed test UART oved test UART from LTC Driver code
    * Removed code that used MILLI_SCALING_FACTOR since everything is already set to milli. Added storing for safe value if voltage read is safe.
    * Removed useless changes
    * Made open wire only check for amount of batteries connected instead of all channels
    [LTC681x.c, Temperature.c, Test_LTC6811.c, Voltage.c, config.h]
2021-10-30 New Amperes Board drivers (#405)
    * Drivers written but not verified
    * Remove AS8510 files
    * Merge ADS7042 and Amperes App tests to test both
    * Fix bits shifting
    * fixed ADS7042 driver
    * some cleanup
    * change constant names
    [Amps.c, BSP_SPI.c, BSP_SPI.h, Task_Amperes.c, Test_BSP_SPI3.c]
2021-11-20 SPI fixes and Temperature Monitoring Completion (#403)
    * Updated temperature lookup table with more accurate one and wrote temperature test plan
    * fixed build errors
    * Added RTOS to Test_Temperature
    * Added check for out of bounds for LUT
    * Fixed error checking in LTC function
    * Added debugging statements, changed line to mimic online resources.
    * Fixed SPI issue. cs was set high before entire SPI message was sent so there were timing issues. Also added mutex pend before accessing SPI bus
    * changed update single channel to return temperature instead of voltage
    * got temperature test working with 2 minion boards daisy chained together
    * Code cleanup in progress, cha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
    [BSP_SPI.c, LTC6811.c, LTC681x.c, Temperature.c, Temperature.h, Test_Temperature.c, voltToTemp.py]
2021-12-13 Bsp timert bugs (#409)
    * altered BSP_Timer.C to count up instead of down, and then Charge.c to utilize the changes in BSP_Timer correctly.
    * Altered BSP_Timer.c to have a prescaler at val 200 and altered Test_BSP_Timer to wait 2.5 seconds between printting to console. Finally, changed Charge.c to have a more accurate mAh for the battery pack, to have charge be a signed integer, and we also fixed the math in line 42 to exclude bugs and to take into account us using mAh instead of Ah
    * Added a function in BSP_Timer.c that calculates microseconds elapsed since alst function call. Also changed Charge.c charge calculation to incorporate this new function (altered charge resolution scale to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
    [BSP_Timer.c, BSP_Timer.h, Charge.c, Test_BSP_Timer.c, Test_Charge.c]
2021-12-18 Volt temp monitor task test (#407)
    * Created test plan for VoltTempMonitor Task
    * Fixed Comments
    * got temperature test working with 2 minion boards daisy cha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
    [BSP_SPI.c, Task_FaultState.c, Task_PetWDog.c, Task_VoltTempMonitor.c, Temperature.c, Voltage.c, config.h, main.c]
2021-12-21 Added changes to Apps and Tasks for Voltage and Temperature.
2021-12-22 Amperes Software Working (#419)
    * updated bit shifting for ltc3215
    * Add sleep mode and adjust wakeup timings
    * rename to the new adc (LTC2315)
    * Revert scaling changes and add testing with voltages to the test plan
    * got LTC2315 test working with power supply. Noisy source (bettery connected to motor) does not perfomr well
    * got amperes task working. Tested with BPS trip limits of 3000 mA. BPS tripped between 3100 and 3500 Amps each time
    * got amperes task working with volt temp task and cleaned up the code
    * fixed test to post safety check semaphore 3 times for voltage, temperature, and open wire
    * Apply suggestions from code review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
    [Amps.c, BSP_SPI.c, BSP_SPI.h, LTC2315.c, LTC2315.h, Task_Amperes.c, Task_Init.c, Task_PetWDog.c]
2021-12-29 change contactor GPIO pin to use pull-down resistor (automerger changed it to use pull-up)
2022-01-04 modified amperes checks to take the battery pack temperature into account (#426)
    * modified amperes checks to take the battery pack temperature into account
    * clean up Amps_CheckStatus
2022-01-15 Sign change on current driver (#434)
2022-01-16 Check contactor task (#435)
    * created task for checking the contactor state to see if the estop button is pressed. also updated fault bitmap fields
    * got it working
    * don't use CAN if any of the faults were OS faults
    * prioritize check contactor over volt/temp and amperes
    * updated critical state test plan instructions
    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
    [LTC2315.c, LTC6811.c, Task_CheckContactor.c, Task_FaultState.c, Tasks.c, Tasks.h, Test_CriticalState_1.c]
2022-01-16 Small updates to README and Docs (#433)
    updated rules on code reviews. re-oredered approvers based on
    how many reviews I think they will do in the near future.
    Updated shunt resistor and fuse docs
2022-01-29 Can consumer test (#437)
    * Added charge enable message to VoltTempTask
    * Removed CAN charge_enable message from for loop
    * work in progress. changed config for our setup, removed some unnecessary error checks, and added some debugging code
    * fixed CAN by properly returning error codes
    also changed CAN mailboxes to FIFO to make understanding BPS CAN output easier
    * code cleanup
    * added script for launching openocd for debugging
    * Undo changes to config, etc.
    * Fix minor build issues in driver layer
    [BSP_CAN.c, BSP_Fans.h, CANbus.c, LTC6811.c, LTC681x.c, Task_PetWDog.c, Task_VoltTempMonitor.c]
2022-02-17 Integration bugs (#438)
    * work in progress, some bug fixes from battery integration
    * WIP SPI fixes
    * WIP
    * fix pet WD logic, reduce minions SPI baud rate, increase watchdog period, fixes to temperature logic
    * clean up code in response to Manthan and Hannah's reviews
    * working at ~4 Hz sample rate
    * some more performance optimizations. got to 6-7 Hz
    * added some comments
    [Amps.c, BSP_SPI.c, BSP_SPI.h, BSP_WDTimer.c, LTC2315.c, LTC6811.c, LTC681x.c, Task_Amperes.c]
2022-02-20 Added documentation for other shared resources. (#436)
    * Added documentation for other shared resources.
    * Added temperature sensor documentation to Hardware side
    * Added virtual box documentation, more shared resources, and changed AS8510 to LTC2315
    * Update Docs/source/Software/Apps.rst
    * Added Clarks suggestions
    * Adding newlines so it's easier to edit in the future.
    * Fixed compile issues and added Clark's suggestions
    * Remove unnecessary changes
2022-04-16 Added state of charge to amperes thread and rewrote EEPROM code (#441)
    * wrote M24128 driver
    * wrote EEPROM app
    * removed old EEPROM driver
    * got M24128 driver and EEPROM app working
    * updated comments in Charge.h and added calls to charge functions to Amperes task
    * moved EEPROM and Charge initialization to before watchdog is enabled, and prevented compiler from optimizing out delays in BSP_I2C
    * added error handling to EEPROM and tested with motor. Fixed task log info to use correct stack
    * make amperes test print out values over UART
    [BSP_I2C.c, CLI.c, Charge.c, Charge.h, EEPROM.c, EEPROM.h, M24128.c, M24128.h]
2022-04-23 Eeprom (#444)
    * fixes from testing
    * moved EEPROM and Charge initialization to before watchdo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
    [Amps.c, Amps.h, LTC2315.c, LTC2315.h, Task_Amperes.c, Task_Init.c]
2022-04-23 Updated all copyright headers to current year (#446)
2022-04-30 Added Components Docs (#445)
    * Update documentation for strobe light and add documentation for horn. Also added setting to ignore build files in source folder and allow viewing markup in vscode
    * Added configurations to ignore duplicate label warnings. Fixed some warinings. Added more documentation.
    [BSP_CAN.c, BSP_Fans.h]
2022-05-01 Fixes from controls integration (#451)
    * added noise limit to determine if we are charging
    * Allow making on gcc versions less than 8.1
    [Amps.c, EEPROM.c, LTC681x.c, config.h]
2022-05-06 Median filtering (#453)
    * fix some EEPROM stuff
    * median filtering for temperature
    * fixed bug in median function and added filtering to voltage. It seems significantly more robust to regen noise than before
    [EEPROM.c, Temperature.c, Voltage.c]
2022-05-31 Created generic median filter and used it in voltage.c (#460)
    * Created generic median filter and used it in voltage.c
    Also increased the filter depth for voltage measurements
    Also made some minor coding style improvements to voltage.c
    * fix a sizeof and some comments
    * make filter update list of filtered values
    [MedianFilter.h, Test_BatteryBalancing_Task.c, Voltage.c]
2022-06-18 Added Charge disable for high voltage readings (#469)
    * Added charge disable at high voltage so fault condition does not occur
    * Changed Voltage Cutoffs
    * added compile-time assertion to compare voltage trip limit and max charing voltage
2022-09-03 Updated ReadMe (#474)
    * Updated ReadMe
    * Updated makefile to default to making stm32f413
    * made better makefile changes
2022-09-12 👁️👄👁️ (#476)
    Update Sphinx Version
2022-09-20 added the beginnings of a new simulator. doesn't compile yet. pushing so I can collaborate with others
    [BSP_ADC.c, BSP_CAN.c, BSP_I2C.c, BSP_Lights.c, BSP_PLL.c, BSP_SPI.c, BSP_Strobelight.c, BSP_Timer.c]
2022-09-24 got volt temp task test working in simulator
2022-10-15 Compile line config ability (#491)
    * does preprocessor printing and lets user specify when running make.
    * adjusted names for compiler config options, and printing the values at the last possible location in GCC output
    * add a readable flag to the makefiles to limit console output
    * defaulting to clean output
    * added pretty colors :)
    * output fixing, make help is descriptive
    [config.h, config_msgs.c]
2022-10-15 Sim v2 cjson rewrite (#487)
    * working on CAN sim
    * removed testing lines from sim.c
    * pulled changes from clark
    * CAN sim logging functional but strings output in reverse order
    * removed bad test
    * added some real tests, want to reorder the sim structure a bit, waiting on clark
    * rewriting simulator.c file with the cJSON functions for readability
    * Rewrite works and supports all fields. Provided an emptytest.json file for making sure dummy values fill properly.
    * adjusted dummy values to not trip immediately
    * adjusting some files real quick
    [BSP_CAN.c, Simulator.c, Test_SimulatorCAN.c]
2022-10-21 Added comments to top of all files. Removed Strobelight.c. Started working on UART_Readline.
2022-10-21 Made new version default for being compiled. Changed logging to work with different logging levels. Fixed bugs.
    [ADC.py, BSP_ADC.c, BSP_CAN.c, BSP_I2C.c, BSP_Lights.c, BSP_PLL.c, BSP_SPI.c, BSP_Strobelight.c]
2022-10-22 Copyright update for files (#499)
    * updated all copyrights to 2018-2022, also script included
    * fixed weird bug where it does not recognize degrees symbol and types a bunch of jargon
    * deleted template files
    [ADC.py, Amps.c, Amps.h, BSP_ADC.c, BSP_ADC.h, BSP_CAN.c, BSP_CAN.h, BSP_Contactor.h]
2022-11-05 Sim v2 timer (#496)
    * reset branch and changed timer file
    * fixes comments for getrunfreq and make it return 0
    * added test for bsp_timer, changed simulator log char[] size to 128
    [BSP_Timer.c, Simulator.c, Test_SimulatorTime.c]
2022-11-05 BSP_CAN for simulator v2 (#485)
    * added init guards around read/write
    * added other test, fixed printing
    * removed unnecessary sim file
    * got volt temp task test working in simulator
    * fixing files deleted
    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
    [BSP_CAN.c, BSP_CAN.h, Test_SimulatorCAN.c]
2022-11-05 Multiple contactor support (#490)
    * Updated Contactor for individual support, and fixed some header issues for the BSP files
    * rewrote files to use the new enum to specify contactors
    * updating contactor files and adjusting function calls
    * manthan changes
    * fixing contactor names
    * Update BSP/STM32F413/Src/BSP_Contactor.c
    * fixed build error. wasn't an actual error
    [BSP_Contactor.h, BSP_I2C.c, BSP_Lights.c, BSP_PLL.c, BSP_SPI.c, BSP_Timer.c, BSP_UART.c, Task_CheckContactor.c]
2022-11-06 BSP_CAN fix (pt 2) (#506)
    * refixed
    [BSP_CAN.c]
2022-12-03 Pid loop (#486)
    * *created PID loop app and header file
    *get avg temp in Task_VoltTempMonitor(still setting things up)
    *PID.c has function that is really only a P loop
    *Proportion constant not set yet, other var: Integral, Derivative not set
    * Added ID to PID_output, also added Clark's fixes to compiler
    * Completed prelim PID loop func, integrated PID app with Volt temp task, need to tune PID
    added new constants to config file for PID loop
    * fixed header files and capitilization
    * added defines for max fan speed and divisor
    * changed headers
    * changed max temp
    * moved PID to temp.c
    * added todo got rid of some parts of if statement, kept PID_MAX_TEMP define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
    [Task_VoltTempMonitor.c, Temperature.c, Temperature.h, config.h]
2022-12-10 Simulator test structure overhaul (#513)
    * init commit
    * working on parser driver header
    * index on sim_test_structure: 63ec046 Merge branch 'simulator_v2' of github.com:lhr-solar/BPS into sim_test_structure
    * working on sim testing
    * updating output log level of BSP sim funcs
    * finalizing sim outputs, fixed task creation
    * more formatting changes w/ help from Tianda
    * pulled header changes should compile
    * print out simulator out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
    [BSP_ADC.c, BSP_CAN.c, BSP_Contactor.h, BSP_I2C.c, BSP_Lights.c, BSP_PLL.c, BSP_Timer.c, BSP_WDTimer.c]
2022-12-10 Fix Simulate Temperature where it reads index >= 61 (#517)
    * fixed segfault where it reads more index more than 61
    * whoops fixed index max to 62
    * changed 62 to a define
    [Temperature.c]
2022-12-30 Add PWM documentation (draft) (#520)
    * Update PWM documentation
    * Fix grammar
2023-01-07 Add Pwm on simulator (#519)
    * added new test files
    * fix build error
    * remove extra comment
    * added pwm support
    * fix compile error
    * removed test files, but no working :(
    * moved contactor input pin code to BSPPWM instead of in contactor, made simulator compile
    * fix simulator Contactor_Get(), switch to 0 base indexing
    * added contactor status in simulator
    [BSP_CAN.c, BSP_PWM.c, BSP_PWM.h, Contactor.c, Contactor.h, Fans.c, Fans.h, Task_CheckContactor.c]
2023-01-07 Basic test action (#521)
    * added testing infrastructure and footest
    * quick fix for compiler error in BSP_CAN
    * maybe it wants to see pull_request: in yaml
    * renamed yaml file
    * changed some stuff back
    * fixed some indentation
    * fixed run syntax
    * added rtprio stuff
    * run with sudo instead of messing with rtprio
    * use script to run simulator with rtprio and sudo
    * add execute premissions to test.sh
    * move more to test.sh
    * test with wrong expected results to test for failure
    * fix expected result
    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
    [BSP_CAN.c, BSP_I2C.c]
2023-01-14 Simulator bugfixes (#522)
    * Made simulator compatible with multiple pins for contactors and different levels of abstraction for PWM. Fixed bugs in code for contactor
    * Made code look nicer
    * Added unit tests to github workflow
    * Added unit tests and removed unnecessary tests
    * Fixed stack smashing bug
    * Made code less error prone
    * Removed double creation of pet watchdog task
    * Fixed contactor checking and output logging. Still need to debug why multiple peripherals cannot verify end state properly
    * Fixed bug in verify_test which read first state of sub peripheral instead of last state
    * Actually added checks for initialization of BSP peripherals
    * Started work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
    [Amps.c, BSP_ADC.c, BSP_CAN.c, BSP_I2C.c, BSP_Lights.c, BSP_PLL.c, BSP_PWM.c, BSP_PWM.h]
2023-01-19 Fixed whitespace changes and removed old code
    [Amps.c, BSP_PWM.c, BSP_PWM.h, Contactor.c, Contactor.h, Fans.c, Fans.h, Simulator.c]
2023-01-22 Rtos + Simulator_v2 (#527)
    * Rtos bps mutex post (#475)
    * Writing RTOS_BPS_MutexPost wrapper functions, researching FreeRTOS
    * checking for style guide and comments
    * re-added (void) to func params
    * adjusting Tasks.h/.c to use typedef'd BPS OS error type
    * fixing comments
    * removed MutexPost returning bps_os_err
    * RTOS Mutex Pend Wrapper
    takes in pointer to Mutex, timeout in ticks, and option to block or not
    returns timestamp and error in ticks and err respectively
    * Implementing MutexCreate (#478)
    * 👁️👄👁️ (#476)
    * working on mutexcreate
    * whoops fixed my error
    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
    [Amps.c, BSP_CAN.c, BSP_I2C.h, BSP_PWM.c, BSP_SPI.c, BSP_SPI.h, BSP_UART.c, BatteryBalancing.c]
2023-01-29 Pwm and individual contactor (#530)
    * adjust contactor pwm duty cycle
    * finalizing pwm and contactor
    * Revert "fix faultstate"
    This reverts commit 55b679646b01cfd0ff93b6f23c7e53d209ebf0cd.
    * Fixed issues code readability. Followed coding styles
    ---------
    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
    [BSP_PWM.c, BSP_PWM.h, Contactor.c, Contactor.h, Task_FaultState.c, Test_Contactor.c, main.c]
2023-02-04 new milliVolt To Milli Celsius chart (#531)
2023-02-11 Modified bsp_can_write to return an error if the length of the data is greater than 8 bytes. (#534)
    [BSP_CAN.c]
2023-02-18 makefile print test file, make simulator have readable make output (#544)
2023-02-20 Volt temp testing (#550)
    * made EnterFaultState Entry nicer
    * changed type of Fault_Bitmap for better error messages
    * Removed Task Fault State (#535)
    * adjustments for fault state for debugging
    * Remove Fault_Sem4 from code
    * Removed more fault_sem4 stuff
    * Made it so we don't have to change config whenever we change NUMMINONS
    * Removed code that was used for testing
    * Fixed build issues
    * Removed printf's and allowed changing of NUM_MINIONS during compiletime
    ---------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
    [BatteryBalancing.c, Simulator.c, Simulator.h, Tasks.c, Tasks.h, Temperature.c, Test_Amperes_Task.c, Test_BatteryBalancingSim.c]
2023-02-27 Autogenerate/autorun Simulator Tests (#518)
    * add charging/discharging overtemp tests
    * first commit of automated testing, needs makefile changes and implementation
    * makefile can now compile testgen
    * make the pretty makefile colors work right
    * Test_Generator now working, addressed raymond bugs
    * makeclean removes autogenerated simulator files
    * fix bash error message
    * refactor main method in testgen
    * abuse preprocessor for random function
    * make code more readable, fix indexing errors
    * remove unnecessary test files
    * makefile colors fixed
    * automate testing and generate expected output
    * apparently ulimit doesn't exist
    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
    [Automatic_Tester.c, Simulator.c]
2023-02-28 Make tests workflow (#543)
    * Made things easier to debug
    * Fixing all test make issues. Need to make script to run simulator tests
    * Made good script to make all test files
    * Add sudo so workflow works
    * debugging cwd
    * shell env
    * explicitly run sh
    [Test_Amperes_Task.c, Test_BatteryBalancing.c, Test_Contactor.c, Test_FaultState.c, Test_LTC6811.c, Test_LTC6811_Deadlocks.c, Test_SafetyCheck.c, Test_SimulatorCAN.c]
2023-03-04 Detect and fault on contactor fail, Merge Crit State into Check Contactors (#533)
    * Added code to detect and trigger fail if a contactor has failed
    * Added include for contactor code in task init
    * Moved critical state task to check contactors task; replaced critical state with check contactors; added test for welded contactor detection and response code
    * Removed references to fault state task and semaphore
    * Removed critical state task file; Updated documentation for critical state/check contactors
    * Removing additional references to critical state
    * - Start the Pet Watchdog task before waiting on the Safety Sem4 in Check Contactor task.
    This allows us to detect and fail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
    [FaultState.c, Task_CheckContactor.c, Task_Init.c, Tasks.c, Tasks.h, Test_Amperes_Task.c, Test_CheckContactor_1.c, Test_CheckContactor_2.c]
2023-03-10 kill switch for simulator (#545)
    * kill switch for simulator
    * add killswitch test output
    * remove extra func from sim pwm
    * add more states to killswitch test. works on estop properly
    * add killswitch.json to tests
    * Update simple-tests.yml
    * killswitch tests in wrong folder
    [BSP_PWM.c, Simulator.c]
2023-03-10 moved delay_u and m to BSP_PLL, also renamed with BSP prefix (#566)
    * moved delay_u and m to BSP_PLL, also renamed with BSP prefix
    * fixed reference
    * made loops volatile, added PLL prefix
    * replaced ltc2315
    * Updated Documentation
    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
    [BSP_PLL.c, BSP_PLL.h, LTC2315.c, LTC681x.c, Simulator.c, Temperature.c]
2023-03-10 SPI Error Handling (#565)
    * propogate errors thru SPI_Write() and SPI_Read()
    * update headers
    * add simulator revisions
    * enter fault state on spi error
    * change from bools to errorstatus
    * update comments
    * Added enum and added more error handling
    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
    [BSP_SPI.c, BSP_SPI.h, LTC2315.c, LTC681x.c]
2023-03-25 Can fault state (#548)
    * minor comments
    * Built CAN code
    * Added temp can-payload in fault state task
    * always deinit in faultstate
    * use PLL delay
    * fixed fault state sending
    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
    [BSP_CAN.c, BSP_CAN.h, CANbus.c, CANbus.h, FaultState.c, Task_CANBusConsumer.c, Test_BSP_CAN.c, Test_FaultState_CAN.c]
2023-03-25 Voltage testing (#572)
    * Voltages won't update after reading first time
    * Fix whitespace and properly use Minions ASIC Mutex
    * Gave larger FIFO to BSP UART. Removed BSP Toggle from Test File (one race condition). For some reason Mions.cells.c_codes is not updating during operation. Need to figure out why.
    * Updated files to show more information during compile time. Also changed usage of MinionsAsic Mutex in Temperature.c
    This reverts commit 62d020e48e5f709fda7147cb3a435738f966ad75.
    * bsp pll delay um 🙄
    * Going to work on temperature testing on another branch
    * Make tests workflow (#543)
    * Fixing all test make issues. Need to make s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
    [BSP_Timer.c, BSP_UART.c, BSP_WDTimer.c, Task_CheckContactor.c, Task_Init.c, Task_PetWDog.c, Task_VoltTempMonitor.c, Temperature.c]
2023-03-26 added pthread mutex to prevent race condition in non thread safe writ… (#564)
    * added pthread mutex to prevent race condition in non thread safe write within Simulator_Log
    * made mutex static
    [Simulator.c]
2023-03-30 Interrupt Priorities File (#577)
    * Added file
    * Can fault state (#548)
    * Voltage testing (#572)
    * Updated files to show more information during compile time. Also changed us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
    [BSP_CAN.c, BSP_SPI.c, BSP_UART.c, Interrupt_Priorities.h]
2023-04-10 Makefile print better (#575)
    * display every (editable) #define value. can be adjusted to show all config defines if need
2023-04-15 Fix Simulator Workflow bugs (#576)
    * fix json file length
    * maxparallel change in simple-tests
    * upgrade simulator version
    * fix test build
    * Fix SafetyCheck_Sem4 redefinition error in tests
    [Automatic_Tester.c, Simulator.c, Test_Amperes_Task.c, Test_BatteryBalancingSim.c, Test_SafetyCheck.c, Test_Tasks.c, Test_TemperatureBuffMutex.c]
2023-04-15 update pid loop (#561)
    * change to int 8
    * math and sign changes
2023-04-16 Temperature Bug Fixes (#580)
    * Fixed bugs, added printf statements to debug
    * Added .swp file type to gitignore (#532)
    * Modified bsp_can_write to return an error if the length of the data is greater than 8 bytes. (#534)
    * Update Debugging info and add PR check (#536)
    * More Testing
    * Fixed test file
    * Made it so we don't ha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
    [BSP_Lights.c, BSP_PLL.c, BSP_PWM.c, BSP_UART.c, BSP_WDTimer.c, BSP_WDTimer.h, Charge.c, EEPROM.c]
2023-05-01 BPS Works (#587)
    * BPS Works
    * 😍 hehe poop
    * Removed debugging stuff
2023-05-06 Better delay (one shot timer based) (#585)
    * peep the cursed code
    * I forgot NVIC
    * Debugging changes
    * a
    * ⌚⏰⏱️⏲️🕰️🕛🕧🕐🕜🕑🕝🕒
    * 4space
    * add critical section to isr
    * rebassey
    * tabs2spaces
    * me when simulator 🐒
    * grrrr
    * documentation
    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
2023-09-16 Fix commit error for gcc version 13
    [LTC681x.c]
2024-03-07 output data rate volttemp (#598)
    * raymond
    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
2024-04-01 Integration (#592)
    * send CAN updated, :japanese_goblin:
    * added receive queue and CANBusProducer task to grab from that receive queue, :smile: :penguin:
    * dummy to test simulator we wooo
    * UART Printing works
    * CANProducer working, CAN_Task test can send/receive and print messages
    * two can sends one receive :japanese_goblin:
    * build fix for one of the tests - updated can id lol :smile:
    * CAN filtering for only array state change applied, test also updated :boom:
    * sending contactor statuses added and Test_CAN_task.c updated with a slower can transmit(more realistic)
    * Added CheckArrayContactors test interfacing with Task CheckContactor
    * PR changes and fixed f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
    [BSP_CAN.c, BSP_CAN.h, BSP_PWM.c, BSP_UART.c, BSP_WDTimer.c, CANMetaData.c, CANMetaData.h, CAN_Queue.c]
2024-06-07 Buffer print (#589)
    * print queue v0
    * revert some things
    * new print queue framework & calling pattern, new fifo lib
    * task
    * task sorta works -- some race causing issues with the task.
    * works and doesn't get starved!!
    * cleanup
    * minor timeout change
    * default to enable print
    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
    [BSP_UART.c, BSP_UART.h, Interrupt_Priorities.h, Print_Queue.c, Print_Queue.h, Task_Init.c, Task_Print.c, Task_VoltTempMonitor.c]
2024-06-29 Volttemp + Amperes Refactor (#603)
    * ended up rewriting all of volttemp
    * amperes refactor
    * fix build issues? add temperature/voltage range functions
    * mostly fixing tests but tests helped me find one bug !!
    * minor changes to amps trip logic
    [Amps.c, Amps.h, Automatic_Tester.c, CANMetaData.c, CANMetaData.h, LTC2315.c, RTOS_BPS.h, Task_Amperes.c]
2024-07-10 Mirror CAN traffic over UART/USB (#604)
    * basic printing and parsing functionality
    * improved print -- do raw bytes only + crc
    * revert to basic py example
    * docs & cleanup
    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
    [Automatic_Tester.c, PrintCANHelper.c, PrintCANHelper.h, Task_CANBusConsumer.c, Task_Print.c, config_msgs.c]
2024-07-10 generate ocv lut
    [README.xlsx]
2024-07-10 ema filter
2024-07-11 filtering to amps & try to fix sim tests with filtering
    [Amps.c, Amps.h, FaultState.c, Task_Amperes.c, Task_VoltTempMonitor.c, Test_Amperes_Task.c, Test_LTC2315.c, Voltage.c]
2024-07-11 add temperature reorder buf
2024-07-11 temperature sensor skip assignment for removed module
    [Temperature.c]
2024-07-16 amperes board too noisy. adjust limits to account for poor tolerances.
    [Amps.c, LTC2315.c, Task_Amperes.c, config.h]
2025-05-10 update config for 2025 battery
2025-05-13 temp printing
